i62caroi/SmartCloth/Docs/Diseno-SmartCloth/Database/Personal/servidor_(html-php)/index.html

Welcome to the home of smartcloth.site

Datos ESP32 NEW



Date Created: Fri Oct 13 14:15:12 2023
