i62caroi/SmartCloth/Docs/Diseno-SmartCloth/Database/Diseño database/SmartCloth-BD.pdf

## SmartCloth

- ALIMENTO es un par peso + TIPOALIMENTO
- PLATO es la agregación de 1 o varios ALIMENTO antes de pulsar Añadir Plato (desde Inicio o desde el anterior Añadir Plato).
- COMIDA es la agregación de 1 o varios PLATO antes de pulsar Grabar (desde Inicio o desde el anterior Grabar).
- Cada ALIMENTO pertenecerá a un TIPOALIMENTO
- Cada TIPOALIMENTO tendrá unos VALORESNUTRICIONALES
- Cada TIPOALIMENTO podrá ser: un GRUPOALIMENTO o BARCODE
- Cada USUARIO tiene un MANTEL durante un periodo de tiempo y un MANTEL solo es de un USUARIO durante un periodo de tiempo.
- Los USUARIO pueden tener MEDICION en fecha y hora que podrá ser INSULINA o INDICEGLUCÉMICO.
