i62caroi/SmartCloth/Docs/Diseno-SmartCloth/Diagramas software/Diagrama sincronizacion inicial de data/due-esp32-1_Upload_JSON_per_meal.jpg

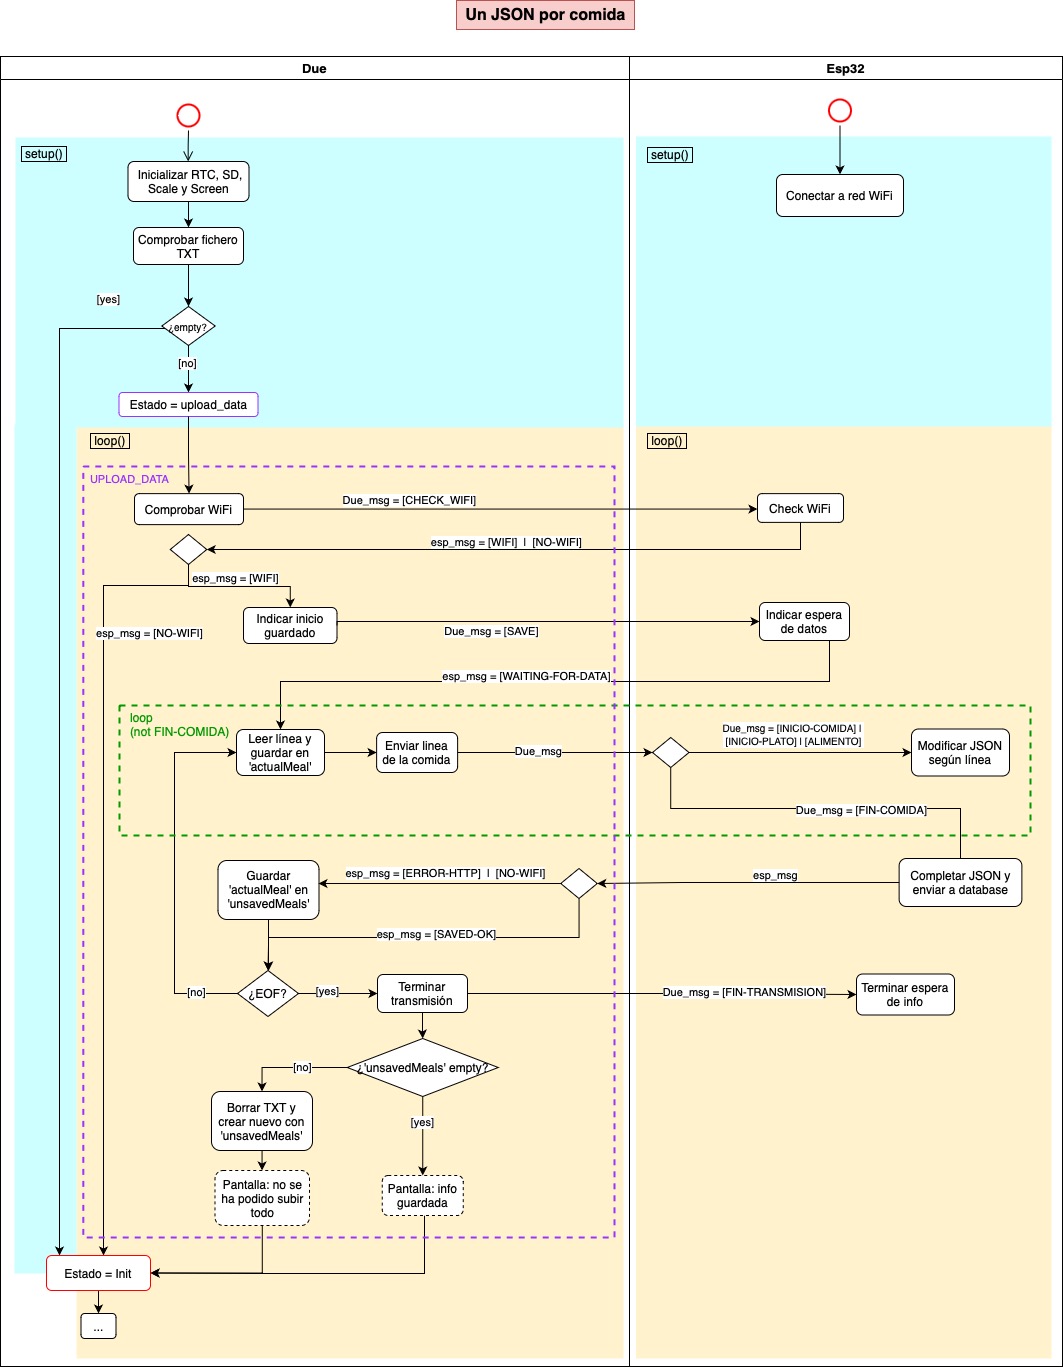
Docs/Diseno-SmartCloth/Diagramas software/Diagrama sincronizacion inicial de data/due-esp32-1_Upload_JSON_per_meal.jpg
