i62caroi/SmartCloth/Docs/Diseno-SmartCloth/Diagramas software/Diagrama sincronizacion inicial de data/due-esp32-Upload_All_in_one_JSON.jpg

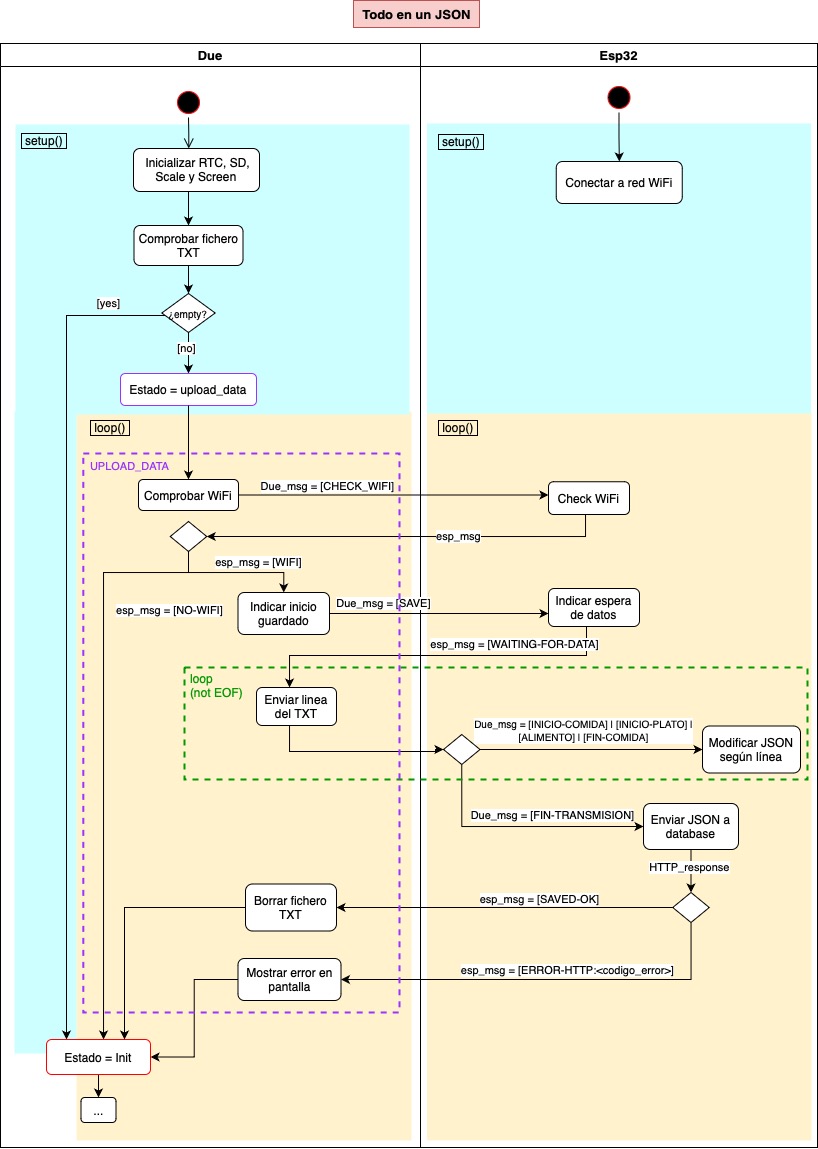
Docs/Diseno-SmartCloth/Diagramas software/Diagrama sincronizacion inicial de data/due-esp32-Upload_All_in_one_JSON.jpg
