i62caroi/SmartCloth/Docs/Diseno-SmartCloth/Diagramas software/UML/Casos-de-Uso.jpg

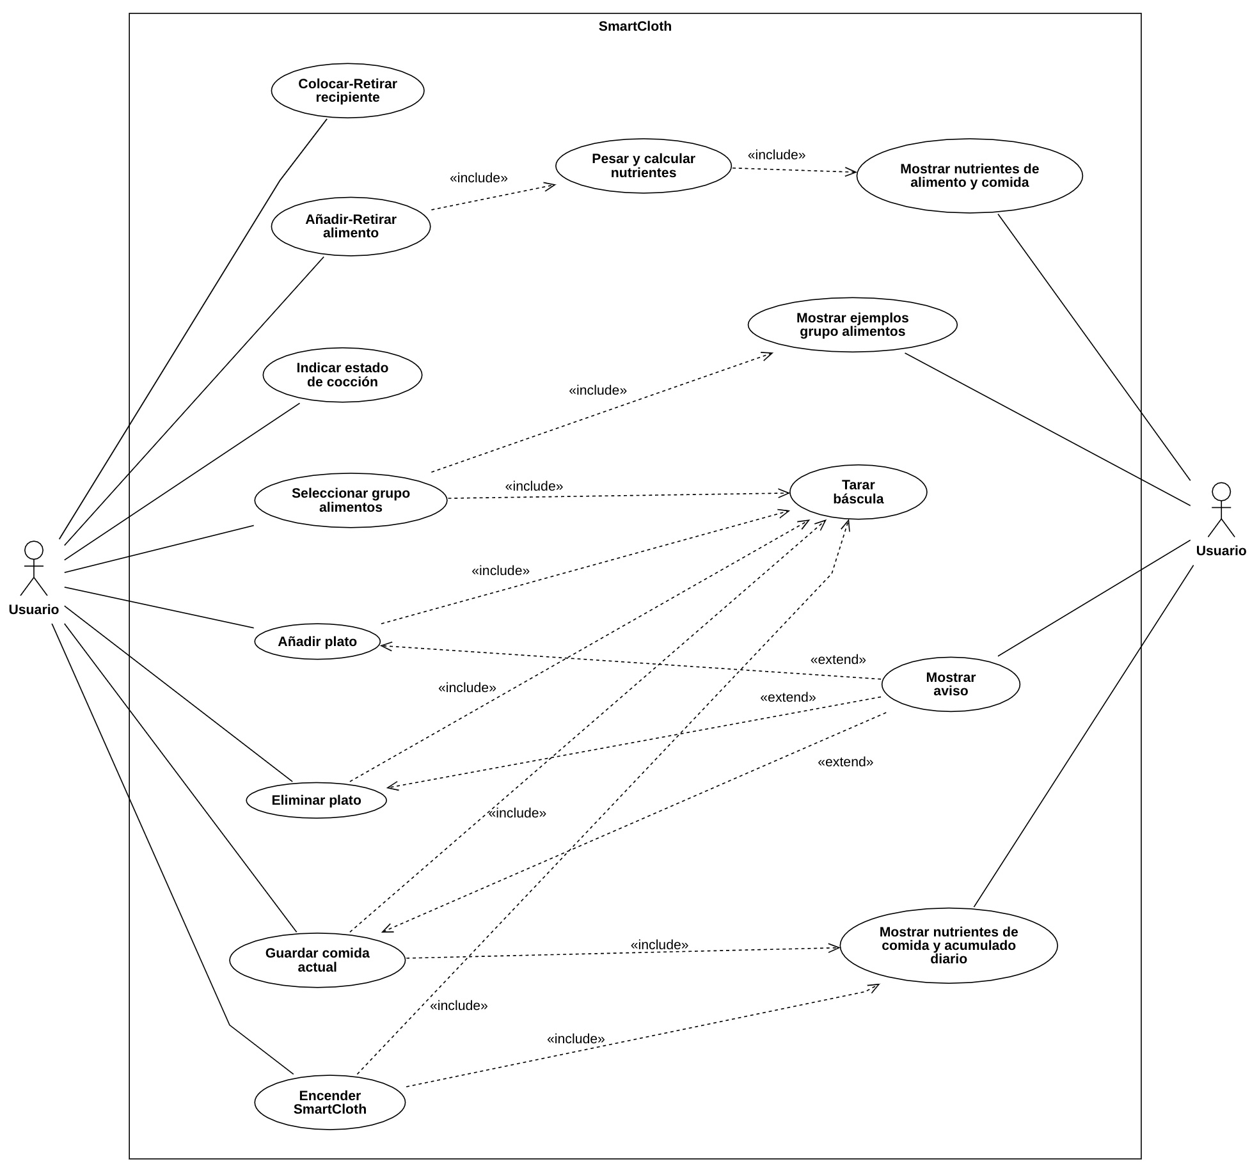
Docs/Diseno-SmartCloth/Diagramas software/UML/Casos-de-Uso.jpg
