i62caroi/SmartCloth/Docs/Diseno-SmartCloth/Diagramas software/UML/Diagrama-Actividades.jpg

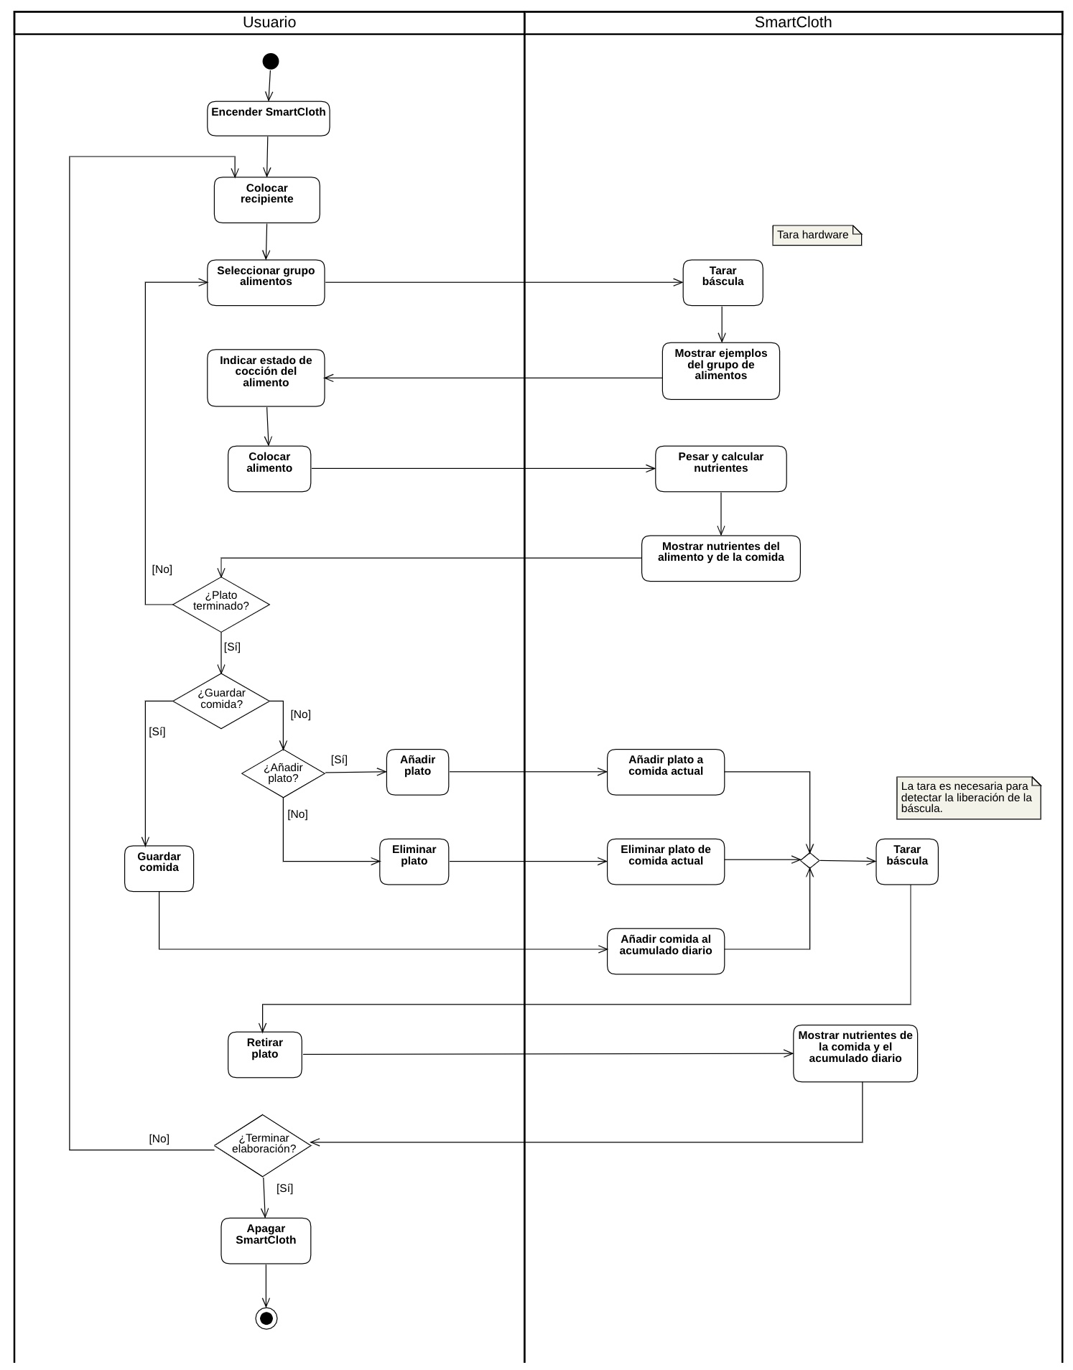
Docs/Diseno-SmartCloth/Diagramas software/UML/Diagrama-Actividades.jpg
