i62caroi/SmartCloth/Docs/Diseno-SmartCloth/Diagramas software/UML/Diagrama-Clases.jpg

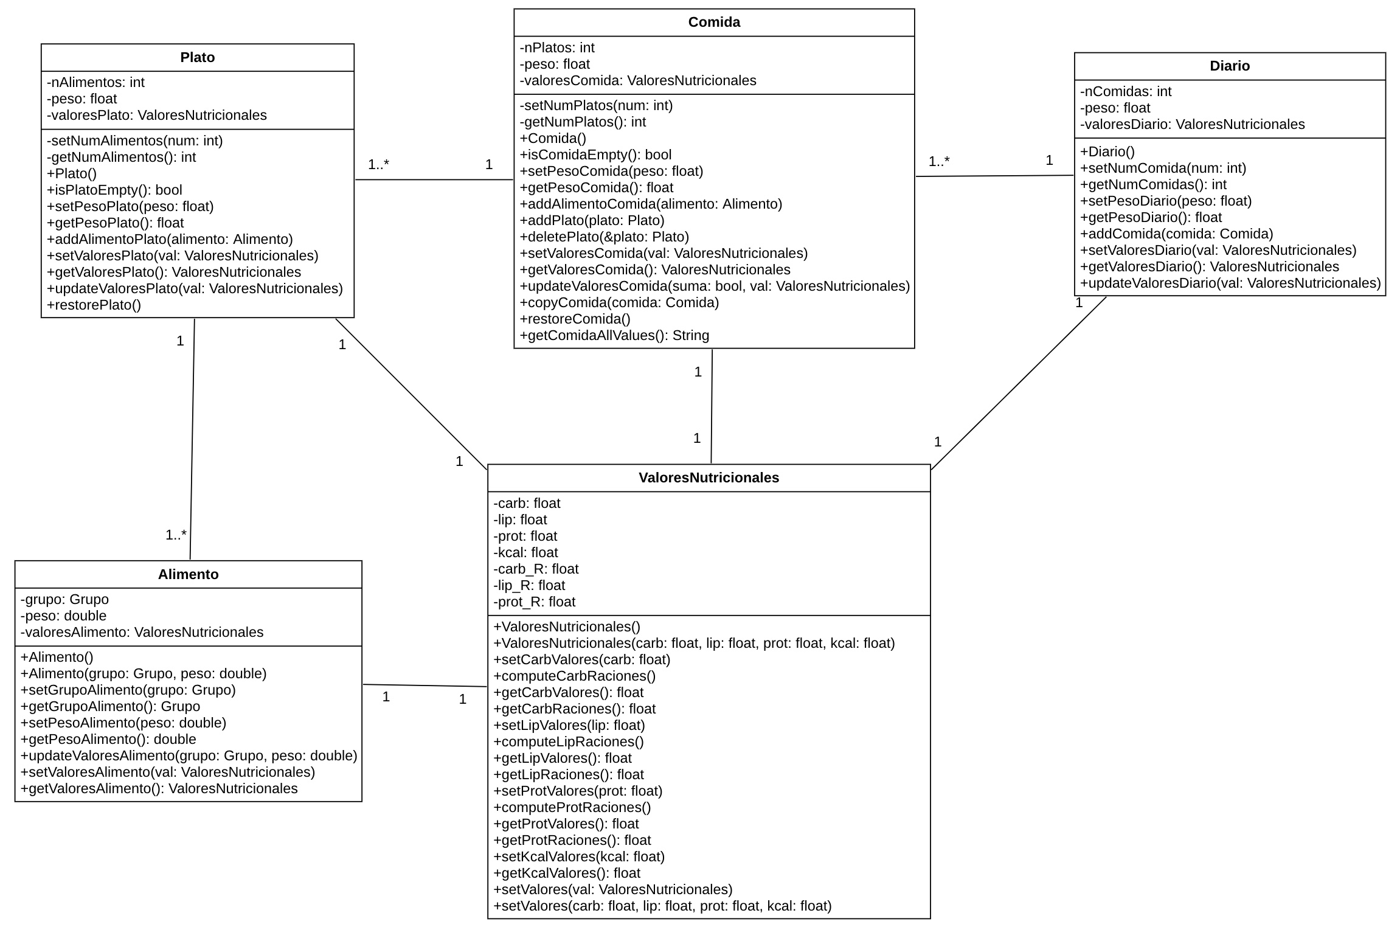
Docs/Diseno-SmartCloth/Diagramas software/UML/Diagrama-Clases.jpg
