i62caroi/SmartCloth/Docs/Diseno-SmartCloth/Diagramas software/UML/Diagrama-Flujo-SmartCloth.jpg

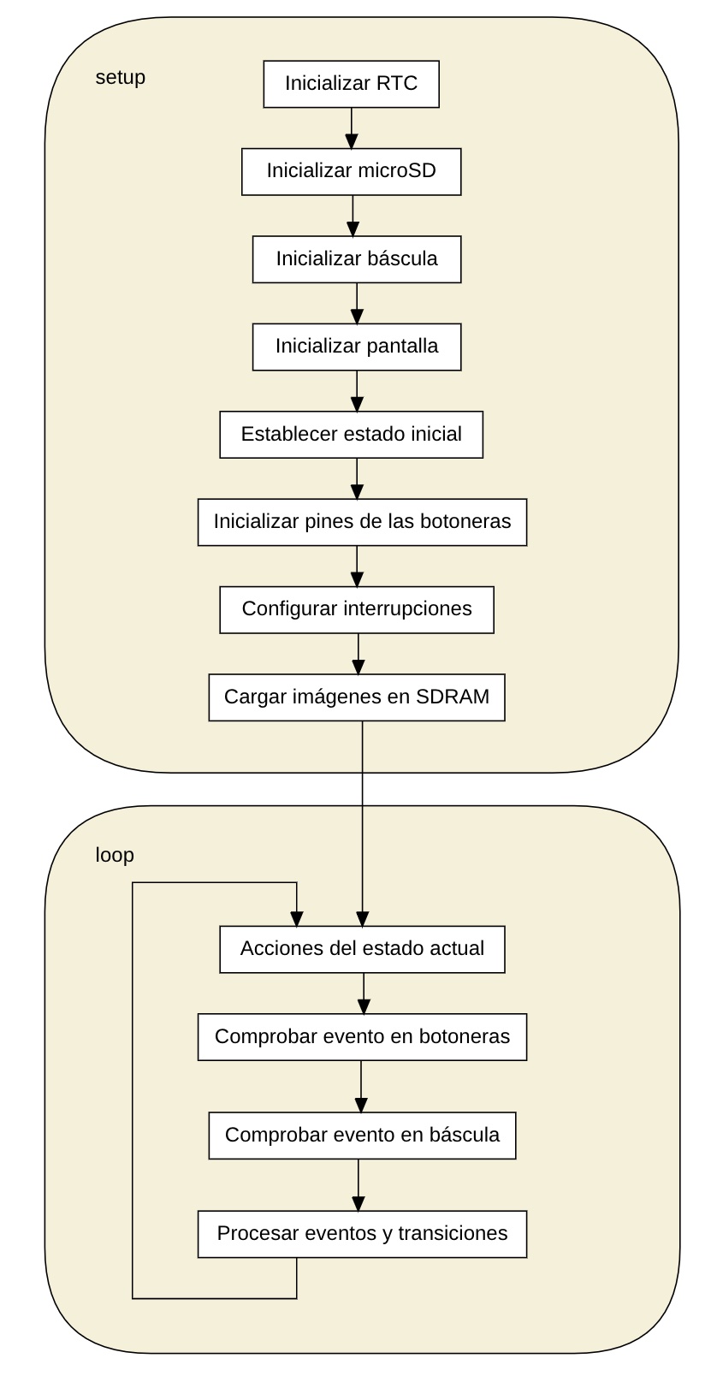
Docs/Diseno-SmartCloth/Diagramas software/UML/Diagrama-Flujo-SmartCloth.jpg
