i62caroi/SmartCloth/Docs/Diseno-SmartCloth/Diagramas software/UML/Máquina de Estados/Diagrama 1.jpg

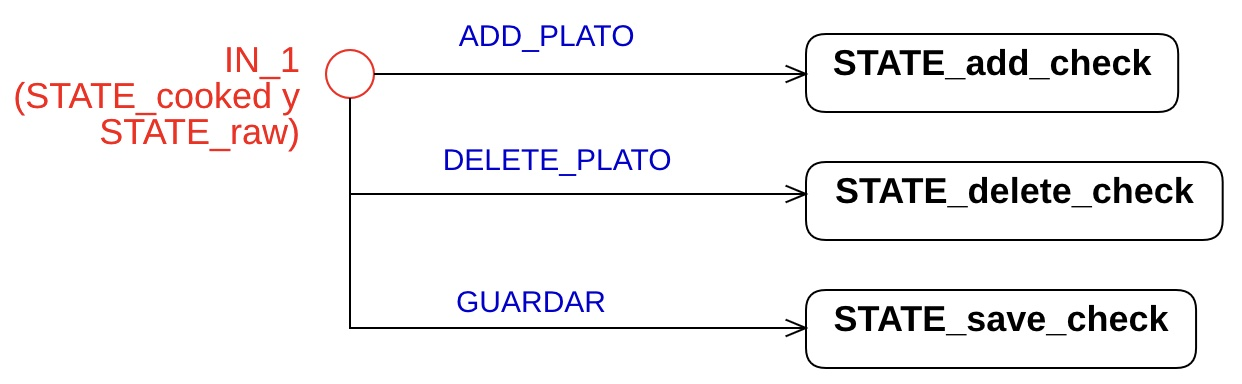
Docs/Diseno-SmartCloth/Diagramas software/UML/Máquina de Estados/Diagrama 1.jpg
