i62caroi/SmartCloth/Docs/Diseno-SmartCloth/Hardware/Diagrama_de_comunicaciones_v2.png

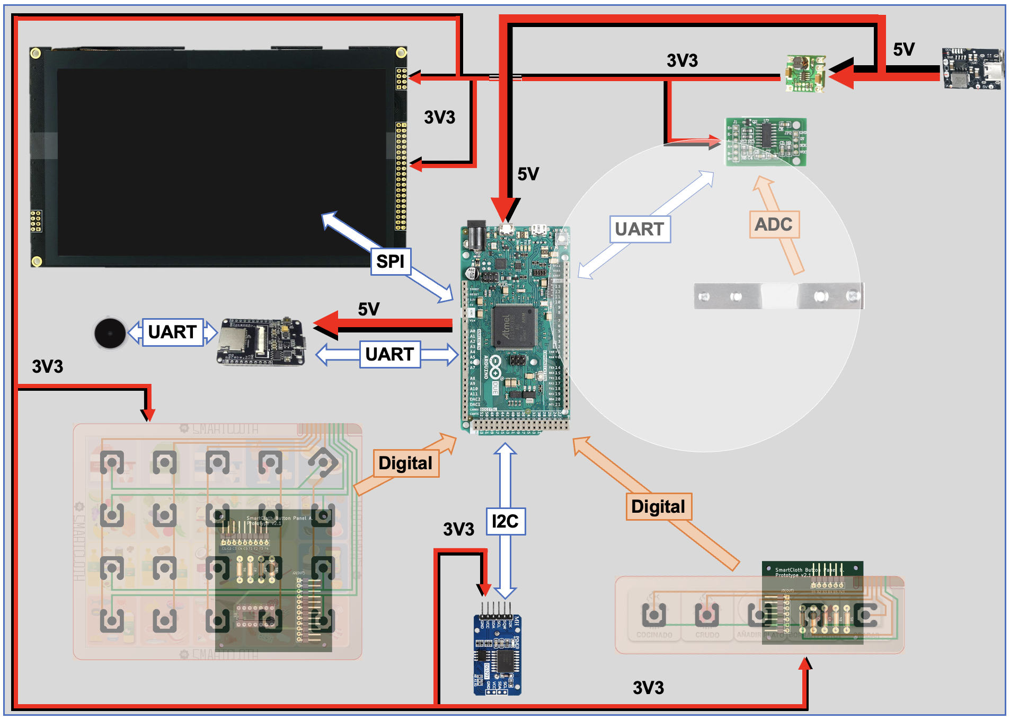
Docs/Diseno-SmartCloth/Hardware/Diagrama_de_comunicaciones_v2.png
