i62caroi/SmartCloth/Docs/Diseno-SmartCloth/Interfaz/Dashboards/Dashboard1.png

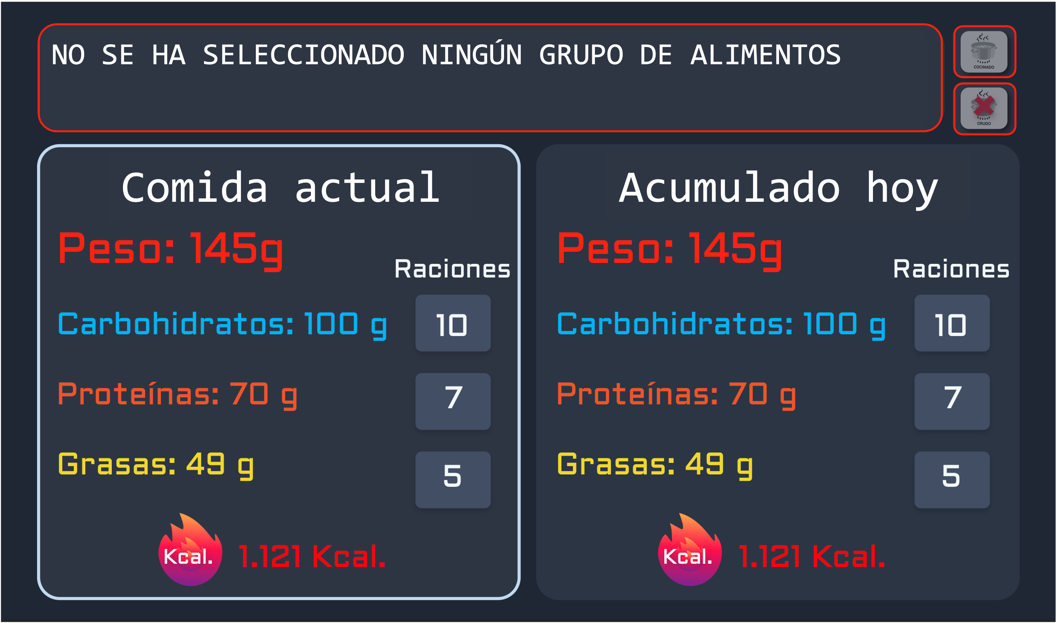
Docs/Diseno-SmartCloth/Interfaz/Dashboards/Dashboard1.png
