i62caroi/SmartCloth/Docs/Diseno-SmartCloth/Interfaz/Dashboards/Zonas(2).png

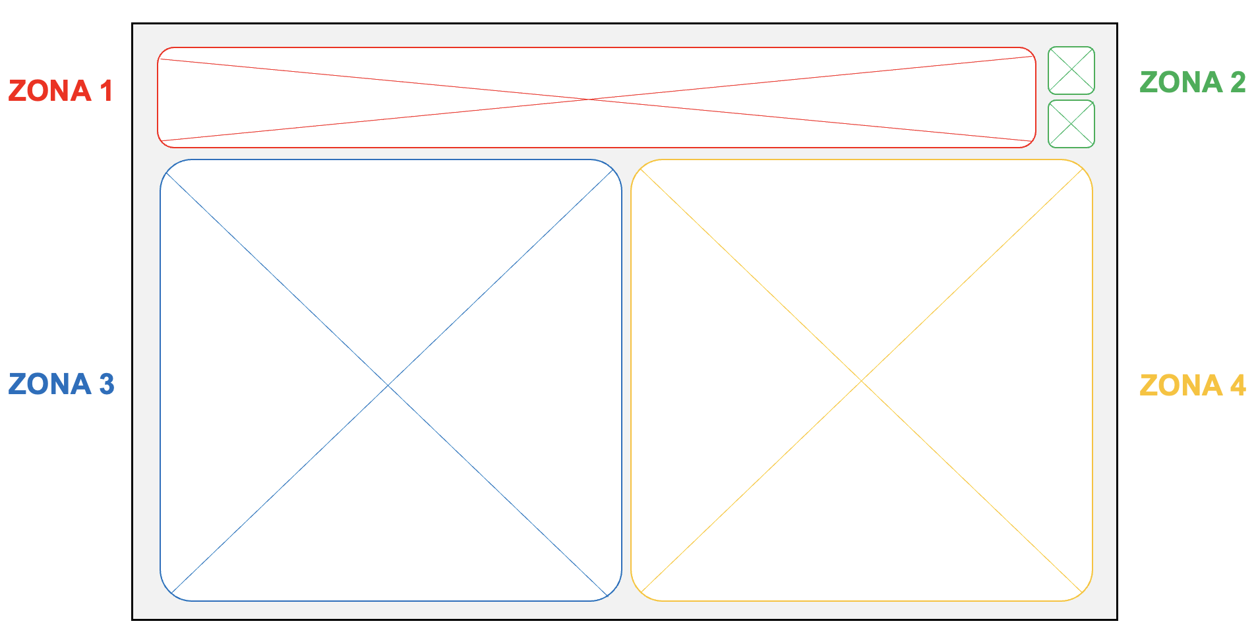
Docs/Diseno-SmartCloth/Interfaz/Dashboards/Zonas(2).png
