i62caroi/SmartCloth/Docs/Diseno-SmartCloth/Interfaz/Pantallas-auxiliares/accion-cancelada.jpg

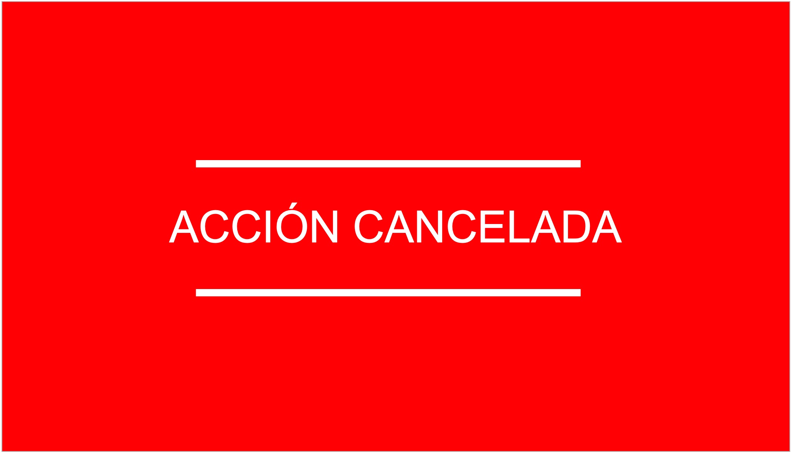
Docs/Diseno-SmartCloth/Interfaz/Pantallas-auxiliares/accion-cancelada.jpg
