i62caroi/SmartCloth/Docs/Diseno-SmartCloth/Interfaz/Pantallas-auxiliares/arranque.jpg

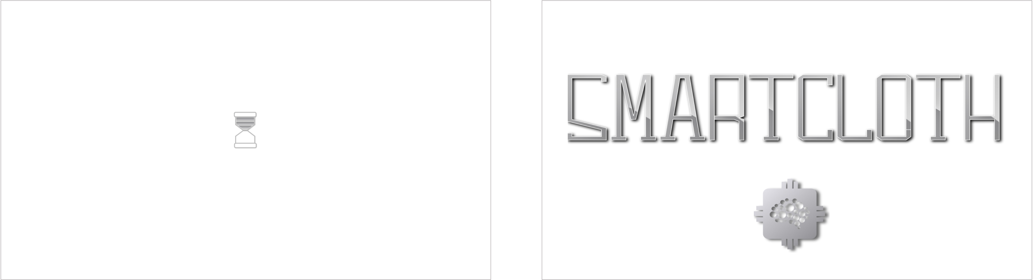
Docs/Diseno-SmartCloth/Interfaz/Pantallas-auxiliares/arranque.jpg
