i62caroi/SmartCloth/Docs/Diseno-SmartCloth/Interfaz/Pantallas-auxiliares/aviso-comida-vacia.jpg

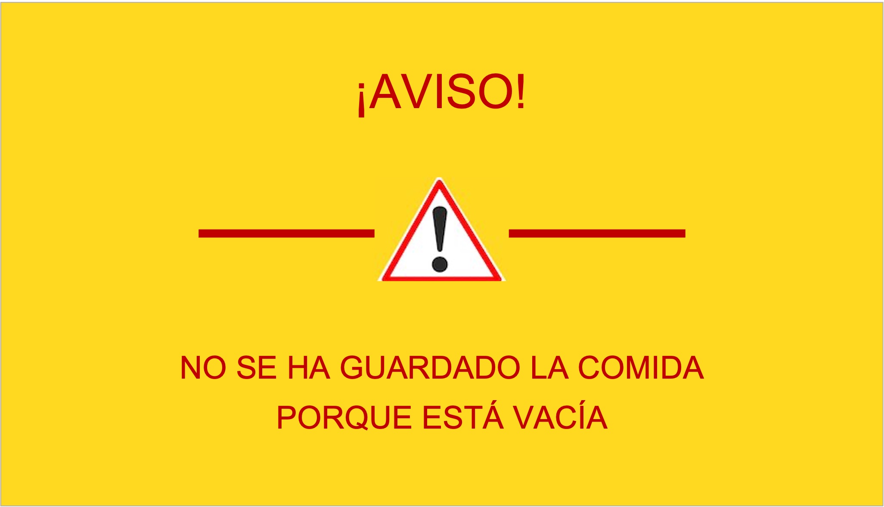
Docs/Diseno-SmartCloth/Interfaz/Pantallas-auxiliares/aviso-comida-vacia.jpg
