i62caroi/SmartCloth/Docs/Diseno-SmartCloth/Interfaz/Pantallas-auxiliares/comida-guardada-retire-plato.jpg

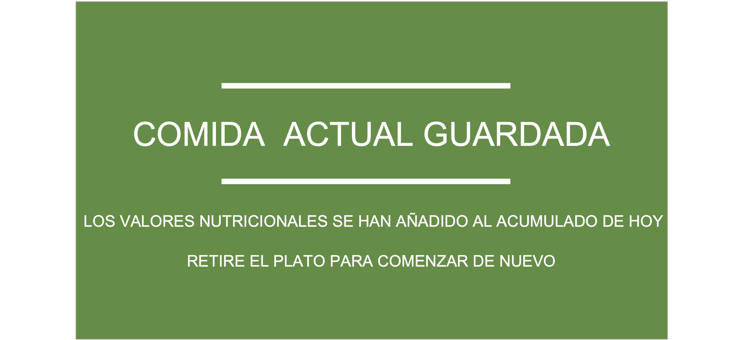
Docs/Diseno-SmartCloth/Interfaz/Pantallas-auxiliares/comida-guardada-retire-plato.jpg
