i62caroi/SmartCloth/Docs/Diseno-SmartCloth/Interfaz/Pantallas-auxiliares/comida-guardada.jpg

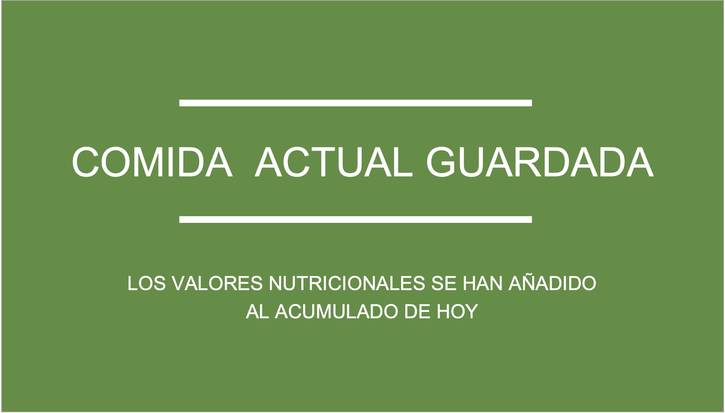
Docs/Diseno-SmartCloth/Interfaz/Pantallas-auxiliares/comida-guardada.jpg
