i62caroi/SmartCloth/Docs/Diseno-SmartCloth/Interfaz/Pantallas-auxiliares/confirmacion-anadir.jpg

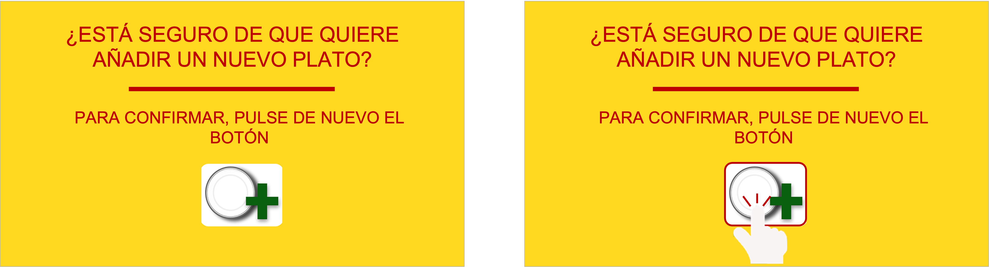
Docs/Diseno-SmartCloth/Interfaz/Pantallas-auxiliares/confirmacion-anadir.jpg
