i62caroi/SmartCloth/Docs/Diseno-SmartCloth/Interfaz/Pantallas-auxiliares/confirmacion-guardar.jpg

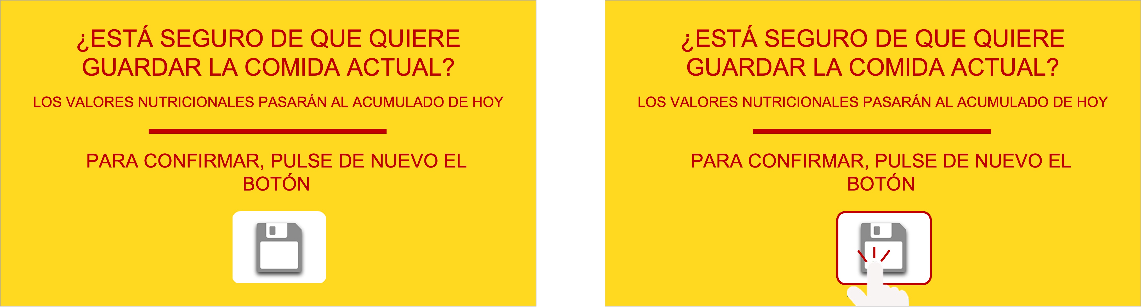
Docs/Diseno-SmartCloth/Interfaz/Pantallas-auxiliares/confirmacion-guardar.jpg
