i62caroi/SmartCloth/Docs/Diseno-SmartCloth/Interfaz/Pantallas-auxiliares/crudo-cocinado-sobre-dashboard.png

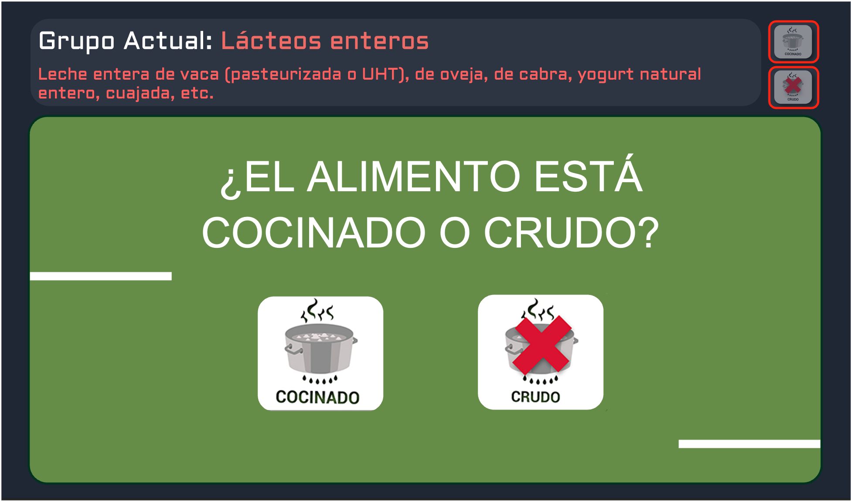
Docs/Diseno-SmartCloth/Interfaz/Pantallas-auxiliares/crudo-cocinado-sobre-dashboard.png
