i62caroi/SmartCloth/Docs/Diseno-SmartCloth/Interfaz/Pantallas-auxiliares/error-escoja-grupo.jpg

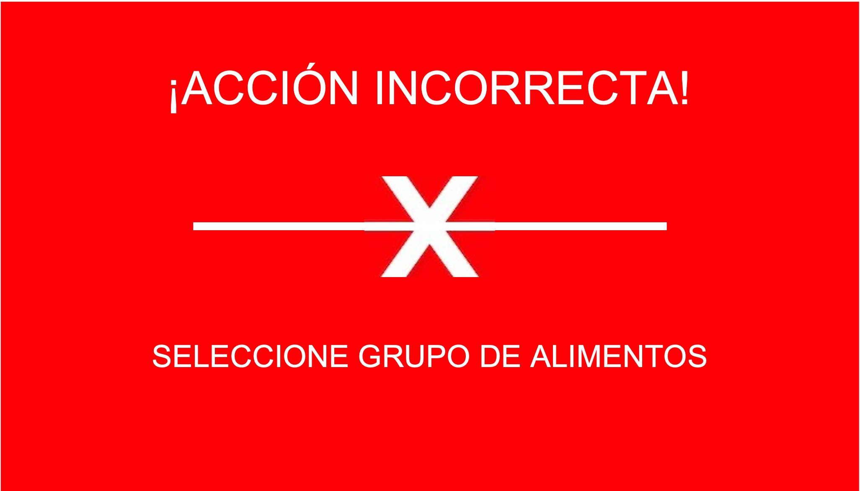
Docs/Diseno-SmartCloth/Interfaz/Pantallas-auxiliares/error-escoja-grupo.jpg
