i62caroi/SmartCloth/Docs/Diseno-SmartCloth/Interfaz/Pantallas-auxiliares/pedir-alimento.jpg

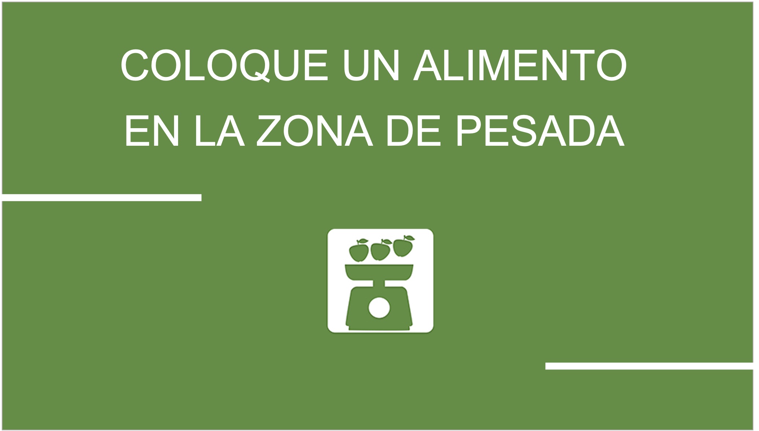
Docs/Diseno-SmartCloth/Interfaz/Pantallas-auxiliares/pedir-alimento.jpg
