i62caroi/SmartCloth/Docs/Diseno-SmartCloth/Interfaz/Pantallas-auxiliares/pedir-crudo-cocinado.jpg

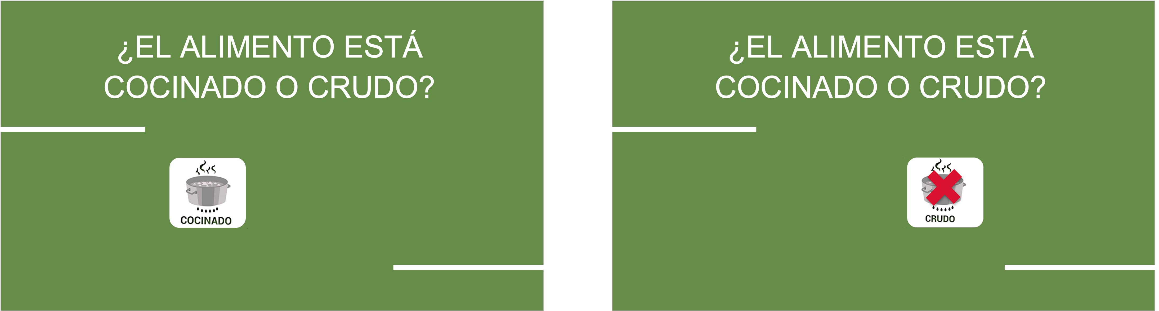
Docs/Diseno-SmartCloth/Interfaz/Pantallas-auxiliares/pedir-crudo-cocinado.jpg
