i62caroi/SmartCloth/Docs/Diseno-SmartCloth/Interfaz/Pantallas-auxiliares/pedir-grupo.jpg

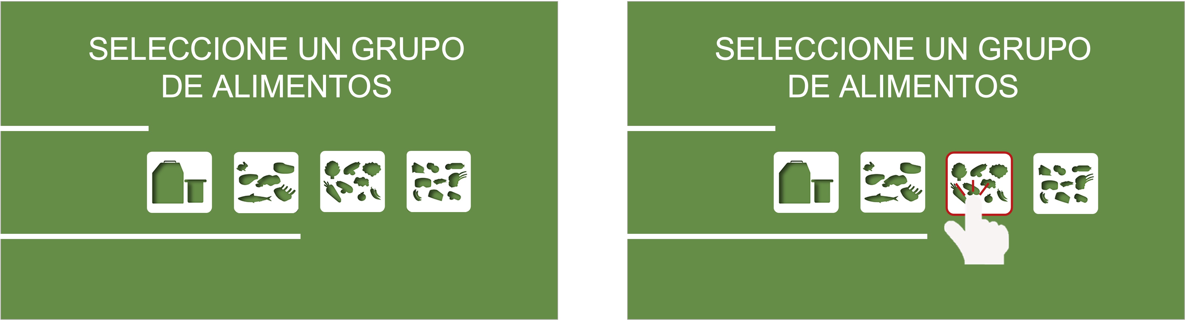
Docs/Diseno-SmartCloth/Interfaz/Pantallas-auxiliares/pedir-grupo.jpg
