i62caroi/SmartCloth/Docs/Diseno-SmartCloth/Interfaz/Pantallas-auxiliares/pedir-recipiente.jpg

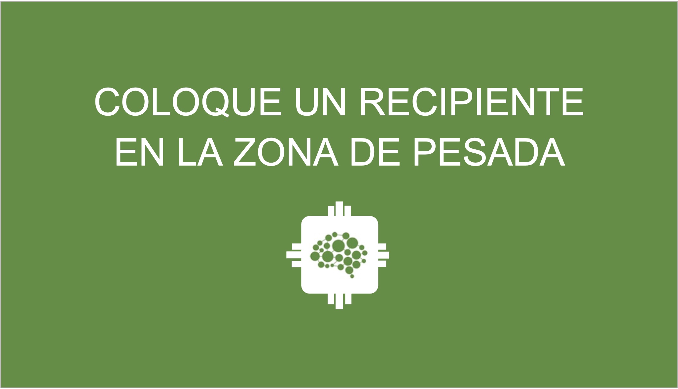
Docs/Diseno-SmartCloth/Interfaz/Pantallas-auxiliares/pedir-recipiente.jpg
