i62caroi/SmartCloth/Docs/Diseno-SmartCloth/Interfaz/Pantallas-auxiliares/plato-anadido.jpg

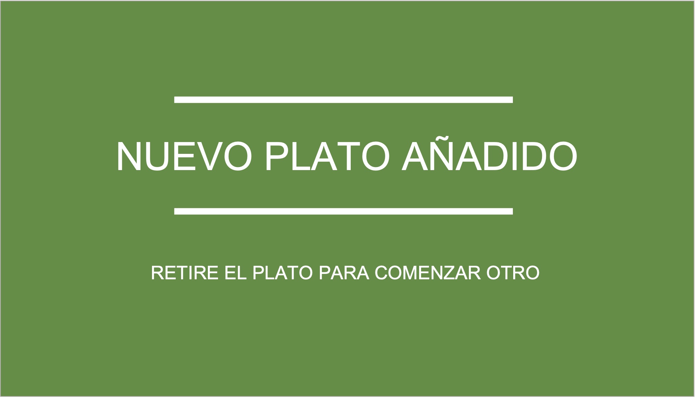
Docs/Diseno-SmartCloth/Interfaz/Pantallas-auxiliares/plato-anadido.jpg
