i62caroi/SmartCloth/Docs/Diseno-SmartCloth/Interfaz/Pantallas-auxiliares/plato-eliminado.jpg

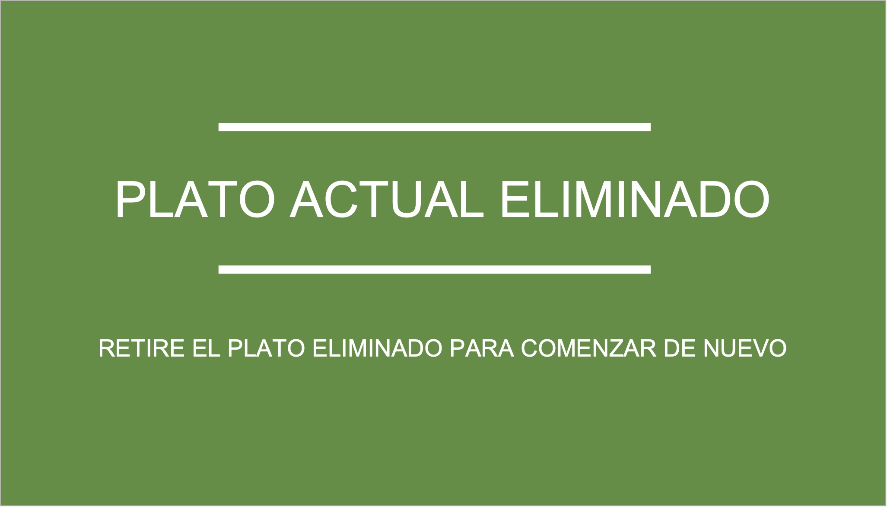
Docs/Diseno-SmartCloth/Interfaz/Pantallas-auxiliares/plato-eliminado.jpg
