i62caroi/SmartCloth/Docs/Diseno-SmartCloth/Interfaz/Pantallas-auxiliares/recipiente-colocado-retirado.jpg

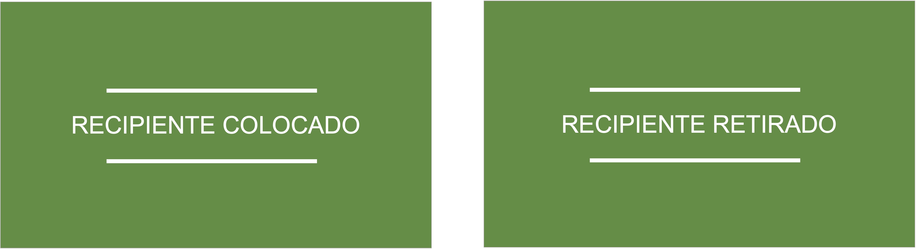
Docs/Diseno-SmartCloth/Interfaz/Pantallas-auxiliares/recipiente-colocado-retirado.jpg
