i62caroi/SmartCloth/Docs/Diseno-SmartCloth/Interfaz/Pantallas-auxiliares/sugerencias-accion.jpg

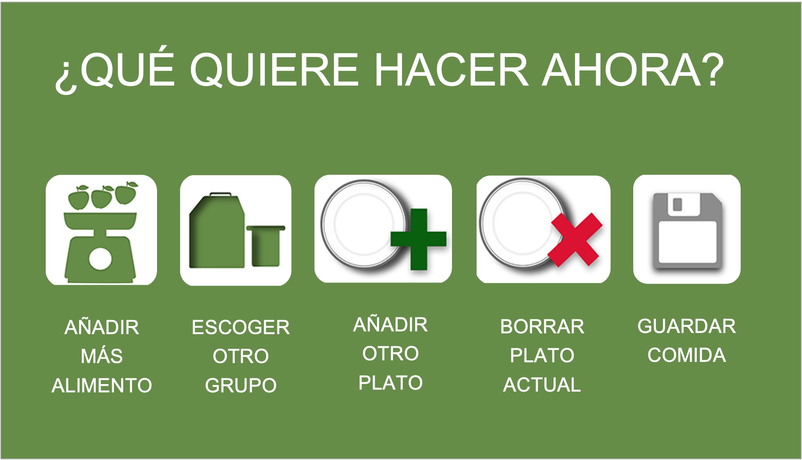
Docs/Diseno-SmartCloth/Interfaz/Pantallas-auxiliares/sugerencias-accion.jpg
