i62caroi/SmartCloth/Docs/Fallos/Comunicacion-Due-ESP32 (Resuelto)/mensaje-perdido.png

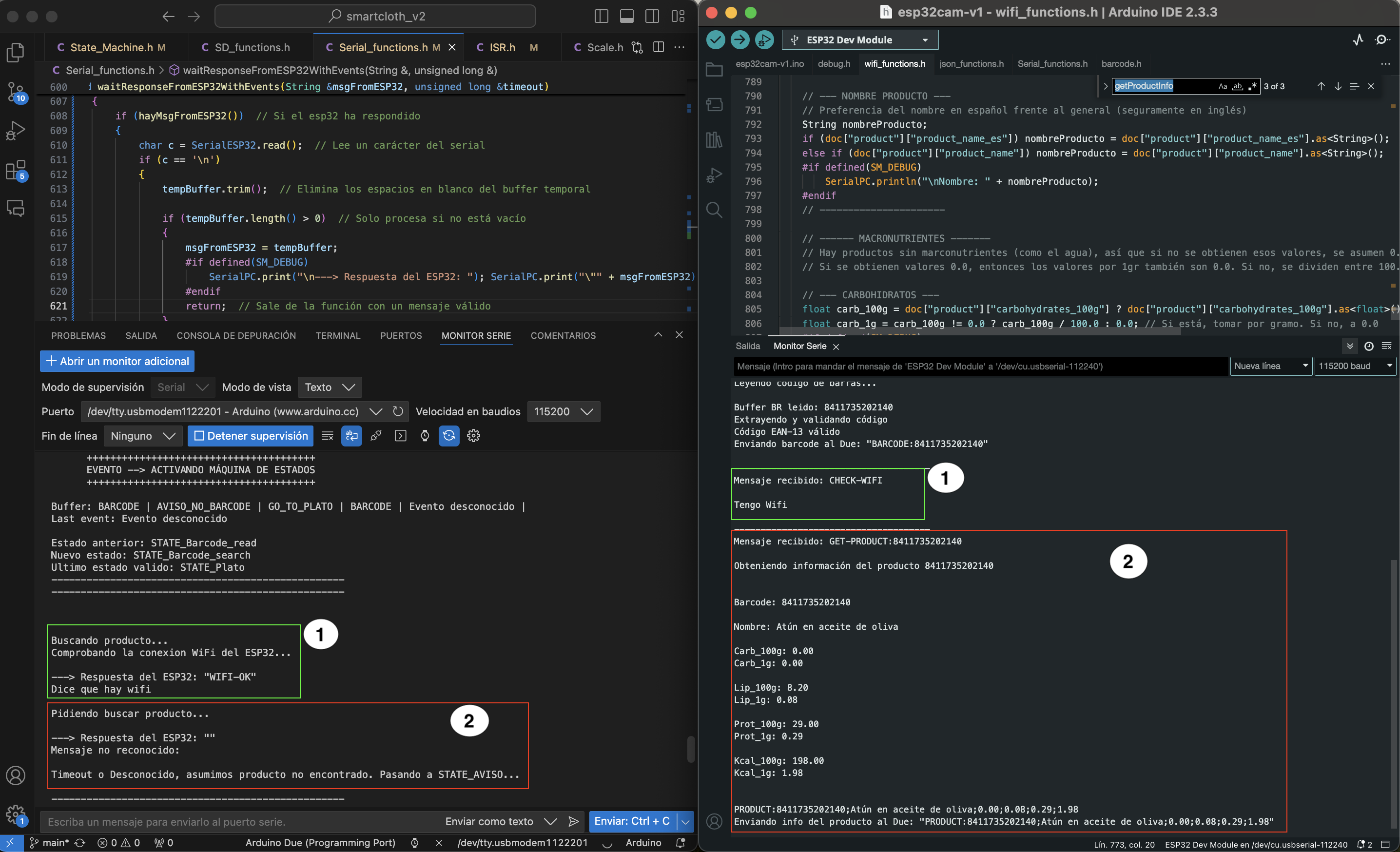
Docs/Fallos/Comunicacion-Due-ESP32 (Resuelto)/mensaje-perdido.png
