i62caroi/SmartCloth/Docs/Fallos/Comunicacion-Due-ESP32 (Resuelto)/mensaje-recibido.png

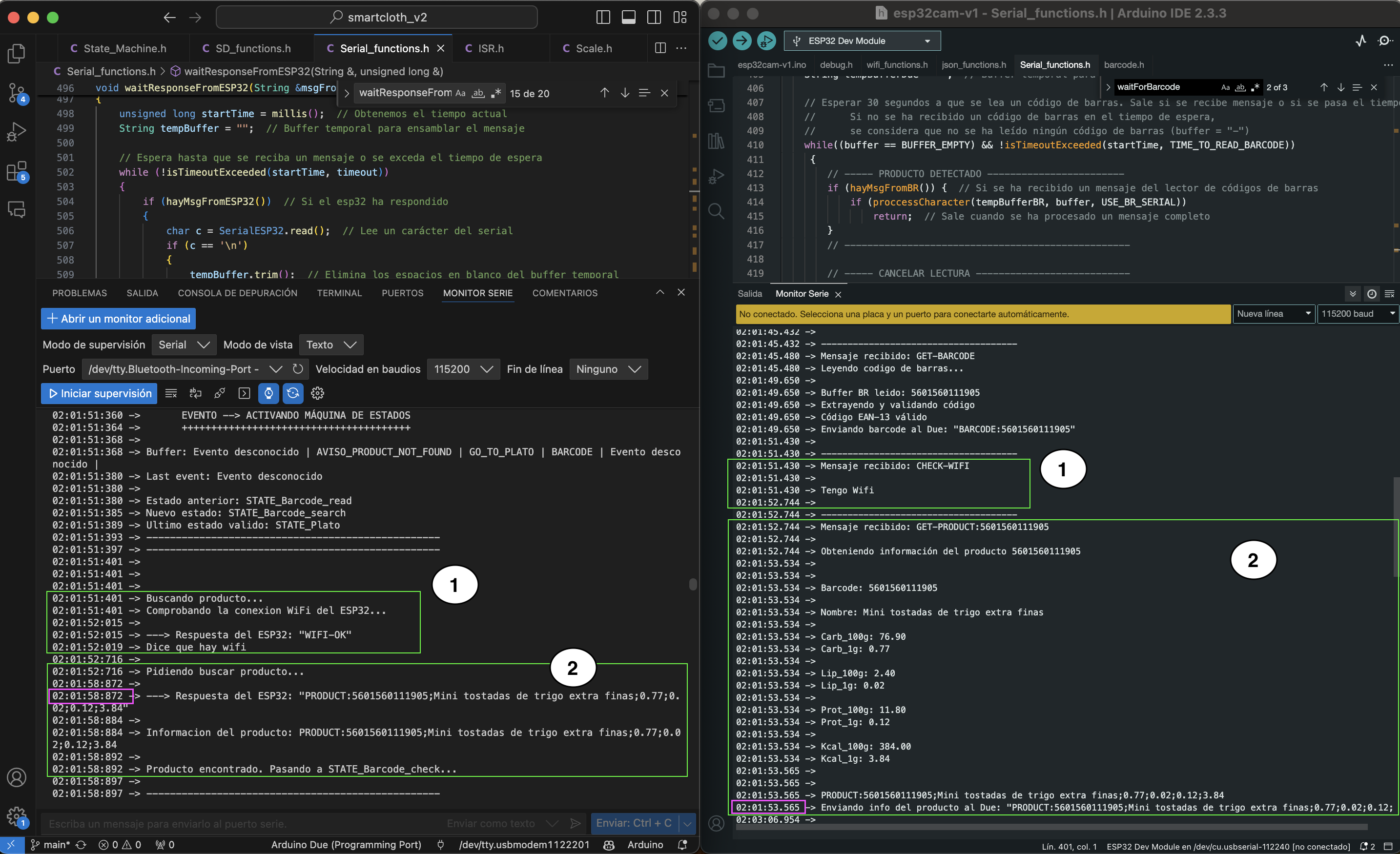
Docs/Fallos/Comunicacion-Due-ESP32 (Resuelto)/mensaje-recibido.png
