i62caroi/SmartCloth/examples/DATABASE/send_JSON_via_API (inicial)/campos-tablas-database.png

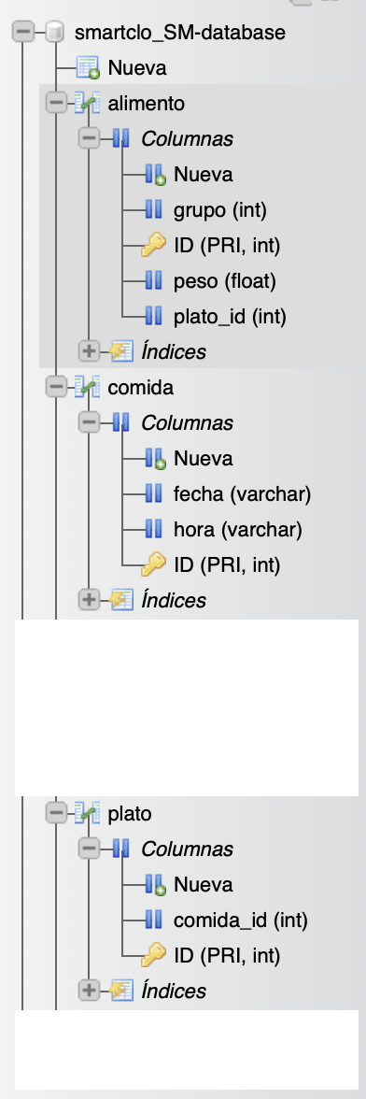
examples/DATABASE/send_JSON_via_API (inicial)/campos-tablas-database.png
