i62caroi/SmartCloth/examples/ESP32 CAM/STREAMING SERVER AND PYTHON ACCESS/frame-autofocus.jpg

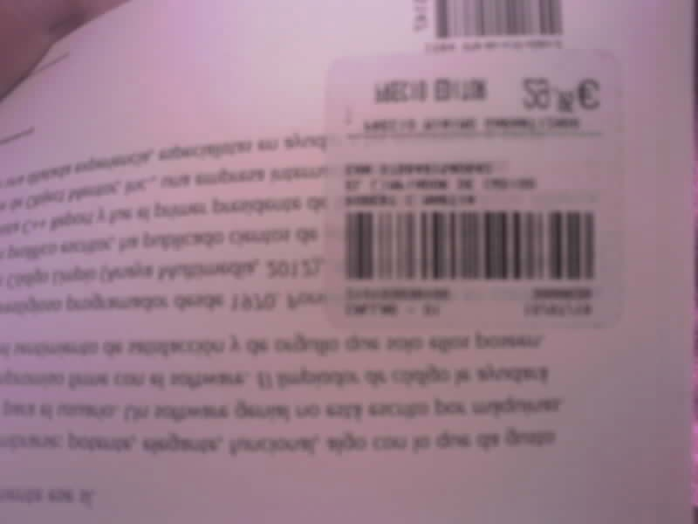
examples/ESP32 CAM/STREAMING SERVER AND PYTHON ACCESS/frame-autofocus.jpg
