i62caroi/SmartCloth/examples/ESP32 CAM/STREAMING SERVER AND PYTHON ACCESS/frame.jpg

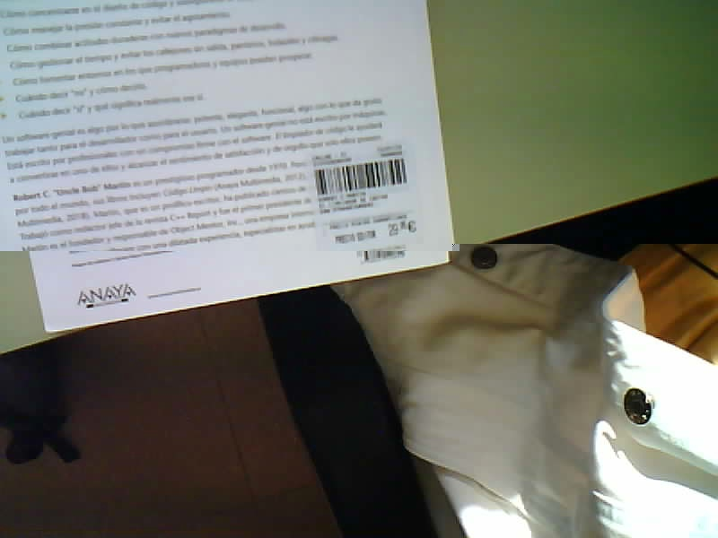
examples/ESP32 CAM/STREAMING SERVER AND PYTHON ACCESS/frame.jpg
