i62caroi/SmartCloth/examples/SCREEN/RA8876_v2_opacity/Captura de Pantalla 2023-06-09 a las 10.19.07.png

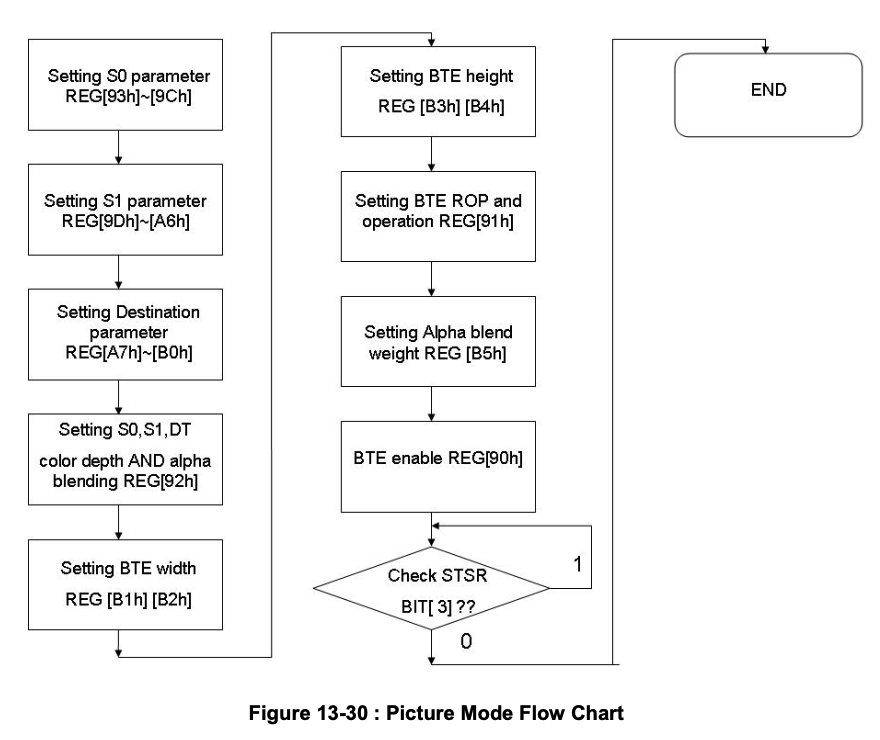
examples/SCREEN/RA8876_v2_opacity/Captura de Pantalla 2023-06-09 a las 10.19.07.png
