i62caroi/SmartCloth/images/jpg/alimento/scale.jpg

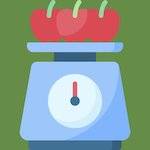
images/jpg/alimento/scale.jpg
