i62caroi/SmartCloth/images/jpg/alimento/scale_g.jpg

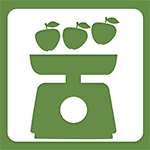
images/jpg/alimento/scale_g.jpg
