i62caroi/SmartCloth/images/jpg/arranque/Log.jpg

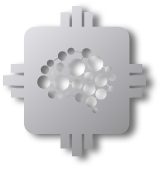
images/jpg/arranque/Log.jpg
