i62caroi/SmartCloth/images/jpg/aviso/aviso.jpg

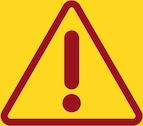
images/jpg/aviso/aviso.jpg
