i62caroi/SmartCloth/images/jpg/barcode/scan.jpg

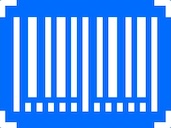
images/jpg/barcode/scan.jpg
