i62caroi/SmartCloth/images/jpg/botones/anadir.jpg

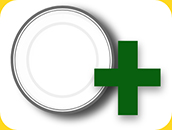
images/jpg/botones/anadir.jpg
