i62caroi/SmartCloth/images/jpg/botones/borrar.jpg

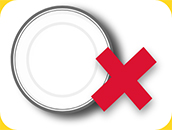
images/jpg/botones/borrar.jpg
