i62caroi/SmartCloth/images/jpg/botones/coci_gra.jpg

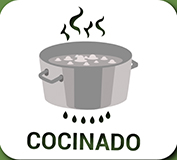
images/jpg/botones/coci_gra.jpg
