i62caroi/SmartCloth/images/jpg/botones/crudo_gra.jpg

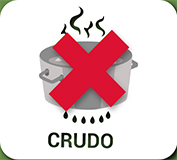
images/jpg/botones/crudo_gra.jpg
