i62caroi/SmartCloth/images/jpg/botones/guardar.jpg

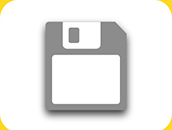
images/jpg/botones/guardar.jpg
