i62caroi/SmartCloth/images/jpg/grupo/grupo1.jpg

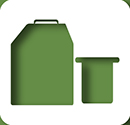
images/jpg/grupo/grupo1.jpg
