i62caroi/SmartCloth/images/jpg/grupo/grupo2.jpg

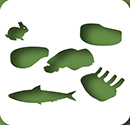
images/jpg/grupo/grupo2.jpg
