i62caroi/SmartCloth/images/jpg/grupo/grupo3.jpg

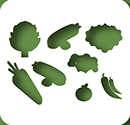
images/jpg/grupo/grupo3.jpg
