i62caroi/SmartCloth/images/jpg/grupo/grupo4.jpg

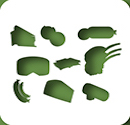
images/jpg/grupo/grupo4.jpg
