i62caroi/SmartCloth/images/jpg/manos/manoGppt.jpg

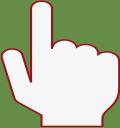
images/jpg/manos/manoGppt.jpg
