i62caroi/SmartCloth/images/jpg/manos/manoWppt.jpg

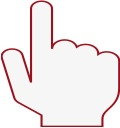
images/jpg/manos/manoWppt.jpg
