i62caroi/SmartCloth/images/jpg/sync/sync.jpg

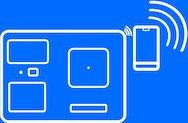
images/jpg/sync/sync.jpg
