i62caroi/SmartCloth/images/jpg/sync/sync_ok.jpg

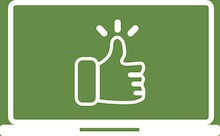
images/jpg/sync/sync_ok.jpg
