i62caroi/SmartCloth/Docs/Diseño-SmartCloth/SmartCloth assembly document V0.2.pdf

# DOCUMENTO DE MONTAJE

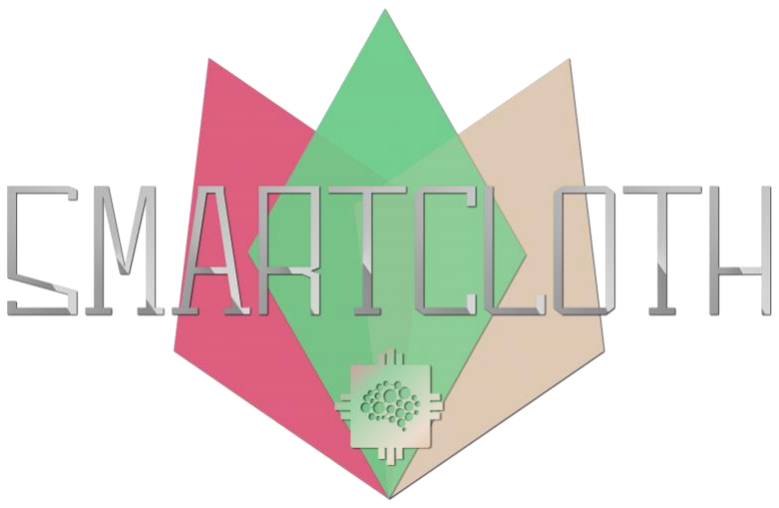
[picture p67: figure]

COMPONENTES PRINCIPALES

Pantalla ER-TFM070-6 | Batería
Tarjeta SD | Interruptor basculante
Arduino Due | Módulo Step-Down
Screw Shield | Botonera A (grupos de alimentos)
RTC | Botonera B (acciones)
Celda de carga | Placas de adaptación de botoneras
Conversor AC/DC HX711 | ESP32-CAM
Módulo USB cargador de batería | Botón código de barras

COMPONENTES AUXILIARES

Cable USB-microUSB | 4 fichas de 5 cables
4 pegatinas con bridas | 5 fichas de 3 cables

## 1. Alimentación:

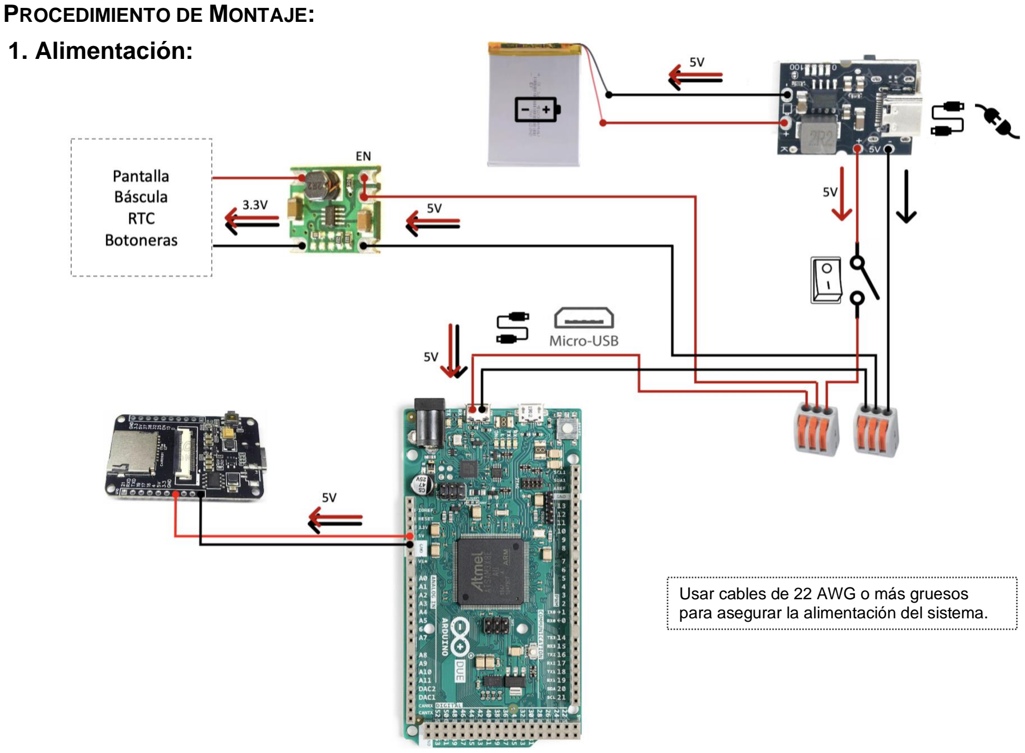
[picture p68: page 3]

PROCEDIMIENTO DE MONTAJE:

Usar cables de 22 AWG o más gruesos para asegurar la alimentación del sistema.

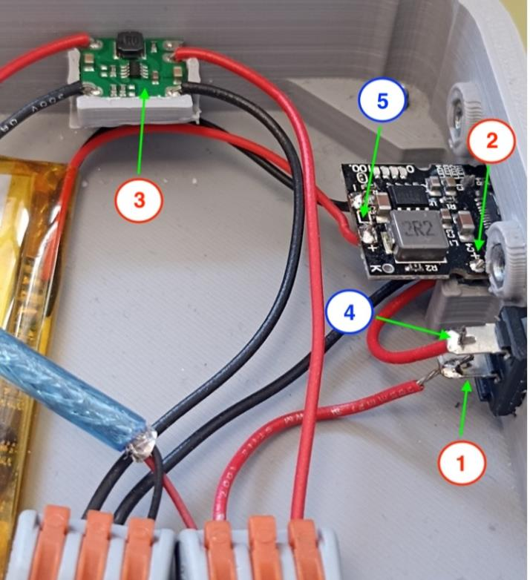
[picture p69: figure]
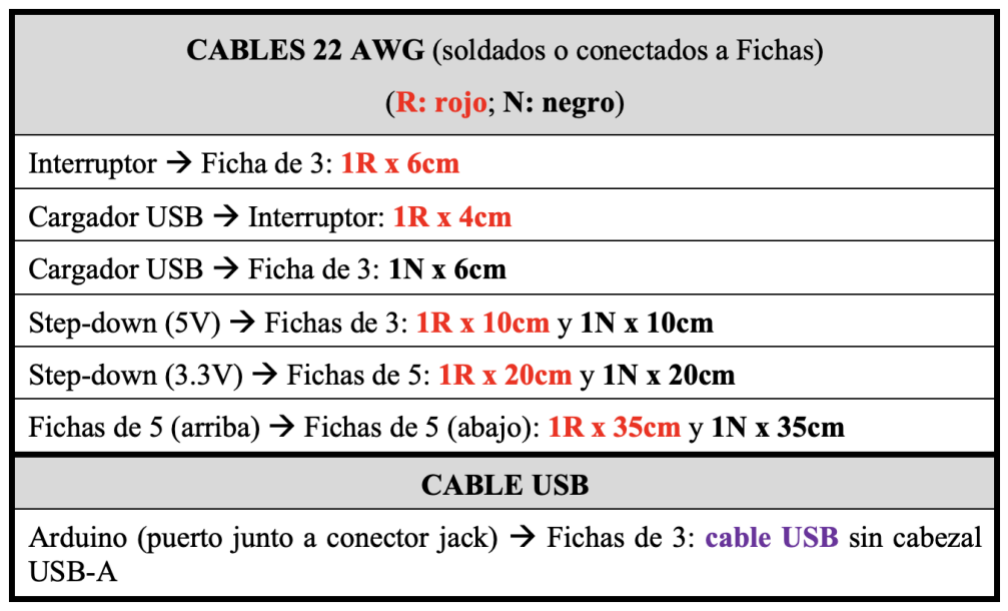
[picture p70: figure]

- Soldar antes de montar:
(1) Cable R del interruptor a la ficha de 3, en el borne del | para que
el O quede arriba y sea más fácil soldar después.
(2) Cables R y N del cargador USB (donde pone 5V) al interruptor
(R) y a la ficha de 3 (N), pero solo soldar el extremo del cargador USB para poderlo colocar desde fuera de la carcasa.
(3) Regulador step-down completo (R-N en entrada de 5V y en salida de 3.3V). Soldar EN con Vi+ en la entrada.
- Soldar después de montar:
(4) Cable R del cargador USB al interruptor, el extremo que va al borne con O del interruptor.
(5) Cables R y N de la batería en el cargador USB (donde el símbolo de batería).

## 2. Conexiones:

## 2.1 Shield de tornillos

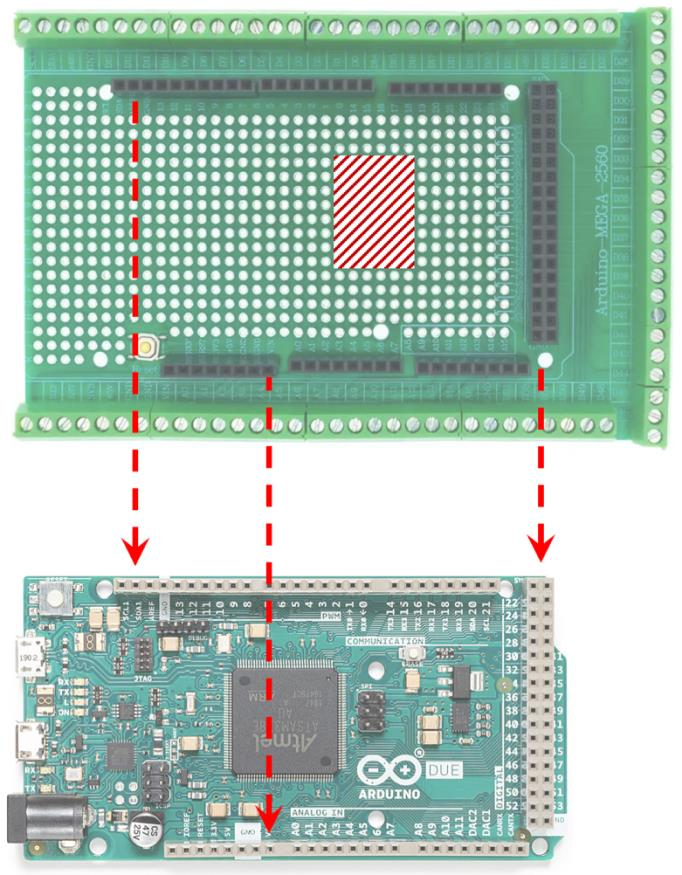
[picture p71: figure]
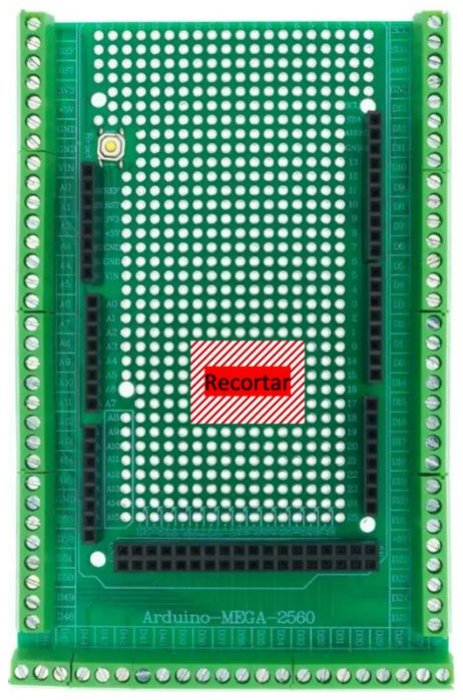
[picture p72: figure]

## 2.2 Pantalla:

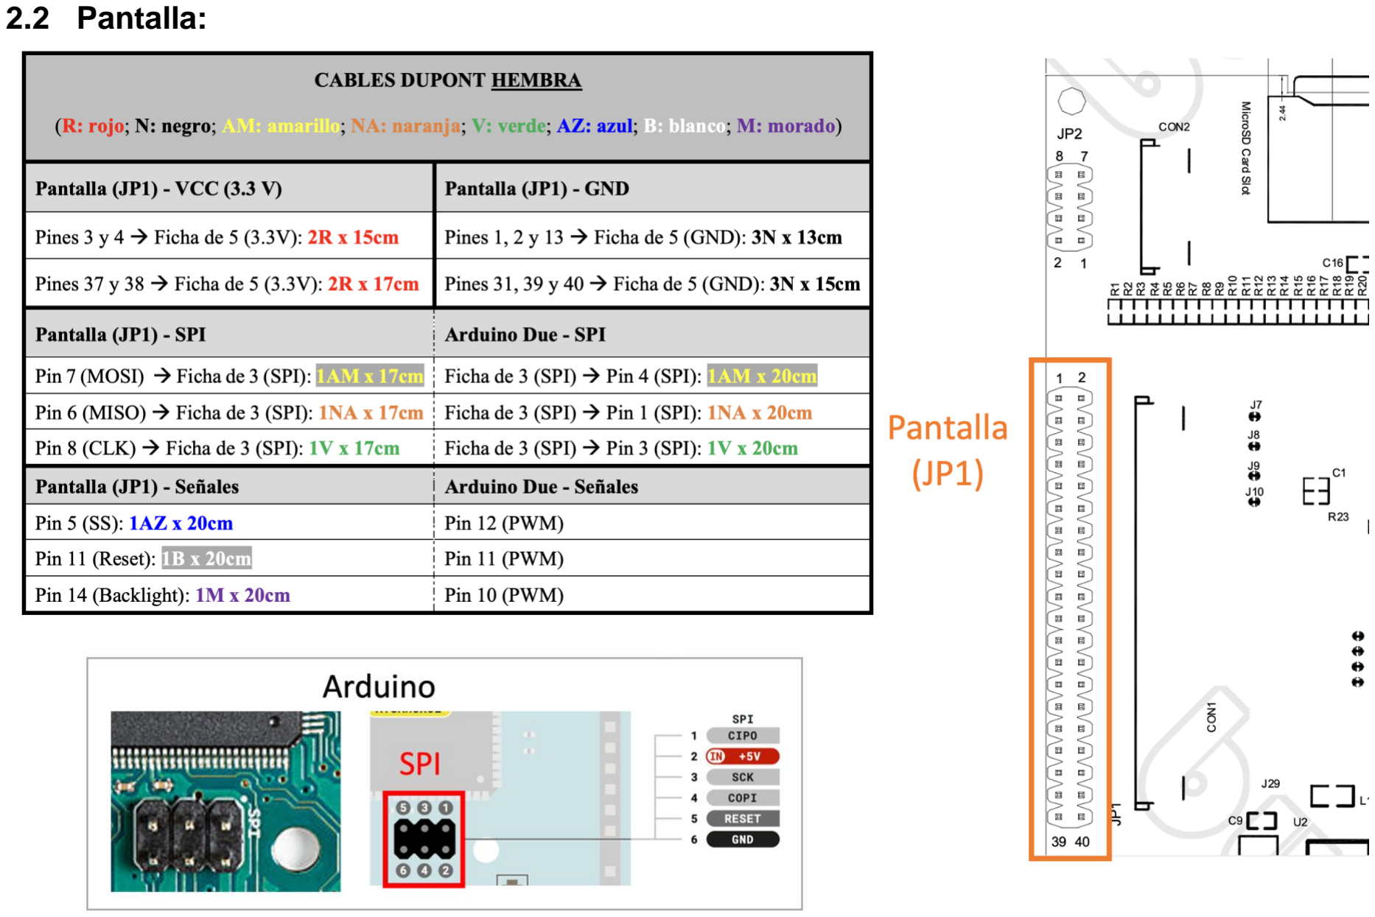
[picture p73: page 6]

## 2.3 Tarjeta microSD:

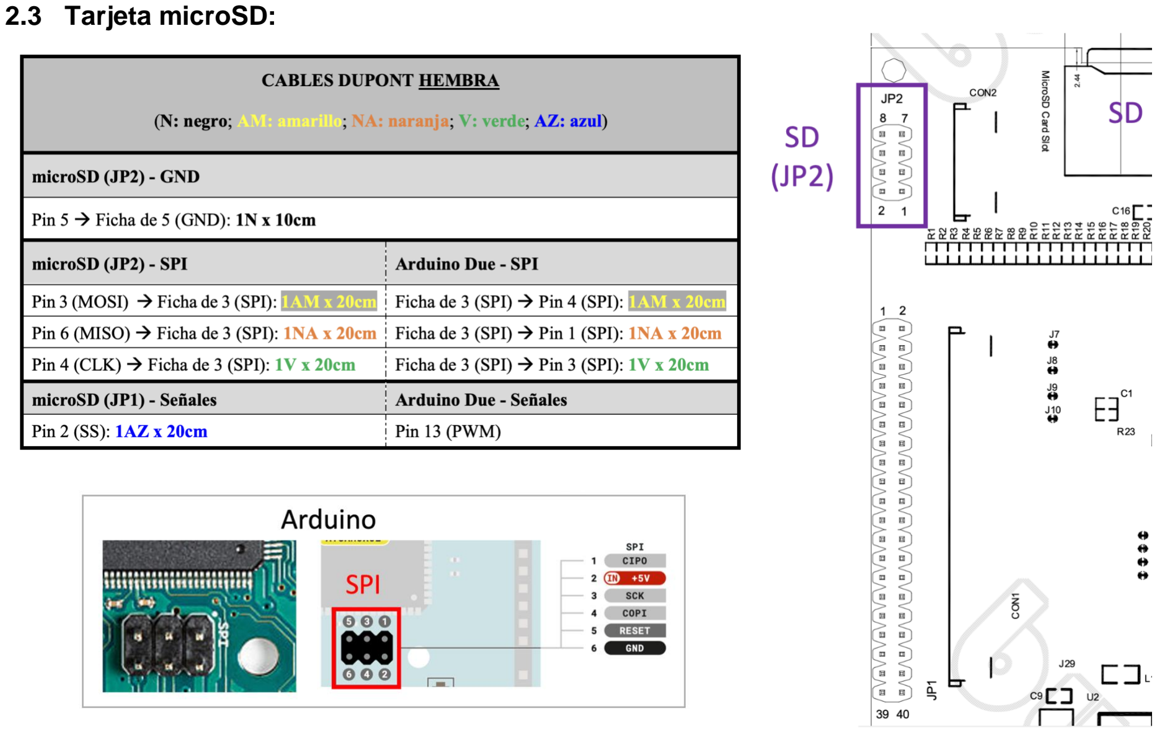
[picture p74: page 7]

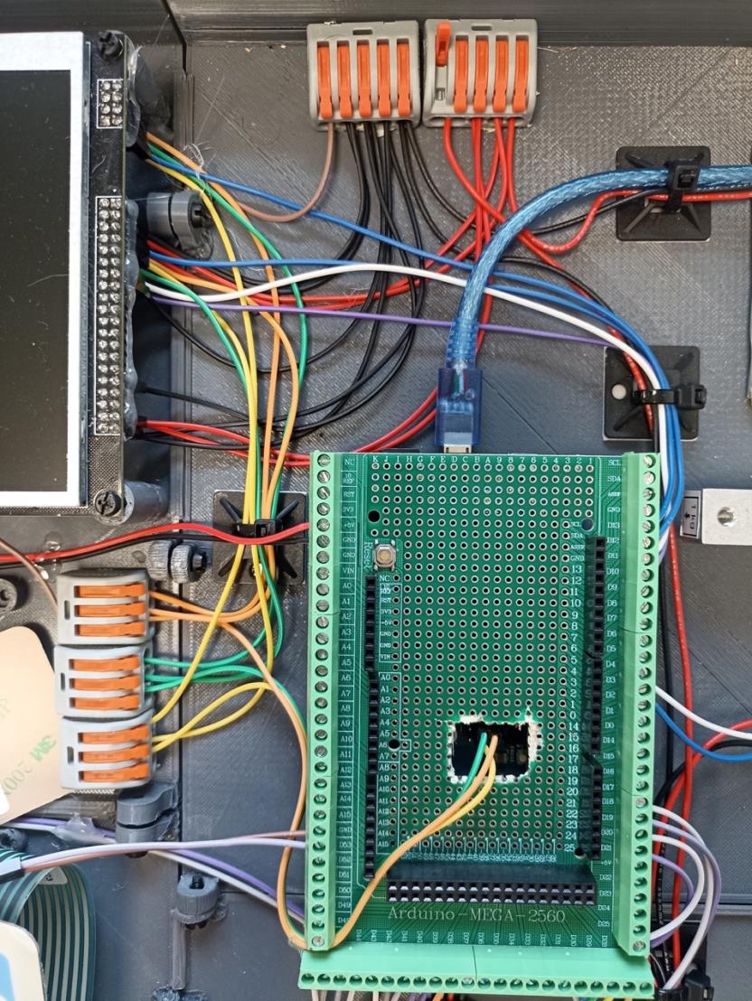
[picture p75: figure]

## 2.4 RTC:

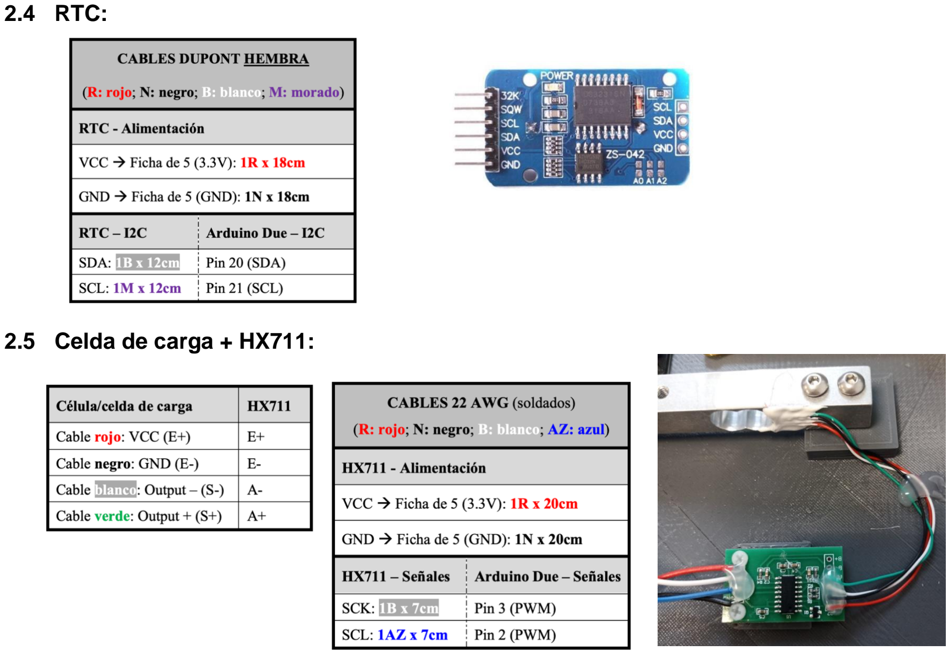
[picture p76: page 9]

## 2.5 Celda de carga + HX711:

## 2.6 Botonera A + placa adaptación:

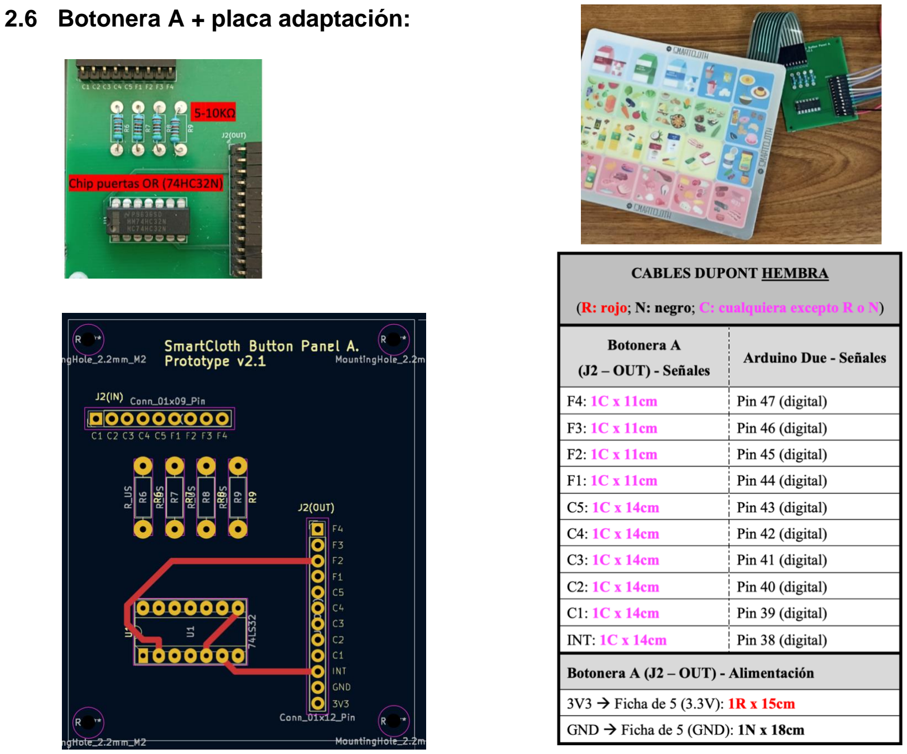
[picture p77: page 10]

## 2.7 Botonera B + placa adaptación:

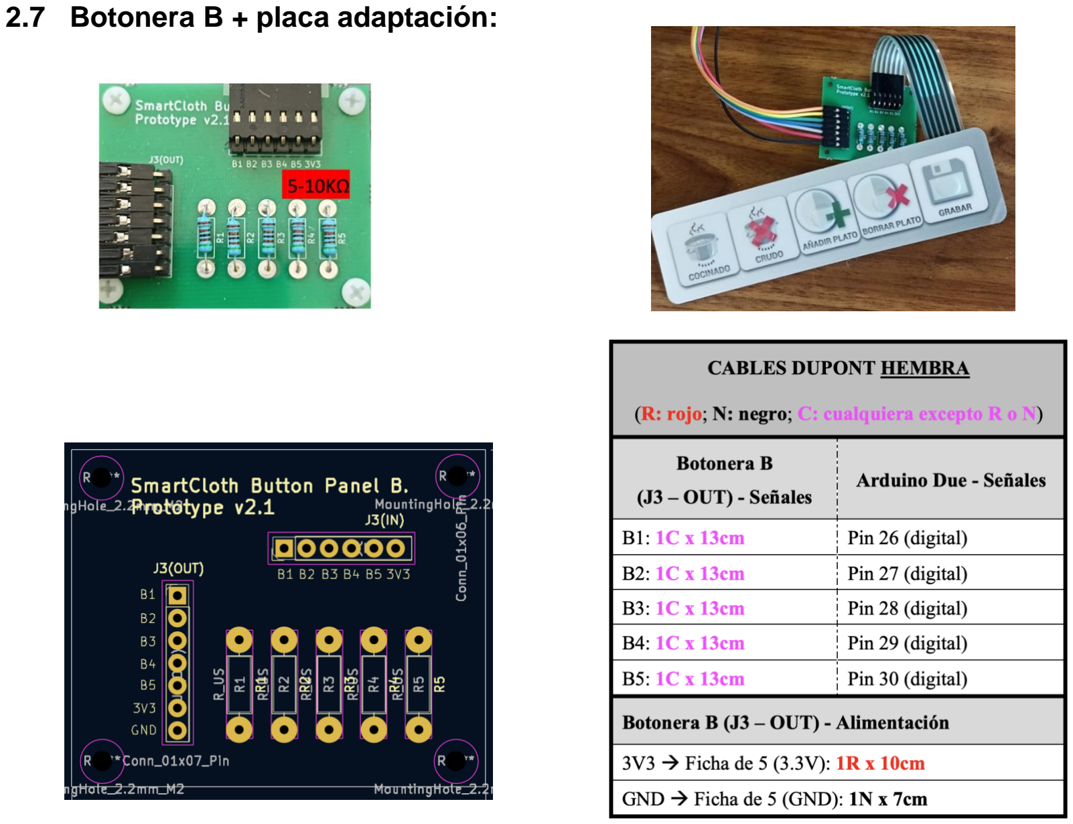
[picture p78: page 11]

## 2.8 ESP32-CAM:

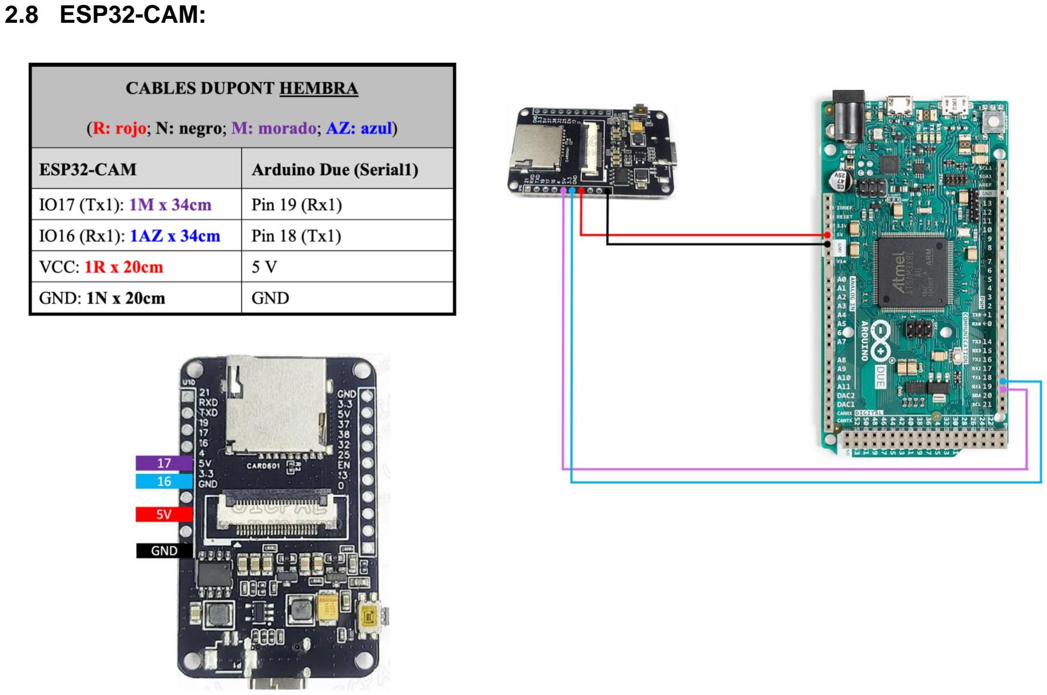
[picture p79: page 12]

## 2.9 Botón código de barras:

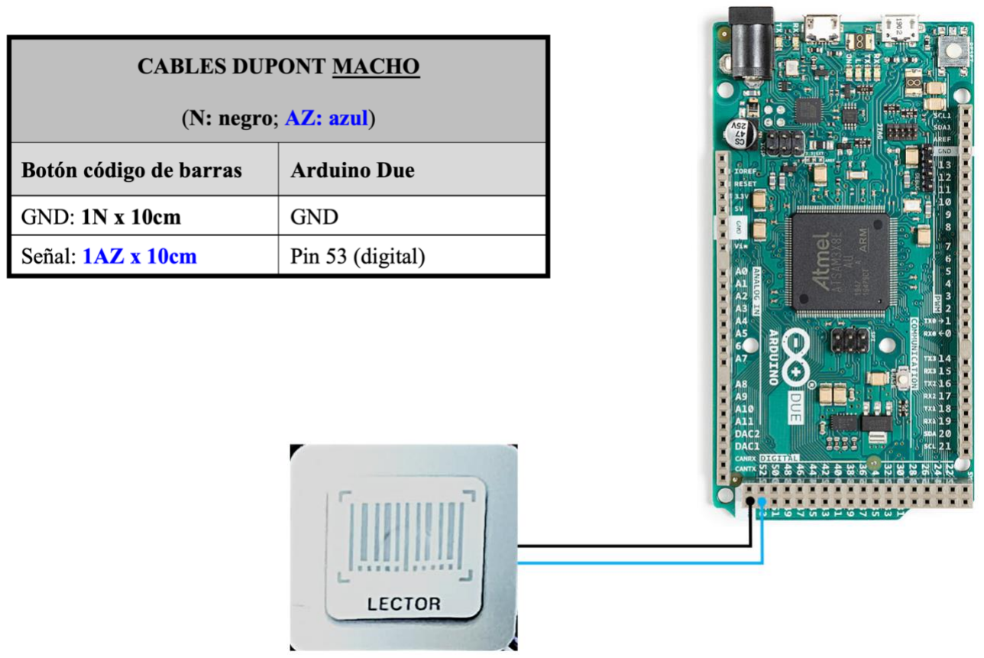
[picture p80: figure]
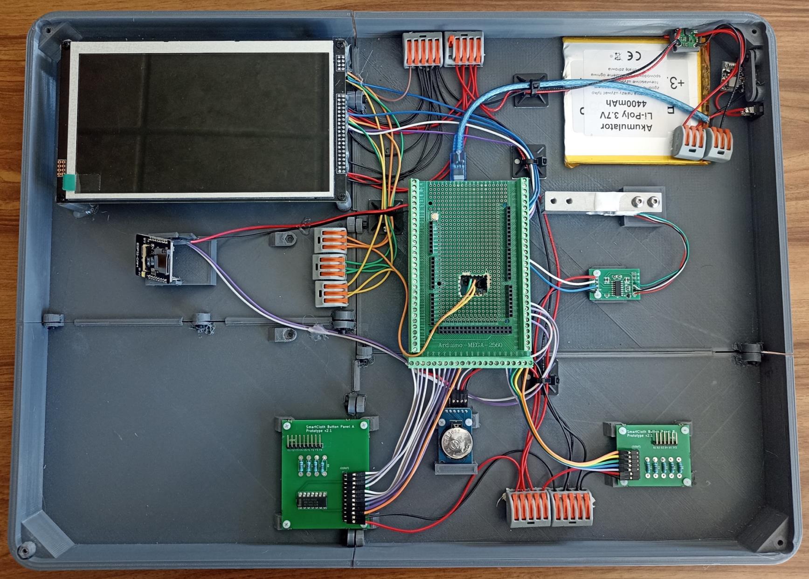
[picture p81: page 14]
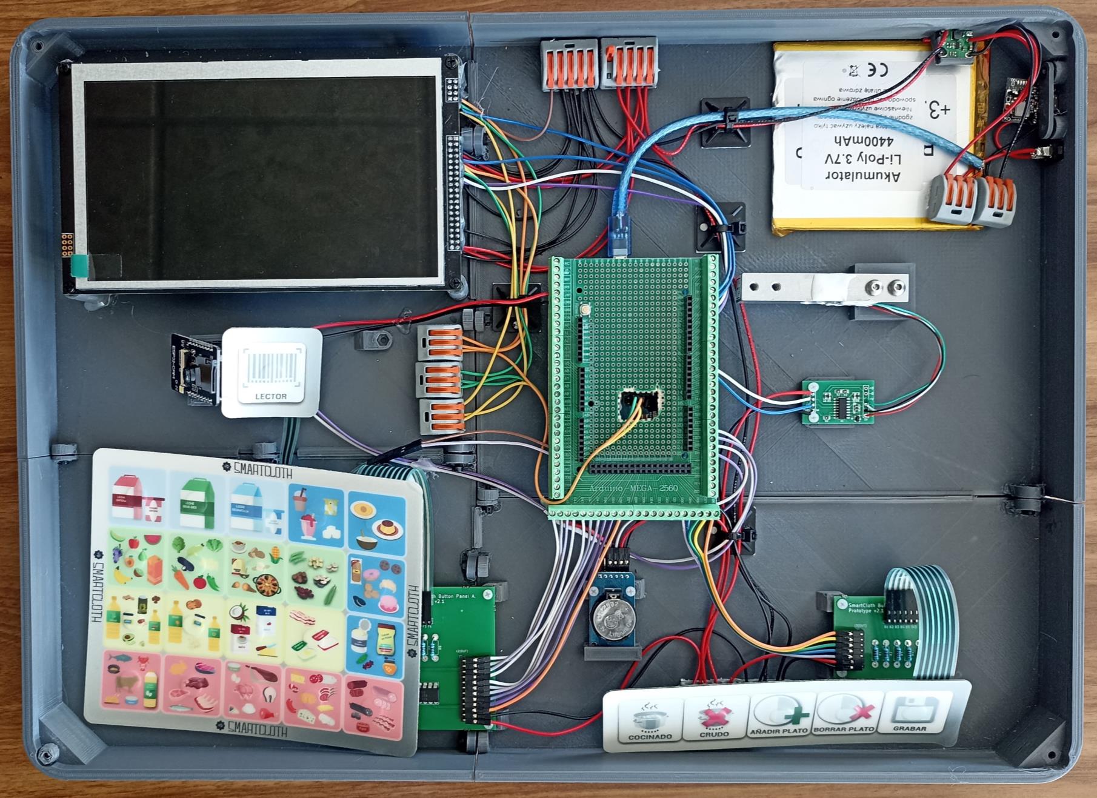
[picture p82: page 15]

SOFTWARE

### 1. Guardar imágenes en SD manteniendo la estructura de ficheros

### 2. Poner RTC en hora (v2.1 - src/RTC_set_time)

### 3. Calibrar báscula (v2.1 - src/scale)

a. Poner peso conocido (p.ej. celda de carga que pesa 30gr)
b. escala inicial ∗ gr obtenidos al pesar = X
c. X
30 gr ⁄ = nueva escala (bascula calibrada)
d. Modificar programa Arduino con nueva escala calculada (setupScale() → scale.set_scale(escala))

### 4. Comentar #define SM_DEBUG del debug.h en los programas de Arduino y ESP32

### 5. Programar Arduino (v2.1 - src/smartcloth_v2)

### 6. Cambiar credenciales WiFi (nombre y contraseña) en programa ESP32

### 7. Programar ESP32 (v2.1 - src/esp32cam-v1)

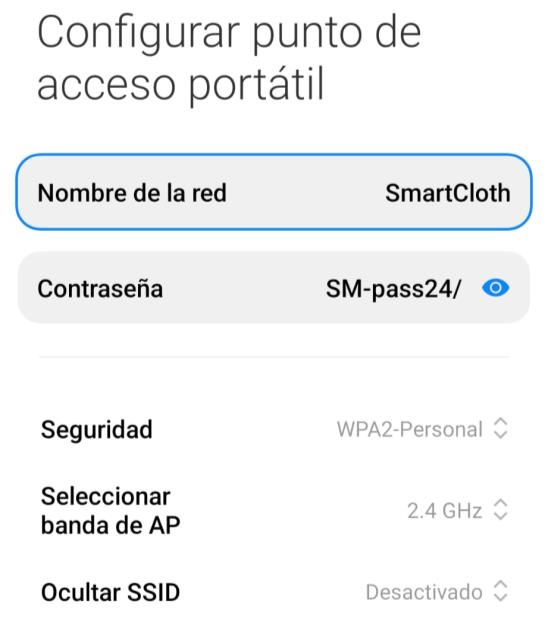
[picture p83: figure]
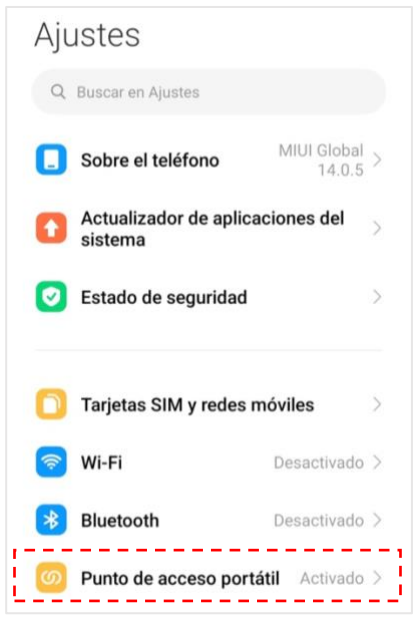
[picture p84: figure]
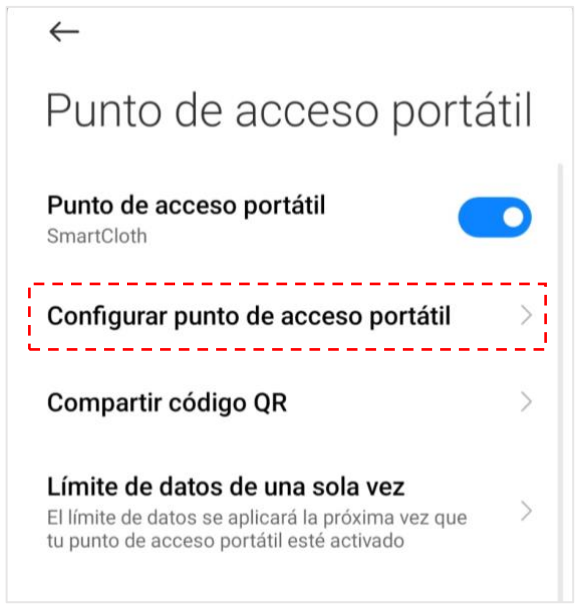
[picture p85: figure]

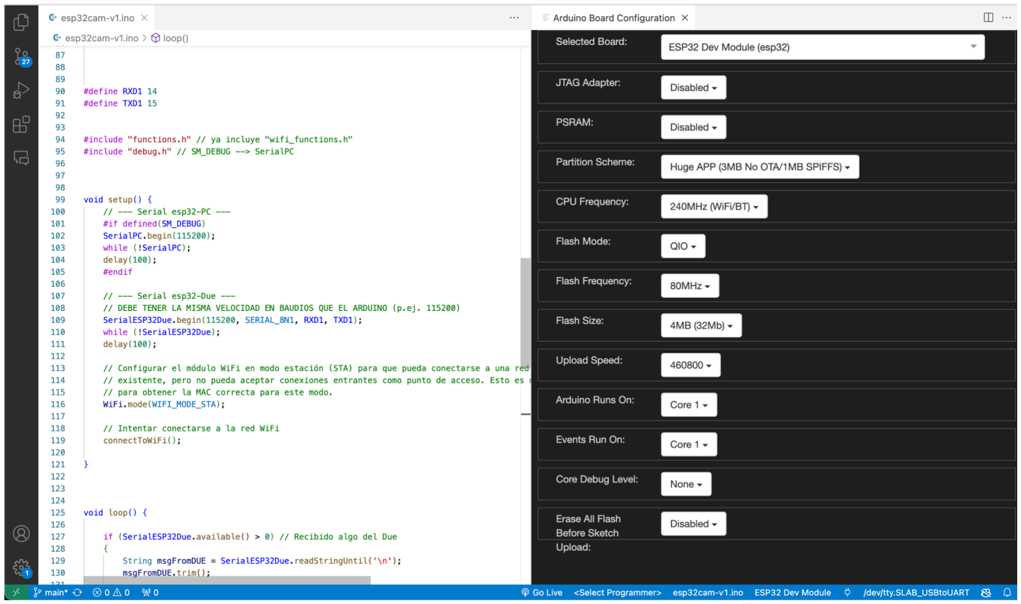
[picture p86: figure]
