i62caroi/SmartCloth/examples/SCREEN/RA8876_v2_BTE/results/BTE copy de page2 a page1 normal:ROP:Chroma.jpg

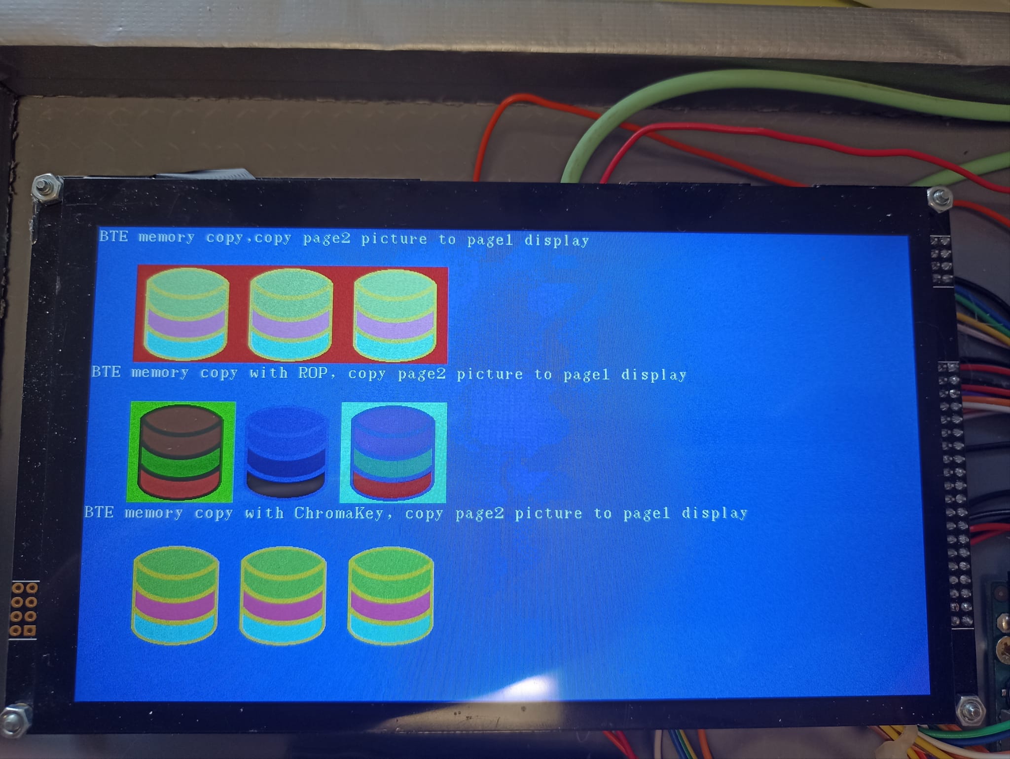
examples/SCREEN/RA8876_v2_BTE/results/BTE copy de page2 a page1 normal:ROP:Chroma.jpg
