i62caroi/SmartCloth/examples/SCREEN/RA8876_v2_BTE/results/BTE MPU write color expansion w: y w:o chroma.jpg

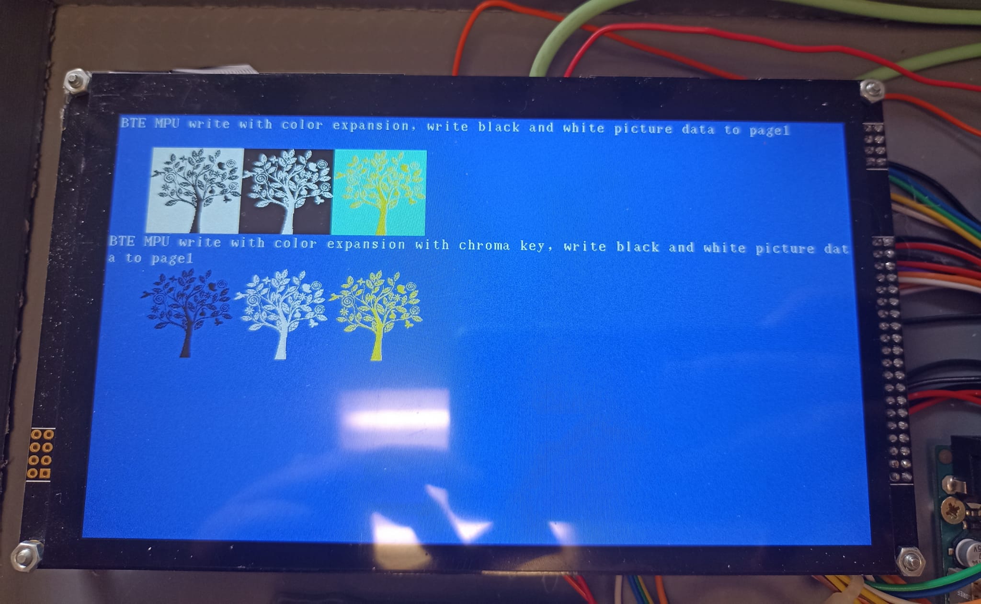
examples/SCREEN/RA8876_v2_BTE/results/BTE MPU write color expansion w: y w:o chroma.jpg
