i62caroi/SmartCloth/examples/SCREEN/RA8876_v2_BTE/results/BTE MPU write normal:ROP:Chroma formato word y byte.jpg

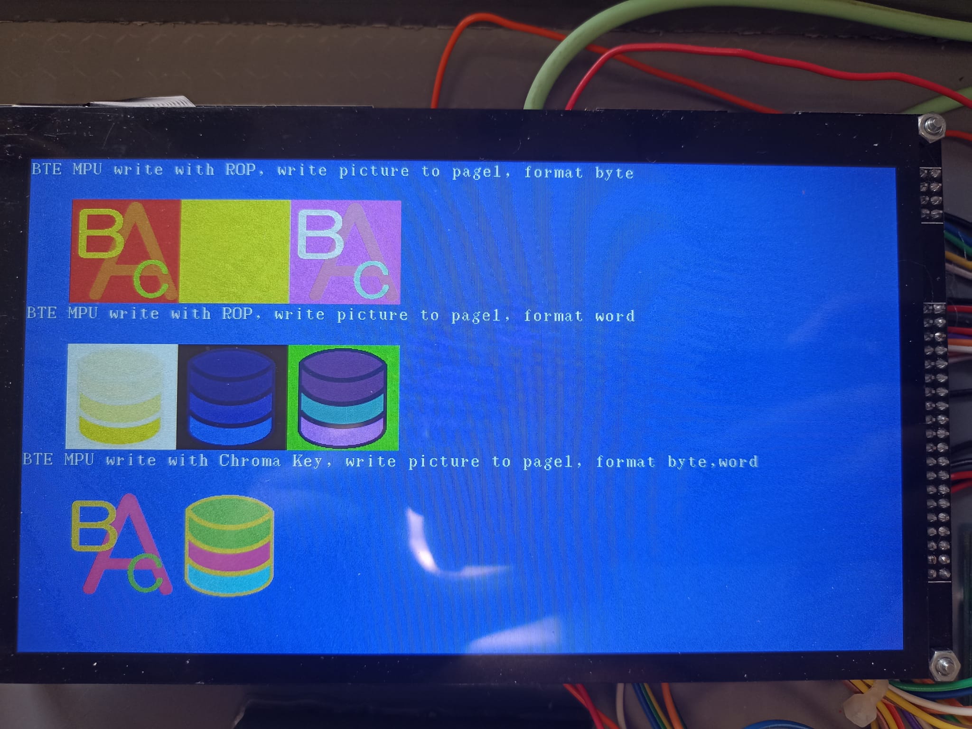
examples/SCREEN/RA8876_v2_BTE/results/BTE MPU write normal:ROP:Chroma formato word y byte.jpg
