i62caroi/SmartCloth/Docs/Diseno-SmartCloth/Database/Diseño database/Esquema E-R SmartCloth.pdf

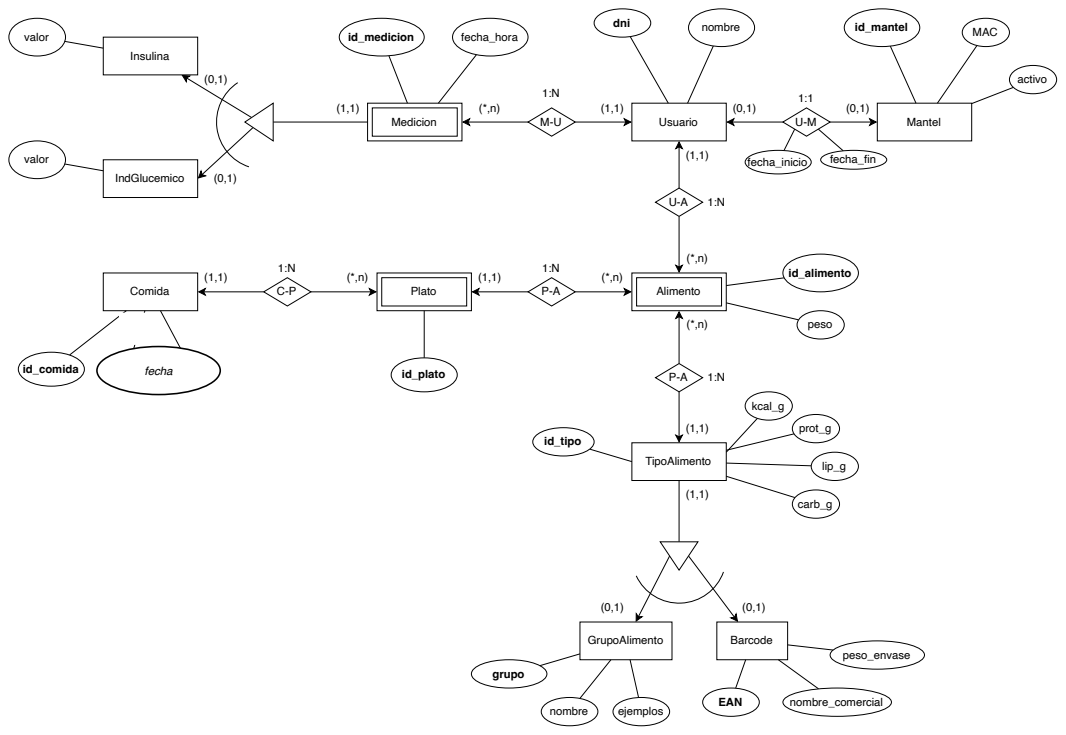
[picture p90: page 1]
Comida; Plato; Alimento; id_comida; fecha; hora; id_plato; id_alimento; peso; Usuario; Mantel; dni; nombre; id_mantel; MAC; activo; Medicion; Insulina; IndGlucemico; TipoAlimento; valor; id_medicion; fecha_hora; kcal_g; prot_g; lip_g; carb_g; id_tipo; GrupoAlimento; Barcode; grupo; ejemplos; EAN; fecha_inicio; fecha_fin; nombre_comercial; peso_envase
