i62caroi/SmartCloth/Docs/Diseno-SmartCloth/Diagramas software/Diagrama sincronizacion inicial de data/due-esp32.pdf

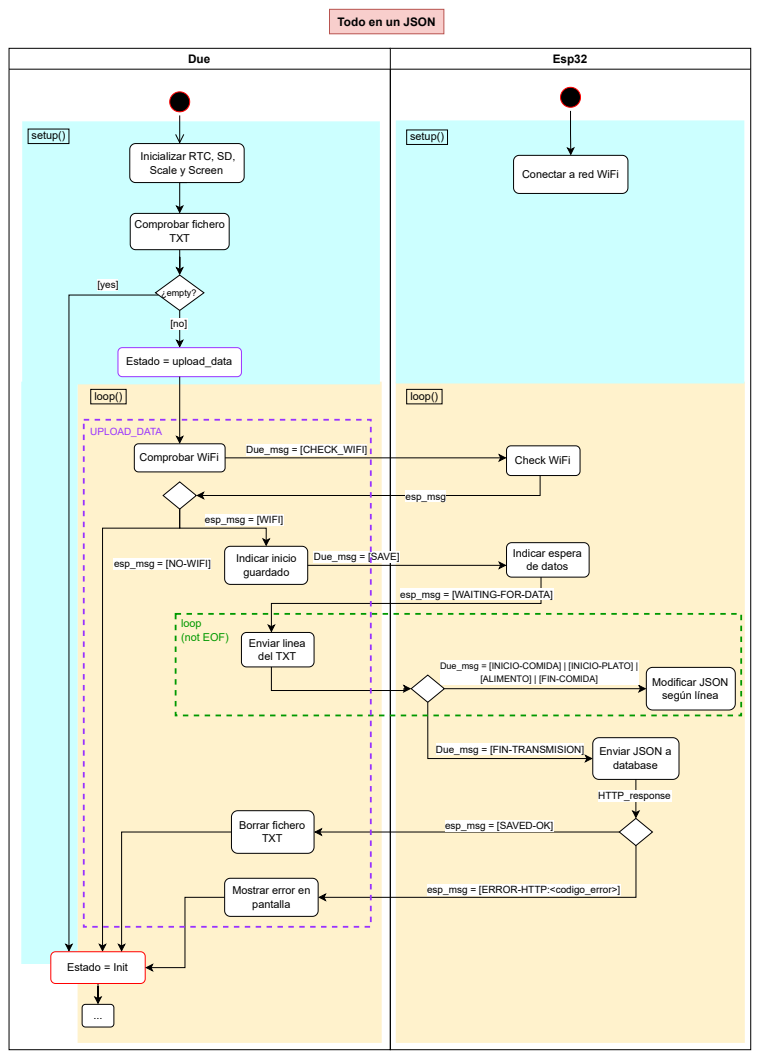
[picture p91: page 1]
Esp32; Check WiFi; Indicar espera de datos; Due_msg = [FIN-TRANSMISION]; Modificar JSON según línea; Enviar JSON a database; HTTP_response; setup(); loop(); Due; esp_msg = [WIFI]; esp_msg = [NO-WIFI]; Comprobar fichero TXT; [yes]; ¿empty?; Estado = upload_data; Comprobar WiFi; Estado = Init; Indicar inicio guardado; Enviar linea del TXT; Borrar fichero TXT; UPLOAD_DATA; loop (not EOF); Due_msg = [CHECK_WIFI]; esp_msg; Due_msg = [SAVE]; esp_msg = [SAVED-OK]; esp_msg = [ERROR-HTTP:<codigo_error>]

Todo en un JSON

Inicializar RTC, SD,
Scale y Screen

Conectar a red WiFi

esp_msg = [WAITING-FOR-DATA]

Due_msg = [INICIO-COMIDA] | [INICIO-PLATO]

[ALIMENTO] | [FIN-COMIDA]

Mostrar error en
pantalla

## Un JSON por comida

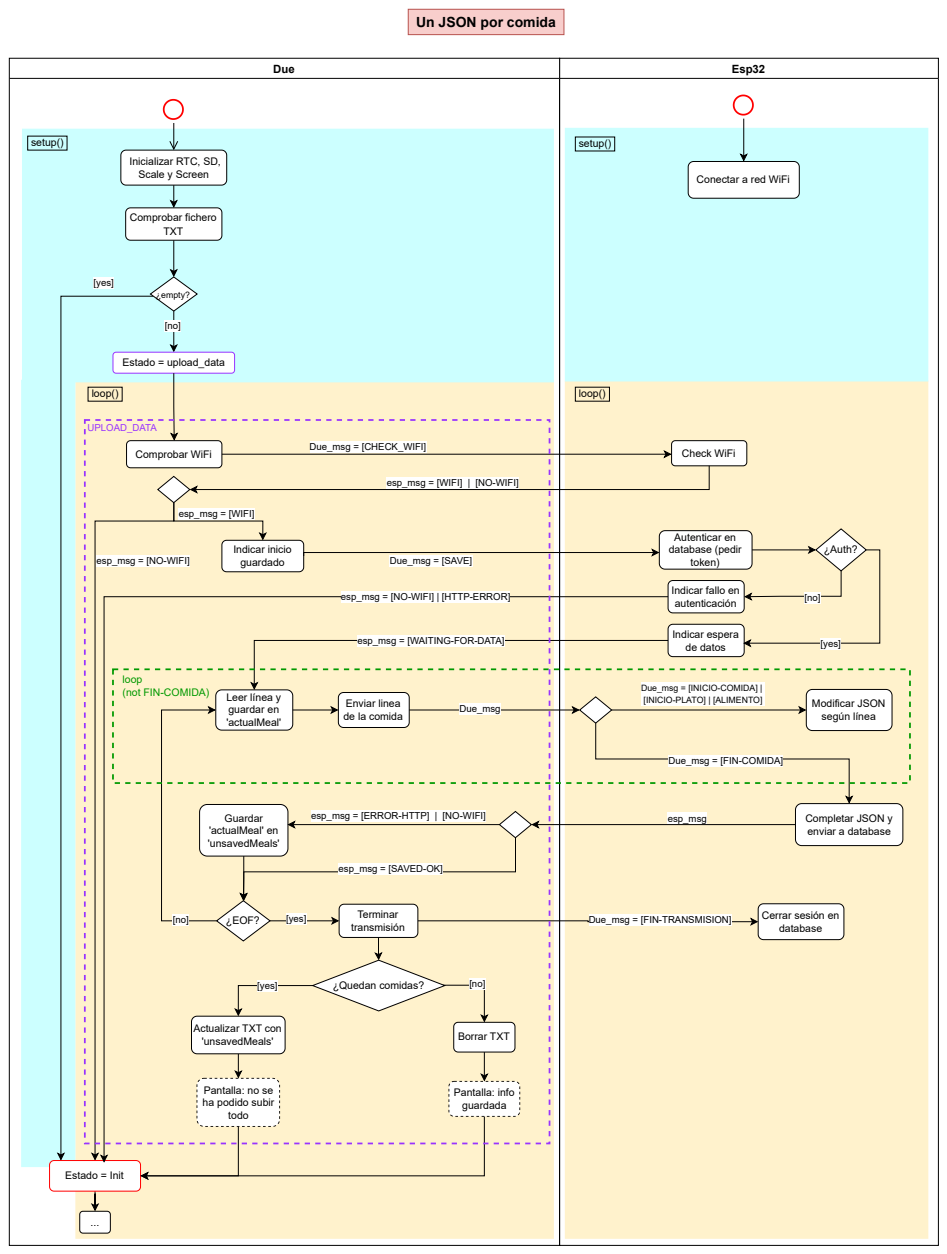
[picture p92: page 2]
Esp32; Check WiFi; Autenticar en database (pedir token); Due_msg = [FIN-COMIDA]; Modificar JSON según línea; setup(); loop(); Completar JSON y enviar a database; ¿Auth?; Indicar espera; de datos; [yes]; Due; esp_msg = [NO-WIFI]; esp_msg = [WIFI]; Comprobar fichero TXT; ¿empty?; Estado = upload_data; Comprobar WiFi; Estado = Init; Indicar inicio guardado; Guardar 'actualMeal' en 'unsavedMeals'; UPLOAD_DATA; Leer línea y guardar en 'actualMeal'; ¿Quedan comidas?; Pantalla: info guardada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

Inicializar RTC, SD,
Scale y Screen

Conectar a red WiFi

esp_msg = [WIFI] | [NO-WIFI]

esp_msg = [NO-WIFI] | [HTTP-ERROR]

Indicar fallo en
autenticación

esp_msg = [WAITING-FOR-DATA]

loop
(not FIN-COMIDA)

Due_msg = [INICIO-COMIDA]
[INICIO-PLATO] | [ALIMENTO]

Enviar linea
de la comida

esp_msg = [ERROR-HTTP] | [NO-WIFI]

Cerrar sesión en
database

Actualizar TXT con
'unsavedMeals'

Pantalla: no se
ha podido subir
todo
