i62caroi/SmartCloth/Docs/Diseno-SmartCloth/PCBs/Botoneras v2.1/PCBs.pdf

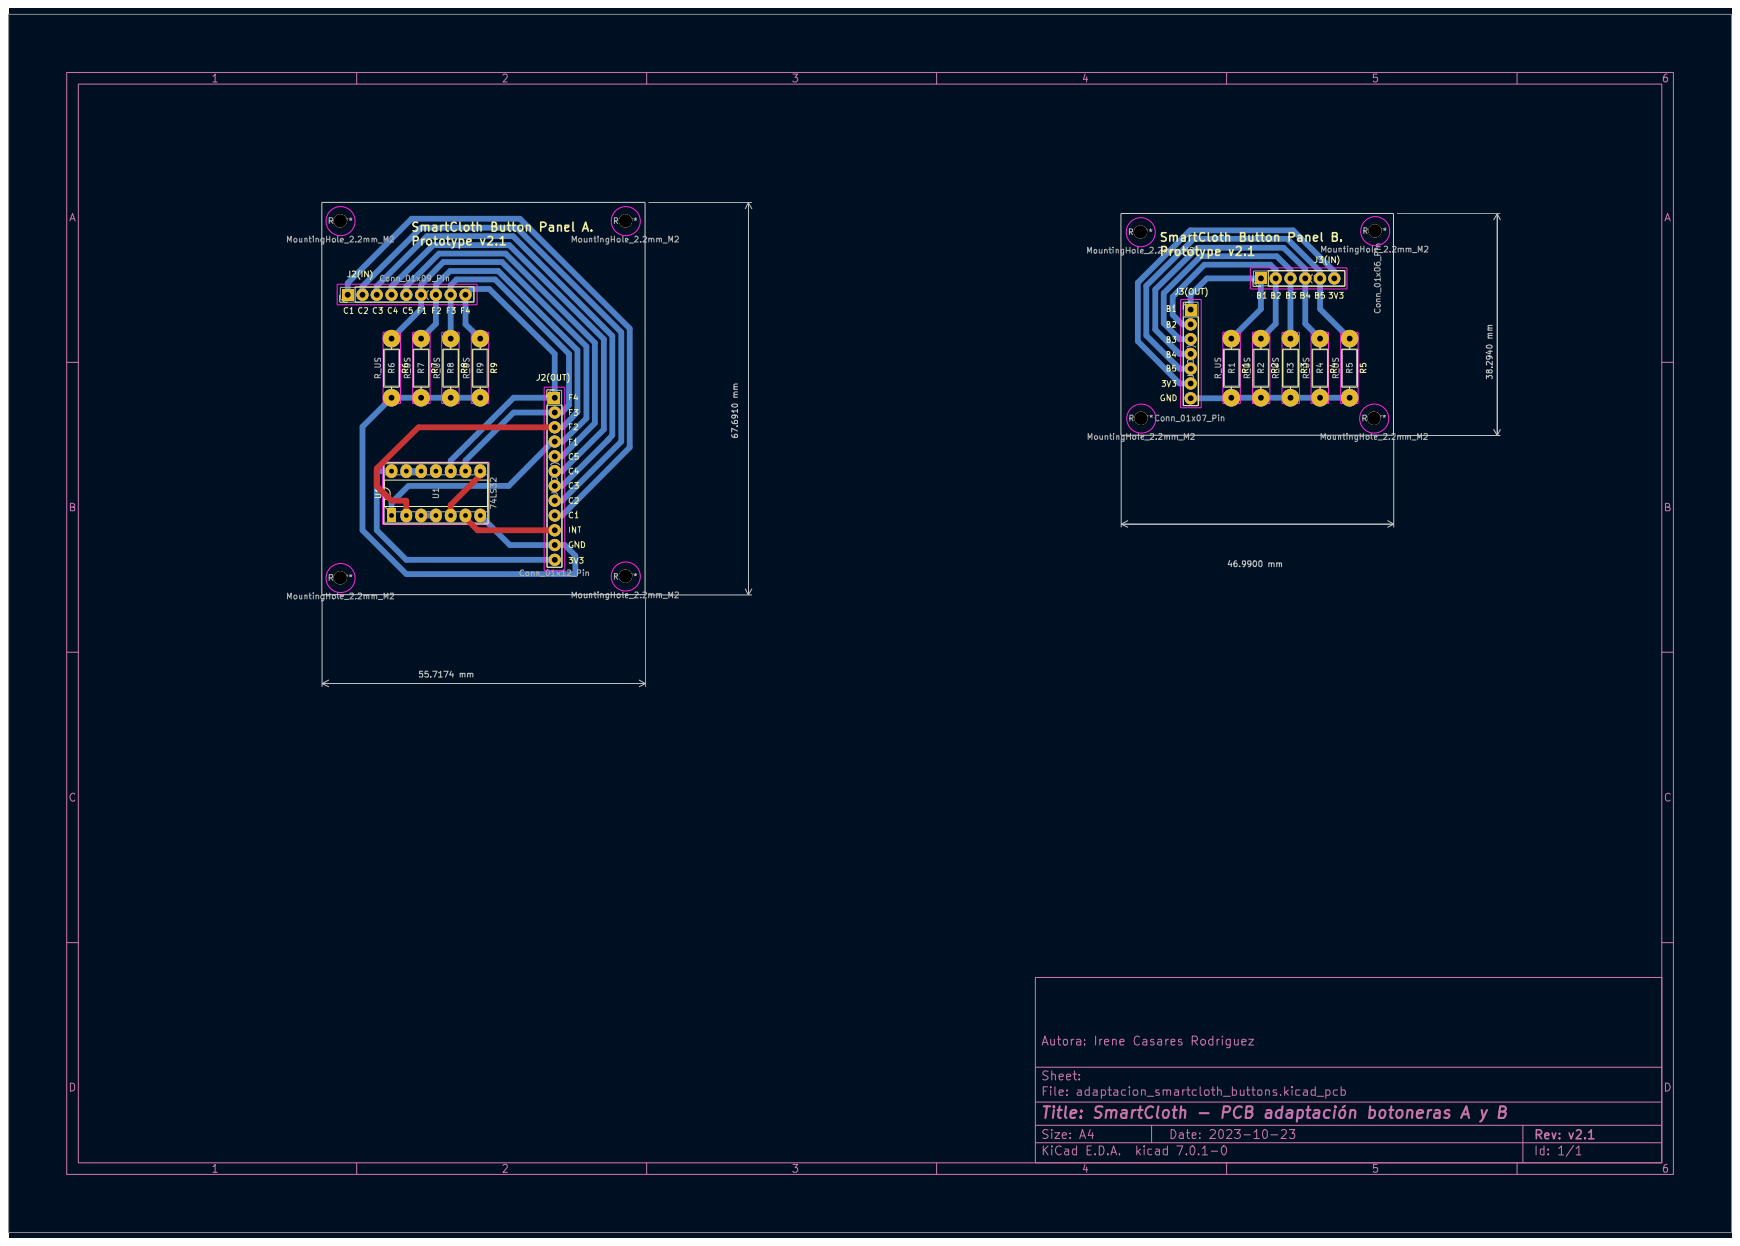
[picture p93: page 1]
