i62caroi/SmartCloth/Docs/Diseno-SmartCloth/Database/Diseño database/BD_SmartCloth.pdf

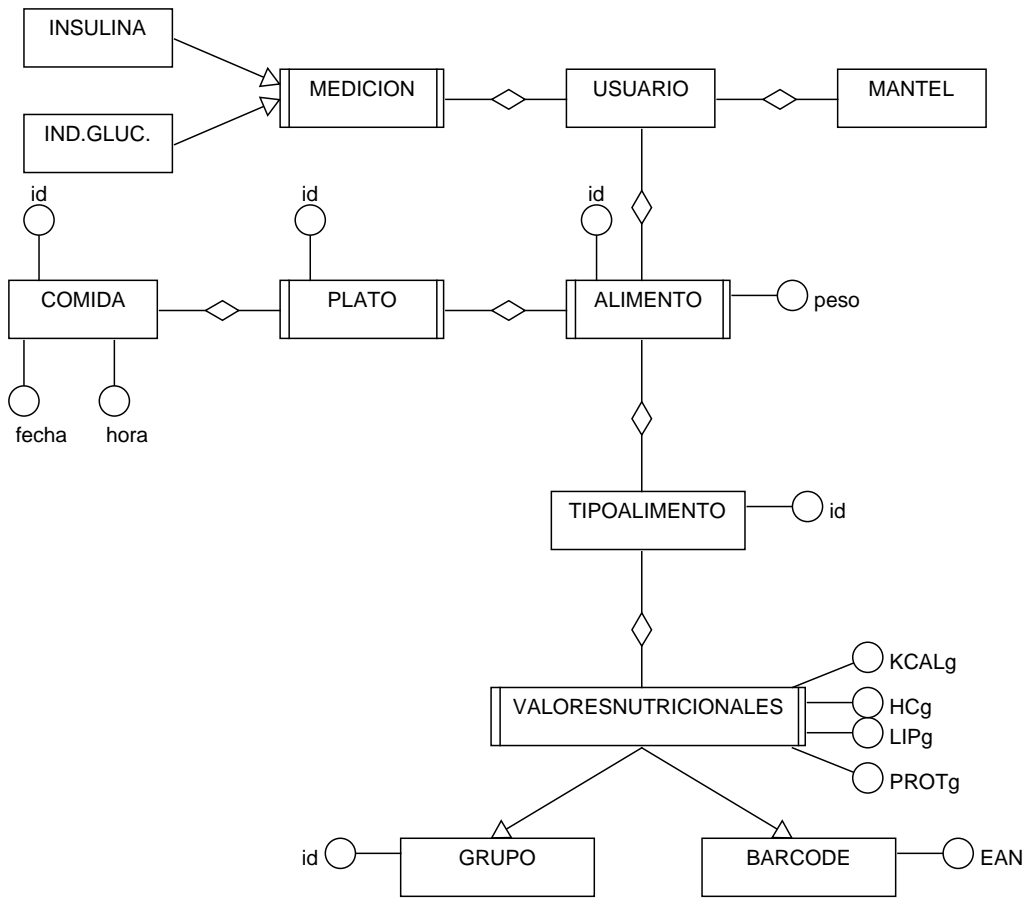
[picture p94: page 1]
fecha; hora; EAN; KCALg; PROTg; LIPg; HCg; peso; GRUPO; BARCODE; VALORESNUTRICIONALES; TIPOALIMENTO; COMIDA; PLATO; ALIMENTO; MEDICION; IND.GLUC.; INSULINA; USUARIO; MANTEL
