i62caroi/SmartCloth/Docs/Diseno-SmartCloth/Diagramas software/UML/Diagramas Smartcloth.pdf

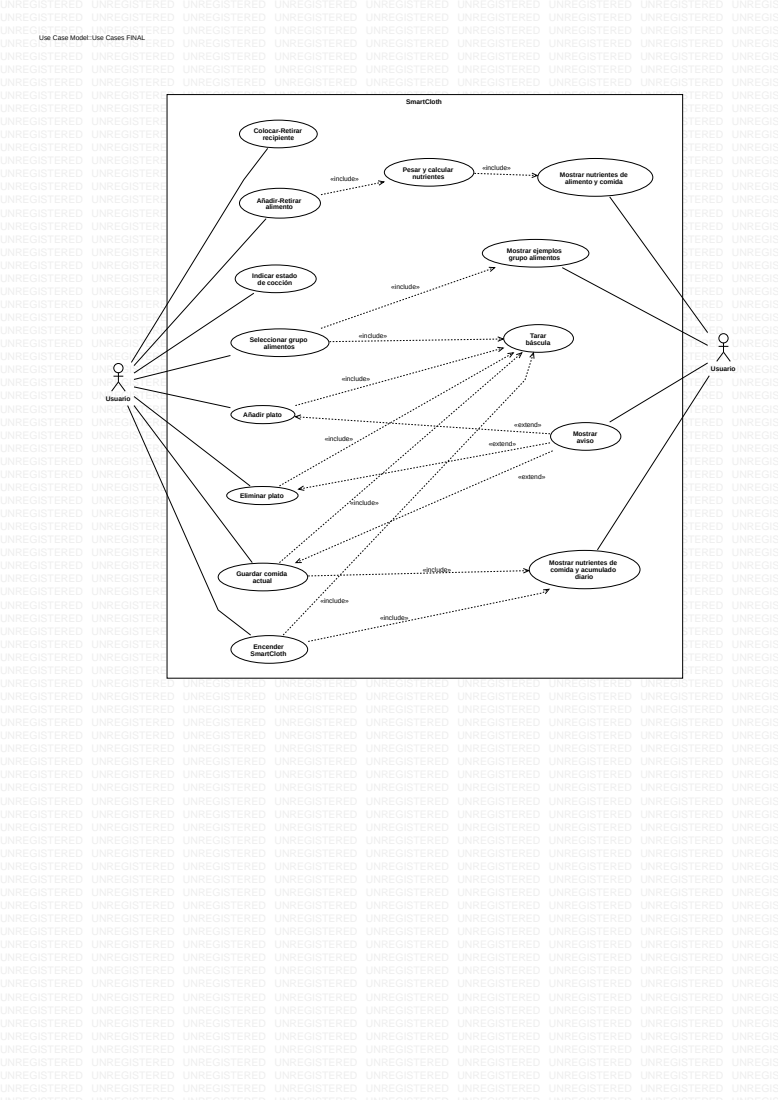
[picture p95: page 1]
UNREGISTERED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

Use Case Model::Use Cases FINAL

UNREGISTERED
UNREGISTERED
UNREGISTERED
UNREGISTERED
UNREGISTERED
UNREGISTERED
UNREGISTERED
UNREGISTERED
UNREGISTERED
UNREGISTERED
UNREGISTERED
UNREGISTERED
UNREGISTERED
UNREGISTERED
UNREGISTERED
UNREGISTERED
UNREGISTERED
UNREGISTERED
UNREGISTERED
UNREGISTERED
UNREGISTERED
UNREGISTERED
UNREGISTERED
UNREGISTERED
UNREGISTERED
UNREGISTERED
UNREGISTERED
UNREGISTERED
UNREGISTERED
UNREGISTERED
UNREGISTERED
UNREGISTERED
UNREGISTERED
UNREGISTERED
UNREGISTERED
UNREGISTERED
UNREGISTERED
UNREGISTERED
UNREGISTERED
UNREGISTERED
UNREGISTERED
UNREGISTERED
UNREGISTERED
UNREGISTERED
UNREGISTERED
UNREGISTERED
UNREGISTERED
UNREGISTERED
UNREGISTERED
UNREGISTERED
UNREGISTERED
UNREGISTERED
UNREGISTERED
UNREGISTERED
UNREGISTERED
UNREGISTERED
UNREGISTERED
UNREGISTERED
UNREGISTERED
UNREGISTERED
UNREGISTERED
UNREGISTERED
UNREGISTERED
UNREGISTERED
UNREGISTERED
UNREGISTERED
UNREGISTERED
UNREGISTERED
UNREGISTERED
UNREGISTERED

UNREGISTERED
UNREGISTERED
UNREGISTERED
UNREGISTERED
UNREGISTERED
UNREGISTERED
UNREGISTERED
UNREGISTERED
UNREGISTERED
UNREGISTERED
UNREGISTERED
UNREGISTERED
UNREGISTERED
UNREGISTERED
UNREGISTERED
UNREGISTERED
UNREGISTERED
UNREGISTERED
UNREGISTERED
UNREGISTERED
UNREGISTERED
UNREGISTERED
UNREGISTERED
UNREGISTERED
UNREGISTERED
UNREGISTERED
UNREGISTERED
UNREGISTERED
UNREGISTERED
UNREGISTERED
UNREGISTERED
UNREGISTERED
UNREGISTERED
UNREGISTERED
UNREGISTERED
UNREGISTERED
UNREGISTERED
UNREGISTERED
UNREGISTERED
UNREGISTERED
UNREGISTERED
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
UNREGISTERED
UNREGISTERED
UNREGISTERED
UNREGISTERED
UNREGISTERED
UNREGISTERED
UNREGISTERED
UNREGISTERED
UNREGISTERED
UNREGISTERED
UNREGISTERED
UNREGISTERED
UNREGISTERED
UNREGISTERED
UNREGISTERED
UNREGISTERED
UNREGISTERED
UNREGISTERED
UNREGISTERED
UNREGISTERED
UNREGISTERED
UNREGISTERED

Alimento
-grupo: Grupo
-peso: double
-valoresAlimento: ValoresNutricionales +Alimento()
+Alimento(grupo: Grupo, peso: double) +setGrupoAlimento(grupo: Grupo) +getGrupoAlimento(): Grupo +setPesoAlimento(peso: double) +getPesoAlimento(): double +updateValoresAlimento(grupo: Grupo, peso: double) +setValoresAlimento(val: ValoresNutricionales) +getValoresAlimento(): ValoresNutricionales

Plato
-nAlimentos: int
-peso: float
-valoresPlato: ValoresNutricionales -setNumAlimentos(num: int) -getNumAlimentos(): int
+Plato()
+isPlatoEmpty(): bool
+setPesoPlato(peso: float) +getPesoPlato(): float
+addAlimentoPlato(alimento: Alimento) +setValoresPlato(val: ValoresNutricionales) +getValoresPlato(): ValoresNutricionales +updateValoresPlato(val: ValoresNutricionales) +restorePlato()

Comida
-nPlatos: int
-peso: float
-valoresComida: ValoresNutricionales -setNumPlatos(num: int)
-getNumPlatos(): int
+Comida()
+isComidaEmpty(): bool
+setPesoComida(peso: float) +getPesoComida(): float
+addAlimentoComida(alimento: Alimento) +addPlato(plato: Plato)
+deletePlato(&plato: Plato)
+setValoresComida(val: ValoresNutricionales) +getValoresComida(): ValoresNutricionales +updateValoresComida(suma: bool, val: ValoresNutricionales) +copyComida(comida: Comida)
+restoreComida()
+getComidaAllValues(): String

Diario
-nComidas: int
-peso: float
-valoresDiario: ValoresNutricionales

+Diario()
+setNumComida(num: int)
+getNumComidas(): int
+setPesoDiario(peso: float) +getPesoDiario(): float
+addComida(comida: Comida) +setValoresDiario(val: ValoresNutricionales) +getValoresDiario(): ValoresNutricionales +updateValoresDiario(val: ValoresNutricionales)
1..* | 1 1..* | 1

1

1..*

ValoresNutricionales
-carb: float
-lip: float
-prot: float
-kcal: float
-carb_R: float
-lip_R: float
-prot_R: float
+ValoresNutricionales()
+ValoresNutricionales(carb: float, lip: float, prot: float, kcal: float) +setCarbValores(carb: float)
+computeCarbRaciones()
+getCarbValores(): float
+getCarbRaciones(): float
+setLipValores(lip: float) +computeLipRaciones()
+getLipValores(): float
+getLipRaciones(): float
+setProtValores(prot: float) +computeProtRaciones()
+getProtValores(): float
+getProtRaciones(): float
+setKcalValores(kcal: float)
+getKcalValores(): float
+setValores(val: ValoresNutricionales) +setValores(carb: float, lip: float, prot: float, kcal: float)
1 | 1

1

1

1

1

1

1

Model::ClassDiagram

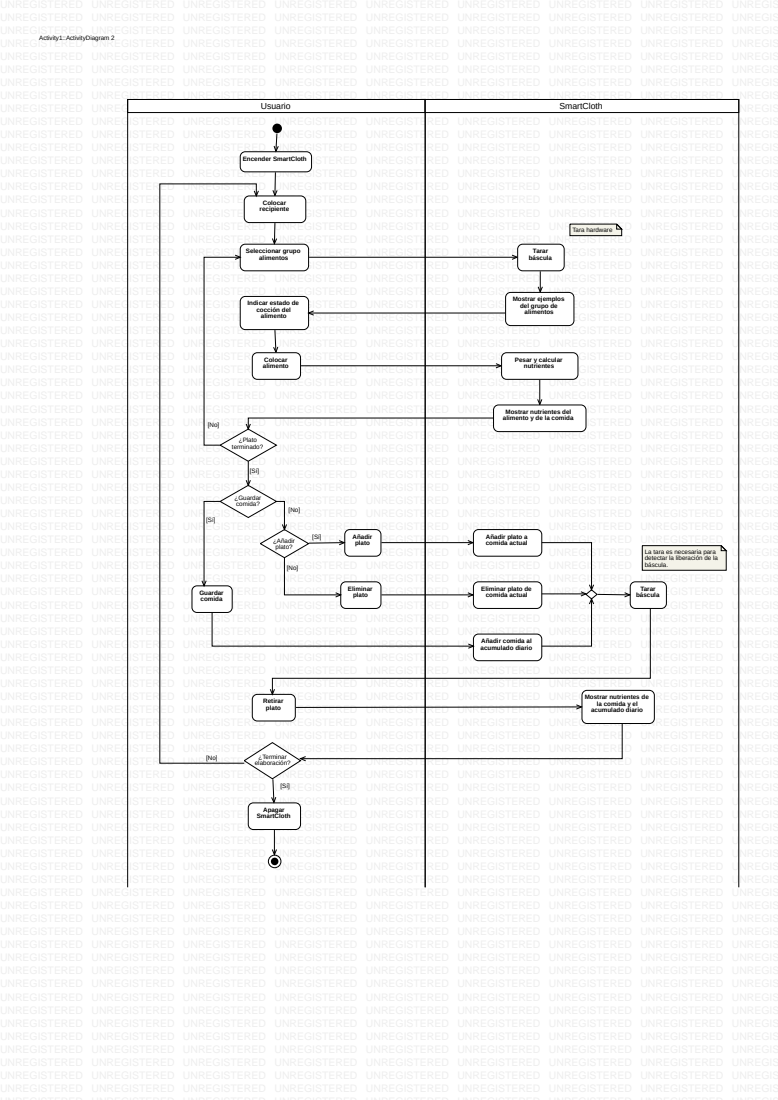
[picture p96: page 3]
UNREGISTERED UNREGISTERED UNREGISTERED UNREGISTERED UNREGISTERED UNREGISTERED UNREGISTERED UNREGISTERED UNREGISTERED UNREGISTERED UNREGISTERED UNREGISTERED UNREGISTERED UNREGISTERED UNREGISTERED UNREGISTERED UNREGISTERED UNREGISTERED UNREGISTERED UNREGISTERED UNREGISTERED UNREGISTERED UNREGISTERED UNREGISTERED UNREGISTERED UNREGISTERED UNREGISTERED UNREGISTERED UNREGISTERED UNREGISTERED UNREGISTERED UNREGISTERED UNREGISTERED UNREGISTERED UNREGISTERED UNREGISTERED UNREGISTERED UNREGISTERED UNRE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

UNREGISTERED Usuario UNREGISTERED UNREGISTERED | UNREGISTERED UNREGISTERED SmartCloth UNREGISTERED
UNREGISTERED UNREGISTERED UNREGISTERED UNREGISTERED UNREGISTERED UNREGISTERED UNREGISTERED UNREGISTERED UNREGISTERED UNREGISTERED UNREGISTERED UNREGISTERED Encender SmartCloth UNREGISTERED UNREGISTERED UNREGISTERED

Mostrar ejemplos
del grupo de
alimentos

Indicar estado de

Pesar y calcular nutrientes

Mostrar nutrientes del alimento y de la comida

Eliminar plato de
comida actual

Añadir comida al acumulado diario

Mostrar nutrientes de
la comida y el acumulado diario

### Flowchart1::Funcionamiento interno (setup y loop)

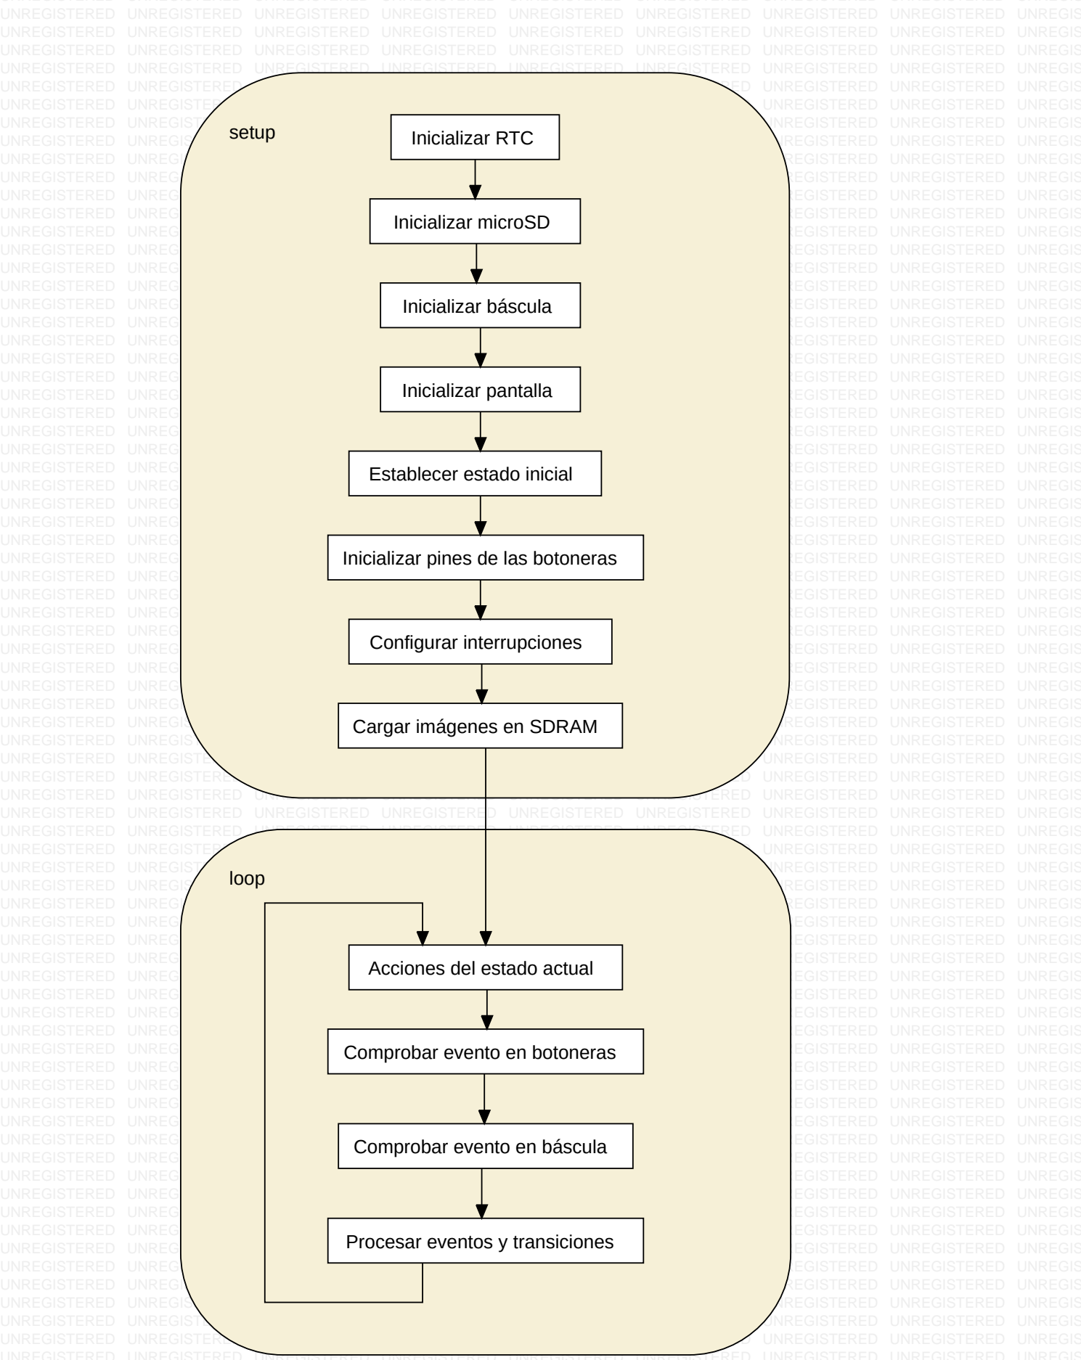
[picture p97: figure]
UNREGISTERED UNREGISTERED UNREGISTERED UNREGISTERED UNREGISTERED UNREGISTERED UNREGISTERED UNREGISTERED UNREGISTERED UNREGISTERED UNREGISTERED UNREGISTERED UNREGISTERED UNREGISTERED UNREGISTERED UNREGISTERED UNREGISTERED UNREGISTERED UNREGISTERED UNREGISTERED UNREGISTERED UNREGISTERED UNREGISTERED UNREGISTERED UNREGISTERED UNREGISTERED UNREGISTERED UNREGISTERED UNREGISTERED UNREGISTERED UNREGISTERED UNREGISTERED UNREGISTERED UNREGISTERED UNREGISTERED UNREGISTERED UNREGISTERED UNREGISTERED UNREGISTERED UNREGISTERED UNREGISTERED UNREGISTERED UNREGISTERED UNREGISTERED UNREGISTERED UNREGISTERED 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
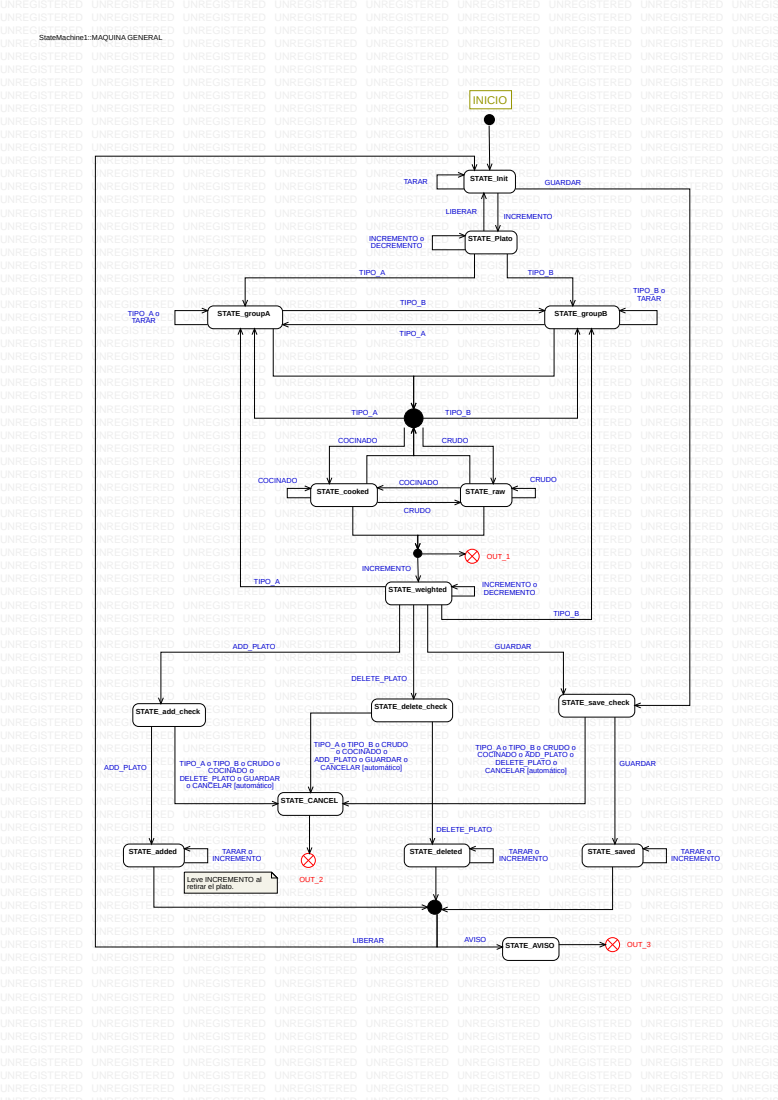
[picture p98: page 5]
UNREGISTERED UNREGISTERED UNREGISTERED UNREGISTERED UNREGISTERED UNREGISTERED UNREGISTERED UNREGISTERED UNREGISTERED UNREGISTERED UNREGISTERED UNREGISTERED UNREGISTERED UNREGISTERED UNREGISTERED UNREGISTERED UNREGISTERED UNREGISTERED UNREGISTERED UNREGISTERED UNREGISTERED UNREGISTERED UNREGISTERED UNREGISTERED UNREGISTERED UNREGISTERED UNREGISTERED UNREGISTERED UNREGISTERED UNREGISTERED UNREGISTERED UNREGISTERED UNREGISTERED UNREGISTERED UNREGISTERED UNREGISTERED UNREGISTERED UNREGISTERED UNRE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

UNREGISTERED
UNREGISTERED
UNREGISTERED
UNREGISTERED
UNREGISTERED
UNREGISTERED
UNREGISTERED
UNREGISTERED
UNREGISTERED
UNREGISTERED
UNREGISTERED
UNREGISTERED
UNREGISTERED
UNREGISTERED
UNREGISTERED
UNREGISTERED
UNREGISTERED
UNREGISTERED
UNREGISTERED
UNREGISTERED
UNREGISTERED

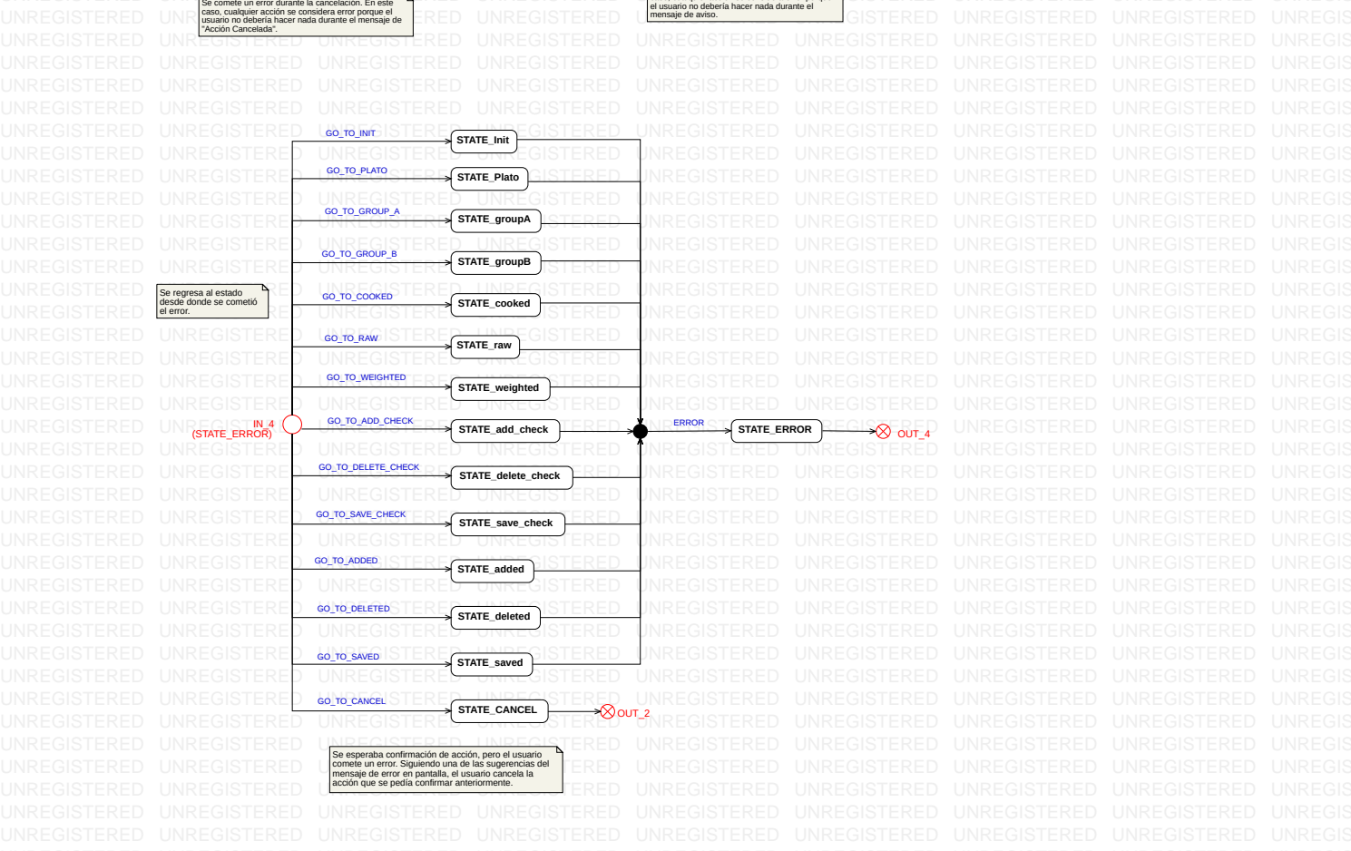
[picture p99: figure]
UNREGISTERED UNREGISTERED UNREGISTERED UNREGISTERED UNREGISTERED UNREGISTERED UNREGISTERED UNREGISTERED UNREGISTERED UNREGISTERED UNREGISTERED UNREGISTERED UNREGISTERED UNREGISTERED UNREGISTERED UNREGISTERED UNREGISTERED UNREGISTERED UNREGISTERED UNREGISTERED UNREGISTERED UNREGISTERED UNREGISTERED UNREGISTERED UNREGISTERED UNREGISTERED UNREGISTERED UNREGISTERED UNREGISTERED UNREGISTERED UNREGISTERED UNREGISTERED UNREGISTERED UNREGISTERED UNREGISTERED UNREGISTERED UNREGISTERED; STATE_Init; STATE_groupA; STATE_groupB; STATE_cooked; STATE_weighted; STATE_save_check; STATE_delete_check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

UNREGISTERED
UNREGISTERED
UNREGISTERED
UNREGISTERED
UNREGISTERED
UNREGISTERED
UNREGISTERED
UNREGISTERED
UNREGISTERED
UNREGISTERED
UNREGISTERED
UNREGISTERED

UNREGISTERED
UNREGISTERED
UNREGISTERED
UNREGISTERED
UNREGISTERED
UNREGISTERED
UNREGISTERED
UNREGISTERED
UNREGISTERED
UNREGISTERED
UNREGISTERED
UNREGISTERED
UNREGISTERED
UNREGISTERED
UNREGISTERED
UNREGISTERED
UNREGISTERED
UNREGISTERED
UNREGISTERED
UNREGISTERED
UNREGISTERED

UNREGISTERED
UNREGISTERED
UNREGISTERED
UNREGISTERED
UNREGISTERED
UNREGISTERED
UNREGISTERED
UNREGISTERED
UNREGISTERED
UNREGISTERED
UNREGISTERED
UNREGISTERED

UNREGISTERED
UNREGISTERED
UNREGISTERED
UNREGISTERED
UNREGISTERED
UNREGISTERED
UNREGISTERED
UNREGISTERED
UNREGISTERED
UNREGISTERED
UNREGISTERED
UNREGISTERED
UNREGISTERED
UNREGISTERED
UNREGISTERED
UNREGISTERED
UNREGISTERED
UNREGISTERED
UNREGISTERED
UNREGISTERED
UNREGISTERED

UNREGISTERED
UNREGISTERED
UNREGISTERED
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

Se pasa a estados de referencia tras saltar aviso de no haber añadido/eliminado plato o guardado la comida.

Se comete un error durante el aviso. En este caso, cualquier acción se considera error porque el usuario no debería hacer nada durante el mensaje de aviso.

Se esperaba confirmación de acción, pero el usuario comete un error. Siguiendo una de las sugerencias del mensaje de error en pantalla, el usuario cancela la

acción que se pedía confirmar anteriormente.

STATE_ERROR ERROR

StateMachine1::MAQUINAS EXTRAS
