i62caroi/SmartCloth/v2.1 - src/smartcloth_v2/State_Machine.h

/** 
 * @file State_Machine.h
 * @brief Máquina de Estados (State Machine) de SmartCloth
 *
 * @author Irene Casares Rodríguez
 * @date 31/01/24
 * @version 1.0
 *
 *  Este archivo contiene las definiciones de los estados y eventos, además de las funciones
 *  realizadas en cada estado y para el funcionamiento de la máquina de estados, incluyendo el
 *  manejo de errores y avisos.
 *  
 */

#ifndef STATE_MACHINE_H
#define STATE_MACHINE_H


#include "debug.h" // SM_DEBUG --> SerialPC

/**
 * @def MAX_EVENTS
 * @brief Máximo número de eventos que se puede guardar en el buffer de eventos. 
 */
#define MAX_EVENTS 5

/**
 * @def RULES
 * @brief Máximo número de reglas de transición.
 * 
 * @note Si este valor pasa de 255, hay que cambiar el tipo de dato de 'byte' a 'int' en la función checkStateConditions().
 */
#ifdef BORRADO_INFO_USUARIO
#define RULES 215
#else
#define RULES 201 
#endif


#include "SD_functions.h" // Incluye lista_Comida.h y Serial_functions.h
#include "Buttons.h"


// --- MENSAJE MOSTRADO CUANDO ZONA 1 VACÍA ---
#define  NO_MSG             0
#define  MSG_SIN_RECIPIENTE 1
#define  MSG_SIN_GRUPO      2

// --- PEDIR CONFIRMACIÓN ---
#define  ASK_CONFIRMATION_ADD                   1
#define  ASK_CONFIRMATION_DELETE                2
#define  ASK_CONFIRMATION_SAVE                  3
#define  ASK_CONFIRMATION_SAVE_CON_INTERNET     4  
#define  ASK_CONFIRMATION_SAVE_SIN_INTERNET     5  

// --- ACCIÓN CONFIRMADA ---
#define  ADD_EXECUTED                             1  // Se ha añadido un plato
#define  DELETE_EXECUTED                          2  // Se ha borrado el plato
// En SD_functions.h ya están los siguientes:
//      SAVE_EXECUTED_FULL
//      SAVE_EXECUTED_ONLY_LOCAL_ERROR_HTTP
//      SAVE_EXECUTED_ONLY_LOCAL_TIMEOUT 
//      SAVE_EXECUTED_ONLY_LOCAL_UNKNOWN_ERROR 
//      SAVE_EXECUTED_ONLY_DATABASE            
//      ERROR_SAVING_DATA                       


// --- MENSAJE DE AVISO ---
#define  WARNING_NOT_ADDED                  1   // Aviso: plato no añadido porque está vacío
#define  WARNING_NOT_DELETED                2   // Aviso: plato no borrado porque está vacío
#define  WARNING_NOT_SAVED                  3   // Aviso: comida no guardada porque está vacía
#define  WARNING_RAW_COOKED_NOT_NEEDED      4   // Aviso: no hace falta crudo/cocinado para producto con código de barras
#define  WARNING_BARCODE_NOT_READ           5   // Aviso: código de barras no leído
#define  WARNING_PRODUCT_NOT_FOUND          6   // Aviso: producto no encontrado
#define  WARNING_MEALS_LEFT                 7   // Aviso: algunas comidas no sincronizadas
#define  WARNING_NO_INTERNET_NO_BARCODE     8   // Aviso: no se puede leer barcode porque no hay conexión a internet


// --- MENSAJE DE CANCELACIÓN ---
#define  ACTION_CANCELLED       1   // Acción cancelada (add/delete/save o leer barcode)
#define  PRODUCT_CANCELLED      2   // Producto cancelado (no es el deseado)


// --- MENSAJE DE ERROR ----
#define  ERROR_GENERAL               0   // Mensaje general de error (barcode_read, barcode_search, barcode_check y barcode)
#define  ERROR_STATE_INIT            1
#define  ERROR_STATE_PLATO           2
#define  ERROR_STATE_GROUP           3  
#define  ERROR_STATE_BARCODE         4
#define  ERROR_STATE_PROCESAMIENTO   5  // raw o cooked
#define  ERROR_STATE_WEIGHTED        6
#define  ERROR_STATE_ADD_CHECK       7
#define  ERROR_STATE_ADDED           8
#define  ERROR_STATE_DELETE_CHECK    9
#define  ERROR_STATE_DELETED         10
#define  ERROR_STATE_SAVE_CHECK      11
#define  ERROR_STATE_SAVED           12
#define  ERROR_STATE_CANCEL          13
#define  ERROR_STATE_AVISO           14


// --- BORRADO DE FICHEROS ---
#define  FILES_NOT_DELETED  0
#define  FILES_DELETED      1





// Declaraciones adelantadas para evitar las inclusiones circulares.
void    tareScale();
void    reiniciarPesos();

void    checkMainButton();
void    checkGrandeButton();
void    checkBarcodeButton();
void    checkAllButtons(); 

bool    buttonInterruptOccurred();
bool    mainButtonInterruptOccurred();
bool    grandeButtonInterruptOccurred();
bool    barcodeButtonInterruptOccurred(); 

bool    hasScaleEventOccurred(); 



/**
 * @brief Flag para indicar si se han realizado las actividades del estado.
 */
bool doneState;       // Flag para que solo se realicen una vez las actividades del estado cada vez que se entre al estado, 
                      // pero no en cada iteración del loop de Arduino.


/*----------------------------------------------------------------------------------------------*/
/*-------------------------------------- ESTADOS -----------------------------------------------*/
/*----------------------------------------------------------------------------------------------*/
/**
 * @enum state_t
 * @brief Enumeración de los diferentes estados de la Máquina de Estados.
 */
typedef enum 
{
                STATE_Init              =   (1),    // Estado inicial para colocar plato                                        -->     Estado válido 
                STATE_Plato             =   (2),    // Estado para escoger grupo                                                -->     Estado válido 
                STATE_Grupo             =   (3),    // Grupo alimentos                                                          -->     Estado válido 
                STATE_Barcode_read      =   (4),    // Estado para leer barcode                                                 -->     Estado transitorio
                STATE_Barcode_search    =   (5),    // Estado para buscar información del producto                              -->     Estado transitorio
                STATE_Barcode_check     =   (6),    // Estado para confirmar el producto encontrado                             -->     Estado transitorio
                STATE_Barcode           =   (7),    // Estado para utilizar el producto encontrado como grupo de alimentos      -->     Estado válido 
                STATE_raw               =   (8),    // Estado que indica alimento crudo                                         -->     Estado válido 
                STATE_cooked            =   (9),    // Estado que indica alimento cocinado                                      -->     Estado válido 
                STATE_weighted          =   (10),   // Estado para pesar alimento                                               -->     Estado válido 
                STATE_add_check         =   (11),   // Estado para comprobar que se quiere añadir plato                         -->     Estado transitorio
                STATE_added             =   (12),   // Estado para añadir plato                                                 -->     Estado transitorio
                STATE_delete_check      =   (13),   // Estado para comprobar que se quiere eliminar plato                       -->     Estado transitorio
                STATE_deleted           =   (14),   // Estado para eliminar plato                                               -->     Estado transitorio
                STATE_save_check        =   (15),   // Estado para comprobar que se quiere guardar la comida                    -->     Estado transitorio
                STATE_saved             =   (16),   // Estado para guardar la comida                                            -->     Estado transitorio
                STATE_ERROR             =   (17),   // Estado ficticio de error (acción incorrecta)                             -->     Estado transitorio
                STATE_CANCEL            =   (18),   // Estado ficticio de Cancelación                                           -->     Estado transitorio
                STATE_AVISO             =   (19),   // Estado ficticio de Aviso                                                 -->     Estado transitorio

                #ifdef BORRADO_INFO_USUARIO
                STATE_DELETE_FILES_CHECK    =   (20),   // COMPROBAR QUE SE QUIERE BORRAR LOS FICHEROS. EL USUARIO NO DEBERÍA ACCEDER. SOLO PARA LAS PRUEBAS. -->     Estado transitorio
                STATE_DELETED_FILES         =   (21),   // FICHEROS BORRADOS. EL USUARIO NO DEBERÍA ACCEDER. SOLO PARA LAS PRUEBAS.                          -->     Estado transitorio
                                                      //  --> PARA LIMPIAR EL ACUMULADO DEL DÍA, DEJÁNDOLO LISTO PARA EL SIGUIENTE USUARIO
                #endif

                STATE_CRITIC_FAILURE_SD   =   (22),     // La SD ha fallado en el setup o no se encuentra --> no se permite usar SM                         -->     Estado transitorio
                                                        // Este estado no tiene transiciones de entrada ni de salida. Solo sirve para mostrar
                                                        // la pantalla de fallo crítico. Se entra manualmente por código, no por acciones del usuario.

                STATE_UPLOAD_DATA = (23),       // Hay datos en el fichero data-esp.txt y hay que subirlos a la base de datos.                              -->     Estado transitorio
                                                // Solo se pasaría a este estado al iniciar el dispositivo para guardar la info acumulada en el fichero.
                                                // Se entra manualmente por código, no por acciones del usuario, por eso no tiene transiciones de entrada.
                                                // Sí tiene una transición de salida a Init cuando se suben o no los datos.

                STATE_REMOVAL_CHECK = (24)      // Estado para preguntar qué hacer con el plato retirado sin avisar: guardarlo en la comida para añadir otro o eliminarlo
} state_t;



/*----------------------------------------------------------------------------------------------*/
/*-------------------------------------- EVENTOS -----------------------------------------------*/
/*----------------------------------------------------------------------------------------------*/
/**
 * @enum event_t
 * @brief Enumeración de los diferentes eventos que pueden ocurrir en la Máquina de Estados.
 */
typedef enum 
{
              NONE                              =   (0),    
              TIPO_A                            =   (1),    // Botonera Grande (7,8,9,16,17,18,19)
              TIPO_B                            =   (2),    // Botonera Grande (1,2,3,4,5,6,10,11,12,13,14,15,20)
              BARCODE                           =   (3),    // Botón Barcode
              BARCODE_R                         =   (4),    // Barcode leído
              BARCODE_F                         =   (5),    // Producto encontrado
              CRUDO                             =   (6),    // AMARILLO
              COCINADO                          =   (7),    // BLANCO
              ADD_PLATO                         =   (8),    // VERDE
              DELETE_PLATO                      =   (9),    // ROJO
              GUARDAR                           =   (10),   // NEGRO 
              INCREMENTO                        =   (11),   // Báscula
              DECREMENTO                        =   (12),   // Báscula
              TARAR                             =   (13),   // Báscula tarada
              LIBERAR                           =   (14),   // Báscula vacía real
              ERROR                             =   (15),   // Error (acción incorrecta)
              CANCELAR                          =   (16),   // Cancelar acción de añadir, eliminar o guardar
              AVISO_PLATO_EMPTY_NOT_ADDED       =   (17),   // Aviso de plato vacío, no añadido uno nuevo
              AVISO_PLATO_EMPTY_NOT_DELETED     =   (18),   // Aviso de plato vacío, no borrado
              AVISO_COMIDA_EMPTY_NOT_SAVED      =   (19),   // Aviso de comida vacía, no guardada
              AVISO_NO_WIFI_BARCODE             =   (20),   // Aviso de que no hay conexión a Internet, así que no se podrá buscar el producto
              AVISO_NO_BARCODE                  =   (21),   // Aviso de que no se ha detectado barcode
              AVISO_PRODUCT_NOT_FOUND           =   (22),   // Aviso de que no se ha encontrado el producto en OpenFoodFacts
              GO_TO_INIT                        =   (23),   // Evento ficticio para volver a STATE_Init porque saltó un error, aviso o se canceló una acción (añadir, eliminar o guardar)
              GO_TO_PLATO                       =   (24),   // Evento ficticio para volver a STATE_Plato porque saltó un error 
              GO_TO_GRUPO                       =   (25),   // Evento ficticio para volver a STATE_Grupo porque saltó un error o aviso
              GO_TO_BARCODE_READ                =   (26),   // Evento ficticio para volver a STATE_Barcode_read porque saltó un error o aviso
              GO_TO_BARCODE                     =   (27),   // Evento ficticio para volver a STATE_Barcode porque saltó un error o aviso
              GO_TO_RAW                         =   (28),   // Evento ficticio para volver a STATE_raw porque saltó un error o se canceló una acción (añadir, eliminar o guardar)
              GO_TO_COOKED                      =   (29),   // Evento ficticio para volver a STATE_cooked porque saltó un error o se canceló una acción (añadir, eliminar o guardar)
              GO_TO_WEIGHTED                    =   (30),   // Evento ficticio para volver a STATE_weighted porque saltó un error o se canceló una acción (añadir, eliminar o guardar)
              GO_TO_ADD_CHECK                   =   (31),   // Evento ficticio para volver a STATE_add_check porque saltó un error 
              GO_TO_ADDED                       =   (32),   // Evento ficticio para volver a STATE_added porque saltó un error 
              GO_TO_DELETE_CHECK                =   (33),   // Evento ficticio para volver a STATE_delete_check porque saltó un error 
              GO_TO_DELETED                     =   (34),   // Evento ficticio para volver a STATE_deleted porque saltó un error
              GO_TO_SAVE_CHECK                  =   (35),   // Evento ficticio para volver a STATE_save_check porque saltó un error 
              GO_TO_SAVED                       =   (36),   // Evento ficticio para volver a STATE_saved porque saltó un error 
              GO_TO_CANCEL                      =   (37),   // Evento ficticio para ir a STATE_CANCEL si se cancela una acción iniciada durante un error

              #ifdef BORRADO_INFO_USUARIO
              DELETE_FILES                        =   (38)   // EVENTO PARA BORRAR EL FICHERO CSV. EL USUARIO NO DEBERÍA LLEGAR A ACTIVARLO. SOLO PARA LAS PRUEBAS.
              #endif
} event_t;


/**
 * @brief Buffer para guardar los eventos que ocurren en la Máquina de Estados.
 */
static event_t event_buffer[MAX_EVENTS];       // Buffer de eventos al que se irán añadiendo conforme ocurran
/* Este buffer solo se utiliza para debuggear, para ver qué eventos han ido ocurriendo.
   Para comprobar si se cumple alguna regla de transición se utiliza 'lastEvent', que 
   sería el último evento añadido al buffer.
   
   Se podría eliminar el buffer para evitar ocupar memoria innecesariamente.
*/



/*----------------------------------------------------------------------------------------------*/
/*------------------------------ REGLAS TRANSICION ---------------------------------------------*/
/*----------------------------------------------------------------------------------------------*/
/**
 * @struct transition_rule
 * @brief Estructura que define una regla de transición en la Máquina de Estados.
 */
typedef struct
{
    state_t state_i;     /**< Estado actual */
    state_t state_j;     /**< Estado siguiente */
    event_t condition;    /**< Condición para transición de estado */
}transition_rule;


/**
 * @brief Array de reglas de transición para la Máquina de Estados.
 */
static transition_rule rules[RULES] =  
{                                       // --- Esperando Recipiente ---
                                        {STATE_Init,STATE_Init,TARAR},                  // Tara inicial
                                        {STATE_Init,STATE_Init,DECREMENTO},             // Por si se inicia SM con un recipiente ya puesto y luego se retira
                                        {STATE_Init,STATE_Init,LIBERAR},                // Por si se inicia SM con recipiente puesto, se retira y resulta que pesaba menos de 20 gramos (el umbral)
                                        {STATE_Init,STATE_Plato,INCREMENTO},            // Colocar recipiente
                                        {STATE_Init,STATE_save_check,GUARDAR},          // Guardar comida directamente (comidaActual no está vacía)
                                        {STATE_Init,STATE_ERROR,ERROR},                 // Acción incorrecta
                                        // ----------------------------

                                        // --- Recipiente colocado ---
                                        {STATE_Plato,STATE_Plato,INCREMENTO},           // Cambios por recolocar recipiente
                                        {STATE_Plato,STATE_Plato,DECREMENTO},           // Cambios por recolocar recipiente
                                        {STATE_Plato,STATE_Init,LIBERAR},               // Se ha retirado el recipiente
                                        {STATE_Plato,STATE_Grupo,TIPO_A},               // Escogido grupo de alimentos de tipo A
                                        {STATE_Plato,STATE_Grupo,TIPO_B},               // Escogido grupo de alimentos de tipo B
                                        {STATE_Plato,STATE_Barcode_read,BARCODE},       // Pulsado botón de barcode para iniciar lectura
                                        {STATE_Plato,STATE_Plato,TARAR},
                                        {STATE_Plato,STATE_ERROR,ERROR},                // Acción incorrecta             
                                        // ---------------------------
                                        
                                        // --- Grupo de alimentos ---
                                        //{STATE_Grupo,STATE_Init,LIBERAR},              // Se ha retirado el plato completo (+ recipiente) ==> Automáticamente se borra el plato, sin preguntar
                                        {STATE_Grupo,STATE_REMOVAL_CHECK,LIBERAR},     // Se ha retirado el plato completo (+ recipiente) ==> Preguntar qué hacer
                                        {STATE_Grupo,STATE_Grupo,DECREMENTO},          // Para evitar error de evento cuando pase por condiciones que habilitan DECREMENTO (previo a LIBERAR)
                                        {STATE_Grupo,STATE_Grupo,TARAR},               // Tarar tras colocar recipiente o alimento   
                                        {STATE_Grupo,STATE_Grupo,TIPO_A},              // Otro grupo de tipo A
                                        {STATE_Grupo,STATE_Grupo,TIPO_B},              // Otro grupo de tipo B
                                        {STATE_Grupo,STATE_Barcode_read,BARCODE},      // Pulsado botón de barcode para iniciar lectura
                                        {STATE_Grupo,STATE_raw,CRUDO},                         
                                        {STATE_Grupo,STATE_cooked,COCINADO},              
                                        {STATE_Grupo,STATE_add_check,ADD_PLATO},       // Nuevo plato, aunque no se haya colocado alimento
                                        {STATE_Grupo,STATE_delete_check,DELETE_PLATO}, // Borrar plato actual
                                        {STATE_Grupo,STATE_save_check,GUARDAR},        // Guardar comida, aunque no se haya colocado alimento
                                        {STATE_Grupo,STATE_ERROR,ERROR},               // Acción incorrecta
                                        // --------------------------

                                        // --- Leer Barcode ---------
                                        //{STATE_Barcode_read,STATE_Init,LIBERAR},                // Se ha retirado el plato completo (+ recipiente) ==> Automáticamente se borra el plato, sin preguntar
                                        {STATE_Barcode_read,STATE_REMOVAL_CHECK,LIBERAR},       // Se ha retirado el plato completo (+ recipiente) ==> Preguntar qué hacer
                                        {STATE_Barcode_read,STATE_Barcode_read,DECREMENTO},     // Para evitar error de evento cuando pase por condiciones que habilitan DECREMENTO (previo a LIBERAR)
                                        {STATE_Barcode_read,STATE_Barcode_read,TARAR},          // Tarar tras colocar recipiente o alimento   
                                        {STATE_Barcode_read,STATE_Barcode_search,BARCODE_R},    // Producto detectado y código leído
                                        //{STATE_Barcode_read,STATE_AVISO,AVISO_NO_WIFI_BARCODE}, // Aviso de "No se puede leer barcode porque no hay conexión a Internet"
                                        {STATE_Barcode_read,STATE_AVISO,AVISO_NO_BARCODE},      // Aviso de "Código no detectado" porque no se detecta o porque no responde el ESP32
                                        {STATE_Barcode_read,STATE_CANCEL,TIPO_A},               // Cancelar lectura de barcode pulsando botón de grupo tipoA.
                                        {STATE_Barcode_read,STATE_CANCEL,TIPO_B},               // Cancelar lectura de barcode pulsando botón de grupo tipoB.
                                        {STATE_Barcode_read,STATE_CANCEL,BARCODE},              // Cancelar lectura de barcode pulsando botón de BARCODE
                                        {STATE_Barcode_read,STATE_CANCEL,CRUDO},                // Cancelar lectura de barcode pulsando botón de CRUDO.
                                        {STATE_Barcode_read,STATE_CANCEL,COCINADO},             // Cancelar lectura de barcode pulsando botón de COCINADO.
                                        {STATE_Barcode_read,STATE_CANCEL,ADD_PLATO},            // Cancelar lectura de barcode pulsando botón de AÑADIR PLATO.
                                        {STATE_Barcode_read,STATE_CANCEL,DELETE_PLATO},         // Cancelar lectura de barcode pulsando botón de BORRAR PLATO.
                                        {STATE_Barcode_read,STATE_CANCEL,GUARDAR},              // Cancelar lectura de barcode pulsando botón de GUARDAR.
                                                                                                // No se hace cancelación automática tras 30 segundos porque se asume simplemente que no se ha leído el barcode
                                        {STATE_Barcode_read,STATE_Plato,GO_TO_PLATO},           // Regresar a STATE_Plato si fue lastValidState y no había conexión a Internet, por lo que no se pudo leer barcode.
                                        {STATE_Barcode_read,STATE_Grupo,GO_TO_GRUPO},           // Regresar a STATE_Grupo si fue lastValidState y no había conexión a Internet, por lo que no se pudo leer barcode.
                                        {STATE_Barcode_read,STATE_Barcode,GO_TO_BARCODE},       // Regresar a STATE_Barcode si fue lastValidState y no había conexión a Internet, por lo que no se pudo leer barcode.
                                        {STATE_Barcode_read,STATE_ERROR,ERROR},                 // Acción incorrecta ????? El único error sería poner peso en báscula (Incremento), pero el usuario no debería hacerlo
                                        // --------------------------

                                        // --- Buscar Barcode --------
                                        {STATE_Barcode_search,STATE_Barcode_check,BARCODE_F},       // Producto encontrado
                                        {STATE_Barcode_search,STATE_AVISO,AVISO_PRODUCT_NOT_FOUND}, // Aviso de "Producto no encontrado"
                                        {STATE_Barcode_search,STATE_AVISO,AVISO_NO_WIFI_BARCODE},   // Aviso de "No se puede buscar producto porque no hay conexión a Internet"
                                        //{STATE_Barcode_search,STATE_CANCEL,CANCELAR},             // Cancelar búsqueda de producto por timeout del ESP32
                                        {STATE_Barcode_search,STATE_Plato,GO_TO_PLATO},             // Regresar a STATE_Plato si fue lastValidState y no había conexión a Internet, por lo que no se pudo buscar el producto.
                                        {STATE_Barcode_search,STATE_Grupo,GO_TO_GRUPO},             // Regresar a STATE_Grupo si fue lastValidState y no había conexión a Internet, por lo que no se pudo buscar el producto.
                                        {STATE_Barcode_search,STATE_Barcode,GO_TO_BARCODE},         // Regresar a STATE_Barcode si fue lastValidState y no había conexión a Internet, por lo que no se pudo buscar el producto.
                                        {STATE_Barcode_search,STATE_ERROR,ERROR},                   // Acción incorrecta ????? EL USUARIO NO DEBERÍA HACER NADA MIENTRAS SE BUSCA EL PRODUCTO
                                        // --------------------------

                                        // --- Confirmar producto ---
                                        {STATE_Barcode_check,STATE_Barcode,BARCODE},            // Producto confirmado pulsado botón barcode
                                        {STATE_Barcode_check,STATE_CANCEL,TIPO_A},              // Cancelar producto (no es el desado) pulsando botón de grupo tipoA.
                                        {STATE_Barcode_check,STATE_CANCEL,TIPO_B},              // Cancelar producto (no es el desado) pulsando botón de grupo tipoB.
                                        {STATE_Barcode_check,STATE_CANCEL,CRUDO},               // Cancelar producto (no es el desado) pulsando botón de CRUDO.
                                        {STATE_Barcode_check,STATE_CANCEL,COCINADO},            // Cancelar producto (no es el desado) pulsando botón de COCINADO.
                                        {STATE_Barcode_check,STATE_CANCEL,ADD_PLATO},           // Cancelar producto (no es el desado) pulsando botón de COCINADO.
                                        {STATE_Barcode_check,STATE_CANCEL,DELETE_PLATO},        // Cancelar producto (no es el desado) pulsando botón de BORRAR PLATO.
                                        {STATE_Barcode_check,STATE_CANCEL,GUARDAR},             // Cancelar producto (no es el desado) pulsando botón de GUARDAR.
                                        {STATE_Barcode_check,STATE_CANCEL,CANCELAR},            // Cancelar producto tras 20 segundos de inactividad.
                                        {STATE_Barcode_check,STATE_ERROR,ERROR},                // Acción incorrecta ????? Tocar la báscula (incremento, decremento o liberar) sería error, pero no debería ocurrir
                                        // --------------------------

                                        // --- Grupo Barcode --------
                                        //{STATE_Barcode,STATE_Init,LIBERAR},                 // Se ha retirado el plato completo (+ recipiente) ==> Automáticamente se borra el plato, sin preguntar
                                        {STATE_Barcode,STATE_REMOVAL_CHECK,LIBERAR},        // Se ha retirado el plato completo (+ recipiente) ==> Preguntar qué hacer
                                        {STATE_Barcode,STATE_Barcode,DECREMENTO},           // Para evitar error de evento cuando pase por condiciones que habilitan DECREMENTO (previo a LIBERAR)
                                        {STATE_Barcode,STATE_Grupo,TIPO_A},                 // Cambiar grupo alimentos con TIPO_A
                                        {STATE_Barcode,STATE_Grupo,TIPO_B},                 // Cambiar grupo alimentos con TIPO_B
                                        {STATE_Barcode,STATE_Barcode_read,BARCODE},         // Leer otro barcode (vuelve a comenzar)
                                        {STATE_Barcode,STATE_AVISO,CRUDO},                  // Aviso de "No hace falta crudo" porque el producto no necesita crudo
                                        {STATE_Barcode,STATE_AVISO,COCINADO},               // Aviso de "No hace falta cocinado" porque el producto no necesita cocinado
                                        {STATE_Barcode,STATE_weighted,INCREMENTO},          // Se ha colocado alimento del producto leído
                                        {STATE_Barcode,STATE_add_check,ADD_PLATO},          // Nuevo plato, aunque no se haya colocado alimento
                                        {STATE_Barcode,STATE_delete_check,DELETE_PLATO},    // Borrar plato actual
                                        {STATE_Barcode,STATE_save_check,GUARDAR},           // Guardar comida, aunque no se haya colocado alimento
                                        {STATE_Barcode,STATE_ERROR,ERROR},                  // Acción incorrecta ????? Parece que todas las posibles acciones del usuario están contempladas en las reglas de transición
                                        // --------------------------

                                        // --- Alimento crudo ---
                                        //{STATE_raw,STATE_Init,LIBERAR},                 // Se ha retirado el plato completo (+ recipiente) ==> ¿Habría que borrar y empezar de nuevo?
                                        {STATE_raw,STATE_REMOVAL_CHECK,LIBERAR},        // Se ha retirado el plato completo (+ recipiente) ==> Preguntar qué hacer
                                        {STATE_raw,STATE_raw,DECREMENTO},               // Para evitar error de evento cuando pase por condiciones que habilitan DECREMENTO (previo a LIBERAR)
                                        {STATE_raw,STATE_raw,TARAR},                    // Tarar tras pesar alimento y querer cambiar procesamiento, por lo que se ha debido de guardar el alimento pesado antes de cambiar procesamiento
                                        {STATE_raw,STATE_Grupo,TIPO_A},                 // Cambiar grupo alimentos
                                        {STATE_raw,STATE_Grupo,TIPO_B},                 // Cambiar grupo alimentos
                                        {STATE_raw,STATE_Barcode_read,BARCODE},         // Pulsado botón de barcode para iniciar lectura
                                        {STATE_raw,STATE_raw,CRUDO},                    // Para que no dé error si se vuelve a pulsar 'crudo'.
                                        {STATE_raw,STATE_cooked,COCINADO},              // Cambiar procesamiento (crudo => cocinado).
                                        {STATE_raw,STATE_weighted,INCREMENTO},          // Se ha colocado alimento.
                                        {STATE_raw,STATE_add_check,ADD_PLATO},          // Nuevo plato, aunque no se haya colocado alimento.
                                        {STATE_raw,STATE_delete_check,DELETE_PLATO},    // Borrar plato actual. 
                                        {STATE_raw,STATE_save_check,GUARDAR},           // Guardar comida, aunque no se haya colocado alimento.  
                                        {STATE_raw,STATE_ERROR,ERROR},                  // Acción incorrecta
                                        // -----------------------

                                        // --- Alimento cocinado ---
                                        //{STATE_cooked,STATE_Init,LIBERAR},              // Se ha retirado el plato completo (+ recipiente) ==> ¿Habría que borrar y empezar de nuevo?
                                        {STATE_cooked,STATE_REMOVAL_CHECK,LIBERAR},     // Se ha retirado el plato completo (+ recipiente) ==> Preguntar qué hacer  
                                        {STATE_cooked,STATE_cooked,DECREMENTO},         // Para evitar error de evento cuando pase por condiciones que habilitan DECREMENTO (previo a LIBERAR)
                                        {STATE_cooked,STATE_cooked,TARAR},              // Tarar tras pesar alimento y querer cambiar procesamiento, por lo que se ha debido de guardar el alimento pesado antes de cambiar procesamiento
                                        {STATE_cooked,STATE_Grupo,TIPO_A},              // Cambiar grupo alimentos
                                        {STATE_cooked,STATE_Grupo,TIPO_B},              // Cambiar grupo alimentos
                                        {STATE_cooked,STATE_Barcode_read,BARCODE},      // Pulsado botón de barcode para iniciar lectura
                                        {STATE_cooked,STATE_cooked,COCINADO},           // Para que no dé error si se vuelve a pulsar 'cocinado'.
                                        {STATE_cooked,STATE_raw,CRUDO},                 // Cambiar procesamiento (cocinado => crudo).
                                        {STATE_cooked,STATE_weighted,INCREMENTO},       // Se ha colocado alimento.      
                                        {STATE_cooked,STATE_add_check,ADD_PLATO},       // Nuevo plato, aunque no se haya colocado alimento.
                                        {STATE_cooked,STATE_delete_check,DELETE_PLATO}, // Borrar plato actual. 
                                        {STATE_cooked,STATE_save_check,GUARDAR},        // Guardar comida, aunque no se haya colocado alimento.   
                                        {STATE_cooked,STATE_ERROR,ERROR},               // Acción incorrecta 
                                        // --------------------------

                                        // --- Alimento pesado ---
                                        //{STATE_weighted,STATE_Init,LIBERAR},                // Se ha retirado el plato completo (+ recipiente) ==> ¿Habría que borrar y empezar de nuevo?
                                        {STATE_weighted,STATE_REMOVAL_CHECK,LIBERAR},       // Se ha retirado el plato completo (+ recipiente) ==> Preguntar qué hacer
                                        {STATE_weighted,STATE_weighted,INCREMENTO},         // Se coloca más alimento.  
                                        {STATE_weighted,STATE_weighted,DECREMENTO},         // Se retira alimento.
                                        {STATE_weighted,STATE_Grupo,TIPO_A},                // Escoger nuevo grupo. Se guardará en STATE_Grupo el peso del alimento en báscula.
                                        {STATE_weighted,STATE_Grupo,TIPO_B},                // Escoger nuevo grupo. Se guardará en STATE_Grupo el peso del alimento en báscula.
                                        {STATE_weighted,STATE_raw,CRUDO},                   // Cambiar procesamiento (pesado => crudo).
                                        {STATE_weighted,STATE_cooked,COCINADO},             // Cambiar procesamiento (pesado => cocinado).
                                        {STATE_weighted,STATE_Barcode_read,BARCODE},        // Pulsado botón de barcode para iniciar lectura. Se guardará en STATE_Barcode el peso del alimento en báscula.
                                        {STATE_weighted,STATE_add_check,ADD_PLATO},         // Nuevo plato, aunque no se haya colocado alimento.
                                        {STATE_weighted,STATE_delete_check,DELETE_PLATO},   // Borrar plato actual. 
                                        {STATE_weighted,STATE_save_check,GUARDAR},          // Guardar comida, aunque no se haya colocado alimento. 
                                        {STATE_weighted,STATE_ERROR,ERROR},                 // Acción incorrecta ????? Parece que todas las posibles acciones del usuario están contempladas en las reglas de transición
                                        // -----------------------

                                        // --- Check añadir plato ---
                                        {STATE_add_check,STATE_added,ADD_PLATO},         // Confirmar añadir plato.
                                        {STATE_add_check,STATE_CANCEL,TIPO_A},           // Cancelar añadir plato pulsando botón de grupo tipoA.
                                        {STATE_add_check,STATE_CANCEL,TIPO_B},           // Cancelar añadir plato pulsando botón de grupo tipoB.
                                        {STATE_add_check,STATE_CANCEL,BARCODE},          // Cancelar añadir plato pulsando botón de BARCODE.
                                        {STATE_add_check,STATE_CANCEL,CRUDO},            // Cancelar añadir plato pulsando botón de CRUDO.
                                        {STATE_add_check,STATE_CANCEL,COCINADO},         // Cancelar añadir plato pulsando botón de COCINADO.
                                        {STATE_add_check,STATE_CANCEL,DELETE_PLATO},     // Cancelar añadir plato pulsando botón de BORRAR PLATO.
                                        {STATE_add_check,STATE_CANCEL,GUARDAR},          // Cancelar añadir plato pulsando botón de GUARDAR.
                                        {STATE_add_check,STATE_CANCEL,CANCELAR},         // Cancelar añadir plato tras 10 segundos de inactividad.
                                        {STATE_add_check,STATE_ERROR,ERROR},             // Acción incorrecta (solo salta si se manipula la báscula).
                                        // --------------------------

                                        // --- Plato añadido ---
                                        {STATE_added,STATE_added,TARAR},                        // Taramos para saber (en negativo) cuánto se va quitando al retirar el plato para LIBERAR.
                                        {STATE_added,STATE_added,DECREMENTO},                   // Para evitar error de evento cuando pase por condiciones que habilitan DECREMENTO (previo a LIBERAR).
                                        {STATE_added,STATE_added,INCREMENTO},                   // Para evitar error de evento cuando, al retirar el plato, pueda detectar un ligero incremento.
                                        {STATE_added,STATE_Init,LIBERAR},                       // Se ha retirado el plato completo (+ recipiente) tras añadir uno nuevo.
                                        {STATE_added,STATE_ERROR,ERROR},                        // Acción incorrecta
                                        {STATE_added,STATE_AVISO,AVISO_PLATO_EMPTY_NOT_ADDED},  // No se ha añadido un plato porque el actual está vacío
                                        {STATE_added,STATE_Init,GO_TO_INIT},                    // Se regresa automáticamente a STATE_Init tras añadir el plato post STATE_REMOVAL_CHECK
                                        // ---------------------

                                        // --- Check eliminar plato ---
                                        {STATE_delete_check,STATE_deleted,DELETE_PLATO},    // Confirmar eliminar plato.
                                        {STATE_delete_check,STATE_CANCEL,TIPO_A},           // Cancelar eliminar plato pulsando botón de grupo tipoA.
                                        {STATE_delete_check,STATE_CANCEL,TIPO_B},           // Cancelar eliminar plato pulsando botón de grupo tipoB.
                                        {STATE_delete_check,STATE_CANCEL,BARCODE},          // Cancelar eliminar plato pulsando botón de BARCODE.
                                        {STATE_delete_check,STATE_CANCEL,CRUDO},            // Cancelar eliminar plato pulsando botón de CRUDO.
                                        {STATE_delete_check,STATE_CANCEL,COCINADO},         // Cancelar eliminar plato pulsando botón de COCINADO.
                                        {STATE_delete_check,STATE_CANCEL,ADD_PLATO},        // Cancelar eliminar plato pulsando botón de AÑADIR PLATO.
                                        {STATE_delete_check,STATE_CANCEL,GUARDAR},          // Cancelar eliminar plato pulsando botón de GUARDAR.
                                        {STATE_delete_check,STATE_CANCEL,CANCELAR},         // Cancelar eliminar plato tras 10 segundos de inactividad.
                                        {STATE_delete_check,STATE_ERROR,ERROR},             // Acción incorrecta (solo salta si se manipula la báscula).
                                        // --------------------------

                                        // --- Plato eliminado ---
                                        {STATE_deleted,STATE_deleted,TARAR},                        // Taramos para saber (en negativo) cuánto se va quitando al retirar el plato para LIBERAR.
                                        {STATE_deleted,STATE_deleted,DECREMENTO},                   // Para evitar error de evento cuando pase por condiciones que habilitan DECREMENTO (previo a LIBERAR).
                                        {STATE_deleted,STATE_deleted,INCREMENTO},                   // Para evitar error de evento cuando, al retirar el plato, pueda detectar un ligero incremento.
                                        {STATE_deleted,STATE_Init,LIBERAR},                         // Se ha retirado el plato completo (+ recipiente) tras borrar. 
                                        {STATE_deleted,STATE_ERROR,ERROR},                          // Acción incorrecta
                                        {STATE_deleted,STATE_AVISO,AVISO_PLATO_EMPTY_NOT_DELETED},  // No se ha eliminado el plato porque está vacío
                                        {STATE_deleted,STATE_Init,GO_TO_INIT},                      // Se regresa automáticamente a STATE_Init tras borrar el plato post STATE_REMOVAL_CHECK
                                        // -----------------------

                                        // --- Check guardar comida ---
                                        {STATE_save_check,STATE_saved,GUARDAR},          // Confirmar guardar comida.
                                        {STATE_save_check,STATE_CANCEL,TIPO_A},          // Cancelar guardar comida pulsando botón de grupo tipoA.
                                        {STATE_save_check,STATE_CANCEL,TIPO_B},          // Cancelar guardar comida pulsando botón de grupo tipoB.
                                        {STATE_save_check,STATE_CANCEL,BARCODE},         // Cancelar guardar comida pulsando botón de BARCODE.
                                        {STATE_save_check,STATE_CANCEL,CRUDO},           // Cancelar guardar comida pulsando botón de CRUDO.
                                        {STATE_save_check,STATE_CANCEL,COCINADO},        // Cancelar guardar comida pulsando botón de COCINADO.
                                        {STATE_save_check,STATE_CANCEL,ADD_PLATO},       // Cancelar guardar comida pulsando botón de AÑADIR PLATO.
                                        {STATE_save_check,STATE_CANCEL,DELETE_PLATO},    // Cancelar guardar comida pulsando botón de BORRAR PLATO.
                                        {STATE_save_check,STATE_CANCEL,CANCELAR},        // Cancelar guardar comida tras 10 segundos de inactividad.
                                        {STATE_save_check,STATE_ERROR,ERROR},            // Acción incorrecta (solo salta si se manipula la báscula).
                                        // --------------------------

                                        // --- Comida guardada ---
                                        {STATE_saved,STATE_saved,TARAR},                        // Taramos para saber (en negativo) cuánto se va quitando al retirar el plato para LIBERAR.
                                        {STATE_saved,STATE_saved,DECREMENTO},                   // Para evitar error de evento cuando pase por condiciones que habilitan DECREMENTO (previo a LIBERAR).
                                        {STATE_saved,STATE_saved,INCREMENTO},                   // Para evitar error de evento cuando, al retirar el plato, pueda detectar un ligero incremento.
                                        {STATE_saved,STATE_Init,LIBERAR},                       // Se ha retirado el plato completo (+ recipiente) tras guardar correctamente.  
                                        {STATE_saved,STATE_Init,GO_TO_INIT},                    // Se regresa automáticamente a STATE_Init tras guardar la comida
                                        {STATE_saved,STATE_ERROR,ERROR},                        // Acción incorrecta
                                        {STATE_saved,STATE_AVISO,AVISO_COMIDA_EMPTY_NOT_SAVED}, // No se ha guardado la comida porque está vacía
                                        {STATE_saved, STATE_Init,GO_TO_INIT},                   // Se regresa automáticamente a STATE_Init tras guardar la comida post STATE_REMOVAL_CHECK
                                        // -----------------------


                                        // --- ERROR DE EVENTO ---
                                        {STATE_ERROR,STATE_Init,GO_TO_INIT},                    // Regresar a STATE_Init tras mostrar error cometido allí o tras cometer error una vez retirado el plato sin avisar
                                        {STATE_ERROR,STATE_Plato,GO_TO_PLATO},                  // Regresar a STATE_Plato tras mostrar error cometido allí
                                        {STATE_ERROR,STATE_Grupo,GO_TO_GRUPO},                  // Regresar a STATE_Grupo tras mostrar error cometido allí
                                        {STATE_ERROR,STATE_Barcode_read,GO_TO_BARCODE_READ},    // Regresar a STATE_Barcode_read tras mostrar error cometido allí o en STATE_Grupo pero se pulsa botón de barcode durante error
                                        {STATE_ERROR,STATE_Barcode,GO_TO_BARCODE},              // Regresar a STATE_Barcode tras mostrar error cometido allí
                                        {STATE_ERROR,STATE_raw,GO_TO_RAW},                      // Regresar a STATE_raw tras mostrar error cometido allí
                                        {STATE_ERROR,STATE_cooked,GO_TO_COOKED},                // Regresar a STATE_cooked tras mostrar error cometido allí
                                        {STATE_ERROR,STATE_weighted,GO_TO_WEIGHTED},            // Regresar a STATE_weighted tras mostrar error cometido allí
                                        {STATE_ERROR,STATE_add_check,GO_TO_ADD_CHECK},          // Regresar a STATE_add_check tras mostrar error cometido allí
                                        {STATE_ERROR,STATE_added,GO_TO_ADDED},                  // Regresar a STATE_added tras mostrar error cometido allí
                                        {STATE_ERROR,STATE_delete_check,GO_TO_DELETE_CHECK},    // Regresar a STATE_delete_check tras mostrar error cometido allí
                                        {STATE_ERROR,STATE_deleted,GO_TO_DELETED},              // Regresar a STATE_deleted tras mostrar error cometido allí
                                        {STATE_ERROR,STATE_save_check,GO_TO_SAVE_CHECK},        // Regresar a STATE_save_check tras mostrar error cometido allí
                                        {STATE_ERROR,STATE_saved,GO_TO_SAVED},                  // Regresar a STATE_saved tras mostrar error cometido allí
                                        {STATE_ERROR,STATE_CANCEL,GO_TO_CANCEL},                // Ir a STATE_CANCEL si se ha cancelado un acción iniciada durante error
                                        // -----------------------


                                        // --- CANCELAR ----------
                                        {STATE_CANCEL,STATE_Init,GO_TO_INIT},           // Regresar a STATE_Init tras cancelar acción de guardar iniciada desde STATE_Init
                                        {STATE_CANCEL,STATE_Plato,GO_TO_PLATO},         // Regresar a STATE_Plato tras cancelar acción de leer barcode iniciada desde STATE_Plato
                                        {STATE_CANCEL,STATE_Grupo,GO_TO_GRUPO},         // Regresar a STATE_Grupo tras cancelar add/delete/save o leer barcode iniciada desde STATE_Grupo
                                        {STATE_CANCEL,STATE_Barcode,GO_TO_BARCODE},     // Regresar a STATE_Barcode tras cancelar add/delete/save o leer otro barcode iniciada desde STATE_Barcode
                                        {STATE_CANCEL,STATE_raw,GO_TO_RAW},             // Regresar a STATE_raw tras cancelar add/delete/save o leer barcode iniciada desde STATE_raw   
                                        {STATE_CANCEL,STATE_cooked,GO_TO_COOKED},       // Regresar a STATE_cooked tras cancelar add/delete/save o leer barcode iniciada desde STATE_cooked
                                        {STATE_CANCEL,STATE_weighted,GO_TO_WEIGHTED},   // Regresar a STATE_weighted tras cancelar add/delete/save o leer barcode iniciada desde STATE_weighted
                                        {STATE_CANCEL,STATE_ERROR,ERROR},               // Acción incorrecta. No suele ocurrir, pero si ocurre y no se gestiona, se quedaría 
                                                                                        // en bucle marcando error.    
                                        #ifdef BORRADO_INFO_USUARIO
                                        {STATE_CANCEL,STATE_DELETE_FILES_CHECK,DELETE_FILES},  // INICIAR BORRADO DE FICHEROS USUARIO (se marca DELETE_FILES pulsando botón grupo 1 durante cancelación)
                                        #endif
                                        // -----------------------


                                        // --- AVISO -------------
                                        {STATE_AVISO,STATE_Init,GO_TO_INIT},            // Regresar a Init tras 3 segundos de warning
                                        {STATE_AVISO,STATE_Plato,GO_TO_PLATO},          // Regresar a STATE_Plato tras 3 segundos de warning
                                        {STATE_AVISO,STATE_Grupo,GO_TO_GRUPO},          // Regresar a STATE_Grupo tras 3 segundos de warning
                                        {STATE_AVISO,STATE_Barcode,GO_TO_BARCODE},      // Regresar a GO_TO_BARCODE tras 3 segundos de warning por intentar marcar crudo/cocinado
                                        {STATE_AVISO,STATE_ERROR,ERROR},                // Acción incorrecta durante aviso. Cualquier cosa es acción incorrecta. Igual que en Cancelar.
                                        // -----------------------


                                         // --- CHECK DELETE FILES ---
                                         #ifdef BORRADO_INFO_USUARIO
                                        {STATE_DELETE_FILES_CHECK,STATE_DELETED_FILES,DELETE_FILES},    // CONFIRMAR BORRAR FICHEROS DEL USUARIO (se marca DELETE_FILES pulsando botón grupo 20)
                                        {STATE_DELETE_FILES_CHECK,STATE_CANCEL,TIPO_A},               // Cancelar borrar ficheros del usuario pulsando botón de grupo tipoA.
                                        {STATE_DELETE_FILES_CHECK,STATE_CANCEL,TIPO_B},               // Cancelar borrar ficheros del usuario pulsando botón de grupo tipoB (excepto grupo 20).
                                        {STATE_DELETE_FILES_CHECK,STATE_CANCEL,BARCODE},              // Cancelar borrar ficheros del usuario pulsando botón de BARCODE.
                                        {STATE_DELETE_FILES_CHECK,STATE_CANCEL,CRUDO},                // Cancelar borrar ficheros del usuario pulsando botón de CRUDO.
                                        {STATE_DELETE_FILES_CHECK,STATE_CANCEL,COCINADO},             // Cancelar borrar ficheros del usuario pulsando botón de COCINADO.
                                        {STATE_DELETE_FILES_CHECK,STATE_CANCEL,ADD_PLATO},            // Cancelar borrar ficheros del usuario pulsando botón de AÑADIR PLATO.
                                        {STATE_DELETE_FILES_CHECK,STATE_CANCEL,DELETE_PLATO},         // Cancelar borrar ficheros del usuario pulsando botón de BORRAR PLATO.
                                        {STATE_DELETE_FILES_CHECK,STATE_CANCEL,GUARDAR},              // Cancelar borrar ficheros del usuario pulsando botón de GUARDAR.
                                        {STATE_DELETE_FILES_CHECK,STATE_CANCEL,CANCELAR},             // Cancelar automáticamente el borrar ficheros del usuario tras 5 segundos de inactividad.
                                        // --------------------------

                                        // --- FICHEROS BORRADOS ---
                                        {STATE_DELETED_FILES,STATE_Init,GO_TO_INIT},         // Regresar a STATE_Init tras BORRAR FICHEROS USUARIO (siempre iniciado desde STATE_Init)
                                        #endif // BORRADO_INFO_USUARIO
                                        // ---------------------

                                        // --- UPLOAD DATA TO DATABASE ---
                                        {STATE_UPLOAD_DATA,STATE_Init,GO_TO_INIT},         // Regresar a STATE_Init tras subir o no la info acumulada
                                        // ---------------------
                                      
                                      
                                        // --- RETIRADA DE PLATO IMPREVISTA ---
                                        // Indicar intención: En estos casos, nos saltamos el estado de confirmación (add_check, delete_check o save_check) porque se confirma al pulsar su botón
                                        {STATE_REMOVAL_CHECK,STATE_added,ADD_PLATO},       // Al retirar plato sin avisar se quería "guardar" y añadir otro plato
                                        {STATE_REMOVAL_CHECK,STATE_deleted,DELETE_PLATO},  // Al retirar plato sin avisar se quería borrar el plato retirado
                                        {STATE_REMOVAL_CHECK,STATE_saved,GUARDAR},          // Al retirar plato sin avisar se quería guardar la comida (no suelen hacer esto)
                                        // Borrado automático:
                                        {STATE_REMOVAL_CHECK,STATE_Init,GO_TO_INIT},       // Regresar directamente a STATE_Init tras comprobar no había nada en la comida para "guardar" o eliminar 
                                                                                           // Si pasan 30 segundos sin que indique nada, vamos a STATE_Init asumiendo que se quiere borrar, como antes
                                        // Evitar error de evento si se toca la báscula una vez ya retirado el plato:
                                        {STATE_REMOVAL_CHECK,STATE_REMOVAL_CHECK,DECREMENTO},  // Por si se toca la báscula (que se supone que está vacía) en lugar de indicar la intención al retirar el plato
                                        {STATE_REMOVAL_CHECK,STATE_REMOVAL_CHECK,INCREMENTO},   // Por si se toca la báscula (que se supone que está vacía) en lugar de indicar la intención al retirar el plato
                                        {STATE_REMOVAL_CHECK,STATE_REMOVAL_CHECK,LIBERAR},     // Por si se toca la báscula (que se supone que está vacía) en lugar de indicar la intención al retirar el plato
                                        // Evitar error de evento si algún iluminado pulsa otros botones en lugar de responder:
                                        {STATE_REMOVAL_CHECK,STATE_REMOVAL_CHECK,TIPO_A},      // Por si se pulsa un grupo de TIPO_A en lugar de indicar la intención al retirar el plato
                                        {STATE_REMOVAL_CHECK,STATE_REMOVAL_CHECK,TIPO_B},      // Por si se pulsa un grupo de TIPO_B en lugar de indicar la intención al retirar el plato
                                        {STATE_REMOVAL_CHECK,STATE_REMOVAL_CHECK,BARCODE},     // Por si se pulsa el botón de barcode en lugar de indicar la intención al retirar el plato
                                        {STATE_REMOVAL_CHECK,STATE_REMOVAL_CHECK,CRUDO},       // Por si se pulsa el botón de crudo en lugar de indicar la intención al retirar el plato
                                        {STATE_REMOVAL_CHECK,STATE_REMOVAL_CHECK,COCINADO}    // Por si se pulsa el botón de cocinado en lugar de indicar la intención al retirar el plato
                                        // ------------------------------------
                                      };





/*----------------------------------------------------------------------------------------------*/
/*------------------------------ VARIABLES ESTADOS/EVENTOS -------------------------------------*/
/*----------------------------------------------------------------------------------------------*/

// ---- VARIABLES DE ESTADOS ---------------------------------------------------------
state_t state_actual;          // Estado actual
state_t state_new;             // Nuevo estado al que se va a pasar
state_t state_prev;            // Estado anterior
state_t lastValidState;        // Último estado válido (Init, Plato, Grupo, Barcode, raw, cooked, weighted). Como puntos de retorno (checkpoint) tras error o aviso.
// ------ FIN VARIABLES DE ESTADOS ----------------------------------------------------



// ---- VARIABLES DE EVENTOS ----------------------------------------------------------
event_t lastEvent;          // Último evento ocurrido
event_t eventoMain;         // Evento ocurrido en botonera Main
event_t eventoGrande;       // Evento ocurrido en botonera grande
event_t eventoBascula;      // Evento ocurrido en báscula

bool    flagEvent               = false;    // Para evitar que marque evento para cada interrupción, ya que lo marcaría cada medio segundo
                                            // por la interrupción de la báscula.
                                            // Con esta flag solo se da aviso de un evento real (pulsación, incremento o decremento)

bool    flagError               = false;    // El error es una acción de diferente naturaleza. Es decir, no ocurre un error,
                                            // sino que si ha ocurrido algo que no es evento, se considera error. Por eso se utiliza
                                            // otra flag.

bool    keepErrorScreen         = false;    // Mantener pantalla de error cometido por colocar alimento cuando no toca (desde Grupos).
                                            // En este caso no se retira la pantalla tras 3 segundos, sino que se mantiene hasta que
                                            // se retire el plato para comenzar de nuevo.

bool    showingTemporalScreen   = false;    // Flag para saber que se está mostrando una pantalla temporal o auxiliar

bool    flagComidaSaved         = false;    // Flag para saber que se ha guardado la comida
#ifdef BORRADO_INFO_USUARIO
bool    flagFicherosBorrados   = false;    // Flag para saber que se hna borrado los ficheros del usuario (csv de histórico, txt de comidas pendientes y csv de barcodes)
#endif
bool    flagRecipienteRetirado  = false;    // Flag para saber que se ha retirado el plato completo

bool    plateWasRemovedBeforeAction = false; // Flag para saber que se ha retirado el plato antes de indicar una acción (añadir, borrar o guardar comida)
// ------ FIN VARIABLES DE EVENTOS ----------------------------------------------------


// ------ PROCESAMIENTO ---------------------------------------------------------------
/**
 * @enum procesamiento
 * @brief Enumeración de los diferentes valores del procesamiento del alimento.
 */
typedef enum 
{
              ALIMENTO_CRUDO      =   (1),   /**< Alimento crudo  */
              ALIMENTO_COCINADO   =   (2)    /**< Alimento cocinado  */
} procesado_t;

procesado_t procesamiento; // Solo se utiliza para saber qué icono (crudo o cocinado) mostrar en la zona 2 del dashboard 
// ------ FIN PROCESAMIENTO -----------------------------------------------------------

// ------ CODIGO DE BARRAS -------------------------------------------------------------
// Global para que puedan acceder STATE_Grupo, STATE_Barcode, STATE_added y STATE_saved
String barcode;      // Código de barras leído 
String productInfo;  // Información del producto obtenida de la base de datos
// ------ FIN CODIGO DE BARRAS ---------------------------------------------------------

#if defined(SM_DEBUG)
void printEventName(event_t event);
void printStateName(state_t state);
#endif

#include "Screen.h"   // Debajo de las variables para que estén disponibles en su ámbito




/*----------------------------------------------------------------------------------------------------------------------*/
/*----------------------------------------------------------------------------------------------------------------------*/

/*******************************************************************************
/*******************************************************************************
                          DECLARACIÓN FUNCIONES
/******************************************************************************/
/******************************************************************************/
// --- Reglas transición ---
bool    checkStateConditions();                         // Comprobar reglas de transición de estados

// --- Actividades por estado ---
void    actStateInit();                                 // Actividades STATE_Init
void    actStatePlato();                                // Actividades STATE_Plato
void    actGruposAlimentos();                           // Actividades STATE_Grupo
void    actStateBarcodeRead();                          // Actividades STATE_Barcode_read
void    actStateBarcodeSearch();                        // Actividades STATE_Barcode_search
void    actStateBarcodeCheck();                         // Actividades STATE_Barcode_check
void    actStateBarcode();                              // Actividades STATE_Barcode
void    actStateRaw();                                  // Actividades STATE_raw
void    actStateCooked();                               // Actividades STATE_cooked
void    actStateWeighted();                             // Actividades STATE_weighted
void    actStateAddCheck();                             // Actividades STATE_add_check
void    actStateAdded();                                // Actividades STATE_added
void    actStateDeleteCheck();                          // Actividades STATE_delete_check
void    actStateDeleted();                              // Actividades STATE_deleted
void    actStateSaveCheck();                            // Actividades STATE_save_check
void    actStateSaved();                                // Actividades STATE_saved
void    actStateERROR();                                // Actividades STATE_ERROR
void    actStateCANCEL();                               // Actividades STATE_CANCEL
void    actStateAVISO();                                // Actividades STATE_AVISO

#ifdef BORRADO_INFO_USUARIO
void    actState_DELETE_FILES_CHECK();                    // Actividades STATE_DELETE_FILES_CHECK
void    actState_DELETED_FILES();                         // Actividades STATE_DELETED_FILES
#endif

void    actState_CRITIC_FAILURE_SD();                   // Actividades STATE_CRITIC_FAILURE_SD
void    actState_UPLOAD_DATA();                         // Actividades STATE_UPLOAD_DATA

void    actState_REMOVAL_CHECK();                       // Actividades STATE_REMOVAL_CHECK

// --- Actividades estado actual ---
void    doStateActions();                               // Actividades según estado actual

// --- Error de evento ---
void    actEventError();                                // Mensaje de error de evento según el estado actual

// --- Buffer de eventos ---
bool    isBufferEmpty();                                 // Comprobar buffer de eventos vacío
bool    isBufferFull();                                 // Comprobar buffer de eventos lleno
byte    getFirstGapBuffer();                            // Obtener primer hueco en el buffer
void    shiftLeftEventBuffer();                         // Desplazar buffer a izquierda para incluir nuevo evento
void    addEventToBuffer(event_t evento);               // Añadir evento al buffer
/******************************************************************************/
/******************************************************************************/




/*******************************************************************************
/*******************************************************************************
                           DEFINICIÓN FUNCIONES
/******************************************************************************/
/******************************************************************************/



/*-------------------------------------------------------------------------------------------------------*/
/*---------------------------- NOMBRES DE EVENTOS/ESTADOS -----------------------------------------------*/
/*-------------------------------------------------------------------------------------------------------*/ 

/*---------------------------------------------------------------------------------------------------------
   printEventName(): Imprime el nombre del evento cuyo ID se pasa como argumento
          Parámetros: 
                  event - ID del evento 
----------------------------------------------------------------------------------------------------------*/
#if defined(SM_DEBUG)
void printEventName(event_t event) 
{
    switch (event) 
    {
        case NONE:                              SerialPC.print(F("NONE"));                              break;
        case TIPO_A:                            SerialPC.print(F("TIPO_A"));                            break;
        case TIPO_B:                            SerialPC.print(F("TIPO_B"));                            break;
        case BARCODE:                           SerialPC.print(F("BARCODE"));                           break;
        case BARCODE_R:                         SerialPC.print(F("BARCODE_R"));                         break;
        case BARCODE_F:                         SerialPC.print(F("BARCODE_F"));                         break;
        case CRUDO:                             SerialPC.print(F("CRUDO"));                             break;
        case COCINADO:                          SerialPC.print(F("COCINADO"));                          break;
        case ADD_PLATO:                         SerialPC.print(F("ADD_PLATO"));                         break;
        case DELETE_PLATO:                      SerialPC.print(F("DELETE_PLATO"));                      break;
        case GUARDAR:                           SerialPC.print(F("GUARDAR"));                           break;
        case INCREMENTO:                        SerialPC.print(F("INCREMENTO"));                        break;
        case DECREMENTO:                        SerialPC.print(F("DECREMENTO"));                        break;
        case TARAR:                             SerialPC.print(F("TARAR"));                             break;
        case LIBERAR:                           SerialPC.print(F("LIBERAR"));                           break;
        case ERROR:                             SerialPC.print(F("ERROR"));                             break;
        case CANCELAR:                          SerialPC.print(F("CANCELAR"));                          break;
        case AVISO_PLATO_EMPTY_NOT_ADDED:       SerialPC.print(F("AVISO_PLATO_EMPTY_NOT_ADDED"));       break;
        case AVISO_PLATO_EMPTY_NOT_DELETED:     SerialPC.print(F("AVISO_PLATO_EMPTY_NOT_DELETED"));     break;
        case AVISO_COMIDA_EMPTY_NOT_SAVED:      SerialPC.print(F("AVISO_COMIDA_EMPTY_NOT_SAVED"));      break;
        case AVISO_NO_BARCODE:                  SerialPC.print(F("AVISO_NO_BARCODE"));                  break;
        case AVISO_NO_WIFI_BARCODE:             SerialPC.print(F("AVISO_NO_WIFI_BARCODE"));             break;
        case AVISO_PRODUCT_NOT_FOUND:           SerialPC.print(F("AVISO_PRODUCT_NOT_FOUND"));           break;
        case GO_TO_INIT:                        SerialPC.print(F("GO_TO_INIT"));                        break;
        case GO_TO_PLATO:                       SerialPC.print(F("GO_TO_PLATO"));                       break;
        case GO_TO_GRUPO:                       SerialPC.print(F("GO_TO_GRUPO"));                       break;
        case GO_TO_BARCODE_READ:                SerialPC.print(F("GO_TO_BARCODE_READ"));                break;
        case GO_TO_BARCODE:                     SerialPC.print(F("GO_TO_BARCODE"));                     break;
        case GO_TO_RAW:                         SerialPC.print(F("GO_TO_RAW"));                         break;
        case GO_TO_COOKED:                      SerialPC.print(F("GO_TO_COOKED"));                      break;
        case GO_TO_WEIGHTED:                    SerialPC.print(F("GO_TO_WEIGHTED"));                    break;
        case GO_TO_ADD_CHECK:                   SerialPC.print(F("GO_TO_ADD_CHECK"));                   break;
        case GO_TO_ADDED:                       SerialPC.print(F("GO_TO_ADDED"));                       break;
        case GO_TO_DELETE_CHECK:                SerialPC.print(F("GO_TO_DELETE_CHECK"));                break;
        case GO_TO_DELETED:                     SerialPC.print(F("GO_TO_DELETED"));                     break;
        case GO_TO_SAVE_CHECK:                  SerialPC.print(F("GO_TO_SAVE_CHECK"));                  break;
        case GO_TO_SAVED:                       SerialPC.print(F("GO_TO_SAVED"));                       break;
        case GO_TO_CANCEL:                      SerialPC.print(F("GO_TO_CANCEL"));                      break;

        #ifdef BORRADO_INFO_USUARIO
        case DELETE_FILES:                        SerialPC.print(F("DELETE_FILES"));                        break;
        #endif
        
        default:                                SerialPC.print(F("Evento desconocido"));                break;
    }
}
#endif //SM_DEBUG

/*---------------------------------------------------------------------------------------------------------
   printStateName(): Imprime el nombre del estado cuyo ID se pasa como argumento
          Parámetros: 
                  state - ID del estado 
----------------------------------------------------------------------------------------------------------*/
#if defined(SM_DEBUG)
void printStateName(state_t state) 
{
    switch (state) 
    {
        case STATE_Init:                SerialPC.print(F("STATE_Init"));                 break;
        case STATE_Plato:               SerialPC.print(F("STATE_Plato"));                break;
        case STATE_Grupo:               SerialPC.print(F("STATE_Grupo"));                break;
        case STATE_Barcode_read:        SerialPC.print(F("STATE_Barcode_read"));         break;
        case STATE_Barcode_search:      SerialPC.print(F("STATE_Barcode_search"));       break;
        case STATE_Barcode_check:       SerialPC.print(F("STATE_Barcode_check"));        break;
        case STATE_Barcode:             SerialPC.print(F("STATE_Barcode"));              break;
        case STATE_raw:                 SerialPC.print(F("STATE_raw"));                  break;
        case STATE_cooked:              SerialPC.print(F("STATE_cooked"));               break;
        case STATE_weighted:            SerialPC.print(F("STATE_weighted"));             break;
        case STATE_add_check:           SerialPC.print(F("STATE_add_check"));            break;
        case STATE_added:               SerialPC.print(F("STATE_added"));                break;
        case STATE_delete_check:        SerialPC.print(F("STATE_delete_check"));         break;
        case STATE_deleted:             SerialPC.print(F("STATE_deleted"));              break;
        case STATE_save_check:          SerialPC.print(F("STATE_save_check"));           break;
        case STATE_saved:               SerialPC.print(F("STATE_saved"));                break;
        case STATE_ERROR:               SerialPC.print(F("STATE_ERROR"));                break;
        case STATE_CANCEL:              SerialPC.print(F("STATE_CANCEL"));               break;
        case STATE_AVISO:               SerialPC.print(F("STATE_AVISO"));                break;

        #ifdef BORRADO_INFO_USUARIO
        case STATE_DELETE_FILES_CHECK:    SerialPC.print(F("STATE_DELETE_FILES_CHECK"));     break;
        case STATE_DELETED_FILES:         SerialPC.print(F("STATE_DELETED_FILES"));          break;
        #endif

        case STATE_CRITIC_FAILURE_SD:   SerialPC.print(F("STATE_CRITIC_FAILURE_SD"));    break;
        case STATE_UPLOAD_DATA:         SerialPC.print(F("STATE_UPLOAD_DATA"));          break;

        case STATE_REMOVAL_CHECK:       SerialPC.print(F("STATE_REMOVAL_CHECK"));        break;
        
        default:                        SerialPC.print(state); SerialPC.print(F(" | Estado desconocido"));         break;
    }
}
#endif //SM_DEBUG





/*-------------------------------------------------------------------------------------------------------*/
/*-------------------------------------------------------------------------------------------------------*/
/*-------------------------------------- MOTOR INFERENCIA -----------------------------------------------*/
/*-------------------------------------------------------------------------------------------------------*/ 

/** ---------------------------------------------------------------------------------------------------------
 * @brief checkStateConditions(): Verifica las condiciones de transición de estado en la máquina de estados
 * 
 * Esta función recorre un conjunto de reglas de transición para determinar si 
 * se cumple alguna regla que permita cambiar del estado actual a un nuevo estado.
 * 
 * @return true Si se cumple alguna regla de transición y se actualiza el estado.
 * @return false Si no se cumple ninguna regla de transición, indicando un error de evento.
 * 
 * @note Si el número de reglas (RULES) supera 255, se debe cambiar el tipo de dato 
 *       de la variable de iteración 'i' de byte a int.
 *
---------------------------------------------------------------------------------------------------------*/
bool checkStateConditions()
{
    for (byte i = 0; i < RULES; i++) // Si hay más de 255 reglas, cambiar byte --> int        
    {
        if(rules[i].state_i == state_actual)
        {
            if(rules[i].condition == lastEvent)
            {    
                state_new = rules[i].state_j;     // Nuevo estado
                doneState = false;                // Desactivar flag de haber hecho las actividades del estado
                return true;                        
            }
        }
    }
    return false;   // Si no se ha cumplido ninguna regla de transición ==> ERROR DE EVENTO
}




/*-------------------------------------------------------------------------------------------------------*/
/*-------------------------------------------------------------------------------------------------------*/
/*-------------------------------------- ACCIONES ESTADOS -----------------------------------------------*/
/*-------------------------------------------------------------------------------------------------------*/




/*---------------------------------------------------------------------------------------------------------
   actStateInit(): Acciones del STATE_Init
----------------------------------------------------------------------------------------------------------*/
void actStateInit()
{ 
    // Tiempos utilizados para alternar entre dashboard y pantalla de pedir recipiente:

    const unsigned long recipienteRetiradoInterval  = 1000; // Intervalo de tiempo para mostrar "Recipiente retirado" (1 segundo)
    unsigned long dashboardInterval = 10000;                // Intervalo de tiempo para mostrar el dashboard (10 segundos) 
    const unsigned long recipienteInterval = 5000;          // Intervalo de tiempo para pedir colocar recipiente (5 segundos)
    

    static unsigned long previousTime;              // Variable estática para almacenar el tiempo anterior
    unsigned long currentTime;

    static bool showing_recipiente_retirado;  
    static bool showing_dash;       
    static bool showing_pedir_recipiente;

    
    if(!doneState)
    {
        // ---- TARAR Y REINICIAR PESOS ---------
        tareScale();        // Tarar báscula
        reiniciarPesos();   // Poner a 0 los valores de 'pesoRecipiente'. 'pesoPlato' y 'pesoLastAlimento'.
        // --------------------------------------

        // ---- OPCIÓN 1: SE RETIRÓ EL RECIPIENTE SIN AVISAR -----
        // Si se retiró el recipiente sin avisar y se acaba volviendo a Init, no queremos indicar "Recipiente retirado" 
        // porque ya se ha indicado antes. Solo volvemos a mostrar el dashboard.
        // Estas serían las rutas posibles para esto:
        // 1. Se retira el recipiente sin avisar y se pasan los 30 segundos sin indicar nada. Se elimina automáticamente el plato
        //      y se vuelve a Init.
        //          STATE_REMOVAL_CHECK --> STATE_Init
        // 2. Se retira el recipiente sin avisar y se indica que se quiere añadir otro plato, eliminar el actual o guardar la comida. Después
        //      de realizar la acción escogida, se vuelve a Init.
        //          STATE_REMOVAL_CHECK --> STATE_added/STATE_deleted/STATE_saved --> STATE_Init
        // 3. Se retira el recipiente sin avisar, se indica que se quiere añadir otro plato, eliminar el actual o guardar la comida, y durante
        //      la pantalla de información de acción realizada se comente error. Tras la pantalla de error se regresa a Init.
        //         STATE_REMOVAL_CHECK --> STATE_added/STATE_deleted/STATE_saved --> STATE_ERROR --> STATE_Init
        if(plateWasRemovedBeforeAction)
        {
            flagRecipienteRetirado = false;        // Reiniciar flag de recipiente retirado, marcada al detectar LIBERAR
            plateWasRemovedBeforeAction = false;   // Reiniciar flag de que se ha retirado el plato antes de indicar acción

            showDashboardStyle1(MSG_SIN_RECIPIENTE); // Mostrar dashboard al inicio con mensaje de que falta recipiente
            showing_dash = true;                     // Se está mostrando dashboard estilo 1 (Comida | Acumulado)
            showing_pedir_recipiente = false;   
            showing_recipiente_retirado = false;
        }
        // ------ FIN OPCIÓN 1: SE RETIRÓ EL RECIPIENTE SIN AVISAR --------

        // ---- OPCIÓN 2: SE RETIRÓ EL RECIPIENTE CUANDO CORRESPONDÍA -----
        // Si se retiró el recipiente cuando correspondía (es decir, tras añadir plato, eliminar o guardar comida),
        // entonces se quiere mostrar "Recipiente retirado" y después pasar a dashboard estilo 1.
        //
        // Además, y aunque pueda sonar raro, se comprueba que no se haya retirado el recipiente estado en STATE_Init porque
        // puede darse la siguiente situación:. 
        //      Es posible que se encienda SM con un recipiente ya puesto, por lo que el sistema establecería ese peso
        //      como peso 0 al tarar. Después, se pediría colocar el recipiente y la respuesta más común del usuario
        //      sería retirar el recipiente y volverlo a poner. Por tanto, se ha incluido una regla para volver a 
        //      STATE_Init si se decrementa el peso. También se ha añadido una regla para volver a STATE_Init si se
        //      libera la báscula, evento que se detectaría si el recipiente que se hubiera colocado al encender pesara
        //      menos de 20 gramos (UMBRAL_RECIPIENTE_RETIRADO).
        //
        //      Con esta condición, nos aseguramos que solo se ejecute esta parte (iniciar comida, resetar copia, mostrar dashboard, etc.)
        //      si NO estamos en el caso de haber retirado el recipiente que ya estaba colocado al encender SmartCloth. En ese caso,
        //      solo se haría la tara y se reiniciarían los pesos.
        //
        //      En resumen, si enciende SmartCloth sin recipiente, se harán todas las acciones y pantallas. Pero si resulta
        //      que ya había recipiente al encenderlo y el usuario lo quita para empezar de nuevo, no se volverán a hacer estas acciones. 
        //      Cuando lo coloque de nuevo, ya se pasará a STATE_Plato, que es el que corresponde con el recipiente puesto.
        else if (!((state_prev == STATE_Init) && ((lastEvent == DECREMENTO) || (lastEvent == LIBERAR))))
        { 
            #if defined(SM_DEBUG)
                SerialPC.println(F("\nSTATE_Init...")); 
            #endif

            // ----- INICIAR COMIDA --------------------------------------
            // Comprobar si la lista está vacía para iniciar la comida. 
            // Si no lo está, significa que la comida ya ha comenzado (p.ej. tras added o deleted), 
            // por lo que no hace falta escribirlo de nuevo.
            listaComidaESP32.iniciarComida(); // Tras added o deleted no se inicia comida
            #if defined(SM_DEBUG)
                listaComidaESP32.leerLista();
            #endif
            // -----------------------------------------------------------

            // ----- RESETEAR COPIA SI SE HAN BORRADO FICHEROS -----------
            #ifdef BORRADO_INFO_USUARIO
            if(flagFicherosBorrados)
            {
                comidaActualCopia.restoreComida();   
                flagFicherosBorrados = false;
                flagComidaSaved = false; // Por si he hecho el borrado justo tras guardar
            } 
            #endif
            // -----------------------------------------------------------

        
            keepErrorScreen = false;

            // ----- INFO INICIAL DE PANTALLA -------------------------
            if(flagRecipienteRetirado)
            {
                recipienteRetirado();                 // Mostrar "Recipiente retirado" tras LIBERAR báscula
                showing_recipiente_retirado = true;   // Se está mostrando "Recipiente retirado"
                showing_dash = false;      
                showing_pedir_recipiente = false;

                flagRecipienteRetirado = false;        // Reiniciar flag de recipiente retirado
            }
            else
            { 
                showDashboardStyle1(MSG_SIN_RECIPIENTE); // Mostrar dashboard al inicio con mensaje de que falta recipiente
                showing_dash = true;                     // Se está mostrando dashboard estilo 1 (Comida | Acumulado)
                showing_pedir_recipiente = false;   
                showing_recipiente_retirado = false;
            }
            // ----- FIN INFO INICIAL DE PANTALLA ---------------------
            
            
        }
        // --- FIN OPCIÓN 2: SE RETIRÓ EL RECIPIENTE CUANDO CORRESPONDÍA --


        previousTime = millis();            // Inicializar 'previousTime' para la alternancia de pantallas

        doneState = true;                   // Solo realizar una vez las actividades del estado por cada vez que se active y no
                                            // cada vez que se entre a esta función debido al loop de Arduino.
                                            // Así, debe ocurrir un nuevo evento que lleve a este estado para que se "repitan" las acciones.
    }



    // ----- ALTERNANCIA PANTALLAS -------------------------
    currentTime = millis();
    if(showing_recipiente_retirado) // Mostrando "Recipiente retirado". Solo aparece tras LIBERAR báscula.
    {
        if (currentTime - previousTime >= recipienteRetiradoInterval)  // Si el "Recipiente retirado" ha estado 1 segundo, se cambia a dashboard estilo 1
        {
            previousTime = currentTime;
            showDashboardStyle1(MSG_SIN_RECIPIENTE);
            showing_recipiente_retirado = false; // Dejar de mostrar "Recipiente retirado". Solo aparece tras LIBERAR báscula.
            showing_dash = true;                  // Mostrando dashboard estilo 1 (Comida | Acumulado)
            showing_pedir_recipiente = false;
        }
    }
    else // Ya no se muestra "Recipiente retirado"
    {
        if(showing_dash) // Se está mostrando dashboard estilo 1 (Comida | Acumulado)
        {
            blinkGrupoyProcesamiento(MSG_SIN_RECIPIENTE);
            if(!flagComidaSaved)  // Si no se acaba de guardar comida, se pide colocar recipiente.
            {                     //    Si se acabara de guarda la comida, se dejaría el dashboard estático para que puedan consultar la 
                                  //    información guardada en "Comida guardada".
                if (currentTime - previousTime >= dashboardInterval)  // Si el dashboard ha estado 10 segundos, se cambia a colocar recipiente
                {
                    previousTime = currentTime;
                    pedirRecipiente();
                    showing_dash = false;  
                    showing_pedir_recipiente = true; 
                }
            }
        }
        else if(showing_pedir_recipiente) // Se está mostrando colocar recipiente
        {
            if (currentTime - previousTime >= recipienteInterval)  // Si el colocar recipiente ha estado 5 segundos, se cambia a dashboard estilo 1
            {
                previousTime = currentTime;
                showDashboardStyle1(MSG_SIN_RECIPIENTE);
                showing_dash = true;  // Mostrando dashboard estilo 1 (Comida | Acumulado)
                showing_pedir_recipiente = false;
            }
        }
    }    
    // ----- FIN ALTERNANCIA PANTALLAS ---------------------

} 



/*---------------------------------------------------------------------------------------------------------
   actStatePlato(): Acciones del STATE_Plato
----------------------------------------------------------------------------------------------------------*/
void actStatePlato()
{ 
    // Tiempos utilizados para alternar entre recipiente colocado, dashboard y pantalla de escoger grupo:

    const unsigned long recipienteColocadoInterval  = 1000;   // Intervalo de tiempo para mostrar "Recipiente colocado" (1 segundo)
    const unsigned long dashboardInterval = 3000;             // Intervalo de tiempo para mostrar el dashboard (3 segundos)
    const unsigned long grupoInterval = 5000;                 // Intervalo de tiempo para pedir escoger grupo (5 segundos)
                                                              //      En realidad este grupoInterval no afecta mientras se mantenga por debajo de lo que 
                                                              //      tarda en completarse la pantalla de pedirGrupo. Esta pantalla tarda unos 12 seg,
                                                              //      pero al regresar a actStatePlato() ya habrán pasado los 5 seg de este intervalo.

    static unsigned long previousTime;                        // Variable estática para almacenar el tiempo anterior
    unsigned long currentTime;

    static bool showing_recipiente_colocado;  
    static bool showing_dash;      
    static bool showing_escoger_grupo;

    // El peso definitivo del recipiente no se guarda hasta que se escoja grupo de alimentos.
    // Por eso, 'pesoRecipiente' y 'pesoARetirar' son iguales a 0.0 en este estado. Esto no impide que se
    // realice LIBERAR, ya que ese evento ocurre cuando el peso de la báscula es igual a 'pesoARetirar'. 
    // Así, se puede detectar que se ha quitado el recipiente (bascula = 0.0) y se vuelve al estado STATE_Init.   

    if(!doneState)
    {
        if(state_prev != STATE_Plato)  // Solo hacer esta parte la primera vez que se detecta peso en báscula (plato).
        {                              // Si recoloca, provocando INCREMENTO o DECREMENTO, no hace falta repetir esta parte.
            if(lastValidState == STATE_Init) // Si se viene de Init o a través de un error (se colocó el plato durante el error), realmente se acaba de colocar plato. 
            {                               // Así no se inicia plato en la lista cuando se regrese a STATE_Plato tras error o cancelación
                #if defined(SM_DEBUG)
                    SerialPC.println(F("\nPlato colocado")); 
                #endif

                // ----- INICIAR PLATO --------------------------------------
                // Si lo último escrito no es INICIO-PLATO (la comida está vacía o se está empezando otro plato), 
                // se añade a la lista "INICIO-PLATO"
                listaComidaESP32.iniciarPlato();
                #if defined(SM_DEBUG)
                    listaComidaESP32.leerLista();
                #endif 
                // -----------------------------------------------------------

                // ----- REINICIAR COPIA DE COMIDA GUARDADA -------------------------
                // Si se acaba de guardar la comida, ya se ha mostrado la copia de su info en STATE_Init. Entonces, si la comida real
                // está vacía porque se ha reiniciado tras guardarla, al colocar recipiente se entiende que va a comenzar una nueva,
                // por lo que se debe reiniciar también la copia.
                // De esta forma, si se retira el plato y se regresa a Init, ya no vuelve a aparecer la info de la comida guardada antes, 
                // sino que ya se está haciendo la nueva comida, que aún está a 0.
                // 
                // Si se regresa a STATE_Plato tras aviso pero la comida no está vacía, entonces no hace falta restaurar la copia. En el
                // dashboard se mostrará la info de la comida actual, aún vigente. Por ejemplo, puede ser que se haya escogido y colocado
                // un alimento de grupo y luego se haya querido leer barcode pero finalmente no se ha podido. Entonces, tras saltar aviso
                // de barcode no detectado se regresa a STATE_Plato y se sigue con la comida actual indicando que se escoja grupo, pero aún 
                // se tiene "guardado" el alimento del grupo escogido antes.
                if((comidaActual.isComidaEmpty() == true) and (comidaActualCopia.isComidaEmpty() == false)) comidaActualCopia.restoreComida();   

                if(flagComidaSaved) flagComidaSaved = false;  // Si se había guardado comida, se muestra "Comida guardada" en lugar de "Comida actual" en printZona3()
                                                            // en STATE_Init, por eso ahora se resetea la flag.
                // ----- FIN REINICIAR COPIA DE COMIDA GUARDADA ----------------------

                // ----- INFO INICIAL DE PANTALLA -------------------------
                recipienteColocado();                 // Mostrar "Recipiente colocado" una vez al inicio. No volverlo a mostrar si se comete error en STATE_Plato.
                showing_recipiente_colocado = true;   // Se está mostrando "Recipiente colocado"
                showing_dash = false;      
                showing_escoger_grupo = false;
            }
            else // Una vez colocado el recipiente, mostrar dashboard completo
            {
                // En dahsboard estilo 1 se muestra la info de comida actual en zona 3, pero lo que realmente muestra es la copia de la comida para cuando
                // se guarde la comida y se limpie, que se pueda mostrar la info de la comida guardada (ahora vacía), por eso se hace una copia antes de borrarla.
                // En este STATE_Plato, si se acaba de colocar plato y la comidaActual está vacía porque se ha finalizado (guardado), se reinicia a 0 la copia de esa comida 
                // para comenzar otra comida, por lo que se va a mostrar a 0 la info de la comida en el dashboard.
                // El problema que tiene esto es que si se ha colocado ya un alimento y al colocar el siguiente salta aviso, como que no se haya podido
                // leer el barcode, al venir a STATE_Plato tras el aviso se va a mostrar la info de la comida actual a 0, pero en realidad se tiene "guardado"
                // el alimento puesto anteriormente. Por eso, si no se acaba de colocar el recipiente (ergo no se viene de STATE_Init), debemos trasladar la comida actual
                // a la copia para que se muestre la info correcta en el dashboard (el estilo 1 muestra la info de comidaActualCopia a posta).

                // Lo siguiente solo lo hacemos para que se muestre la info correcta en el dashboard. Internamente, la comida actual tiene toda la información,
                // pero con el dashboard estilo 1 no se muestra si no se copia a la comida copia, lo cual puede llevar a confusión pensando que está vacía
                //if(comidaActual.isComidaEmpty() == false) comidaActualCopia.copyComida(comidaActual); // Copiar comida actual en la copia
                
                showDashboardStyle1(MSG_SIN_GRUPO);   // Mostrar dashboard estilo 1 (Comida | Acumulado) con mensaje de sin grupo
                showing_recipiente_colocado = false;                
                showing_dash = true;                  // Mostrando dashboard estilo 1 (Comida | Acumulado)
                showing_escoger_grupo = false;
            }
            // ----- FIN INFO INICIAL DE PANTALLA ---------------------
        }
        

        previousTime = millis();                              // Inicializar 'previousTime' para la alternancia de pantallas


        doneState = true;                   // Solo realizar una vez las actividades del estado por cada vez que se active y no
                                            // cada vez que se entre a esta función debido al loop de Arduino.
                                            // Así, debe ocurrir un nuevo evento que lleve a este estado para que se "repitan" las acciones.
    }


    // ----- ALTERNANCIA PANTALLAS -------------------------
    currentTime = millis();
    if(showing_recipiente_colocado) // Mostrando "Recipiente colocado". Solo aparece una vez al inicio y si no se viene de error.
    {
        if (currentTime - previousTime >= recipienteColocadoInterval)  // Si el "Recipiente colocado" ha estado 1 segundo, se cambia a dashboard estilo 1
        {
            previousTime = currentTime;
            showDashboardStyle1(MSG_SIN_GRUPO);
            showing_recipiente_colocado = false; // Dejar de mostrar "Recipiente colocado". Solo aparece una vez al inicio.
            showing_dash = true;                  // Mostrando dashboard estilo 1 (Comida | Acumulado)
            showing_escoger_grupo = false;
        }
    }
    else // Ya no se muestra "Recipiente colocado"
    {
        if(showing_dash) // Se está mostrando dashboard estilo 1 (Comida | Acumulado)
        {
            blinkGrupoyProcesamiento(MSG_SIN_GRUPO);
            if (currentTime - previousTime >= dashboardInterval)  // Si el dashboard ha estado 10 segundos, se cambia a escoger grupo
            {
                previousTime = currentTime;
                pedirGrupoAlimentos();
                showing_dash = false;  
                showing_escoger_grupo = true; // Mostrando escoger grupo
            }
        }
        else if(showing_escoger_grupo) // Se está mostrando escoger grupo
        {
            if (currentTime - previousTime >= grupoInterval)  // Si el escoger grupo ha estado 5 segundos, se cambia a dashboard estilo 1
            {
                previousTime = currentTime;
                showDashboardStyle1(MSG_SIN_GRUPO); // Mostrar dashboard estilo 1 (Comida | Acumulado) con mensaje de sin grupo
                showing_dash = true;  // Mostrando dashboard estilo 1 (Comida | Acumulado)
                showing_escoger_grupo = false;
            }
        }
    }    
    // ----- FIN ALTERNANCIA PANTALLAS ---------------------

}


/*---------------------------------------------------------------------------------------------------------
   actGruposAlimentos(): Acciones del STATE_Grupo
----------------------------------------------------------------------------------------------------------*/
void actGruposAlimentos()
{ 

    if(!doneState)
    {      
        // Primera vez que se pulsa un grupo de alimentos
        if(state_prev != STATE_Grupo)   // ==> Si no se viene del propio STATE_Grupo, para evitar que se vuelva a guardar el alimento de la iteración anterior
                                        // en la comida y modificar todo el dashboard, sino solo la parte de ejemplos. 
        {                               // Se vendría de STATE_Grupo si al retirar el plato se detectara DECREMENTO antes de LIBERAR, que ya llevaría a STATE_Init.

            #if defined(SM_DEBUG)
                SerialPC.println(F("\nGrupo de alimentos..."));
            #endif
            
            // ----- ACCIONES PREVIAS ----------------------
            if((lastValidState == STATE_Plato) && (pesoBascula != 0.0)) // Si se acaba de colocar el recipiente. Comprobamos que no sea 0.0 el pesoBascula por si acaso (no debería)
            {
                #if defined(SM_DEBUG)
                    SerialPC.println(F("\nGuardando peso recipiente..."));
                #endif
                pesoRecipiente = pesoBascula;    // Se guarda 'pesoRecipiente' para sumarlo a 'pesoPlato' y saber el 'pesoARetirar'.
                tareScale();                     // Se tara la báscula, preparándola para el primer alimento
            }

            // Se comprueba no venir del propio STATE_Grupo por si se ha retirado el plato, se detecta DECREMENTO (previo a LIBERAR) y se entra 
            // de nuevo en STATE_Grupo, para que no se vuelva a guardar el alimento que ya se guardó en la iteración anterior. Al retirar el plato 
            // se pasa por STATE_Grupo si no se detecta LIBERAR directamente sino que antes se detecta DECREMENTO.
            // Creo que no basta con solo comprobar que pesoBascula != 0.0 porque al retirar el plato el 'pesoBascula' pasará a ser negativo
            // tras haber tarado en la iteración anterior al entrar en STATE_Grupo, por lo que se estaría guardando otra vez el alimento con peso negativo.
            // Lo raro es que hasta ahora (17/09/24) no tenía esta comprobación y parecía funcionar bien, pero por si acaso. 
            //else if ((state_prev != STATE_Grupo) && (pesoBascula != 0.0))
            else if (pesoBascula != 0.0)
            {
                    // ----- AÑADIR ALIMENTO A LISTA -----------------------------
                    if(grupoAnterior.ID_grupo != BARCODE_PRODUCT_INDEX)  // Si el grupo anterior del alimento pesado es de los nuestros, se escribe ALIMENTO,<grupo>,<peso> en la lista, 
                    {                                 // siendo <grupo> el ID de 'grupoAnterior' y <peso> el valor de 'pesoBascula'.
                        listaComidaESP32.addAlimento(grupoAnterior.ID_grupo, pesoBascula);
                    }
                    else  // Si el grupo anterior es un barcode (grupo 50), se escribe ALIMENTO,<grupo>,<peso>,<ean>
                    {
                        listaComidaESP32.addAlimentoBarcode(grupoAnterior.ID_grupo, pesoBascula, barcode);
                    }

                    #if defined(SM_DEBUG)
                        listaComidaESP32.leerLista();
                    #endif 
                    // -----------------------------------------------------------
                    
                    // ----- AÑADIR ALIMENTO A PLATO -----------------------------
                    #if defined(SM_DEBUG)
                        SerialPC.println(F("Añadiendo alimento al plato..."));
                    #endif

                    Alimento alimento(grupoAnterior, pesoBascula);              // Cálculo automático de valores nutricionales.
                                                                                // Al escoger un nuevo grupo se guarda el alimento del grupo anterior
                                                                                // colocado en la báscula en la iteración anterior. Por eso se utiliza 'grupoAnterior' para
                                                                                // crear el alimento, porque 'grupoActual' ya ha tomado el valor del nuevo grupo al pulsar el nuevo botón.
                                                                                // Si el 'grupoAnterior' hubiera sido un barcode, se habrían modificado los valores nutricionales 
                                                                                // del grupo en State_Barcode, por lo que se habrían guardado en 'grupoAnterior' y se usarían aquí.
                                                                
                    platoActual.addAlimentoPlato(alimento);                     // Alimento ==> Plato
                    comidaActual.addAlimentoComida(alimento);                   // Alimento ==> Comida

                    pesoPlato = platoActual.getPesoPlato();                     // Se actualiza el 'pesoPlato' para sumarlo a 'pesoRecipiente' y saber el 'pesoARetirar'.

                    tareScale();                                                // Tras guardar la información del último alimento colocado, se tara la báscula
                                                                                // para pesar el siguiente alimento
                    // -----------------------------------------------------------
            }
            // ----- FIN ACCIONES --------------------------


            // ----- INFO PANTALLA -------------------------
            // Si es la primera vez que se escoge grupo (no se viene de STATE_Grupo), se forma medio Dashboard (ejemplos, parpadeo zona 2 y pedir cr/co)  
            if(showSemiDashboard_PedirProcesamiento()) return;  // Mostrar semi dashboard completo al inicio
                                                                // Si ocurre alguna interrupción mientras se forma el semi dashboard, se sale de la función.
            // ----- FIN INFO DE PANTALLA ------------------


        }// FIN if(state_prev != STATE_Grupo)

        // Se están pulsando grupos para ver sus ejemplos (se viene del mismo STATE_Grupo)
        else 
        {
            // ----- INFO PANTALLA -------------------------
            printGrupoyEjemplos(); // Solo se modifica la zona 1 con los ejemplos del nuevo grupo escogido
            // ----- FIN INFO DE PANTALLA ------------------
        } 

        
        doneState = true;                                                   // Solo realizar una vez las actividades del estado por cada vez que se active y no
                                                                            // cada vez que se entre a esta función debido al loop de Arduino.
                                                                            // Así, debe ocurrir un nuevo evento que lleve a este estado para que se "repitan" las acciones.

    }


    //
    // 1 - La primera vez que se escoge un grupo de alimentos, se forma el semi dashboard completo --> showSemiDashboard_PedirProcesamiento()
    // 2 - Las siguientes veces que se escoge un grupo para ver sus ejemplos, sin pasar por un estado diferente a STATE_Grupo, no se vuelve
    //      a formar el semi dashboard al completo, sino que solo se modifica la zona 1 con el nuevo grupo seleccionado --> printGrupoyEjemplos()
    //
    // En ambos casos anteriores, las zonas 2 y 3-4 presentan movimiento constante. Es decir, la zona 2 parpadea para indicar que no se ha escogido
    // procesamiento (crudo o cocinado) y sobre las zonas 3-4 se muestra una pantalla que pide escoger el procesamiento alternando las imágenes
    // de los botones correspondientes.
    //
    // Por tanto, la creación del semi dashboard completo solo se hace al entrar a STATE_Grupo viniendo de algún estado diferente a ese y la 
    // modificación de la zona 1 con los ejemplos se hace si se viene de STATE_Grupo.
    //
    // Sin embargo, para que los movimientos en las zonas 2 y 3-4 sean fluidos y continuos, las funciones que los realizan se deben llamar en
    // cada ciclo del loop. Estas funciones no realizan esperas bloqueantes (delay) para los parpadeos y alternancias, sino que usan esperas 
    // no bloqueantes y variables 'static' para saber, al volver a entrar en la función, qué fue lo último que se hizo y continuar desde ahí.
    //
    // ----- PANTALLAS CON MOVIMIENTO -------------------------
    blinkGrupoyProcesamiento(NO_MSG);               // Zona 2 - Parpadea (procesamiento sin escoger)
    if(alternateButtonsProcesamiento()) return;     // Zonas 3 y 4 - Alternar botones de crudo y cocinado. Las formas, colores y texto ya están (formGraphicsPedirProcesamiento())
                                                    // Si hay interrupción mientras se alternan botones, se sale de la función --> en loop() se chequea la interrupción.
    // --------------------------------------------------------



}



/*---------------------------------------------------------------------------------------------------------
   actGruposAlimentos(): Acciones del STATE_Barcode_read
----------------------------------------------------------------------------------------------------------*/
void actStateBarcodeRead()
{
    if(!doneState)
    {
        //if(state_prev != STATE_Barcode_read)    // ==> Si no se viene del propio STATE_Barcode_read, para evitar que se vuelva a iniciar el proceso de lectura.
        //{                                       // Se vendría de STATE_Barcode_read si al retirar el plato se detectara DECREMENTO antes de LIBERAR,
                                                // que ya llevaría a STATE_Init

            #if defined(SM_DEBUG)
                SerialPC.println(F("\nPidiendo leer barcode...")); 
            #endif

            // ----- ACCIONES PREVIAS --------------------------------------
            if((lastValidState == STATE_Plato) && (pesoBascula != 0.0)) // Si se acaba de colocar el recipiente. Comprobamos que no sea 0.0 el pesoBascula por si acaso
            {
                #if defined(SM_DEBUG)
                    SerialPC.println(F("\nGuardando peso recipiente..."));
                #endif
                pesoRecipiente = pesoBascula;    // Se guarda 'pesoRecipiente' para sumarlo a 'pesoPlato' y saber el 'pesoARetirar'.
                tareScale();                     // Se tara la báscula, preparándola para el primer alimento
            }

            // Se comprueba no venir del propio STATE_Barcode_read por si se ha retirado el plato, se detecta DECREMENTO (previo a LIBERAR) y se entra de nuevo 
            // en STATE_Barcode_read, para que no se vuelva a guardar el alimento que ya se guardó en la iteración anterior. Al retirar el plato, es posible que
            // se detecte DECREMENTO antes que LIBERAR, por lo que se volvería a entrar a STATE_Barcode_read.
            // Creo que no basta con solo comprobar que pesoBascula != 0.0 porque al retirar el plato el 'pesoBascula' pasará a ser negativo,
            // tras haber tarado en la iteración anterior al entrar en STATE_Barcode_read, por lo que se estaría guardando otra vez el alimento con peso negativo.
            // Lo raro es que hasta ahora (17/09/24) no tenía esta comprobación y parecía funcionar bien, pero por si acaso. 
            //else if ((state_prev != STATE_Barcode_read) && (pesoBascula != 0.0))
            else if (pesoBascula != 0.0)
            {
                    // ----- AÑADIR ALIMENTO A LISTA -----------------------------
                    // En el caso de STATE_group, al escoger nuevo grupo se actualiza automáticamente 'grupoActual' con el nuevo grupo al pulsar el botón correspondiente, por eso 
                    // el alimento pesado antes de escoger grupo se guarda, en ese caso, con 'grupoAnterior'. Sin embargo, en el caso de STATE_Barcode, hasta que no se confirme 
                    // el producto no se actualiza el 'grupoActual', por lo que el alimento pesado antes se puede guardar con 'grupoActual', pues sigue siendo válido.
                    
                    // Usamos 'grupoActual' porque aún no se ha actualizado
                    if(grupoActual.ID_grupo != BARCODE_PRODUCT_INDEX) // Si el grupo anterior del alimento pesado es de los nuestros, se escribe ALIMENTO,<grupo>,<peso> en la lista, 
                    {                                                 // siendo <grupo> el ID de 'grupoActual' y <peso> el valor de 'pesoBascula'.
                        listaComidaESP32.addAlimento(grupoActual.ID_grupo, pesoBascula);
                    }
                    else  // Si el grupo anterior es un barcode (grupo 50), se escribe ALIMENTO,<grupo>,<peso>,<ean>
                    {
                        listaComidaESP32.addAlimentoBarcode(grupoActual.ID_grupo, pesoBascula, barcode);
                    }

                    #if defined(SM_DEBUG)
                        listaComidaESP32.leerLista();
                    #endif 
                    // -----------------------------------------------------------
                    
                    // ----- AÑADIR ALIMENTO A PLATO -----------------------------
                    #if defined(SM_DEBUG)
                        SerialPC.println(F("Añadiendo alimento al plato..."));
                    #endif

                    Alimento alimento(grupoActual, pesoBascula);              // Cálculo automático de valores nutricionales.
                                                                            // Usamos 'grupoActual' porque aún no se ha actualizado
                                                                
                    platoActual.addAlimentoPlato(alimento);                     // Alimento ==> Plato
                    comidaActual.addAlimentoComida(alimento);                   // Alimento ==> Comida

                    pesoPlato = platoActual.getPesoPlato();                     // Se actualiza el 'pesoPlato' para sumarlo a 'pesoRecipiente' y saber el 'pesoARetirar'.

                    tareScale();                                                // Tras guardar la información del último alimento colocado, se tara la báscula
                                                                                // para pesar el siguiente alimento
                    // -----------------------------------------------------------
            }
            // ----- FIN ACCIONES PREVIAS -----------------------------




            // ----- ACCIONES PRINCIPALES Y PANTALLAS -----------------
            // ----- INFO DE PANTALLA -------------------------
            showScanningBarcode();                                   // Mostrar "Escaneando código de barras..."
            // ----- FIN INFO DE PANTALLA ---------------------

            // ----- LEER BARCODE -----------------------------
            byte resultFromReadingBarcode = askForBarcode(barcode);  // Pedir código de barras. Se va a quedar aquí hasta 10.5 segundos esperando respuesta del ESP32.

            switch(resultFromReadingBarcode)
            {
                // --- BARCODE LEÍDO -----------
                case BARCODE_READ: // Si se ha leído el barcode, pasar a STATE_Barcode_search (evento BARCODE_R) para buscar su información
                                    #if defined(SM_DEBUG)
                                        SerialPC.println(F("\nBarcode leido. Pasando a STATE_Barcode_search..."));
                                    #endif
                                    addEventToBuffer(BARCODE_R);    break; 
                // -----------------------------

                // -- AVISO: BARCODE NO LEÍDO --
                case BARCODE_NOT_READ: // Si no se ha leído el barcode, STATE_AVISO para mostrar el mensaje "Código de barras no detectado"
                                    #if defined(SM_DEBUG)
                                        SerialPC.println(F("\nNo se ha detectado un barcode. Pasando a STATE_AVISO..."));
                                    #endif
                                    addEventToBuffer(AVISO_NO_BARCODE);        break;
                // -----------------------------

                // -- INTERRUPCIÓN (CANCELAR) --
                case INTERRUPTION: // Cancelación de la lectura del barcode por parte del usuario
                                    #if defined(SM_DEBUG)
                                        SerialPC.println(F("\nInterrupción. Cancelando lectura de barcode..."));
                                    #endif
                                    // En las reglas de transición ya se pasa a STATE_CANCEL al detectar algún evento de usuario (botoneras) en este estado
                                    // No hace falta marcar aquí el evento manualmente.
                                                                    break;
                // ----------------------------

                // -- TIMEOUT O DESCONOCIDO ---
                default: // TIMEOUT o UNKNOWN_ERROR
                                    #if defined(SM_DEBUG)
                                        SerialPC.println(F("\nTimeout o Desconocido, asumimos barcode no leido. Pasando a STATE_AVISO..."));
                                    #endif
                                    addEventToBuffer(AVISO_NO_BARCODE);        break;
                // ----------------------------
            }

            flagEvent = true; // Marcar flag de evento para que se compruebe en loop() y se realice la transición
            
            // ----- FIN LEER BARCODE -------------------------
            // --------------------------------------------------------


        //} // FIN if(state_prev != STATE_Barcode_read)

        
        doneState = true;                                                   // Solo realizar una vez las actividades del estado por cada vez que se active y no
                                                                            // cada vez que se entre a esta función debido al loop de Arduino.
                                                                            // Así, debe ocurrir un nuevo evento que lleve a este estado para que se "repitan" las acciones.
    }


}


/*---------------------------------------------------------------------------------------------------------
   actGruposAlimentos(): Acciones del STATE_Barcode_search
----------------------------------------------------------------------------------------------------------*/
void actStateBarcodeSearch()
{
    if(!doneState)
    {
        #if defined(SM_DEBUG)
            SerialPC.println(F("\nBarcode leido, buscando producto...")); 
        #endif


        // ----- ACCIONES PRINCIPALES Y PANTALLAS -----------------

        // ----- INFO DE PANTALLA -------------------------
        showSearchingProductInfo();                              // Mostrar "Buscando información del producto..."
        delay(500);                                             // Esperar 0.5 segundos para que se muestre el mensaje
        // ----- FIN INFO DE PANTALLA ---------------------
        
        // --- COMPROBAR SI ES UN PRODUCTO RECURRENTE -----
        // Primero miramos en el CSV (productos barcode) por si el producto leído es recurrente (si se ha leído antes).
        // Si no lo es, entonces se indicará al ESP32 que lo busque en OpenFoodFacts.

        // ----- PRODUCTO RECURRENTE --------
        if(searchBarcodeInProductsFile(barcode, productInfo)) // Buscar en CSV (producto barcode) si el barcode ya se ha leído antes
        {
            #if defined (SM_DEBUG)
                SerialPC.println(F("\nPRODUCTO RECURRENTE"));
                SerialPC.println("\nInformacion del producto: " + productInfo);
                SerialPC.print(F("\nProducto encontrado. Pasando a STATE_Barcode_check..."));
            #endif
            addEventToBuffer(BARCODE_F);
            flagEvent = true; // Marcar flag de evento para que se compruebe en loop() y se realice la transición

        }
        // ----- FIN PRODUCTO RECURRENTE ----

        // ----- PRODUCTO NUEVO -------------
        else // Si no se ha encontrado el producto en SD, buscarlo en OpenFoodFacts
        {
            #if defined (SM_DEBUG)
                SerialPC.println(F("\nPRODUCTO NUEVO"));
                SerialPC.println(F("\nBuscando info del producto en OpenFoodFacts...\n"));
            #endif

            // --- COMPROBAR SI HAY CONEXIÓN A INTERNET -----
            // --- HAY INTERNET ---
            if(checkWifiConnection()) // Hay WiFi
            {
                // ----- BUSCAR PRODUCTO -----------------------------
                byte resultFromGettingProductInfo = getProductInfo(barcode, productInfo); // Buscar info del producto en OpenFoodFacts en guardarla en 'productInfo'. 
                                                                                        // Se va a quedar aquí hasta 10.5 segundos esperando respuesta del ESP32.
                switch(resultFromGettingProductInfo)
                {
                    // --- PRODUCTO ENCONTRADO --------------
                    case PRODUCT_FOUND: // Si se ha encontrado el producto, pasar a STATE_Barcode_check (evento BARCODE_F) para confirmar el producto
                                        #if defined(SM_DEBUG)
                                            SerialPC.print(F("\nProducto encontrado. Pasando a STATE_Barcode_check..."));
                                        #endif
                                        addEventToBuffer(BARCODE_F);    break; 
                    // --------------------------------------

                    // --- AVISO: PRODUCTO NO ENCONTRADO ----
                    case PRODUCT_NOT_FOUND: // Si no se ha encontrado el producto, pasar a STATE_AVISO para mostrar el mensaje "Producto no encontrado"
                                        #if defined(SM_DEBUG)
                                            SerialPC.print(F("\nProducto no encontrado. Pasando a STATE_AVISO..."));
                                        #endif
                                        addEventToBuffer(AVISO_PRODUCT_NOT_FOUND);        break;
                    // --------------------------------------

                    // -- AVISO: TIMEOUT O DESCONOCIDO ------
                    default: // TIMEOUT, PRODUCT_TIMEOUT, HTTP_ERROR o UNKNOWN_ERROR
                                        #if defined(SM_DEBUG)
                                            SerialPC.print(F("\nTimeout o Desconocido, asumimos producto no encontrado. Pasando a STATE_AVISO..."));
                                        #endif
                                        addEventToBuffer(AVISO_PRODUCT_NOT_FOUND);        break;
                    // -------------------------------------
                }

                flagEvent = true; // Marcar flag de evento para que se compruebe en loop() y se realice la transición
                
                // ----- FIN LEER BARCODE -------------------------

            }
            // --- FIN HAY INTERNET --

            // --- NO HAY INTERNET ---
            else // Si el ESP32 está desconectado, no hay WiFi o TIMEOUT, se vuelve a STATE_Plato, STATE_Grupo o STATE_Barcode
            {

                #if defined(SM_DEBUG)
                    SerialPC.println(F("No se procede a buscar producto porque ESP32 esta desconectado o no tiene WiFi. Pasando a STATE_AVISO..."));
                #endif
                addEventToBuffer(AVISO_NO_WIFI_BARCODE);   
                flagEvent = true; // Marcar flag de evento para que se compruebe en loop() y se realice la transición    
            }
            // --- FIN NO HAY INTERNET ---
            // ---- FIN CHEQUEO INTERNET --------------------
        }
        // ----- FIN PRODUCTO NUEVO ---------
        // --- FIN CHEQUEO PRODUCTO RECURRENTE ------------

        // --------------------------------------------------------


        doneState = true;                                                   // Solo realizar una vez las actividades del estado por cada vez que se active y no
                                                                            // cada vez que se entre a esta función debido al loop de Arduino.
                                                                            // Así, debe ocurrir un nuevo evento que lleve a este estado para que se "repitan" las acciones.
    }

}
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
