i62caroi/SmartCloth/v2.1 - src/smartcloth_v2/Screen.h

/** 
 * @file Screen.h
 * @brief Módulo Tarjeta SD
 * 
 * @author Irene Casares Rodríguez
 * @date 05/02/24
 * @version 1.0
 *
 * Modelo pantalla: ER-TFTM070-6 de BuyDisplay [1] (SPI 7"TFT LCD Dislay 1024x600 OPTL Capacitive Touch Screen)
 * @see https://www.buydisplay.com/spi-7-inch-tft-lcd-dislay-module-1024x600-ra8876-optl-touch-screen-panel 
 */

/*
 
  ------ ESPECIFICACIONES BASE --------------
   * 1024x600 (7") TFT LCD
 	 * Pantalla táctil capacitiva
   * Comunicación SPI
  -------------------------------------------
 
  ------ FLASH ------------------------------
   * No tiene memoria Flash externa!!!
  -------------------------------------------
 
  ------ CHIP GRÁFICO ---------------------------------------------------------------------------
   * Chip gráfico RA8876L4N. Este es una verión más reciente y mejorada del controlador RA8876 [2].  
      Algunas de las mejoras incluyen:
 
   		1 - Mejor rendimiento: El RA8876L4N puede ofrecer una mayor velocidad de actualización de 
   			  la pantalla y un rendimiento mejorado en términos de respuesta y procesamiento de gráficos.
 
 		  2 - Mayor resolución: El RA8876L4N es compatible con una resolución de pantalla más alta, 
 			    lo que permite una mayor densidad de píxeles y una calidad de imagen mejorada.
 
 		  3 - Funcionalidad adicional: El RA8876L4N puede ofrecer nuevas características y funcionalidades, 
 			    como la capacidad de soportar más colores, una mayor cantidad de capas gráficas superpuestas y 
 			    mejoras en la administración de energía.
  -----------------------------------------------------------------------------------------------
 
  -------- MEMORIA SDRAM  -----------------------------------------------------------------------
   * Memoria SDRAM tipo W9812G6KH-6 [3]:
 	  		- 2 M words x 4 banks x 16 bits (128 Mbits)
 	  		- 166 MHz de frecuencia de reloj
 	  		- modo auto-refresh
 	  		- 64 ms de tiempo de refresh
 	  		- CAS Latency: 2 y 3
 	  		- Velocidad de acceso CL3 (3 ciclos de reloj)
         - Row address: A0-A11
 	  		- Column address: A0-A8
 
  	  Esto se corresponde con los siguientes valores de Datasheet 8.1.2 SDRAM Connection del RA8876:
         Density: 128 Mb (4 banks) 
         Addressing => row: [A0-A11]
                    => column: [A0-A8]  
        
     En la ra8876SdramInitial() de RA8876_Lite no aparece esta SDRAM como opción, pero sí la W9812G6JH. La principal 
     diferencia entre la W9812G6JH y la W9812G6KH-6 es la velocidad de acceso y el tiempo de ciclo de reloj, siendo 
     la W9812G6JH más rápida en esos términos.
  ------------------------------------------------------------------------------------------------
 
  -------------- FUENTES INTERNAS -----------------------------------------------------------------
   * El chip RA8876 tiene una fuente interna de ancho fijo disponible en tres tamaños:
      RA8876_FONT_SIZE_16    =>  8x16
      RA8876_FONT_SIZE_24    =>  12x24
      RA8876_FONT_SIZE_32    =>  16x32
    
    Estos tamaños se pueden variar escalando hasta 4 veces la anchura (W) y la altura (H),
    independientemente (p.ej. W x2 y H x3):
      Escala x1 (sin escala) =>  RA8876_TEXT_W_SCALE_X1 | RA8876_TEXT_H_SCALE_X1
      Escala x2              =>  RA8876_TEXT_W_SCALE_X2 | RA8876_TEXT_H_SCALE_X2
      Escala x3              =>  RA8876_TEXT_W_SCALE_X3 | RA8876_TEXT_H_SCALE_X3
      Escala x4              =>  RA8876_TEXT_W_SCALE_X4 | RA8876_TEXT_H_SCALE_X4
 
  ------------------------------------------------------------------------------------------------

  -------- MEMORIA ROM FUENTES EXTERNAS  ----------------------------------------------------------------
    * Memoria ROM de fuentes externas GT30L16U2W de Genitop. El número de modelo 
      sigue el siguiente formato: GT-pp-L-hh-c-b-a

        · pp => tipo de empaquetado (20 = SOT23-6, 21 = SOP-8, 30 = SOP-8-B)
        · L  => bajo voltaje (3.3V)
        · hh => altura de la fuente más alta incluida 
        · c  => set de caracteres más prominente (S = GB2312, M = GB18030, U = Unicode, 
            T = BIG5, F = Foreign Unicode and ISO-8859)
        · b  => número de bloques de librerías 
        · a  => character arrangement

	    Por tanto, la GT30L16U2W trabaja a 3.3V, permite una altura máxima de 16 pixeles y 
	    el set de caracteres más prominente es UNICODE, entre otras características.

      --- FUENTES QUE EL RA8876 PUEDE USAR DESDE ESTE CHIP [4] (Datasheet RA8876 14.2.2 GT30L16U2W) -----

      Nota: la columna "Range" solo proporciona el carácter mínimo y máximo admitido. 
      No todos los caracteres dentro del rango indicado estarán necesariamente disponibles.

        -----------------------------------------------------------------------
        |   Note    |  Family	|   Width  |  Height |	Encoding  | Range (hex) |
        -----------------------------------------------------------------------
        |	    -     |  FIXED	|    8	   |	  16	 |	 ASCII	  |  20-7F  	  |
        |	    -	    |  FIXED	|   15	   |    16	 |	UNICODE	  |     ?			  |
        |	Latin	    |  FIXED	|    8	   |    16	 |	UNICODE	  |  00A0-0217  |
        |	Greek	    |  FIXED	|    8	   |    16	 |	UNICODE	  |  0370-03CF	|
        |	Cyrillic  |  FIXED	|    8	   |    16	 |	UNICODE	  |  0400-04F9	|
        |	    -	    |  ARIAL	|  varies  |	  16	 |	ASCII	    |  20-7F	  	|
        |	Latin	    |  ARIAL	|  varies  |    16	 |	UNICODE	  |  00A0-0217	|
        |	Greek	    |  ARIAL	|  varies  |    16	 |	UNICODE	  |  0370-03CF	|
        |	Cyrillic  |  ARIAL	|  varies  |    16	 |	UNICODE	  |  0400-04F9	|
        |	Arabian	  |  ARIAL	|  varies  |    16	 |	UNICODE	  |  0600-06F9	|
        |	Arabian   |  ARIAL	|  varies  |    16	 |	  ?		    |  B000-B1F1	|
        |     -     |  TIMES	|  varies  |    16	 |	ASCII	    |  20-7F		  |
        |	Symbol    |    ?	  |    8	   |	  16	 |	GB2312	  |  ACA1-ACDF	|
        -----------------------------------------------------------------------

  ------------------------------------------------------------------------------------------------------

  ------------- CONCLUSIÓN USO DE FUENTES INTERNAS/EXTERNAS --------------------------------------
    	>> Interna -> Texto de 8x16/12x24/16x32, escalándolo hasta 4 veces. ==> MEJOR OPCIÓN
    	>> Externa -> Texto de 8x16/15x16, escalándolo hasta 4 veces. ==> SE PIXELA DEMASIADO
  ------------------------------------------------------------------------------------------------


  [1] Pantalla ER-TFTM070-6: https://www.buydisplay.com/spi-7-inch-tft-lcd-dislay-module-1024x600-ra8876-optl-touch-screen-panel

  [2] Chip RA8876: https://www.raio.com.tw/data_raio/Datasheet/RA887677/RA8876_Brief_DS_V11_Eng.pdf
  
  [3] SDRAM W9812G6KH-6: https://www.mouser.es/datasheet/2/949/w9812g6kh_a05_20170222-1489666.pdf

  [4] Fuentes ROM GT30L16U2W: https://github.com/xlatb/ra8876/wiki/Font-ROM-GT30L16U2W

  



  ------------------------------------------------------------------------------------------------------------
  --------- CONEXIÓN TFT/LCD CON ARDUINO DUE -----------------------------------------------------------------

  Alimentación y referencia a tierra de la TFT: 
    (pines de conexión en el JP1 de la TFT)
                      ---------------------------------
                      |           TFT (JP1)           |
      -------------------------------------------------
      |  VDD (3.3 V)  |  pines 3, 4, 37 y 38          |   (rojo)
      |  GND          |  pines 1, 2, 13, 31, 39 y 40  |   (negro)
      -------------------------------------------------
  

  TFT conectada al bus SPI del Arduino de la siguiente forma:
    (pines de conexión en el JP1 de la TFT)
      ---------------------------------------------------------
      |  SPI  |       TFT (JP1)     |       Arduino Due       |
      ---------------------------------------------------------
      |  MOSI |    pin 7 (marron)   |      pin 4 (SPI)        |    
      |  MISO |    pin 6 (naranja)  |      pin 1 (SPI)        |
      |  CLK  |    pin 8 (blanco)   |      pin 3 (SPI)        |
      |  CS   |    pin 5 (morado)   |   pin 12 (digital PWM)  | 
      ---------------------------------------------------------

  Otras conexiones de la TFT al Arduino:
    (pines de conexión en el JP1 de la TFT)
      ----------------------------------------------------------------------
      |              TFT (JP1)                    |      Arduino Due       |
      ----------------------------------------------------------------------
      |  pin 11 (Reset) (2º naranja)              |  pin 11 (digital PWM)  |
      |  pin 14 (Backlight) (2º blanco moraito)   |  pin 10 (digital PWM)  |
      ----------------------------------------------------------------------

----------------------------------------------------------------------------------------------------------------------
*/


#ifndef SCREEN_H
#define SCREEN_H

#include "debug.h" // SM_DEBUG --> SerialPC

bool    eventOccurred(); // Comprobar si ha habido interrupciones de botoneras o eventos de báscula

#include "ISR.h" 
#include "RA8876_v2.h" // COLORS.h
#include "State_Machine.h"  // Incluye SD_functions.h (Serial_functions.h)


/* Screen circuit wiring */
#define RA8876_CS        12 
#define RA8876_RESET     11
#define RA8876_BACKLIGHT 10 


#define   MARGEN_IZQ       25
#define   MARGEN_IZQ_ACC   550 //Margen izquierdo del bloque de valores del acumulado de hoy

// ZONA 3 --> copia de la comida o alimento actual
#define   SHOW_COMIDA_ACTUAL_ZONA3    0   // Mostrar la comida actual (copia) en la zona 3
#define   SHOW_ALIMENTO_ACTUAL_ZONA3  1   // Mostrar el alimento actual en la zona 3

// ZONA 4 --> comida actual o acumulado
#define   SHOW_COMIDA_ACTUAL_ZONA4    0   // Mostrar la comida actual (real) en la zona 4
#define   SHOW_ACUMULADO_HOY_ZONA4    1   // Mostrar el acumulado del día en la zona 4

// Ubicación valores según zona
#define   SHOW_VALORES_ZONA3         0   // Ubicacion en zona 3 de los valores en showValores()
#define   SHOW_VALORES_ZONA4         1   // Ubicacion en zona 4 de las valores en showValores()

// Ubicación raciones según zona
#define   SHOW_RACIONES_ZONA3         0   // Ubicacion en zona 3 de las raciones en showRaciones()
#define   SHOW_RACIONES_ZONA4         1   // Ubicacion en zona 4 de las raciones en showRaciones()

// Lenta aparición de imágenes: 
#define   SLOW_APPEAR_COCINADO                  1
#define   SLOW_APPEAR_SCALE                     2
#define   SLOW_APPEAR_GRUPO1                    3
#define   SLOW_APPEAR_GRUPO2                    4
#define   SLOW_APPEAR_GRUPO3                    5
#define   SLOW_APPEAR_GRUPO4                    6
#define   SLOW_APPEAR_SCALE_SUGERENCIA          7
#define   SLOW_APPEAR_GRUPO1_SUGERENCIA         8
#define   SLOW_APPEAR_ANADIR_SUGERENCIA         9
#define   SLOW_APPEAR_BORRAR_SUGERENCIA         10
#define   SLOW_APPEAR_GUARDAR_SUGERENCIA        11
#define   SLOW_APPEAR_ANADIR_SUDDEN_REMOVAL     12
#define   SLOW_APPEAR_BORRAR_SUDDEN_REMOVAL     13
#define   SLOW_APPEAR_GUARDAR_SUDDEN_REMOVAL    14

// Lenta aparición/desaparición de imágenes:
#define   SLOW_DISAPPEAR_CRUDO_APPEAR_COCINADO  1   // Desaparecer crudoGra y aparecer cociGra 
#define   SLOW_DISAPPEAR_COCINADO_APPEAR_CRUDO  2   // Desaparecer cociGra y aparecer crudoGra

// Movimiento de mano y pulsación botones:
#define   MANO_Y_PULSACION_ANADIR     1
#define   MANO_Y_PULSACION_ELIMINAR   2
#define   MANO_Y_PULSACION_GUARDAR    3
#define   MANO_Y_PULSACION_GRUPOS     4  


// --- MENSAJE DE GUARDADO ---
#define  SAVING_ONLY_LOCAL          1   // Solo se puede guardar localmente porque no hay conexión a internet
#define  SAVING_LOCAL_AND_DATABASE  2   // Guardado completo: local y en la database



// Screen object 
RA8876 tft = RA8876(RA8876_CS, RA8876_RESET);

//int SCREEN_WIDTH; // X (1024)
//int SCREEN_HEIGHT; // Y (600)

#define SCREEN_WIDTH 1024
#define SCREEN_HEIGHT 600




/*******************************************************************************
/*******************************************************************************
                          DECLARACIÓN FUNCIONES
/******************************************************************************/
/******************************************************************************/
// --- INICIALIZACIÓN ---
void    setupScreen();                    // Inicializar pantalla
void    welcome();                        // Cargar imágenes (loadPicturesShowHourglass()) y mostrar wireframe de Arranque (logo SmartCloth)

// --- DASHBOARD ---
void    blinkGrupoyProcesamiento(byte msg_option);              // Mostrar zonas 1 y 2 parpadeando (msg de sin grupo o recipiente) o solo zona 2 (sin msg)
void    printGrupoyEjemplos();                                  // Zona 1 => Mostrar nombre de grupo escogido y ejemplos
void    printProcesamiento();                                   // Zona 2 => Mostrar imagen de 'crudo' o 'cocinado' según el procesamiento activo => STATE_raw y STATE_cooked
void    printZona3(byte show_objeto);                           // Zona 3 => Mostrar comida actual copiada (SHOW_COMIDA_ACTUAL_ZONA3) o alimento actual (SHOW_ALIMENTO_ACTUAL_ZONA3)
void    printZona4(byte show_objeto);                           // Zona 4 => Mostrar comida actual real (SHOW_COMIDA_ACTUAL_ZONA4) o acumulado hoy (SHOW_ACUMULADO_HOY_ZONA4)
void    showValores(ValoresNutricionales &valores, byte zona);  // Mostrar valores en la 'zona' correspondiente (SHOW_VALORES_ZONA3 O SHOW_VALORES_ZONA4).
void    showRaciones(ValoresNutricionales &valores, byte zona); // Mostrar raciones con decimales mínimos y centradas según la 'zona' (SHOW_RACIONES_ZONA3 o SHOW_RACIONES_ZONA4).
void    showDashboardStyle1(byte msg_option);                   // Mostrar dashboard estilo 1 (zonas 1-2 vacías y con mensaje, Comida copiada en zona 3 y Acumulado en zona 4) => STATE_Init y STATE_Plato
void    showDashboardStyle2();                                  // Mostrar dashboard estilo 2 (zonas 1-2 rellenas, Alimento en zona 3 y Comida en zona 4) => STATE_groupA/B, STATE_raw/cooked y STATE_weighted
bool    showSemiDashboard_PedirProcesamiento();                 // Mostrar medio dashboard (zonas 1 y 2). Las zonas 3 y 4 se tapan con pantalla de pedir procesamiento => STATE_groupA/B
// -- Dahsboard barcode ------
void    printGrupo_Barcode();                                   // Mostrar grupo de alimentos (50, barcode) en zona 1 que cubre zona 2
void    showDashboardStyle2_Barcode();                          // Mostrar dashboard estilo 2 con el producto leído y el alimento en zona 3 y la comida en zona 4 => STATE_Barcode


// --- PANTALLAS TRANSITORIAS ---
// -- Guardando comida ---
void    showSavingMeal_baseScreen();           // Mostrar pantalla de guardando comida (base)
void    showSavingMeal_connectionState(bool hayConexionInternet); // Mostrar pantalla de guardando comida con mensaje de conexión a internet
// -- Info para sincronizar ---
void    showSyncState(byte option);   // Sincronizar memoria de SmartCloth con Web
// -- Recipiente ---------
void    pedirRecipiente();                  // Pedir colocar recipiente          =>  STATE_Init
void    recipienteColocado();               // Mostrar "Recipiente colocado"     =>  solo una vez en STATE_Plato
void    recipienteRetirado();               // Mostrar "Recipiente retirado"     =>  solo si se ha retirado (LIBERAR --> STATE_Init)
// -- Grupo --------------
void    pedirGrupoAlimentos();              // Pedir escoger grupo de alimentos  =>  STATE_Plato

// -- Barcode ------------
void    showScanningBarcode();                  // Mostrar "Escaneando código"        =>  STATE_Barcode
void    showSearchingProductInfo();             // Pantalla: Buscando información del producto
//void    showProductoCancelado();                // Pantalla: Producto cancelado
void    pedirConfirmacionProducto(String &productInfo);   // Mostrar información del producto


// -- Procesamiento ------
//void    pedirProcesamiento();             // Pedir escoger crudo o cocinado    =>  STATE_groupA y STATE_groupB
bool    formGraphicsPedirProcesamiento();   // Compone la pantalla (forma, colores, texto y 1º botón de cocinado) de pedir procesamiento sobre las zonas 3 y 4 del dashboard.
bool    alternateButtonsProcesamiento();    // Alterna imágenes de botones crudo y cocinado 
bool    pedirProcesamientoZonas3y4();       // Pedir procesamiento sobre zonas 3 y 4 del dashboard  =>  STATE_groupA y STATE_groupB
// -- Colocar alimento ---
void    pedirAlimento();                    // Pedir colocar alimento
// -- Sugerir acción ----
void    sugerirAccion();                    // Sugerir acción: añadir más alimento, escoger otro grupo, añadir otro plato, borrar plato actual o guardar comida.
// -- Confirmar acción ---
void    pedirConfirmacion(byte option);     // Pregunta de confirmación general  =>  STATE_add_check (option: 1), STATE_delete_check (option: 2) y STATE_save_check (option: 3)
// -- Acción realizada ---
void    showAccionRealizada(byte option);   // Mensaje general de confirmación   =>  STATE_added (option: 1), STATE_deleted (option: 2) y STATE_saved (option: 3)
// -- Acción cancelada ---
void    showCancel(byte option);            // Mensaje de "Acción cancelada" para add/delete/save o leer barcode, o "Producto cancelado" para el producto buscado
// --- Plato retirado sin avisar ---
void    checkIntencionRemoval();        // Pantalla para preguntar qué intención tenía al retirar el plato: "Guardar y crear otro" o "Eliminar"
void    showBorradoAutomatico();            // Pantalla de borrado automático del plato porque no se ha recibido respuesta de lo que se quería hacer con él
// -- Fallo crítico en SD ---
void    showCriticFailureSD();              // Pantalla de fallo crítico al inicializar la SD ("Fallo en la memoria interna de SM")
// --- Errores o avisos ---
void    showError(byte option);             // Pantalla de error con mensaje según estado 
void    showWarning(byte option);           // Warning de acción innecesaria => STATE_added (option: 1), STATE_deleted (option: 2) y STATE_saved (option: 3)
                                            // o de no haber leído el barcode => STATE_Barcode (option: 4) o de no haber encontrado el producto => STATE_Barcode (option: 5)
                                            // Si no se encuentra el producto, se indica con su código, que está como global en State_Machine.h y se tiene acceso desde Screen.h


// -- Aparición/Desaparición imágenes --
bool    slowAppearanceImage(byte option);                          // Mostrar imagen de cociGra (option = 1) o scale (option = 2)
bool    slowAppearanceAndDisappareanceProcesamiento(byte option);  // Mostrar crudoGra desapareciendo y cociGra apareciendo (option = 1) o viceversa (option = 2)

// --- CARGA DE IMÁGENES ---
void    loadPicturesShowHourglass();        // Cargar imágenes en la SDRAM de la pantalla mientras se muestra un reloj de arena (hourglass)
void    putReloj1();
void    putReloj2();
void    putReloj3();
void    putReloj4();
void    putRelojGirado1();
void    putRelojGirado2();
void    putRelojGirado3();
void    putRelojGirado4();
void    putRelojGirado5();
void    putRelojGirado6();

/*-----------------------------------------------------------------------------*/
// --- INTERRUPCIONES/EVENTOS ---
bool    eventOccurred();                    // Comprobar si ha habido interrupciones de botoneras o eventos de báscula

/*-----------------------------------------------------------------------------*/
// --- ESPERA E INTERRUPCION ---
bool    doubleDelayAndCheckInterrupt(unsigned long period);  // El tiempo especificado se divide a la mitad y se comprueba interrupción tras cada espera

/*-----------------------------------------------------------------------------*/
// --- MOVIMIENTO PANTALLAS GRUPOS Y CONFIRMACIÓN ---
bool    desplazar_mano(byte option);   // Desplazar imagen de "mano" por la pantalla hasta el botón correspondiente. Devuelve bool para poder salir de pedirConfirmacion() si hay interrupción.
void    sin_pulsacion(byte option);    // Mano sobre botón sin pulsación 
void    con_pulsacion(byte option);    // Pulsación de mano en botón

// --- PANTALLAS CHECK Y CONFIRMADO DEL BORRADO CSV ---
#ifdef BORRADO_INFO_USUARIO
void    pedirConfirmacion_DELETE_FILES();             // Pantalla de confirmación de borrado del csv
void    showAcumuladoBorrado(const bool &exito);    // Pantalla con mensaje de "Fichero borrado" (exito = true) o "Error en el borrado" (exito = false)
#endif
/******************************************************************************/
/******************************************************************************/





/*******************************************************************************
/*******************************************************************************
                           DEFINICIÓN FUNCIONES
/******************************************************************************/
/******************************************************************************/


/***************************************************************************************************/
/*---------------------------- INICIALIZACIÓN PANTALLA   ------------------------------------------*/
/***************************************************************************************************/

/*---------------------------------------------------------------------------------------------------------
   setupScreen(): Inicializar pantalla
----------------------------------------------------------------------------------------------------------*/
void setupScreen()
{
    #if defined(SM_DEBUG)
        SerialPC.println(F("\nInit Pantalla..."));
    #endif

    pinMode(RA8876_BACKLIGHT, OUTPUT);  // Set backlight pin to OUTPUT mode
    digitalWrite(RA8876_BACKLIGHT, HIGH);  // Turn on backlight

    if (!tft.init()){
        #if defined(SM_DEBUG)
            SerialPC.println(F("Could not initialize RA8876"));
            SerialPC.println("++++++++++++++++++++++++++++++++++++++++++++++++++\n");
        #endif
        while(1);
    }

    tft.canvasImageStartAddress(PAGE1_START_ADDR); 
    tft.clearScreen(BLACK); 

    //SCREEN_WIDTH = tft.getWidth(); // X
    //SCREEN_HEIGHT = tft.getHeight(); // Y
    #if defined(SM_DEBUG)
        SerialPC.println(F("Screen initialized"));
        SerialPC.println("++++++++++++++++++++++++++++++++++++++++++++++++++\n");
    #endif
    delay(200);
}




/***************************************************************************************************/
/*---------------------------- INTERRUPCIONES   ---------------------------------------------------*/
/***************************************************************************************************/

/*---------------------------------------------------------------------------------------------------------
   doubleDelayAndCheckInterrupt(): Divide a la mitad el tiempo especificado y hace dos (double) delays según
                                   esos valores. Tras cada espera, comprueba si ha habido interrupciones.
          Parámetros:
                - period --> período de tiempo que se quiere esperar pero "escuchando" a las interrupciones.
          Return:
                - true --> ha habido interrupcion durante algún delay
                - false --> no ha habido interrupción durante ningún delay
----------------------------------------------------------------------------------------------------------*/
bool doubleDelayAndCheckInterrupt(unsigned long period){
    unsigned long timeForDelay = period/2;

    // ----- INT -------------------
    if(eventOccurred()) return true; // Evento de interrupción (botonera o báscula)
    // ----- ESPERA ----
    delay(timeForDelay);
    // ----- INT -------------------
    if(eventOccurred()) return true; // Evento de interrupción (botonera o báscula) 
    // ----- ESPERA ----
    delay(timeForDelay);
    // -------- INT -------------------
    if(eventOccurred()) return true; // Evento de interrupción (botonera o báscula)

    return false;
}



/***************************************************************************************************/
/*---------------------------- BIENVENIDA A SMARTCLOTH   ------------------------------------------*/
/***************************************************************************************************/

/*---------------------------------------------------------------------------------------------------------
   Welcome(): Carga las imágenes que se van a usar (loadPicturesShowHourglass) mientras muestra un reloj
              de arena y después muestra el logo de SmartCloth (wireframe de arranque).
----------------------------------------------------------------------------------------------------------*/
void welcome()
{
    #if defined(SM_DEBUG)
        SerialPC.println("\n\n**************************************************");
        SerialPC.println(F("\n      WELCOME TO SMARTCLOTH\n"));
        SerialPC.println("**************************************************\n\n");
    #endif
    uint8_t i; // Variable i de los bucles for para ir modificando la opacidad de las imágenes y que aparezcan poco a poco

    showingTemporalScreen = false; // Desactivar flag de estar mostrando pantalla temporal/transitoria

    //tft.canvasImageStartAddress(PAGE1_START_ADDR); 
    //tft.clearScreen(BLACK); 

    // 1 -  Cargar imágenes mientras muestra reloj de arena
    loadPicturesShowHourglass();  


    // 2 - Mostrar Logo SmartCloth
    //tft.canvasImageStartAddress(PAGE1_START_ADDR);  // YA ESTÁ
    tft.clearScreen(WHITE); // Fondo blanco en PAGE1
    delay(200);

    // S M A R T C L O T H ==> S T O T M L R A C H (orden de aparición)

    // ----------- LETRA S ----------------------
    for(i = 32; i >= 1; i--){ // i = 16 --> RA8876_ALPHA_OPACITY_16
        // Mostrar S apareciendo con opacidad a nivel i/32. Utiliza el propio fondo verde de la page1 como S1.
        tft.bteMemoryCopyWithOpacity(PAGE2_START_ADDR,SCREEN_WIDTH,0,0,PAGE1_START_ADDR,SCREEN_WIDTH,0,400,PAGE1_START_ADDR,SCREEN_WIDTH,40,150,95,159,i);
        delay(10);
    }
    tft.bteMemoryCopy(PAGE2_START_ADDR,SCREEN_WIDTH,0,0,PAGE1_START_ADDR,SCREEN_WIDTH,40,150,95,159);       // S (95x159) 
    delay(80);

    // ----------- LETRA T1 ----------------------
    for(i = 32; i >= 1; i--){ // i = 16 --> RA8876_ALPHA_OPACITY_16
        // Mostrar T1 apareciendo con opacidad a nivel i/32. Utiliza el propio fondo verde de la page1 como S1.
        tft.bteMemoryCopyWithOpacity(PAGE2_START_ADDR,SCREEN_WIDTH,392,0,PAGE1_START_ADDR,SCREEN_WIDTH,0,400,PAGE1_START_ADDR,SCREEN_WIDTH,428,150,104,159,i);
        delay(10);
    }
    tft.bteMemoryCopy(PAGE2_START_ADDR,SCREEN_WIDTH,392,0,PAGE1_START_ADDR,SCREEN_WIDTH,428,150,104,159);   // T1 (104x159)
    delay(80);

    // ----------- LETRA O ----------------------
    for(i = 32; i >= 1; i--){ // i = 16 --> RA8876_ALPHA_OPACITY_16
        // Mostrar  apareciendo con opacidad a nivel i/32. Utiliza el propio fondo verde de la page1 como S1.
        tft.bteMemoryCopyWithOpacity(PAGE2_START_ADDR,SCREEN_WIDTH,669,0,PAGE1_START_ADDR,SCREEN_WIDTH,0,400,PAGE1_START_ADDR,SCREEN_WIDTH,702,150,85,159,i);
        delay(10);
    }
    tft.bteMemoryCopy(PAGE2_START_ADDR,SCREEN_WIDTH,669,0,PAGE1_START_ADDR,SCREEN_WIDTH,702,150,85,159);    // O (85x159)
    delay(80);
    
    // ----------- LETRA T2 ----------------------
    for(i = 32; i >= 1; i--){ // i = 16 --> RA8876_ALPHA_OPACITY_16
        // Mostrar T2 apareciendo con opacidad a nivel i/32. Utiliza el propio fondo verde de la page1 como S1.
        tft.bteMemoryCopyWithOpacity(PAGE2_START_ADDR,SCREEN_WIDTH,392,0,PAGE1_START_ADDR,SCREEN_WIDTH,0,400,PAGE1_START_ADDR,SCREEN_WIDTH,787,150,104,159,i);
        delay(10);
    }
    tft.bteMemoryCopy(PAGE2_START_ADDR,SCREEN_WIDTH,392,0,PAGE1_START_ADDR,SCREEN_WIDTH,787,150,104,159);   // T2 (104x159) 
    delay(80);

    // ----------- LETRA M ----------------------
    for(i = 32; i >= 1; i--){ // i = 16 --> RA8876_ALPHA_OPACITY_16
        // Mostrar M apareciendo con opacidad a nivel i/32. Utiliza el propio fondo verde de la page1 como S1.
        tft.bteMemoryCopyWithOpacity(PAGE2_START_ADDR,SCREEN_WIDTH,96,0,PAGE1_START_ADDR,SCREEN_WIDTH,0,400,PAGE1_START_ADDR,SCREEN_WIDTH,135,150,104,159,i);
        delay(10);
    }
    tft.bteMemoryCopy(PAGE2_START_ADDR,SCREEN_WIDTH,96,0,PAGE1_START_ADDR,SCREEN_WIDTH,135,150,104,159);    // M (104x154) 
    delay(80);
    
    // ----------- LETRA L ----------------------
    for(i = 32; i >= 1; i--){ // i = 16 --> RA8876_ALPHA_OPACITY_16
        // Mostrar L apareciendo con opacidad a nivel i/32. Utiliza el propio fondo verde de la page1 como S1.
        tft.bteMemoryCopyWithOpacity(PAGE2_START_ADDR,SCREEN_WIDTH,583,0,PAGE1_START_ADDR,SCREEN_WIDTH,0,400,PAGE1_START_ADDR,SCREEN_WIDTH,617,150,85,159,i);
        delay(10);
    }
    tft.bteMemoryCopy(PAGE2_START_ADDR,SCREEN_WIDTH,583,0,PAGE1_START_ADDR,SCREEN_WIDTH,617,150,85,159);    // L (85x159) 
    delay(80);

    // ----------- LETRA R ----------------------
    for(i = 32; i >= 1; i--){ // i = 16 --> RA8876_ALPHA_OPACITY_16
        // Mostrar R apareciendo con opacidad a nivel i/32. Utiliza el propio fondo verde de la page1 como S1.
        tft.bteMemoryCopyWithOpacity(PAGE2_START_ADDR,SCREEN_WIDTH,306,0,PAGE1_START_ADDR,SCREEN_WIDTH,0,400,PAGE1_START_ADDR,SCREEN_WIDTH,343,150,85,159,i);
        delay(10);
    }
    tft.bteMemoryCopy(PAGE2_START_ADDR,SCREEN_WIDTH,306,0,PAGE1_START_ADDR,SCREEN_WIDTH,343,150,85,159);    // R (85x159) 
    delay(80);

    // ----------- LETRA A ----------------------
    for(i = 32; i >= 1; i--){ // i = 16 --> RA8876_ALPHA_OPACITY_16
        // Mostrar A apareciendo con opacidad a nivel i/32. Utiliza el propio fondo verde de la page1 como S1.
        tft.bteMemoryCopyWithOpacity(PAGE2_START_ADDR,SCREEN_WIDTH,201,0,PAGE1_START_ADDR,SCREEN_WIDTH,0,400,PAGE1_START_ADDR,SCREEN_WIDTH,239,150,104,159,i);
        delay(10);
    }
    tft.bteMemoryCopy(PAGE2_START_ADDR,SCREEN_WIDTH,201,0,PAGE1_START_ADDR,SCREEN_WIDTH,239,150,104,159);   // A (104x159) 
    delay(80);

    // ----------- LETRA C ----------------------
    for(i = 32; i >= 1; i--){ // i = 16 --> RA8876_ALPHA_OPACITY_16
        // Mostrar C apareciendo con opacidad a nivel i/32. Utiliza el propio fondo verde de la page1 como S1.
        tft.bteMemoryCopyWithOpacity(PAGE2_START_ADDR,SCREEN_WIDTH,497,0,PAGE1_START_ADDR,SCREEN_WIDTH,0,400,PAGE1_START_ADDR,SCREEN_WIDTH,532,150,85,159,i);
        delay(10);
    }
    tft.bteMemoryCopy(PAGE2_START_ADDR,SCREEN_WIDTH,497,0,PAGE1_START_ADDR,SCREEN_WIDTH,532,150,85,159);    // C (85x159) 
    delay(80);

    // ----------- LETRA H ----------------------
    for(i = 32; i >= 1; i--){ // i = 16 --> RA8876_ALPHA_OPACITY_16
        // Mostrar H apareciendo con opacidad a nivel i/32. Utiliza el propio fondo verde de la page1 como S1.
        tft.bteMemoryCopyWithOpacity(PAGE2_START_ADDR,SCREEN_WIDTH,755,0,PAGE1_START_ADDR,SCREEN_WIDTH,0,400,PAGE1_START_ADDR,SCREEN_WIDTH,891,150,85,159,i);
        delay(10);
    }
    tft.bteMemoryCopy(PAGE2_START_ADDR,SCREEN_WIDTH,755,0,PAGE1_START_ADDR,SCREEN_WIDTH,891,150,85,159);    // H (85x159) 
    delay(80);   

    
    // ----------- LOGO ----------------------
    for(i = 32; i >= 1; i--){ // i = 16 --> RA8876_ALPHA_OPACITY_16
        // Mostrar LOGO apareciendo con opacidad a nivel i/32. Utiliza el propio fondo verde de la page1 como S1.
        tft.bteMemoryCopyWithOpacity(PAGE2_START_ADDR,SCREEN_WIDTH,841,0,PAGE1_START_ADDR,SCREEN_WIDTH,0,400,PAGE1_START_ADDR,SCREEN_WIDTH,417,350,162,169,i);
        delay(10);
    }
    tft.bteMemoryCopy(PAGE2_START_ADDR,SCREEN_WIDTH,841,0,PAGE1_START_ADDR,SCREEN_WIDTH,417,350,162,169);   // Logo (162x169) ==> debajo
    
    delay(500);
}



/*********************************************************************************************************/
/*-------------------------------------------------------------------------------------------------------*/
/*-------------------------------- ZONAS DEL DASHBOARD --------------------------------------------------*/
/*-------------------------------------------------------------------------------------------------------*/
/*********************************************************************************************************/



/*---------------------------------------------------------------------------------------------------------
   blinkGrupoyProcesamiento(): Muestra un mensaje en la zona 1 (recipiente no colocado o grupo no escogido)
                               y la zona 2 vacía. El borde de ambas zonas parpadea si hay mensaje, indicando 
                               que no se ha escogido aún grupo ni procesamiento.
                               Si no hay mensaje porque ya se ha colocado recipiente y escogido grupo, solo 
                               parpadea la zona 2 indicando que no se ha ecogido aún procesamiento.

                               Haya mensaje o no, la zona 2 siempre parpadea mientras no se escoja crudo o
                               cocinado.

            Parámetros:
                    msg_option - byte   -->   0: sin mensaje     1: mensaje "no hay recipiente"    2: mensaje "no hay grupo"
----------------------------------------------------------------------------------------------------------*/
void blinkGrupoyProcesamiento(byte msg_option){
    // Tiempos utilizados para alternar el resaltado de los recuadros:
    static unsigned long previousTime = 0;      // Variable estática para almacenar el tiempo anterior
    const unsigned long interval = 500;        // Intervalo de tiempo para alternar entre resaltar el recuadro o no (0.5 seg)

    unsigned long currentTime = millis();

    static bool resaltar_cuadros = true;


    // ----- ALTERNANCIA RESALTADO -------------------------
    // --- RESALTAR --------------------
    if(resaltar_cuadros){
        if (currentTime - previousTime >= interval) {
            previousTime = currentTime;

            // ----- ZONA 1 -----------------------------------------
            if(msg_option != NO_MSG){ // Hay mensaje porque no se ha colocado recipiente o escogido grupo
                // Recuadro grupo y ejemplos
                tft.fillRoundRect(30,20,932,135,20,GRIS_CUADROS); // 902 x 115
                // Resaltar zona de grupos para recordar que no se han escogido
                tft.drawRoundRect(30,20,932,135,20,RED); // Resaltado x1
                tft.drawRoundRect(31,21,931,134,20,RED); // Resaltado x2
                tft.drawRoundRect(32,22,930,133,20,RED); // Resaltado x3

                // Mensaje
                tft.selectInternalFont(RA8876_FONT_SIZE_32);
                tft.setTextScale(RA8876_TEXT_W_SCALE_X1, RA8876_TEXT_H_SCALE_X1); 
                tft.setCursor(50,50);
                tft.setTextForegroundColor(WHITE);

                if(msg_option == MSG_SIN_RECIPIENTE) tft.print(convertSpecialCharactersToHEX("NO SE HA COLOCADO NINGÚN RECIPIENTE"));  // 16x32 escale x1
                else if(msg_option == MSG_SIN_GRUPO) tft.print(convertSpecialCharactersToHEX("NO SE HA SELECCIONADO NINGÚN GRUPO DE ALIMENTOS"));  // 16x32 escale x1
            }
            // ----- FIN ZONA 1 -------------------------------------


            // ----- ZONA 2 -----------------------------------------
            // Haya mensaje o no, esta zona siempre parpadea
            // mientras no se escoja procesamiento

            // ----- COCINADO ---------
            // Dibujar cuadro cocinado
            tft.fillRoundRect(937,20,994,74,10,GRIS_CUADROS); 
            // Mostrar cociPeq con opacidad a nivel 24/32. Utiliza un recuadro de color GRIS_CUADROS escrito en page3 como S1.
            tft.bteMemoryCopyWithOpacity(PAGE3_START_ADDR,SCREEN_WIDTH,529,131,PAGE3_START_ADDR,SCREEN_WIDTH,610,174,PAGE1_START_ADDR,SCREEN_WIDTH,942,26,47,42,RA8876_ALPHA_OPACITY_24);
            // Resaltado en cuadro cocinado
            tft.drawRoundRect(937,20,994,74,10,RED); // Resaltado x1 en cuadro cocinado
            tft.drawRoundRect(938,21,993,73,10,RED); // Resaltado x2 en cuadro cocinado
            tft.drawRoundRect(939,22,992,72,10,RED); // Resaltado x3 en cuadro cocinado
            // ----- FIN COCINADO -----

            // ----- CRUDO ------------
            // Dibujar cuadro crudo
            tft.fillRoundRect(937,79,994,133,10,GRIS_CUADROS); 
            // Mostrar crudoPeq con opacidad a nivel 24/32. Utiliza un recuadro de color GRIS_CUADROS escrito en page3 como S1.
            tft.bteMemoryCopyWithOpacity(PAGE3_START_ADDR,SCREEN_WIDTH,577,131,PAGE3_START_ADDR,SCREEN_WIDTH,610,174,PAGE1_START_ADDR,SCREEN_WIDTH,942,85,47,42,RA8876_ALPHA_OPACITY_24);
            // Resaltado en cuadro crudo
            tft.drawRoundRect(937,79,994,133,10,RED); // Resaltado x1 en cuadro crudo
            tft.drawRoundRect(938,80,993,132,10,RED); // Resaltado x2 en cuadro crudo
            tft.drawRoundRect(939,81,992,131,10,RED); // Resaltado x3 en cuadro crudo
            // ----- FIN CRUDO --------
            // ----- FIN ZONA 2 -------------------------------------


            resaltar_cuadros = false;
        }
    }
    // --- FIN RESALTAR --------------------

    else{   // --- NO RESALTAR --------------------
        if (currentTime - previousTime >= interval) {
            previousTime = currentTime;

            // ----- ZONA 1 -----------------------------------------
            if(msg_option != NO_MSG){ // Hay mensaje porque no se ha colocado recipiente o escogido grupo
                // Recuadro grupo y ejemplos
                tft.fillRoundRect(30,20,932,135,20,GRIS_CUADROS); // 902 x 115

                // Mensaje
                tft.selectInternalFont(RA8876_FONT_SIZE_32);
                tft.setTextScale(RA8876_TEXT_W_SCALE_X1, RA8876_TEXT_H_SCALE_X1); 
                tft.setCursor(50,50);
                tft.setTextForegroundColor(WHITE);

                if(msg_option == MSG_SIN_RECIPIENTE) tft.print(convertSpecialCharactersToHEX("NO SE HA COLOCADO NINGÚN RECIPIENTE"));  // 16x32 escale x1
                else if(msg_option == MSG_SIN_GRUPO) tft.print(convertSpecialCharactersToHEX("NO SE HA SELECCIONADO NINGÚN GRUPO DE ALIMENTOS"));  // 16x32 escale x1
            
            }
            // ----- FIN ZONA 1 -------------------------------------


            // ----- ZONA 2 -----------------------------------------
            // Haya mensaje o no, esta zona siempre parpadea 
            // mientras no se escoja procesamiento

            // ----- COCINADO ---------
            // Dibujar cuadro cocinado
            tft.fillRoundRect(937,20,994,74,10,GRIS_CUADROS); 
            // Mostrar cociPeq con opacidad a nivel 24/32. Utiliza un recuadro de color GRIS_CUADROS escrito en page3 como S1.
            tft.bteMemoryCopyWithOpacity(PAGE3_START_ADDR,SCREEN_WIDTH,529,131,PAGE3_START_ADDR,SCREEN_WIDTH,610,174,PAGE1_START_ADDR,SCREEN_WIDTH,942,26,47,42,RA8876_ALPHA_OPACITY_24);
            // ----- FIN COCINADO -----

            // ----- CRUDO ------------
            // Dibujar cuadro crudo
            tft.fillRoundRect(937,79,994,133,10,GRIS_CUADROS); 
            // Mostrar crudoPeq con opacidad a nivel 24/32. Utiliza un recuadro de color GRIS_CUADROS escrito en page3 como S1.
            tft.bteMemoryCopyWithOpacity(PAGE3_START_ADDR,SCREEN_WIDTH,577,131,PAGE3_START_ADDR,SCREEN_WIDTH,610,174,PAGE1_START_ADDR,SCREEN_WIDTH,942,85,47,42,RA8876_ALPHA_OPACITY_24);
            // ----- FIN CRUDO --------
            // ----- FIN ZONA 2 -------------------------------------


            resaltar_cuadros = true;
        }
    }
    // --- FIN NO RESALTAR --------------------
    // ----- FIN ALTERNANCIA RESALTADO ---------------------

}


/*---------------------------------------------------------------------------------------------------------
   printGrupoyEjemplos(): Zona 1 => Muestra ejemplos del grupo de alimentos seleccionado.
----------------------------------------------------------------------------------------------------------*/
void printGrupoyEjemplos()
{    
    // -------- TEXTO ------------------------
    tft.selectInternalFont(RA8876_FONT_SIZE_32);
    tft.setTextScale(RA8876_TEXT_W_SCALE_X1, RA8876_TEXT_H_SCALE_X1); 

    // Recuadro grupo y ejemplos
    tft.fillRoundRect(30,20,932,135,20,GRIS_CUADROS); // 902 x 115

    // Título
    tft.setCursor(40,30);
    tft.setTextForegroundColor(WHITE); 
    tft.print("Grupo Actual: ");  // 16x32 escale x1

    // Color grupo
    tft.setTextForegroundColor(grupoActual.color_grupo); // 'color_grupo' como atributo de struct 'Grupo'
    
    // Nombre grupo
    tft.setCursor(tft.getCursorX(),tft.getCursorY());
    tft.print(grupoActual.Nombre_grupo); // Nombre grupo -> 16x32 escale x1
    //SerialPC.print("Grupo escogido (" + grupoActual.ID_grupo); SerialPC.println("): " + grupoActual.Nombre_grupo); 

    // Ejemplos grupo
    tft.selectInternalFont(RA8876_FONT_SIZE_24); 
    tft.setCursor(40,68);
    tft.print(grupoActual.Ejemplos_grupo); // Ejemplos grupo -> 12x24 escale x1
    // -------- FIN TEXTO --------------------
    
}


/*---------------------------------------------------------------------------------------------------------
   printGrupo_Barcode(): Zona 1 cubriendo Zona 2 => Muestra el nombre del producto escaneado.
----------------------------------------------------------------------------------------------------------*/
void printGrupo_Barcode()
{    
    // -------- TEXTO ------------------------
    tft.selectInternalFont(RA8876_FONT_SIZE_32);
    tft.setTextScale(RA8876_TEXT_W_SCALE_X1, RA8876_TEXT_H_SCALE_X1); 

    // Recuadro grupo 
    tft.fillRoundRect(30,20,994,135,20,GRIS_CUADROS); // 964 x 115

    // Título
    tft.setCursor(40,30);
    tft.setTextForegroundColor(WHITE); 
    tft.print("Grupo Actual: ");  // 16x32 escale x1

    // Color grupo
    tft.setTextForegroundColor(grupoActual.color_grupo); // 'color_grupo' como atributo de struct 'Grupo'
    
    // Nombre grupo
    tft.setCursor(tft.getCursorX(),tft.getCursorY());
    tft.print(grupoActual.Nombre_grupo); // Nombre grupo -> 16x32 escale x1
    //SerialPC.print("Grupo escogido (" + grupoActual.ID_grupo); SerialPC.println("): " + grupoActual.Nombre_grupo); 
    // -------- FIN TEXTO --------------------
    
}


/*---------------------------------------------------------------------------------------------------------
   printProcesamiento(): Zona 2 => Muestra el símbolo de 'crudo' o 'cocinado' según el procesamiento activo
----------------------------------------------------------------------------------------------------------*/
void printProcesamiento(){ 
    // Recuadro cocinado pequeño 
    tft.fillRoundRect(937,20,994,74,10,GRIS_CUADROS); // 57 x 52

    // Recuadro crudo pequeño
    tft.fillRoundRect(937,79,994,133,10,GRIS_CUADROS); // 57 x 52

    switch(procesamiento){
        case ALIMENTO_CRUDO:  // CRUDO activo
            // Mostrar crudoPeq normal
            tft.bteMemoryCopy(PAGE3_START_ADDR,SCREEN_WIDTH,577,131,PAGE1_START_ADDR,SCREEN_WIDTH,942,85,47,42);  // Mostrar crudoPeq (47x42) en PAGE1
            // Mostrar cociPeq con opacidad a nivel 24/32. Utiliza un recuadro de color GRIS_CUADROS escrito en page3 como S1.
            tft.bteMemoryCopyWithOpacity(PAGE3_START_ADDR,SCREEN_WIDTH,529,131,PAGE3_START_ADDR,SCREEN_WIDTH,610,174,PAGE1_START_ADDR,SCREEN_WIDTH,942,26,47,42,RA8876_ALPHA_OPACITY_24);
            break;

        case ALIMENTO_COCINADO: // COCINADO activo
            // Mostrar cociPeq normal
            tft.bteMemoryCopy(PAGE3_START_ADDR,SCREEN_WIDTH,529,131,PAGE1_START_ADDR,SCREEN_WIDTH,942,26,47,42);  // Mostrar cociPeq (47x42) en PAGE1
            // Mostrar crudoPeq con opacidad a nivel 24/32. Utiliza un recuadro de color GRIS_CUADROS escrito en page3 como S1.
            tft.bteMemoryCopyWithOpacity(PAGE3_START_ADDR,SCREEN_WIDTH,577,131,PAGE3_START_ADDR,SCREEN_WIDTH,610,174,PAGE1_START_ADDR,SCREEN_WIDTH,942,85,47,42,RA8876_ALPHA_OPACITY_24);
            break;

        default: break;
    }
}


/*---------------------------------------------------------------------------------------------------------
   printZona3(): Zona 3 => Muestra los valores nutricionales según el caso.
          Parámetros:
                        show_objeto - byte -> 0: Comida actual copiada tras guardar     1: alimento actual
----------------------------------------------------------------------------------------------------------*/
void printZona3(byte show_objeto)
{ 
    // ---------- GRÁFICOS ---------------------------------------------------------------------------------------- 
    // Recuadro "Comida actual" o "Alimento actual" 
    tft.fillRoundRect(30,145,504,580,20,GRIS_CUADROS); // 474 x 425
    tft.drawRoundRect(30,145,504,580,20,AZUL_BORDE_CUADRO); // Borde => 474 x 425
    tft.drawRoundRect(31,146,503,579,20,AZUL_BORDE_CUADRO); // Borde => 473 x 424

    // Recuadro Raciones Carbohidratos
    tft.fillRoundRect(401,288,479,345,10,GRIS_CUADROS_VALORES); // 78 x 57

    // Recuadro Raciones Proteinas
    tft.fillRoundRect(401,365,479,422,10,GRIS_CUADROS_VALORES); // 78 x 57

    // Recuadro Raciones Grasas
    tft.fillRoundRect(401,442,479,499,10,GRIS_CUADROS_VALORES); // 78 x 57

    // Dibujo kcal
    tft.bteMemoryCopy(PAGE3_START_ADDR,SCREEN_WIDTH,529,175,PAGE1_START_ADDR,SCREEN_WIDTH,127,507,60,64);  // Mostrar kcal_20 (60x65) en PAGE1
    // ---------- FIN GRÁFICOS ------------------------------------------------------------------------------------ 



    // ------ VALORES Y PESO A MOSTRAR ----------------------------------------------------------------------------
    ValoresNutricionales valores; // Valores a mostrar
    float pesoMostrado = 0.0;

    if(show_objeto == SHOW_COMIDA_ACTUAL_ZONA3) // Valores de la comida copiada tras guardar. Al inicio están a 0.
    {
        // Si se acaba de guardar la comida, el objeto 'comidaActual' se habrá restaurado, así que antes lo copiamos
        // en 'comidaActualCopia' para mostrar los valores guardados bajo "Comida Guardada".
        // Si no se acaba de guardar, sino que se ha vuelto a STATE_Init tras retirar plato, se mostrará "Comida Actual".
        if(flagComidaSaved)
        {
            valores.setValores(comidaActualCopia.getValoresComida());
            pesoMostrado = comidaActualCopia.getPesoComida();
        }
        else
        {
            valores.setValores(comidaActual.getValoresComida());
            pesoMostrado = comidaActual.getPesoComida();
        }
        
    }
    else if(show_objeto == SHOW_ALIMENTO_ACTUAL_ZONA3) // Valores temporales calculados a partir del peso del alimento, que puede variar
    {   
        if(pesoBascula == 0.0) // Es posible que se muestre este dashboard con el 'pesoBascula' a 0.0 (p.ej. en STATE_raw)
        {
            // Para evitar la creación innecesaria de un objeto Alimento cuando el peso es 0,
            // se asignan directamente los valores a 0.
            valores.setValores(0.0, 0.0, 0.0, 0.0); 
            pesoMostrado = 0.0;
        }
        else // Si se ha pesado un alimento, se muestran los valores temporales con los valores no definitivos del alimento pesado (STATE_weighted)
        {
            Alimento AlimentoAux(grupoActual, pesoBascula);         // Alimento auxiliar usado para mostrar información variable de lo pesado
            float carb = AlimentoAux.getValoresAlimento().getCarbValores();
            float lip = AlimentoAux.getValoresAlimento().getLipValores();
            float prot = AlimentoAux.getValoresAlimento().getProtValores();
            float kcal = AlimentoAux.getValoresAlimento().getKcalValores();
            valores.setValores(carb, lip, prot, kcal); // Calcula raciones automáticamente a partir de los valores
            pesoMostrado = AlimentoAux.getPesoAlimento();
        }
    }
    // ------- FIN VALORES Y PESO A MOSTRAR -----------------------------------------------------------------------



    // -------- TEXTO --------------------------------------------------------------------------------------------- 
    tft.selectInternalFont(RA8876_FONT_SIZE_24);
    tft.setTextScale(RA8876_TEXT_W_SCALE_X2, RA8876_TEXT_H_SCALE_X2);  // 12x24 escale x2
    tft.setTextForegroundColor(WHITE); 

    // Título
    tft.setCursor(120,155);
    if(show_objeto == SHOW_COMIDA_ACTUAL_ZONA3)
    {
        if(flagComidaSaved)
        { 
            tft.setTextForegroundColor(YELLOW); 
            tft.setCursor(90,155);
            tft.print("Comida guardada");  // 12x24 escale x2
        }
        else tft.print("Comida actual");  // 12x24 escale x2
    } 
    else if(show_objeto == SHOW_ALIMENTO_ACTUAL_ZONA3) tft.print("Alimento actual"); // 12x24 escale x2 

    // Peso
    tft.setCursor(50,220); 
    tft.setTextForegroundColor(ROJO_PESO); 
    tft.print("PESO: "); tft.print(pesoMostrado,1); tft.print("g"); // 12x24 escale x2 

    // --- VALORES EN ZONA 3 ---
    showValores(valores, SHOW_VALORES_ZONA3);

    // --- RACIONES EN ZONA 3 ---
    showRaciones(valores, SHOW_RACIONES_ZONA3);

    // -------- FIN TEXTO ------------------------------------------------------------------------

}


/*---------------------------------------------------------------------------------------------------------
   printZona4(): Zona 4 => Muestra los valores nutricionales según el caso.
          Parámetros:
                        show_objeto - byte -> 0: Comida actual real     1: acumulado hoy
----------------------------------------------------------------------------------------------------------*/
void printZona4(byte show_objeto)
{ 
    float pesoMostrado = 0.0;

    // ---------- GRÁFICOS --------------------------------------------------------------------------------------
    // Recuadro "Comida actual" o "Acumulado hoy"
    tft.fillRoundRect(520,145,994,580,20,GRIS_CUADROS); // 474 x 425

    // Recuadro Carbohidratos
    tft.fillRoundRect(891,288,969,345,10,GRIS_CUADROS_VALORES); // 78 x 57

    // Recuadro Proteinas
    tft.fillRoundRect(891,365,969,422,10,GRIS_CUADROS_VALORES); // 78 x 57

    // Recuadro Grasas
    tft.fillRoundRect(891,442,969,499,10,GRIS_CUADROS_VALORES); // 78 x 57

    // kcal
    tft.bteMemoryCopy(PAGE3_START_ADDR,SCREEN_WIDTH,529,175,PAGE1_START_ADDR,SCREEN_WIDTH,617,507,60,64);  // Mostrar kcal_20 (60x65) en PAGE1
    // ---------- FIN GRÁFICOS ----------------------------------------------------------------------------------



    // ------ VALORES A MOSTRAR -----------------------------------------------------------------
    ValoresNutricionales valores; // Valores a mostrar
                                  // En el caso de SHOW_COMIDA_ACTUAL_ZONA4, se mostrarán los valores temporales con los valores no definitivos del alimento pesado

    if(show_objeto == SHOW_COMIDA_ACTUAL_ZONA4) // Valores temporales de la comida actual
    {
        if(pesoBascula == 0.0) // Es posible que se muestre este dashboard con el 'pesoBascula' a 0.0 (p.ej. en STATE_raw)
        {
            // Para evitar la creación innecesaria de un objeto Alimento cuando el peso es 0,
            // se asignan directamente los valores a 0.
            valores.setValores(0.0, 0.0, 0.0, 0.0);
            pesoMostrado = 0.0;
        }
        else // El resto de estados, para que se muestren los valores del peso del alimento pesado
        {
            Alimento AlimentoAux(grupoActual, pesoBascula);         // Alimento auxiliar usado para mostrar información variable de lo pesado
            float carb = AlimentoAux.getValoresAlimento().getCarbValores() + comidaActual.getValoresComida().getCarbValores();
            float lip = AlimentoAux.getValoresAlimento().getLipValores() + comidaActual.getValoresComida().getLipValores();
            float prot = AlimentoAux.getValoresAlimento().getProtValores() + comidaActual.getValoresComida().getProtValores();
            float kcal = AlimentoAux.getValoresAlimento().getKcalValores() + comidaActual.getValoresComida().getKcalValores();
            valores.setValores(carb, lip, prot, kcal); // Calcula raciones automáticamente a partir de los valores

            pesoMostrado = AlimentoAux.getPesoAlimento() + comidaActual.getPesoComida();
        }
    }
    else if(show_objeto == SHOW_ACUMULADO_HOY_ZONA4) // Valores del acumulado hoy
    {
        valores.setValores(diaActual.getValoresDiario());
        pesoMostrado = diaActual.getPesoDiario();
    }
    // -------------------------------------------------------------------------------------------



    // -------- TEXTO --------------------------------------------------------------------------------------------- 
    tft.selectInternalFont(RA8876_FONT_SIZE_24);
    tft.setTextScale(RA8876_TEXT_W_SCALE_X2, RA8876_TEXT_H_SCALE_X2);  // 12x24 escale x2
    tft.setTextForegroundColor(WHITE); 

    // Título
    tft.setCursor(590, 155);
    if(show_objeto == SHOW_COMIDA_ACTUAL_ZONA4) tft.print("Comida actual");  // 12x24 escale x2
    else if(show_objeto == SHOW_ACUMULADO_HOY_ZONA4) tft.print("Acumulado hoy"); // 12x24 escale x2 

    // Peso
    tft.setCursor(540,220);
    tft.setTextForegroundColor(ROJO_PESO); 
    tft.print("PESO: "); tft.print(pesoMostrado,1); tft.print("g"); // 12x24 escale x2 

    // --- VALORES EN ZONA 4 ---
    showValores(valores, SHOW_VALORES_ZONA4);

    // --- RACIONES EN ZONA 4 ---
    showRaciones(valores, SHOW_RACIONES_ZONA4);

    // -------- FIN TEXTO ------------------------------------------------------------------------

}



/*---------------------------------------------------------------------------------------------------------
   showValores(): Mostrar los valores pasados en la ubicación correspondiente de la pantalla según la zona.
      Parámetros:
                  valores - ValoresNutricionales  --> objeto con los valores a mostrar
                  zona - byte    --> zona en la que se están mostrando, necesaria para saber la ubicación en pantalla.
----------------------------------------------------------------------------------------------------------*/
void showValores(ValoresNutricionales &valores, byte zona){

    tft.selectInternalFont(RA8876_FONT_SIZE_32); 
    tft.setTextScale(RA8876_TEXT_W_SCALE_X1, RA8876_TEXT_H_SCALE_X1); 

    // ------------ Carbohidratos ------------
    if(zona == SHOW_RACIONES_ZONA3) tft.setCursor(50,303);
    else if(zona == SHOW_RACIONES_ZONA4) tft.setCursor(540,303);
    tft.setTextForegroundColor(AZUL_CARB); 
    tft.print("CARBOHIDRATOS: "); tft.print(valores.getCarbValores(),1); tft.print("g");  // 16x32 escale x1
    
    // ------------ Proteinas ------------
    if(zona == SHOW_RACIONES_ZONA3) tft.setCursor(50,380);
    else if(zona == SHOW_RACIONES_ZONA4) tft.setCursor(540,380);
    tft.setTextForegroundColor(NARANJA_PROT); 
    tft.print(convertSpecialCharactersToHEX("PROTEÍNAS: ")); tft.print(valores.getProtValores(),1); tft.print("g"); // 16x32 escale x1

    // ------------ Grasas ------------
    if(zona == SHOW_RACIONES_ZONA3) tft.setCursor(50,457);
    else if(zona == SHOW_RACIONES_ZONA4) tft.setCursor(540,457);
    tft.setTextForegroundColor(AMARILLO_GRASAS); 
    tft.print("GRASAS: "); tft.print(valores.getLipValores(),1); tft.print("g"); // 16x32 escale x1
    
    // ------------ Kcal ------------
    if(zona == SHOW_RACIONES_ZONA3) tft.setCursor(197,516);
    else if(zona == SHOW_RACIONES_ZONA4) tft.setCursor(697,516);
    tft.setTextForegroundColor(ROJO_KCAL); 
    tft.selectInternalFont(RA8876_FONT_SIZE_24);
    tft.setTextScale(RA8876_TEXT_W_SCALE_X2, RA8876_TEXT_H_SCALE_X2); 
    tft.print(valores.getKcalValores(),0); tft.print(" Kcal"); // 12x24 escale X2

}


/*---------------------------------------------------------------------------------------------------------
   showRaciones(): Mostrar raciones de los valores pasados como atributo, mostrando los decimales solo en 
                   determinados casos y centrando el valor en el recuadro correspondiente.
      Parámetros:
                  valores - ValoresNutricionales  --> objeto con las raciones a mostrar
                  zona - byte    --> zona en la que se están mostrando, necesaria para saber la ubicación en pantalla.
----------------------------------------------------------------------------------------------------------*/
// Esta versión de la función mostraba los valores para la versión anterior de calcular las raciones, que
// redondeaba al entero más cercano y quedaba el valor como .0 o .5
/*void showRaciones(ValoresNutricionales &valores, byte zona){
    float raciones;

    // Texto "Raciones"
    tft.selectInternalFont(RA8876_FONT_SIZE_32); 
    tft.setTextScale(RA8876_TEXT_W_SCALE_X1, RA8876_TEXT_H_SCALE_X1); 
    tft.setTextForegroundColor(WHITE);
    if(zona == SHOW_RACIONES_ZONA3) tft.setCursor(370,243);
    else if(zona == SHOW_RACIONES_ZONA4) tft.setCursor(860,243);
    tft.print("Raciones"); // 16x32 escale x1

    // Cambiar tamaño para las raciones
    tft.selectInternalFont(RA8876_FONT_SIZE_24);


    // ------------ Raciones de Carbohidratos ------------
    tft.setTextScale(RA8876_TEXT_W_SCALE_X2, RA8876_TEXT_H_SCALE_X2); 
    raciones = valores.getCarbRaciones();
    if (fmod(raciones, 1.0) == 0){ // Termina en .0
        // Cursor según la cantidad de cifras enteras para centrar en el cuadro
        if((abs((int)raciones) == 0) or ((abs((int)raciones)/10) == 0)){  // 1 cifra entera
            if(zona == SHOW_RACIONES_ZONA3) tft.setCursor(426,293);
            else if(zona == SHOW_RACIONES_ZONA4) tft.setCursor(916,293); 
        } 
        else{ // 2 cifras enteras
            if(zona == SHOW_RACIONES_ZONA3) tft.setCursor(416,293);
            else if(zona == SHOW_RACIONES_ZONA4) tft.setCursor(906,293); 
        } 
        tft.print(raciones,0); // Si termina en .0 no lo mostramos. 12x24 escale x2
    }  
    else{ // Termina en .5
        // Cursor y tamaño según la cantidad de cifras enteras para centrar en el cuadro
        if((abs((int)raciones) == 0) or ((abs((int)raciones)/10) == 0)){   // 1 cifra entera
            if(zona == SHOW_RACIONES_ZONA3) tft.setCursor(406,293);
            else if(zona == SHOW_RACIONES_ZONA4) tft.setCursor(896,293);
        } 
        else{ // 2 cifras enteras
            tft.setTextScale(RA8876_TEXT_W_SCALE_X1, RA8876_TEXT_H_SCALE_X2); // Estrechar
            if(zona == SHOW_RACIONES_ZONA3) tft.setCursor(416,293); 
            else if(zona == SHOW_RACIONES_ZONA4) tft.setCursor(906,293); 
        }          
        tft.print(raciones,1); // Si no termina en .0 , termina en .5 , entonces sí lo mostramos. 12x24 escale x2 solo altura
    } 



    // ------------ Raciones de Proteinas ------------ 
    tft.setTextScale(RA8876_TEXT_W_SCALE_X2, RA8876_TEXT_H_SCALE_X2); 
    raciones = valores.getProtRaciones();
    if (fmod(raciones, 1.0) == 0){ // Termina en .0
        // Cursor según la cantidad de cifras enteras para centrar en el cuadro
        if((abs((int)raciones) == 0) or ((abs((int)raciones)/10) == 0)){  // 1 cifra entera
            if(zona == SHOW_RACIONES_ZONA3) tft.setCursor(426,370); 
            else if(zona == SHOW_RACIONES_ZONA4) tft.setCursor(916,370); 
        } 
        else{ // 2 cifras enteras
            if(zona == SHOW_RACIONES_ZONA3) tft.setCursor(416,370);
            else if(zona == SHOW_RACIONES_ZONA4) tft.setCursor(906,370); 
        } 
        tft.print(raciones,0); // Si termina en .0 no lo mostramos. 12x24 escale x2
    } 
    else{ // Termina en .5
        // Cursor y tamaño según la cantidad de cifras enteras para centrar en el cuadro
        if((abs((int)raciones) == 0) or ((abs((int)raciones)/10) == 0)){   // 1 cifra entera
            if(zona == SHOW_RACIONES_ZONA3) tft.setCursor(406,370);
            else if(zona == SHOW_RACIONES_ZONA4) tft.setCursor(896,370);
        } 
        else{ // 2 cifras enteras
            tft.setTextScale(RA8876_TEXT_W_SCALE_X1, RA8876_TEXT_H_SCALE_X2); // Estrechar
            if(zona == SHOW_RACIONES_ZONA3) tft.setCursor(416,370); 
            else if(zona == SHOW_RACIONES_ZONA4) tft.setCursor(906,370);
        } 
        tft.print(raciones,1); // Si no termina en .0 , termina en .5 , entonces sí lo mostramos. 12x24 escale x2 solo altura
    } 



    // ---------- Raciones de Grasas ------------
    tft.setTextScale(RA8876_TEXT_W_SCALE_X2, RA8876_TEXT_H_SCALE_X2); 
    raciones = valores.getLipRaciones();
    if (fmod(raciones, 1.0) == 0){ // Termina en .0
        // Cursor según la cantidad de cifras enteras para centrar en el cuadro
        if((abs((int)raciones) == 0) or ((abs((int)raciones)/10) == 0)){  // 1 cifra entera
            if(zona == SHOW_RACIONES_ZONA3) tft.setCursor(426,447); 
            else if(zona == SHOW_RACIONES_ZONA4) tft.setCursor(916,447);
        } 
        else{ // 2 cifras enteras
            if(zona == SHOW_RACIONES_ZONA3) tft.setCursor(416,447);
            else if(zona == SHOW_RACIONES_ZONA4) tft.setCursor(906,447); 
        } 
        tft.print(raciones,0); // Si termina en .0 no lo mostramos. 12x24 escale x2

    } 
    else{ // Termina en .5
        // Cursor y tamaño según la cantidad de cifras enteras para centrar en el cuadro
        if((abs((int)raciones) == 0) or ((abs((int)raciones)/10) == 0)){   // 1 cifra entera
            if(zona == SHOW_RACIONES_ZONA3) tft.setCursor(406,447);
            else if(zona == SHOW_RACIONES_ZONA4) tft.setCursor(896,447);
        } 
        else{ // 2 cifras enteras
            tft.setTextScale(RA8876_TEXT_W_SCALE_X1, RA8876_TEXT_H_SCALE_X2); // Estrechar
            if(zona == SHOW_RACIONES_ZONA3) tft.setCursor(416,447); 
            else if(zona == SHOW_RACIONES_ZONA4) tft.setCursor(906,447);
        }   
        tft.print(raciones,1); // Si no termina en .0 , termina en .5 , entonces sí lo mostramos. 12x24 escale x2 solo altura
    } 
}*/

// Esta versión de la función muestra los valores para la nueva forma de calcular las raciones, que
// redondeaba al decimal más cercano y siempre mantiene 1 decimal, aunque sea .0
void showRaciones(ValoresNutricionales &valores, byte zona)
{
    float raciones;

    // Texto "Raciones"
    tft.selectInternalFont(RA8876_FONT_SIZE_32); 
    tft.setTextScale(RA8876_TEXT_W_SCALE_X1, RA8876_TEXT_H_SCALE_X1); 
    tft.setTextForegroundColor(WHITE);
    if(zona == SHOW_RACIONES_ZONA3) tft.setCursor(370,243);
    else if(zona == SHOW_RACIONES_ZONA4) tft.setCursor(860,243);
    tft.print("Raciones"); // 16x32 escale x1


    // ------------ Raciones de Carbohidratos ------------
    raciones = valores.getCarbRaciones();
    // Cursor y tamaño según la cantidad de cifras enteras para centrar en el cuadro
    if(abs((int)raciones) < 10){   // 1 cifra entera
        tft.selectInternalFont(RA8876_FONT_SIZE_24);
        tft.setTextScale(RA8876_TEXT_W_SCALE_X2, RA8876_TEXT_H_SCALE_X2); 
        if(zona == SHOW_RACIONES_ZONA3) tft.setCursor(406,293);
        else if(zona == SHOW_RACIONES_ZONA4) tft.setCursor(896,293);
    } 
    else{ // 2 o más cifras enteras
        tft.selectInternalFont(RA8876_FONT_SIZE_16);
        tft.setTextScale(RA8876_TEXT_W_SCALE_X2, RA8876_TEXT_H_SCALE_X3); // Alargar
        if(zona == SHOW_RACIONES_ZONA3) tft.setCursor(408,291); 
        else if(zona == SHOW_RACIONES_ZONA4) tft.setCursor(898,291); 
    }          
    tft.print(raciones,1); // Si no termina en .0 , termina en .5 , entonces sí lo mostramos. 12x24 escale x2 solo altura
    // --------------------------------------------------- 



    // ------------ Raciones de Proteinas ---------------- 
    raciones = valores.getProtRaciones();
    // Cursor y tamaño según la cantidad de cifras enteras para centrar en el cuadro
    if(abs((int)raciones) < 10){   // 1 cifra entera
        tft.selectInternalFont(RA8876_FONT_SIZE_24);
        tft.setTextScale(RA8876_TEXT_W_SCALE_X2, RA8876_TEXT_H_SCALE_X2);
        if(zona == SHOW_RACIONES_ZONA3) tft.setCursor(406,370);
        else if(zona == SHOW_RACIONES_ZONA4) tft.setCursor(896,370);
    } 
    else{ // 2 o más cifras enteras
        tft.selectInternalFont(RA8876_FONT_SIZE_16);
        tft.setTextScale(RA8876_TEXT_W_SCALE_X2, RA8876_TEXT_H_SCALE_X3); // Alargar
        if(zona == SHOW_RACIONES_ZONA3) tft.setCursor(408,368);    
        else if(zona == SHOW_RACIONES_ZONA4) tft.setCursor(898,368);
    } 
    tft.print(raciones,1); // Si no termina en .0 , termina en .5 , entonces sí lo mostramos. 12x24 escale x2 solo altura
    // ---------------------------------------------------  



    // ---------- Raciones de Grasas ---------------------
    raciones = valores.getLipRaciones();
    // Cursor y tamaño según la cantidad de cifras enteras para centrar en el cuadro
    if(abs((int)raciones) < 10){   // 1 cifra entera
        tft.selectInternalFont(RA8876_FONT_SIZE_24);
        tft.setTextScale(RA8876_TEXT_W_SCALE_X2, RA8876_TEXT_H_SCALE_X2);
        if(zona == SHOW_RACIONES_ZONA3) tft.setCursor(406,447);
        else if(zona == SHOW_RACIONES_ZONA4) tft.setCursor(896,447);
    } 
    else{ // 2 o más cifras enteras
        tft.selectInternalFont(RA8876_FONT_SIZE_16);
        tft.setTextScale(RA8876_TEXT_W_SCALE_X2, RA8876_TEXT_H_SCALE_X3); // Alargar
        if(zona == SHOW_RACIONES_ZONA3) tft.setCursor(408,445); 
        else if(zona == SHOW_RACIONES_ZONA4) tft.setCursor(898,445);
    }   
    tft.print(raciones,1); // Si no termina en .0 , termina en .5 , entonces sí lo mostramos. 12x24 escale x2 solo altura
    // --------------------------------------------------- 

}



/***************************************************************************************************/
/*---------------------------- DASHBOARDS   -------------------------------------------------------*/
/***************************************************************************************************/

/*---------------------------------------------------------------------------------------------------------
   showDashboardStyle1(): Muestra el dashboard de estilo 1 con Zona 1 (grupo), Zona 2 (procesamiento), 
                          Zona 3 (Comida Actual copiada) y Zona 4 (Acumulado Hoy).

                          Este dashboard solo se muestra en STATE_Init y STATE_Plato (si se acaba de guardar la comida).
          Parámetros:
                    msg_option - byte   -->   0: sin mensaje   1: "no hay recipiente"    2: "no hay grupo"
----------------------------------------------------------------------------------------------------------*/
void showDashboardStyle1(byte msg_option){
    showingTemporalScreen = false; // Desactivar flag de estar mostrando pantalla temporal/transitoria

    tft.clearScreen(AZUL_FONDO); // Fondo azul oscuro en PAGE1

    blinkGrupoyProcesamiento(msg_option);     // Zonas 1 y 2 - Parpadeando y mensaje de falta recipiente o grupo
    printZona3(SHOW_COMIDA_ACTUAL_ZONA3);     // Zona 3 - Valores comida copiada tras guardar. Al inicio están a 0.
    printZona4(SHOW_ACUMULADO_HOY_ZONA4);     // Zona 4 - Valores Acumulado hoy
}


/*---------------------------------------------------------------------------------------------------------
   showDashboardStyle2(): Muestra el dashboard de estilo 2 con Zona 1 (grupo), Zona 2 (procesamiento), 
                          Zona 3 (Alimento Actual) y Zona 4 (Comida Actual).

                          Este dashboard se muestra en STATE_groupA, STATE_groupB, STATE_raw, STATE_cooked y STATE_weighted.
----------------------------------------------------------------------------------------------------------*/
void showDashboardStyle2()
{
    showingTemporalScreen = false; // Desactivar flag de estar mostrando pantalla temporal/transitoria

    tft.clearScreen(AZUL_FONDO); // Fondo azul oscuro en PAGE1

    printGrupoyEjemplos();                  // Zona 1 - Grupo y ejemplos 
    printProcesamiento();                   // Zona 2 - Procesamiento crudo o cocinado (según modo: ALIMENTO_CRUDO o ALIMENTO_COCINADO)
    printZona3(SHOW_ALIMENTO_ACTUAL_ZONA3); // Zona 3 - Valores alimento actual pesado
    printZona4(SHOW_COMIDA_ACTUAL_ZONA4);   // Zona 4 - Valores Comida actual actualizada en tiempo real según el peso del alimento
}




/*---------------------------------------------------------------------------------------------------------
   showDashboardStyle2_Barcode(): Muestra el dashboard de estilo 2 con Zona 1 (grupo, nombre producto) cubriendo 
                                  la Zona 2 (no se necesita procesamiento), Zona 3 (Alimento Actual) y Zona 4 (Comida Actual).

                          Este dashboard se muestra en STATE_Barcode y STATE_weighted, si el grupo es el 50 (Barcode).
----------------------------------------------------------------------------------------------------------*/
void showDashboardStyle2_Barcode()
{
    showingTemporalScreen = false; // Desactivar flag de estar mostrando pantalla temporal/transitoria

    tft.clearScreen(AZUL_FONDO); // Fondo azul oscuro en PAGE1

    printGrupo_Barcode();                   // Zona 1 y 2 - Grupo (nombre producto)
    printZona3(SHOW_ALIMENTO_ACTUAL_ZONA3); // Zona 3 - Valores alimento actual pesado
    printZona4(SHOW_COMIDA_ACTUAL_ZONA4);   // Zona 4 - Valores Comida actual actualizada en tiempo real según el peso del alimento
}



/*---------------------------------------------------------------------------------------------------------
   showSemiDashboard_PedirProcesamiento(): 
                        Muestra la Zona 1 (ejemplos) y la Zona 2 (sin escoger, parpadeando). Las zonas 3 y 4
                        se tapan con la pantalla de escoger procesamiento (crudo o cocinado)

                        Este dashboard se muestra en STATE_groupA y STATE_groupB, donde aún no se ha escogido
                        crudo o cocinado.
----------------------------------------------------------------------------------------------------------*/
bool showSemiDashboard_PedirProcesamiento(){
    showingTemporalScreen = true; // Activar flag de estar mostrando pantalla temporal/transitoria.
                                  // En STATE_raw y STATE_cooked se muestra todo el dashboard 2 si esta flag
                                  // está activa. Si no lo está, solo se modifica la zona 2.

    tft.clearScreen(AZUL_FONDO); // Fondo azul oscuro en PAGE1

    printGrupoyEjemplos();                          // Zona 1 - Grupo y ejemplos 
    blinkGrupoyProcesamiento(NO_MSG);               // Zona 2 - Procesamiento sin escoger (parpadeo)
    if(pedirProcesamientoZonas3y4()) return true;   // Zonas 3 y 4 - Pedir procesamiento
                                                        // Si ha ocurrido una interrupción mientras se formaba la pantalla de pedir recipiente, se sale de la función
    return false;
}




/***************************************************************************************************/
/*---------------------------- SINCRONIZACIÓN CON WEB   -------------------------------------------*/
/***************************************************************************************************/



/*-----------------------------------------------------------------------------*/
/**
 * @brief Dibuja los elementos base de la pantalla de guardado de comida (color, texto y líneas). Después, cuando se
 *          pregunte si hay conexión a Internet, se mostrará el icono y los mensajes correspondientes.
 */
/*-----------------------------------------------------------------------------*/
void showSavingMeal_baseScreen()
{
    // En la sincronización del inicio sí se indica "SINCRONIZANDO...", pero al subir la comida recién hecha no hace falta.
    // Ya se indicará que se ha subido si en la pantalla "COMIDA GUARDADA" aparece "Subido a web" en la esquina.

    // ---- COLOR FONDO -----------------------------------------------------------------------------------
    // Aplicar color al fondo
    tft.clearScreen(AZUL_PROCESO); // 0x037F en RGB565 (#006CFF en HEX) es el color que dio Guillermo, pero por el ángulo se ve celeste
    // ----------------------------------------------------------------------------------------------------

    // ----- TEXTO (INFORMACIÓN) --------------------------------------------------------------------------
    tft.selectInternalFont(RA8876_FONT_SIZE_24);
    tft.setTextScale(RA8876_TEXT_W_SCALE_X3, RA8876_TEXT_H_SCALE_X3);
    tft.setTextForegroundColor(WHITE);

    tft.setCursor(200, 30);    tft.println("GUARDANDO COMIDA...");
    // ----------------------------------------------------------------------------------------------------

    // ------ ICONO (GUARDANDO) ---------------------------------------------------------------------------
    tft.bteMemoryCopy(PAGE4_START_ADDR,SCREEN_WIDTH,554,0,PAGE1_START_ADDR,SCREEN_WIDTH,450,150,91,98); // Mostrar disquete (91x98) en PAGE1
    // ----------------------------------------------------------------------------------------------------

    // ------------ LINEA ---------------------------------------------------------------------------------
    tft.fillRoundRect(210,280,814,288,3,WHITE);
    // ----------------------------------------------------------------------------------------------------

    // ------ TEXTO (COMENTARIO) --------------------------------------------------------------------------
    tft.setTextScale(RA8876_TEXT_W_SCALE_X2, RA8876_TEXT_H_SCALE_X2);
    tft.setCursor(70, 338);    tft.println("ESPERE MIENTRAS SE GUARDA LA COMIDA");
    // ----------------------------------------------------------------------------------------------------
}


/*-----------------------------------------------------------------------------*/
/**
 * @brief Muestra el estado de la conexión a Internet al guardar la comida en SMARTCLOTH.
 * 
 * Muestra un mensaje en la pantalla indicando si hay conexión a internet o no.
 * 
 * @param hayConexionInternet Un valor booleano que indica si hay conexión a internet o no.
 */
/*-----------------------------------------------------------------------------*/
void showSavingMeal_connectionState(bool hayConexionInternet)
{
    // ------ TEXTO (COMENTARIO) --------------------------------------------------------------------------
    tft.selectInternalFont(RA8876_FONT_SIZE_24);
    tft.setTextScale(RA8876_TEXT_W_SCALE_X2, RA8876_TEXT_H_SCALE_X2);
     tft.setTextForegroundColor(WHITE);
    if(!hayConexionInternet)
    {
        tft.setCursor(220, tft.getCursorY() + tft.getTextSizeY()); tft.print(convertSpecialCharactersToHEX("Se guardará en SMARTCLOTH"));
        tft.setCursor(280, tft.getCursorY() + tft.getTextSizeY() + 10); tft.println("pero no en la web");
    }
    // ----------------------------------------------------------------------------------------------------

    // ----- ICONO CONEXION A INTERNET O NO ---------------------------------------------------------------
    tft.setTextScale(RA8876_TEXT_W_SCALE_X1, RA8876_TEXT_H_SCALE_X1); 
    if(hayConexionInternet) // Mostrar icono de conexión a internet y texto
    {
        // Toma desde y=1 para quitar linea de basura y, para evitar la linea de debajo, hacemos como que es de 66 píxeles de alto
        tft.bteMemoryCopy(PAGE4_START_ADDR, SCREEN_WIDTH, 646, 1, PAGE1_START_ADDR, SCREEN_WIDTH, 30, 500, 43, 66); // Mostrar conexión (43x67) en PAGE1. 
        tft.setCursor(85,520);    tft.println(convertSpecialCharactersToHEX("CON CONEXIÓN A INTERNET"));
    }
    else // Mostrar icono de sin conexión a internet y texto
    {   
        tft.bteMemoryCopy(PAGE4_START_ADDR, SCREEN_WIDTH, 689, 0, PAGE1_START_ADDR, SCREEN_WIDTH, 30, 480, 54, 85); // Mostrar no conexión (54x85) en PAGE1
        tft.setCursor(90,520);    tft.println(convertSpecialCharactersToHEX("SIN CONEXIÓN A INTERNET"));
    
    }
    // ----------------------------------------------------------------------------------------------------

}



/*-----------------------------------------------------------------------------*/
/**
 * @brief Muestra la información de sincronización en la pantalla.
 * 
 * @param option Opción que indica el estado de la sincronización.
 *               - UPLOADING_DATA: "Sincronizando..." con fondo azul indicando al usuario que espere a que termine de subirse toda la info
 * 
 *               - ALL_MEALS_UPLOADED: "¡SmartCloth sincronizado!" con fondo verde indicando al usuario que se ha subido toda la info
 * 
 *               - ERROR_READING_MEALS_FILE, NO_INTERNET_CONNECTION, HTTP_ERROR, TIMEOUT, UNKNOWN_ERROR: "¡Error del sistema!" con comentario
 */
/*-----------------------------------------------------------------------------*/
void showSyncState(byte option)
{ 
    // ---- COLOR FONDO Y TEXTO -----------------------------------------------------------------------
    uint16_t backgroundColor, lineColor, textColor;
    
    switch(option)
    {
        case UPLOADING_DATA:            backgroundColor = AZUL_PROCESO;                 lineColor = textColor = WHITE;                          break;
        case ALL_MEALS_UPLOADED:        backgroundColor = VERDE_PEDIR_Y_EXITO;          lineColor = textColor = WHITE;                          break;
        
        // Error: option en rango [5, 9]
        default:                        backgroundColor = RED_ERROR_Y_CANCEL;           lineColor = textColor = WHITE;                          break;

    }

    tft.clearScreen(backgroundColor);       // Aplicar color al fondo
    tft.setTextForegroundColor(textColor);  // Aplicar color al texto
    // -----------------------------------------------------------------------------------------------


    // ----- TEXTO (INFORMACIÓN) ---------------------------------------------------------------------
    tft.selectInternalFont(RA8876_FONT_SIZE_24);
    tft.setTextScale(RA8876_TEXT_W_SCALE_X3, RA8876_TEXT_H_SCALE_X3);

    switch (option)
    {
        case UPLOADING_DATA:            tft.setCursor(270, 30);        tft.println("SINCRONIZANDO...");                        break; 

        case ALL_MEALS_UPLOADED:        tft.setCursor(70, 30);         tft.println(convertSpecialCharactersToHEX("¡SMARTCLOTH SINCRONIZADO!"));     break;

        case ERROR_READING_MEALS_FILE:         
        case NO_INTERNET_CONNECTION:     
        case HTTP_ERROR:                
        case TIMEOUT:   
        case UNKNOWN_ERROR:             tft.setCursor(180,100);        tft.println(convertSpecialCharactersToHEX("¡ERROR DEL SISTEMA!"));            break;
        
        default:    break;
    }
    // ----------------------------------------------------------------------------------------------------


    // ----- DIBUJO O ICONO -------------------------------------------------------------------------------
    switch (option)
    {
        case UPLOADING_DATA: // Icono SM sincronizando
            // Toma desde y=1 para quitar linea de basura y, para evitar la linea de debajo, hacemos como que es de 122 píxeles de alto
            tft.bteMemoryCopy(PAGE4_START_ADDR,SCREEN_WIDTH,0,1,PAGE1_START_ADDR,SCREEN_WIDTH,420,130,188,122); // Mostrar sincronizando (188x123) en PAGE1
            tft.fillRoundRect(210,280,814,288,3,lineColor); // Línea bajo el icono
            break;

        case ALL_MEALS_UPLOADED: // Icono SM sincronizado
            tft.bteMemoryCopy(PAGE4_START_ADDR,SCREEN_WIDTH,189,0,PAGE1_START_ADDR,SCREEN_WIDTH,402,147,220,136); // Mostrar SM sincronizado (220x136) en PAGE1
            tft.fillRoundRect(210,300,814,308,3,lineColor); // Línea bajo el icono
            break;

        case ERROR_READING_MEALS_FILE:
        case NO_INTERNET_CONNECTION:
        case HTTP_ERROR:
        case TIMEOUT:
        case UNKNOWN_ERROR:
            tft.bteMemoryCopy(PAGE3_START_ADDR,SCREEN_WIDTH,0,292,PAGE1_START_ADDR,SCREEN_WIDTH,451,231,114,127); // Mostrar cruz (114x127) en PAGE1
            tft.fillRoundRect(252,290,764,298,3,lineColor); // Dibujar líea por encima de la imagen de cruz para no tener que cuadrarla
            break;

        default:
            break;
    }
    
    // Restablecer color de texto según el caso. Al dibujar (recuadro o líneas), el foregroundColor se cambia a lineColor
    tft.setTextForegroundColor(textColor);
    // ----------------------------------------------------------------------------------------------------



    // ------ TEXTO (COMENTARIO) --------------------------------------------------------------------------
    tft.setTextScale(RA8876_TEXT_W_SCALE_X2, RA8876_TEXT_H_SCALE_X2); 
// NO_INTERNET_CONNECTION, HTTP_ERROR (al autenticarse en web), TIMEOUT, UNKNOWN_ERROR
    switch (option)
    {
        case UPLOADING_DATA:            
            tft.setCursor(70, 338);                                             tft.println("ESPERE MIENTRAS SE FINALIZA LA SUBIDA");
            tft.setCursor(300,tft.getCursorY() + tft.getTextSizeY()-10);        tft.println(convertSpecialCharactersToHEX("DE INFORMACIÓN"));
            tft.setCursor(200, tft.getCursorY() + tft.getTextSizeY() + 20);     tft.println(convertSpecialCharactersToHEX("No retire el teléfono móvil"));                                      break; 

        case ALL_MEALS_UPLOADED:        tft.setCursor(215, 388);                                        tft.println("LA WEB SE HA ACTUALIZADO");                                                break;

        case ERROR_READING_MEALS_FILE:         tft.setCursor(40, 420);                                         tft.println(convertSpecialCharactersToHEX("FALLÓ LA LECTURA DEL FICHERO DE COMIDAS"));  break;

        case NO_INTERNET_CONNECTION:    tft.setCursor(125, 420);                                        tft.println(convertSpecialCharactersToHEX("SE PERDIÓ LA CONEXIÓN A INTERNET"));
                                        tft.setCursor(50, tft.getCursorY() + tft.getTextSizeY()+20);    tft.println(convertSpecialCharactersToHEX("NO SE PUEDE SINCRONIZAR LA INFORMACIÓN"));   break;
              
        case HTTP_ERROR:                tft.setCursor(100, 420);                                         tft.println(convertSpecialCharactersToHEX("FALLÓ LA SINCRONIZACIÓN CON LA WEB"));       break;

        case TIMEOUT:                   tft.setCursor(120, 420);                                        tft.println(convertSpecialCharactersToHEX("FALLÓ LA AUTENTICACIÓN EN LA WEB"));         break;

        case UNKNOWN_ERROR:             tft.setCursor(300, 420);                                        tft.println("ERROR DESCONOCIDO");                                                       break;

        default:    break;
    }
    // ----------------------------------------------------------------------------------------------------

}









/*********************************************************************************************************/
/*-------------------------------------------------------------------------------------------------------*/
/*-------------------------------- PANTALLAS DE AYUDA ---------------------------------------------------*/
/*-------------------------------------------------------------------------------------------------------*/
/*********************************************************************************************************/


/*-------------------------------------------------------------------------------------------------------*/
/*--------------------------------- PEDIR RECIPIENTE ----------------------------------------------------*/
/*-------------------------------------------------------------------------------------------------------*/

/*---------------------------------------------------------------------------------------------------------
   pedirRecipiente(): Pide colocar un recipiente (STATE_Init)
----------------------------------------------------------------------------------------------------------*/
void pedirRecipiente()
{
    showingTemporalScreen = true; // Activar flag de estar mostrando pantalla temporal/transitoria

    // ************ TEXTO ********************************************************************************
    // ----- FONDO VERDE -----------
    tft.clearScreen(VERDE_PEDIR_Y_EXITO); // Fondo verde en PAGE1

    // ----- INTERNAL FIXED 12x24 X3 --------------
    tft.selectInternalFont(RA8876_FONT_SIZE_24);
    tft.setTextScale(RA8876_TEXT_W_SCALE_X3, RA8876_TEXT_H_SCALE_X3); 
    tft.setTextForegroundColor(WHITE); 

    if(comidaActual.isComidaEmpty()){ // Si no hay nada que se pueda guardar (comida vacía), solo se pide recipiente
        tft.setCursor(130, 90);                                         tft.println("COLOQUE UN RECIPIENTE"); // 12x24 escalado x3
        tft.setCursor(150, tft.getCursorY() + tft.getTextSizeY()-10);   tft.print("EN LA ZONA DE PESADA"); // 12x24 escalado x3
    }
    else{ // Si se puede guardar comida, también se da esa opción
        tft.setCursor(130, 90);                                         tft.println("COLOQUE UN RECIPIENTE"); 
        tft.setCursor(190, tft.getCursorY() + tft.getTextSizeY()-10);   tft.print("O GUARDE LA COMIDA"); 
    }     
    // ****************************************************************************************************

    // ************ CÍRCULO *******************************************************************************
    tft.fillCircle(512,380,65,WHITE); // 65 pixeles de diametro
    // ****************************************************************************************************

    // -------- INT -------------------
    if(eventOccurred()) return; // Evento de interrupción (botonera o báscula)

    // ----- ESPERA E INTERRUPCION ----------------
    if(doubleDelayAndCheckInterrupt(600)) return;

    // ************ CUADRADO REDONDEADO *******************************************************************
    tft.fillRoundRect(447,315,577,445,10,WHITE); // x = 512 +/- 65 = 447   ->   y = 380 +/- 65 = 315
    // ****************************************************************************************************
    
    // ----- ESPERA E INTERRUPCION ----------------
    if(doubleDelayAndCheckInterrupt(600)) return;

    // ************ PALITOS *******************************************************************************
    //PAG 5 ==> palitos alrededor cuadrado. 4 pixeles entre barra y barra
    // Palitos izquierda 
    tft.fillRect(430, 366, 447, 374, WHITE); // Arriba (17x8)
    tft.fillRect(422, 378, 447, 386, WHITE); // Central (25x8)
    tft.fillRect(430, 390, 447, 398, WHITE); // Abajo (17x8)
    // Palitos derecha 
    tft.fillRect(577, 366, 594, 374, WHITE); // Arriba (17x8)
    tft.fillRect(577, 378, 602, 386, WHITE); // Central (25x8)
    tft.fillRect(577, 390, 594, 398, WHITE); // Abajo (17x8)
    // Palitos arriba 
    tft.fillRect(498, 298, 506, 315, WHITE); // Izquierda (8x17)
    tft.fillRect(510, 290, 518, 315, WHITE); // Central (8x25)
    tft.fillRect(522, 298, 530, 315, WHITE); // Derecha (8x17)
    // Palitos abajo 
    tft.fillRect(498, 445, 506, 462, WHITE); // Izquierda (8x17)
    tft.fillRect(510, 445, 518, 470, WHITE); // Central (8x25)
    tft.fillRect(522, 445, 530, 462, WHITE); // Derecha (8x17)
    // ****************************************************************************************************
    
    // ----- ESPERA E INTERRUPCION ----------------
    if(doubleDelayAndCheckInterrupt(400)) return;
    if(doubleDelayAndCheckInterrupt(400)) return;
    // ------------------------------------------------------------------------------------------------------

    // *********** BRAINS (120X108) *************************************************************************
    // **** BRAIN 1 ********************************************
    // BRAIN1 (120x108) --> centrar en el cuadrado blanco
    tft.bteMemoryCopy(PAGE2_START_ADDR,SCREEN_WIDTH,0,170,PAGE1_START_ADDR,SCREEN_WIDTH,450,325,120,108); // Mostrar brain1 en PAGE1
    // *********************************************************

    // ----- ESPERA E INTERRUPCION ----------------
    if(doubleDelayAndCheckInterrupt(400)) return;
    if(doubleDelayAndCheckInterrupt(400)) return;

    // **** BRAIN 2 ********************************************
    // BRAIN2G (99x83) (verde)
    tft.bteMemoryCopy(PAGE2_START_ADDR,SCREEN_WIDTH,121,170,PAGE1_START_ADDR,SCREEN_WIDTH,450,325,120,108); // Mostrar brain2G en PAGE1
    // *********************************************************

    // ----- ESPERA E INTERRUPCION ----------------
    if(doubleDelayAndCheckInterrupt(400)) return;
    if(doubleDelayAndCheckInterrupt(400)) return;
    // ****************************************************************************************************
    
}

/*---------------------------------------------------------------------------------------------------------
   recipienteColocado(): Muestra mensaje de recipiente colocado
----------------------------------------------------------------------------------------------------------*/
void recipienteColocado()
{
    showingTemporalScreen = true; // Activar flag de estar mostrando pantalla temporal/transitoria

    // ----- TEXTO (RECIPIENTE COLOCADO) -------------------------------------------------------------------
    tft.clearScreen(VERDE_PEDIR_Y_EXITO); // Fondo verde en PAGE1
    // ------ LINEA ---------
    tft.fillRoundRect(252,200,764,208,3,WHITE);
    // ------ TEXTO ---------
    tft.selectInternalFont(RA8876_FONT_SIZE_24);
    tft.setTextScale(RA8876_TEXT_W_SCALE_X3, RA8876_TEXT_H_SCALE_X3); 
    tft.setTextForegroundColor(WHITE); 
    tft.setCursor(170, 258);  tft.println("RECIPIENTE COLOCADO"); // 12x24 escalado x3. Color texto foreground a WHITE en STATE_Init
    // ------ LINEA ---------
    tft.fillRoundRect(252,380,764,388,3,WHITE);
    // ----------------------------------------------------------------------------------------------------
}

/*---------------------------------------------------------------------------------------------------------
   recipienteRetirado(): Muestra mensaje de recipiente retirado
----------------------------------------------------------------------------------------------------------*/
void recipienteRetirado()
{
    showingTemporalScreen = true; // Activar flag de estar mostrando pantalla temporal/transitoria

    // ----- TEXTO (PLATO RETIRADO) -----------------------------------------------------------------------
    tft.clearScreen(VERDE_PEDIR_Y_EXITO); // Fondo verde en PAGE1
    // ------ LINEA ---------
    tft.fillRoundRect(252,200,764,208,3,WHITE);
    // ------ TEXTO ---------
    tft.selectInternalFont(RA8876_FONT_SIZE_24);
    tft.setTextScale(RA8876_TEXT_W_SCALE_X3, RA8876_TEXT_H_SCALE_X3); 
    tft.setTextForegroundColor(WHITE); 
    tft.setCursor(170, 258);  tft.println("RECIPIENTE RETIRADO"); // 12x24 escalado x3. Color texto foreground a WHITE en STATE_Init
    // ------ LINEA ---------
    tft.fillRoundRect(252,380,764,388,3,WHITE);
    // ----------------------------------------------------------------------------------------------------
}
/*------------------------------ FIN PEDIR RECIPIENTE ---------------------------------------------------*/






/*-------------------------------------------------------------------------------------------------------*/
/*--------------------------------- ESCOGER GRUPO -------------------------------------------------------*/
/*-------------------------------------------------------------------------------------------------------*/

/*---------------------------------------------------------------------------------------------------------
   pedirGrupoAlimentos(): Pide escoger grupo de alimentos, tras haber colocado recipiente (STATE_Plato)

   TODO: DIBUJAR BORDE DE RECTANGULO REDONDEADO (VARIAS VECES POR GROSOR) DEL COLOR DEL FONDO Y PONERLO 
          ENCIMA DE LAS IMÁGENES DE GRUPOS PARA TAPAR LAS SOMBRAS EN LAS ESQUINAS.
----------------------------------------------------------------------------------------------------------*/
void pedirGrupoAlimentos()
{
    showingTemporalScreen = true; // Activar flag de estar mostrando pantalla temporal/transitoria
    bool pulsacion = true;

    // ***** FONDO VERDE ***********
    tft.clearScreen(VERDE_PEDIR_Y_EXITO); // Fondo verde en PAGE1


    // ******* TEXTO (INTERNAL FIXED 12x24 X3) ***********************************************************
    tft.selectInternalFont(RA8876_FONT_SIZE_24);
    tft.setTextScale(RA8876_TEXT_W_SCALE_X3, RA8876_TEXT_H_SCALE_X3); 
    tft.setTextForegroundColor(WHITE); 
    tft.setCursor(130, 50);                                           tft.println("SELECCIONE UN GRUPO"); // 12x24 escalado x3. Color texto foreground a WHITE en STATE_Init
    tft.setCursor(255, tft.getCursorY() + tft.getTextSizeY()-10);     tft.print("DE ALIMENTOS"); 

    // ----- ESPERA E INTERRUPCION ----------------
    if(doubleDelayAndCheckInterrupt(400)) return;
    if(doubleDelayAndCheckInterrupt(400)) return;
    if(doubleDelayAndCheckInterrupt(200)) return;
    // ****************************************************************************************************


    // ************ LINEAS ********************************************************************************
    tft.fillRoundRect(0,250,220,258,3,WHITE);
    tft.fillRoundRect(0,450,512,458,3,WHITE);

    // ----- ESPERA E INTERRUPCION ----------------
    if(doubleDelayAndCheckInterrupt(400)) return;
    if(doubleDelayAndCheckInterrupt(400)) return;
    if(doubleDelayAndCheckInterrupt(200)) return;
    // ****************************************************************************************************


    // ************ GRUPOS ********************************************************************************
    // 30 pixeles entre cuadro y cuadro
    // Mostrar en PAGE1 (copiar de PAGE3 a PAGE1)

    // ------ Grupo 1 (130x125) ---------
    //tft.bteMemoryCopy(PAGE3_START_ADDR,SCREEN_WIDTH,0,0,PAGE1_START_ADDR,SCREEN_WIDTH,236,288,130,125); // x = 236  ->  y = 288
    slowAppearanceImage(SLOW_APPEAR_GRUPO1);

    // DIBUJAR BORDE DE RECTANGULO REDONDEADO (VARIAS VECES POR GROSOR) DEL COLOR DEL FONDO Y PONERLO ENCIMA 
    // DE LAS IMÁGENES DE GRUPOS PARA TAPAR LAS SOMBRAS EN LAS ESQUINAS.

    // ----- ESPERA E INTERRUPCION ----------------
    if(doubleDelayAndCheckInterrupt(400)) return;
    if(doubleDelayAndCheckInterrupt(400)) return;

    // ------ Grupo 2 (130x125) ---------
    //tft.bteMemoryCopy(PAGE3_START_ADDR,SCREEN_WIDTH,131,0,PAGE1_START_ADDR,SCREEN_WIDTH,396,288,130,125); // x = <grupo1(236) + grupo1(130) + 30 = 396  ->  y = 288
    slowAppearanceImage(SLOW_APPEAR_GRUPO2);

    // ----- ESPERA E INTERRUPCION ----------------
    if(doubleDelayAndCheckInterrupt(400)) return;
    if(doubleDelayAndCheckInterrupt(400)) return;

    // ------ Grupo 3 (130x125) ---------
    //tft.bteMemoryCopy(PAGE3_START_ADDR,SCREEN_WIDTH,262,0,PAGE1_START_ADDR,SCREEN_WIDTH,556,288,130,125); // x = <grupo2(396) + grupo2(130) + 30 = 556  ->  y = 288
    slowAppearanceImage(SLOW_APPEAR_GRUPO3);

    // ----- ESPERA E INTERRUPCION ----------------
    if(doubleDelayAndCheckInterrupt(400)) return;
    if(doubleDelayAndCheckInterrupt(400)) return;

    // ------ Grupo 4 (130x125) ---------
    //tft.bteMemoryCopy(PAGE3_START_ADDR,SCREEN_WIDTH,393,0,PAGE1_START_ADDR,SCREEN_WIDTH,716,288,130,125); // x = <grupo3(556) + grupo3(130) + 30 = 716  ->  y = 288
    slowAppearanceImage(SLOW_APPEAR_GRUPO4);

    // ----- ESPERA E INTERRUPCION ----------------
    if(doubleDelayAndCheckInterrupt(400)) return;
    if(doubleDelayAndCheckInterrupt(400)) return;
    // ****************************************************************************************************


    // ************ DESPLAZAR MANO PARA SIMULAR MOVIMIENTO ************************************************
    // MANO por el camino
    if(desplazar_mano(MANO_Y_PULSACION_GRUPOS)) return; // Si ha ocurrido interrupción mientras se desplazaba la mano, se sale de la función.
    // ****************************************************************************************************


    // ******** ALTERNANCIA 2 PULSACIONES *****************************************************************
    // Tras trasladar la mano, no hay pulsación. Se van a hacer dos alternancias de pulsación,
    // es decir: pulsacion - no pulsacion - pulsacion - no pulsacion
    // ----- ESPERA E INTERRUPCION ----------------
    if(doubleDelayAndCheckInterrupt(400)) return;
    if(doubleDelayAndCheckInterrupt(400)) return;
    if(doubleDelayAndCheckInterrupt(200)) return;

    for(byte i = 0; i < 4; i++){
        if(pulsacion) con_pulsacion(MANO_Y_PULSACION_GRUPOS);
        else sin_pulsacion(MANO_Y_PULSACION_GRUPOS);
        if(doubleDelayAndCheckInterrupt(400)) return;
        if(doubleDelayAndCheckInterrupt(400)) return;
        if(doubleDelayAndCheckInterrupt(200)) return;
        pulsacion = !pulsacion;
    }
    // ****************************************************************************************************

}

/*---------------------------------------------------------------------------------------------------------
   desplazar_mano(): Desplazar imagen de "mano" por la pantalla simulando movimiento hasta botón correspondiente.
        Return:   true: ha habido interrupción    false: no ha habido interrupción
            Devuelve bool para salir de la función que llamó de desplazar_mano() si hubo interrupción.  
----------------------------------------------------------------------------------------------------------*/
bool desplazar_mano(byte option)
{
    int alto, posY;

    switch(option){
        case MANO_Y_PULSACION_ANADIR: // Añadir
        case MANO_Y_PULSACION_ELIMINAR: // Eliminar
              // 1 - MANO por el camino
              alto = 128; posY = 580;
              while(posY >= 510){
                  // manoWppt
                  tft.bteMemoryCopyWithChromaKey(PAGE3_START_ADDR,SCREEN_WIDTH,251,292,PAGE1_START_ADDR,SCREEN_WIDTH,430,posY,120,128,WHITE); // Mostrar manoWppt (120x128)
                  delay(50);
                  tft.clearArea(430,posY,567,posY + alto,AMARILLO_CONFIRM_Y_AVISO); // Desaparece de esa zona para aparecer en otra --> se mueve
                  posY -= 10; // Subimos verticalmente la imagen 10 píxeles
                  // -------- INT -------------------
                  if(eventOccurred()) return true; // Evento de interrupción (botonera o báscula) 
              }
              
              // 2 - Botón correspondiente --> para superponerse a la última mano y que desaparezca para simular el movimiento
              if(option == MANO_Y_PULSACION_ANADIR) tft.bteMemoryCopy(PAGE3_START_ADDR,SCREEN_WIDTH,645,0,PAGE1_START_ADDR,SCREEN_WIDTH,420,380,172,130); // Mostrar añadir (172x130) 
              else tft.bteMemoryCopy(PAGE3_START_ADDR,SCREEN_WIDTH,818,0,PAGE1_START_ADDR,SCREEN_WIDTH,420,380,172,130); // Mostrar borrar (172x130)
              
              // 3 - Movimiento final de la mano (manoWppt)
              tft.bteMemoryCopyWithChromaKey(PAGE3_START_ADDR,SCREEN_WIDTH,251,292,PAGE1_START_ADDR,SCREEN_WIDTH,430,472,120,128,WHITE); // Mostrar manoWppt (120x128)
              delay(50);

              // -------- INT -------------------
              if(eventOccurred()) return true; // Evento de interrupción (botonera o báscula) 
              
              break;


        case MANO_Y_PULSACION_GUARDAR: // Guardar
              // 1 - MANO por el camino
              alto = 128; posY = 590;
              while(posY >= 530){
                  // manoWppt
                  tft.bteMemoryCopyWithChromaKey(PAGE3_START_ADDR,SCREEN_WIDTH,251,292,PAGE1_START_ADDR,SCREEN_WIDTH,420,posY,120,128,WHITE); // Mostrar manoWppt (120x128)
                  delay(50);
                  tft.clearArea(420,posY,557,posY + alto,AMARILLO_CONFIRM_Y_AVISO); // Desaparece de esa zona para aparecer en otra --> se mueve
                  posY -= 10; // Subimos verticalmente la imagen 10 píxeles
                  // -------- INT -------------------
                  if(eventOccurred()) return true; // Evento de interrupción (botonera o báscula)
              }
              
              // 2 - Botón guardar --> para superponerse a la última mano y que desaparezca para simular el movimiento
              tft.bteMemoryCopy(PAGE3_START_ADDR,SCREEN_WIDTH,0,131,PAGE1_START_ADDR,SCREEN_WIDTH,420,400,172,130); // Mostrar guardar (172x130)
              
              // 3 - Movimiento final de la mano (manoWppt)
              tft.bteMemoryCopyWithChromaKey(PAGE3_START_ADDR,SCREEN_WIDTH,251,292,PAGE1_START_ADDR,SCREEN_WIDTH,420,492,120,128,WHITE); // Mostrar manoWppt (120x128)    
              delay(50);

              // -------- INT -------------------
              if(eventOccurred()) return true; // Evento de interrupción (botonera o báscula) 
              
              break;


        case MANO_Y_PULSACION_GRUPOS: // Grupos
              // 1 - MANO por el camino
              alto = 127; posY = 480;
              while(posY >= 410){
                  // manoGppt
                  tft.bteMemoryCopyWithChromaKey(PAGE3_START_ADDR,SCREEN_WIDTH,525,1,PAGE1_START_ADDR,SCREEN_WIDTH,566,posY,119,127,VERDE_PEDIR_Y_EXITO); // Transparencia manoGppt (120x128)
                  delay(50);
                  if(posY < 413) posY = 413; // Solo afecta al penúltimo movimiento de la mano, para evitar que se borre parte del grupo3 que está debajo
                  tft.clearArea(556,posY,690,posY + alto+5,VERDE_PEDIR_Y_EXITO); // Desaparece de esa zona para aparecer en otra --> se mueve
                  posY -= 10; // Subimos verticalmente la imagen 10 píxeles
                  // -------- INT -------------------
                  if(eventOccurred()) return true; // Evento de interrupción (botonera o báscula) 
              }
              posY = 400;
              while(posY >= 380){
                  // Mostrar grupo3 (130x125). Para superponerse a la mano, que aún se está "moviendo"
                  tft.bteMemoryCopy(PAGE3_START_ADDR,SCREEN_WIDTH,262,0,PAGE1_START_ADDR,SCREEN_WIDTH,556,288,130,125); 
                  
                  // Mostrar mano (manoGppt)
                  tft.bteMemoryCopyWithChromaKey(PAGE3_START_ADDR,SCREEN_WIDTH,525,1,PAGE1_START_ADDR,SCREEN_WIDTH,566,posY,119,127,VERDE_PEDIR_Y_EXITO); // Transparencia manoGppt (120x128)
                  
                  delay(50);
                  // -------- INT -------------------
                  if(eventOccurred()) return true; // Evento de interrupción (botonera o báscula) 

                  if(posY == 400) tft.clearArea(556,413,690,528,VERDE_PEDIR_Y_EXITO); // Se borra desde y = 413 para no borrar parte del botón. Solo se borra en la primera iteración del bucle
                  posY -= 20;
              }

              break;

        default: break;
    }

    return false; // Si no ha ocurrido ninguna interrupción mientras se desplazaba la mano,
                  // se continúa con la función que llamó a esta.
}

/*---------------------------------------------------------------------------------------------------------
   sin_pulsacion(): Mostrar la "mano" sobre el botón sin pulsación
----------------------------------------------------------------------------------------------------------*/
void sin_pulsacion(byte option)
{
    switch(option){
        case MANO_Y_PULSACION_ANADIR: // Añadir
        case MANO_Y_PULSACION_ELIMINAR: // Eliminar
              // 1 - Borrar todo (botón, mano y pulsación)
              tft.clearArea(400,370,612,620,AMARILLO_CONFIRM_Y_AVISO); // Empieza en la esquina superior izquierda de la pulsación y termina al final de la mano
              
              // 2 - Botón correspondiente --> para superponerse a la última mano y que desaparezca para simular el movimiento
              if(option == MANO_Y_PULSACION_ANADIR) tft.bteMemoryCopy(PAGE3_START_ADDR,SCREEN_WIDTH,645,0,PAGE1_START_ADDR,SCREEN_WIDTH,420,380,172,130); // Mostrar añadir (172x130) 
              else tft.bteMemoryCopy(PAGE3_START_ADDR,SCREEN_WIDTH,818,0,PAGE1_START_ADDR,SCREEN_WIDTH,420,380,172,130); // Mostrar borrar (172x130)
              
              // 3 - Movimiento final de la mano (manoWppt)
              // manoWppt
              tft.bteMemoryCopyWithChromaKey(PAGE3_START_ADDR,SCREEN_WIDTH,251,292,PAGE1_START_ADDR,SCREEN_WIDTH,430,472,120,128,WHITE); // Transparencia manoWppt (120x128)
              
              break;


        case MANO_Y_PULSACION_GUARDAR: // Guardar
              // 1 - Borrar todo (botón, mano y pulsación)
              tft.clearArea(400,390,612,660,AMARILLO_CONFIRM_Y_AVISO); // Empieza en la esquina superior izquierda de la pulsación y termina al final de la mano
              
              // 2 - Botón guardar --> para superponerse a la última mano y que desaparezca para simular el movimiento
              tft.bteMemoryCopy(PAGE3_START_ADDR,SCREEN_WIDTH,0,131,PAGE1_START_ADDR,SCREEN_WIDTH,420,400,172,130); // Mostrar guardar (172x130)

              // 3 - Movimiento final de la mano (manoWppt)
              tft.bteMemoryCopyWithChromaKey(PAGE3_START_ADDR,SCREEN_WIDTH,251,292,PAGE1_START_ADDR,SCREEN_WIDTH,420,492,120,128,WHITE); // Transparencia manoWppt (120x128)
              
              break;


        case MANO_Y_PULSACION_GRUPOS: // Grupos
              // 1 - Borrar todo (grupo, mano y pulsación)
              tft.clearArea(546,278,690,528,VERDE_PEDIR_Y_EXITO); // Empieza en la esquina superior izquierda de la pulsación y termina al final de la mano

              // 2 - Mostrar grupo3 (130x125)
              tft.bteMemoryCopy(PAGE3_START_ADDR,SCREEN_WIDTH,262,0,PAGE1_START_ADDR,SCREEN_WIDTH,556,288,130,125); 

              // 3 - Mostrar mano (manoGppt)
              tft.bteMemoryCopyWithChromaKey(PAGE3_START_ADDR,SCREEN_WIDTH,525,1,PAGE1_START_ADDR,SCREEN_WIDTH,566,380,119,127,VERDE_PEDIR_Y_EXITO); // Transparencia manoGppt (120x128)

              break;

        default: break;
    }

}

/*---------------------------------------------------------------------------------------------------------
   con_pulsacion(): Simular pulsación causada por la "mano" sobre botón.
----------------------------------------------------------------------------------------------------------*/
void con_pulsacion(byte option)
{
    int x1, y1, x2, y2;

    switch(option){
        case MANO_Y_PULSACION_ANADIR: // Añadir
        case MANO_Y_PULSACION_ELIMINAR: // Eliminar
              // 1 - Borrar todo (botón, mano y pulsación)
              tft.clearArea(400,370,612,620,AMARILLO_CONFIRM_Y_AVISO); // Empieza en la esquina superior izquierda de la pulsación y termina al final de la mano
              
              // 2 - Botón correspondiente --> para superponerse a la última mano y que desaparezca para simular el movimiento
              if(option == MANO_Y_PULSACION_ANADIR) tft.bteMemoryCopy(PAGE3_START_ADDR,SCREEN_WIDTH,645,0,PAGE1_START_ADDR,SCREEN_WIDTH,420,380,172,130); // Mostrar añadir (172x130) 
              else tft.bteMemoryCopy(PAGE3_START_ADDR,SCREEN_WIDTH,818,0,PAGE1_START_ADDR,SCREEN_WIDTH,420,380,172,130); // Mostrar borrar (172x130)
              
              // 3 - Pulsación
              // ------------ CUADRADO ESQUINADO (PULSACION) --------------------------------------------------------   
              // No se puede modificar el grosor de las líneas ni de los bordes de las figuras. Por eso se dibujan varios
              // cuadrados normales, separados por 1 píxel en cada dirección, para simular un grosor mayor.
              for (byte i = 0; i <= 10; i++) {
                  x1 = 425 - i;   y1 = 383 - i;   
                  x2 = 590 + i;   y2 = 505 + i;
                  tft.drawRect(x1,y1,x2,y2,RED_BUTTON); // Alrededor de añadir
              }
              // ----------------------------------------------------------------------------------------------------

              // 4 - Mano
              // ------------ MANO (120x129) ------------------------------------------------------------------------
              // Mano (manoWppt) final pulsando
              tft.bteMemoryCopyWithChromaKey(PAGE3_START_ADDR,SCREEN_WIDTH,251,292,PAGE1_START_ADDR,SCREEN_WIDTH,430,472,120,128,WHITE); // Transparencia manoWppt (120x128)
              // ----------------------------------------------------------------------------------------------------

              // 5 - Rayitas pulsación
              // ------------ RAYITAS (PULSACION) ------------------
              // Línea izquierda
              for (byte i = 0; i <= 4; i++) {
                  x1 = 448 + i;   y1 = 447;   
                  x2 = 458 + i;   y2 = 467;
                  tft.drawLine(x1, y1, x2, y2, RED_BUTTON);
              }

              // Línea central
              for (byte i = 0; i <= 4; i++) {
                  x1 = 468 + i;   y1 = 442;   
                  x2 = 468 + i;   y2 = 462;
                  tft.drawLine(x1, y1, x2, y2, RED_BUTTON);
              }

              // Línea derecha
              for (byte i = 0; i <= 4; i++) {
                  x1 = 478 + i;   y1 = 467;   
                  x2 = 488 + i;   y2 = 447;
                  tft.drawLine(x1, y1, x2, y2, RED_BUTTON);
              }
              // ---------------------------------------------------

              break;


        case MANO_Y_PULSACION_GUARDAR: // Guardar
              // 1 - Borrar todo (botón, mano y pulsación)
              tft.clearArea(400,410,612,660,AMARILLO_CONFIRM_Y_AVISO); // Empieza en la esquina superior izquierda de la pulsación y termina al final de la mano
              
              // 2 - Botón guardar --> para superponerse a la última mano y que desaparezca para simular el movimiento
              tft.bteMemoryCopy(PAGE3_START_ADDR,SCREEN_WIDTH,0,131,PAGE1_START_ADDR,SCREEN_WIDTH,420,400,172,130); // Mostrar guardar (172x130)

              // 3 - Pulsación
              // ------------ CUADRADO ESQUINADO (PULSACION) --------------------------------------------------------   
              // No se puede modificar el grosor de las líneas ni de los bordes de las figuras. Por eso se dibujan varios
              // cuadrados normales, separados por 1 píxel en cada dirección, para simular un grosor mayor.
              for (byte i = 0; i <= 10; i++) {
                  x1 = 425 - i;   y1 = 403 - i;   
                  x2 = 590 + i;   y2 = 525 + i;
                  tft.drawRect(x1,y1,x2,y2,RED_BUTTON); // Alrededor de añadir
              }
              // ----------------------------------------------------------------------------------------------------

              // 4 - Mano
              // ------------ MANO (120x129) ------------------------------------------------------------------------
              // Mano (manoWppt) final pulsando
              tft.bteMemoryCopyWithChromaKey(PAGE3_START_ADDR,SCREEN_WIDTH,251,292,PAGE1_START_ADDR,SCREEN_WIDTH,420,492,120,128,WHITE); // Transparencia manoWppt (120x128)
              // ----------------------------------------------------------------------------------------------------

              // 5 - Rayitas pulsación
              // ------------ RAYITAS (PULSACION) ------------------
              // Línea izquierda
              for (byte i = 0; i <= 4; i++) {
                  x1 = 438 + i;   y1 = 467;   
                  x2 = 448 + i;   y2 = 487;
                  tft.drawLine(x1, y1, x2, y2, RED_BUTTON);
              }

              // Línea central
              for (byte i = 0; i <= 4; i++) {
                  x1 = 458 + i;   y1 = 462;   
                  x2 = 458 + i;   y2 = 482;
                  tft.drawLine(x1, y1, x2, y2, RED_BUTTON);
              }

              // Línea derecha
              for (byte i = 0; i <= 4; i++) {
                  x1 = 468 + i;   y1 = 487;   
                  x2 = 478 + i;   y2 = 467;
                  tft.drawLine(x1, y1, x2, y2, RED_BUTTON);
              }
              // ---------------------------------------------------
              break;


        case MANO_Y_PULSACION_GRUPOS: // Grupos
              // 1 - Borrar todo (grupo, mano y pulsación)
              tft.clearArea(546,278,690,528,VERDE_PEDIR_Y_EXITO); // Empieza en la esquina superior izquierda de la pulsación y termina al final de la mano
              
              // 2 - Volver a mostrar grupo3 (130x125)
              tft.bteMemoryCopy(PAGE3_START_ADDR,SCREEN_WIDTH,262,0,PAGE1_START_ADDR,SCREEN_WIDTH,556,288,130,125); 
              
              // 3 - Pulsación
              // ------------ CUADRADO ESQUINADO (PULSACION) --------------------------------------------------------   
              // No se puede modificar el grosor de las líneas ni de los bordes de las figuras. Por eso se dibujan varios
              // cuadrados normales, separados por 1 píxel en cada dirección, para simular un grosor mayor.
              for (byte i = 0; i <= 10; i++) {
                  x1 = 556 - i;   y1 = 288 - i;   
                  x2 = 680 + i;   y2 = 413 + i;
                  tft.drawRect(x1,y1,x2,y2,RED_BUTTON); // Alrededor de grupo3
              }
              // ----------------------------------------------------------------------------------------------------

              // 4 - Mano
              // ------------ MANO (120x129) ------------------------------------------------------------------------
              // Mano final pulsando (manoGppt)
              tft.bteMemoryCopyWithChromaKey(PAGE3_START_ADDR,SCREEN_WIDTH,525,1,PAGE1_START_ADDR,SCREEN_WIDTH,566,380,119,127,VERDE_PEDIR_Y_EXITO); // Transparencia manoGppt (120x128)
              // ----------------------------------------------------------------------------------------------------

              // 5 - Rayitas pulsación
              // ------------ RAYITAS (PULSACION) ------------------
              // Línea izquierda
              for (byte i = 0; i <= 4; i++) {
                  x1 = 584 + i;   y1 = 355;   
                  x2 = 594 + i;   y2 = 375;
                  tft.drawLine(x1, y1, x2, y2, RED_BUTTON);
              }

              // Línea central
              for (byte i = 0; i <= 4; i++) {
                  x1 = 604 + i;   y1 = 350;   
                  x2 = 604 + i;   y2 = 370;
                  tft.drawLine(x1, y1, x2, y2, RED_BUTTON);
              }

              // Línea derecha
              for (byte i = 0; i <= 4; i++) {
                  x1 = 614 + i;   y1 = 375;   
                  x2 = 624 + i;   y2 = 355;
                  tft.drawLine(x1, y1, x2, y2, RED_BUTTON);
              }
              // ---------------------------------------------------

              break;

        default: break;
    }
    
}

/*-------------------------------- FIN ESCOGER GRUPO ----------------------------------------------------*/



/*-------------------------------------------------------------------------------------------------------*/
/*--------------------------------- ESCANEAR BARCODE ----------------------------------------------------*/
/*-------------------------------------------------------------------------------------------------------*/

/*---------------------------------------------------------------------------------------------------------
   showScanningBarcode(): Indicar que se acerque el producto al lector para escanearlo
----------------------------------------------------------------------------------------------------------*/
void showScanningBarcode()
{
    showingTemporalScreen = true; // Activar flag de estar mostrando pantalla temporal/transitoria
    // En este caso es temporal en el sentido de que si no se lee barcode en 30 segundos, se regresa a lastValidState

    // ---- COLOR FONDO ------------------------------------------------------------------------------
    // Aplicar color al fondo
    tft.clearScreen(AZUL_PROCESO); // 0x037F en RGB565 (#006CFF en HEX) es el color que dio Guillermo, pero por el ángulo se ve celeste
    // -----------------------------------------------------------------------------------------------

    // ------ ICONO (CODIGO DE BARRAS) --------------------------------------------------------------------
    tft.bteMemoryCopy(PAGE4_START_ADDR,SCREEN_WIDTH,0,137,PAGE1_START_ADDR,SCREEN_WIDTH,427,100,171,128); // Mostrar scan (171x128) en PAGE1
    // ----------------------------------------------------------------------------------------------------

    // ------------ LINEA ---------------------------------------------------------------------------------
    tft.fillRoundRect(210,280,814,288,3,WHITE);
    // ----------------------------------------------------------------------------------------------------

    // ------ TEXTO (COMENTARIO) --------------------------------------------------------------------------
    tft.selectInternalFont(RA8876_FONT_SIZE_24);
    tft.setTextScale(RA8876_TEXT_W_SCALE_X2, RA8876_TEXT_H_SCALE_X2);
    tft.setCursor(140, 338);                                            tft.println(convertSpecialCharactersToHEX("COLOQUE EL CÓDIGO DE BARRAS DEL"));
    tft.setCursor(130,tft.getCursorY() + tft.getTextSizeY() - 10);      tft.println("PRODUCTO A UNOS 10cms DEL LECTOR");
    tft.setCursor(180,tft.getCursorY() + tft.getTextSizeY() + 10);      tft.println(convertSpecialCharactersToHEX("El lector cambiará de color"));
    tft.setCursor(300,tft.getCursorY() + tft.getTextSizeY() - 20);      tft.println(convertSpecialCharactersToHEX("al leer el código"));
    // ----------------------------------------------------------------------------------------------------

}
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
