i62caroi/SmartCloth/v2.1 - src/smartcloth_v2/Grupos.h

/**
 * @file grupos.h
 * @brief Definiciones de grupos de alimentos
 *
 * @author Irene Casares Rodríguez
 * @date 31/05/25 (update valores nutricionales)
 * @version 1.0
 *
 * Este archivo contiene la definición de los grupos de alimentos y sus características.
 * 
 * @see https://cs.stanford.edu/people/miles/iso8859.html Colección de caracteres ASCII/ISO 8859-1 (Latin-1) en HEX
 * @see https://www.raio.com.tw/data_raio/Datasheet/RA887677/RA8876_Brief_DS_V11_Eng.pdf Table 14-1 (pag 99) del datasheet de RA8876 para caracteres Latin-1
 * 
 */


#ifndef GRUPOS_H
#define GRUPOS_H

#include "COLORS.h" // Colores del texto de nombre de grupo y ejemplos
#include "debug.h"  // SM_DEBUG --> SerialPC

 
#define NUM_GRUPOS 27 // 27 nuestros (crudos y cocinados), el de barcode se actualiza automáticamente con los valores buscado
#define BARCODE_PRODUCT_INDEX 50 // ID del grupo de alimentos para el barcode
#define ID_GRUPO_NOT_SELECTED 0 // ID de grupo no seleccionado



/*******************************************************************************
/*******************************************************************************
                          DECLARACIÓN FUNCIONES
/******************************************************************************/
/******************************************************************************/
void    setGrupoAlimentos(byte id);                             // Establece el grupo de alimentos seleccionado
void    updateGrupoActualFromBarcode(String &productInfo);    // Actualiza el grupo de alimentos seleccionado con la info del producto barcode leído

// --- CONVERSIÓN DE TEXTO ---
void    convertSpecialCharactersToHEX_ref(String &input);       // Convierte a HEX caracteres especiales en una cadena de texto pasada por referencia
String  convertSpecialCharactersToHEX(String input);            // Convierte a HEX caracteres especiales en una cadena de texto y devuelve la cadena modificada
/******************************************************************************/
/******************************************************************************/






/*******************************************************************************
/*******************************************************************************
                          GRUPOS DE ALIMENTOS
/******************************************************************************/
/******************************************************************************/

/*-----------------------------------------------------------------------------*/
/**
 * @struct Grupo
 * @brief Estructura que representa un grupo de alimentos.
 *
 * Esta estructura contiene información sobre un grupo de alimentos, como su ID, color, nombre,
 * ejemplos y contenido nutricional por gramo.
 */
/*-----------------------------------------------------------------------------*/
typedef struct {
    byte          ID_grupo;         /**< ID del grupo */
    uint16_t      color_grupo;      /**< Color del texto del grupo */
    String        Nombre_grupo;     /**< Nombre del grupo */
    String        Ejemplos_grupo;   /**< Ejemplos del grupo */
    float         Kcal_g;           /**< Calorías por gramo */
    float         Prot_g;           /**< Proteínas por gramo */
    float         Lip_g;            /**< Lípidos por gramo */
    float         Carb_g;           /**< Carbohidratos por gramo */

}Grupo;




//
// Si el grupo de alimentos seleccionado es de TIPO_A, necesita diferenciar entre crudo o cocinado porque sus valores
// nutricionales son diferentes según el caso. Para los de TIPO_B no importa si los cocinas o no. 
//
// Los IDs de los grupos van del 1 al 20 para los crudos y después van los de cocinado. Por ejemplo, el grupo 7 (Verduras y Hortalizas)
// es crudo, mientras que su correspondiente cocinado es el grupo 27. Por eso, si es un grupo de TIPO_A COCINADO se hace (buttonGrande+20)
// en checkAllButtons(), para acceder a los valores de ese grupo pero cocinado.
//
// Los grupos de TIPO_A son: 7 (27), 8 (28), 9 (29), 16 (36), 17 (37), 18 (38) y 19 (39)
// Los grupos de TIPO_B son: 1, 2, 3, 4, 5, 6, 10, 11, 12, 13, 14, 15 y 20
//
// El usuario puede escoger crudo o cocinado independientemente del grupo seleccionado y así se mostrará en pantalla, pero solo afectará
// a los valores si el grupo es de TIPO_A. Esto se hace porque el usuario no tiene por qué saber para qué grupos cambian los valores según
// si el alimento está crudo o cocinado.
//





                                    // ID | Color | Nombre | Ejemplos | Kcal | Proteinas | Lipidos | Carbohidratos
/*-----------------------------------------------------------------------------*/
/**
 * @var gruposAlimentos
 * @brief Arreglo de objetos Grupo que representa los grupos de alimentos.
 *
 * Este array almacena los distintos grupos de alimentos y sus características.
 */               
/*-----------------------------------------------------------------------------*/                    
Grupo gruposAlimentos[NUM_GRUPOS] = { 
                                        {1,COLOR_G1,"Lácteos enteros","Leche entera de vaca (pasteurizada o UHT), de oveja, de cabra, yogurt\n   natural entero, cuajada, etc.",0.69584,0.03576,0.04156,0.04831},
                                        {2,COLOR_G2,"Lácteos semidesnatados","Leche semidesnatada pasteurizada y UHT",0.4729,0.0332,0.0174,0.0495},
                                        {3,COLOR_G3,"Lácteos desnatados","Leche desnatada pasteurizada y UHT, natural, con frutas, yogurt desnatado,\n   yogurt desnatado de sabores, etc.",0.3393,0.0338,0.0028,0.0478},
                                        {4,COLOR_G4,"Lácteos azucarados","Batidos lácteos de cacao y otros sabores, leche entera fermentada con\n   frutas, yogures enteros de sabores y azucarados, yogures líquidos de\n   sabores y azucarados",0.8598,0.0301,0.0257,0.1316},
                                        {5,COLOR_G5,"Postres lácteos","Arroz con leche, flan de huevo, flan de vainilla y natillas...",1.8484,0.0356,0.0806,0.2478},
                                        {6,COLOR_G6,"Frutas frescas, desecadas y zumos","Albaricoque, arándanos, cerezas, ciruelas, dátil seco, fresa, granada,\n   higos, kiwi, mandarina,manzana, melocotón, melón, naranja, pera, piña,\n   plátano, sandía, uvas...",0.48055,0.00801,0.002497,0.11196},
                                        {7,COLOR_G7,"Verduras y hortalizas","Acelgas, apio, alcachofa, berenjena, brócoli, calabacín, calabaza,\n   champiñones, col, espárragos, espinacas, guisantes, lechuga, judías,\n   pimientos, tomate, zanahoria, etc.",0.2454,0.0148,0.0037,0.0412},
                                        {8,COLOR_G8,"Cereales y tubérculos","Arroz, avena, boniato, castaña, cereales de desayuno ricos en fibra,\n   copos de maíz, harina, maíz, pan, pasta, patata, sémola de trigo, etc.",2.1053,0.0622,0.0142,0.4452},
                                        {9,COLOR_G9,"Legumbres","Alubias, garbanzos, lentejas, etc.",3.2236,0.2148,0.0327,0.5523},
                                        {10,COLOR_G10,"Repostería, pastelería y otros","Bizcocho, bollo, croissant, ensaimada, galletas (de cualquier tipo),\n   magdalena, muesli, pan de pasas, tartas, pasteles, bollería industrial...",3.8946,0.0728,0.1420,0.5055},
                                        {11,COLOR_G11,"Alimentos ricos en grasas saludables","Aceites de cacahuete, de oliva y de hígado de bacalao, aceitunas,\n   aguacate, almendras, avellanas, cacahuetes, pistachos, mayonesa de aceite\n   de oliva, etc.",7.2833,0.0289,0.7881,0.0343},
                                        {12,COLOR_G12,"Alimentos ricos en grasas vegetales","Aceite de girasol, aceite de maíz, aceite de soja, mayonesa light, nueces,\n   piñones, etc.",8.4623,0.0249,0.9329,0.0249},
                                        {13,COLOR_G13,"Alimentos ricos en grasas saturadas","Coco fresco o seco, aceite de coco, mantequilla, nata líquida para cocinar\n   o montar, etc.",5.6178,0.0126,0.6115,0.0178},
                                        {14,COLOR_G14,"Alimentos muy grasos (mezclas)","Margarina light, margarina vegetal enriquecida, manteca y tocino de cerdo",8.2686,0.0107,0.9136,0.0007},
                                        {15,COLOR_G15,"Azúcares y dulces","Azúcar blanco y moreno, miel, leche condensada, cacao soluble azucarado,\n   confitura de fruta baja en calorías",3.5162,0.0262,0.0247,0.8446},
                                        {16,COLOR_G16,"Alimentos proteicos con muy poca grasa","Pavo, pollo, ternera (entrecot y solomillo), jamón cocido, atún natural,\n   pescado no graso, marisco, queso granulado, clara de huevo, etc.",0.9947,0.1930,0.0176,0.0101},
                                        {17,COLOR_G17,"Alimentos proteicos con poca grasa","Lomo de cerdo, pollo sin piel, bistec de vaca/buey, jamón curado (sin\n   grasa), pescados grasos (atún, sardina, trucha, boquerón...), vísceras, pato\n   sin piel, codorniz, etc.",1.3896,0.1848,0.0705,0.0044},
                                        {18,COLOR_G18,"Alimentos proteicos semigrasos","Chuletas de cerdo, cordero, anchoas, atún o sardinas en aceite, caballa,\n   salmón, jamón curado con grasa, huevo, queso fresco, requesón, queso en\n   porciones, etc.",1.4769,0.1298,0.1067,0.0064},
                                        {19,COLOR_G19,"Alimentos proteicos grasos","Chuletas/costillas de cordero, chorizo, salchichas, fuet, quesos (azul,\n   babybel, camembert, cheddar, de cabra, emmental, gouda, gruyer, manchego...)",2.7904,0.2061,0.2160,0.0},
                                        {20,COLOR_G20,"Alimentos proteicos muy grasos","Carne picada sazonada, panceta de cerdo, morcilla, mortadela, paté,\n   salami, salchichón, etc.",3.1911,0.1335,0.2848,0.0351},
                                        {27,COLOR_G7,"Verduras y hortalizas","Acelgas, apio, alcachofa, berenjena, brócoli, calabacín, calabaza,\n   champiñones, col, espárragos, espinacas, guisantes, lechuga, judías,\n   pimientos, tomate, zanahoria, etc.",0.2282,0.0158,0.0037,0.0235},
                                        {28,COLOR_G8,"Cereales y tubérculos","Arroz, avena, boniato, castaña, cereales de desayuno ricos en fibra,\n   copos de maíz, harina, maíz, pan, pasta, patata, sémola de trigo, etc.",0.9617,0.0195,0.0051,0.2375},
                                        {29,COLOR_G9,"Legumbres","Alubias, garbanzos, lentejas, etc.",1.1762,0.0858,0.0146,0.1868},
                                        {36,COLOR_G16,"Alimentos proteicos con muy poca grasa","Pavo, pollo, ternera (entrecot y solomillo), jamón cocido, atún natural,\n   pescado no graso, marisco, queso granulado, clara de huevo, etc.",0.9450,0.1978,0.0131,0.0013},
                                        {37,COLOR_G17,"Alimentos proteicos con poca grasa","Lomo de cerdo, pollo sin piel, bistec de vaca/buey, jamón curado (sin\n   grasa), pescados grasos (atún, sardina, trucha, boquerón...), vísceras, pato\n   sin piel, codorniz, etc.",1.7312,0.2288,0.0838,0.0074},
                                        {38,COLOR_G18,"Alimentos proteicos semigrasos","Chuletas de cerdo, cordero, anchoas, atún o sardinas en aceite, caballa,\n   salmón, jamón curado con grasa, huevo, queso fresco, requesón, queso en\n   porciones, etc.",1.5525,0.1347,0.1126,0.0064},
                                        {39,COLOR_G19,"Alimentos proteicos grasos","Chuletas/costillas de cordero, chorizo, salchichas, fuet, quesos (azul,\n   babybel, camembert, cheddar, de cabra, emmental, gouda, gruyer, manchego...)",2.8156,0.1869,0.2260,0.0}
                                    };


// Grupo de alimentos seleccionado
Grupo grupoActual {ID_GRUPO_NOT_SELECTED,WHITE,"","",0.0,0.0,0.0,0.0}; 

// Grupo de alimentos seleccionado anteriormente, necesario para saber qué valores guardar al
// poner peso y luego escoger otro grupo, lo que confirma el peso puesto.
Grupo grupoAnterior {ID_GRUPO_NOT_SELECTED,WHITE,"","",0.0,0.0,0.0,0.0};


/******************************************************************************/
/******************************************************************************/
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
