i62caroi/SmartCloth/(commit log)

2023-03-21 Refinando
    Se añaden reglas de transición para raw/cooked y weighted. Se añade evento para liberar la bascula. Se modifican los pines de botoneras e interrupciones. Se simplifican los print de cada estado.
2023-03-21 Habilitados todos los prints
2023-03-21 grupos alimentos
    [grupos_alimentos.csv]
2023-03-22 Valores nutricionales actuales
    Calcular macronutrientes según peso.
    Imprimir en pantalla lo más parecido posible al prototipo web (solo la parte de comida actual y sin realmente sumar valores).
2023-03-26 Add ingrediente a plato, check evento previo y cambiar config columnas
    Añadir ingrediente al plato si ha habido un INCREMENTO (pesar ese ingrediente) seguido de TIPO_A o TIPO_B, indicando que se va a pasar a un nuevo ingrediente.
    Respecto a las columnas, todas las que no se estén revisando deben estar como INPUT para proteger eléctricamente los botones. Al chequearlas una a una, se van poniendo como OUTPUT y HIGH para saber si alguna fila que se cruza está a HIGH. Después, la columna chequeada se vuelve a configurar como INPUT.
2023-03-27 Interrupciones Main y protección eléctrica de matriz
    Se han utilizado los pines de la botonera Main como interrupciones que marcan directamente qué botón se ha pulsado, eliminando la necesidad del chip OR.
    Para proteger eléctricamente los puertos de los botones de la matriz (botonera Grande), al sondear se ponen todas las columnas como INPUT y solo se pone OUTPUT/HIGH la que se va a consultar, que posteriormente vuelve a ponerse como INPUT. Al final, todas vuelven a OUTPUT/HIGH para la interrupción.
2023-03-27 Reordenacion ficheros
    [grupos_alimentos.csv]
2023-03-29 Clases ValoresNutricionales, Ingrediente y Plato
    Al seleccionar nuevo grupo de alimentos, si había algo pesado, se añade el ingrediente al plato.
    A la próxima "iteración", aparece tarado de primeras pero es ficticio, aún no está implementada la tara manual.
2023-03-29 Limitación adición ingredientes
    Comprobar si ha cambiado el peso de la báscula desde la última vez que se escogió grupo de alimentos. Solo si ha cambiado se añade el ingrediente (alimento) al plato. Así evitamos que posteriores pulsaciones de botones realicen adiciones sucesivas del mismo alimento.
2023-03-29 Intento de tara
    Uso de variable 'displayedWeight' para mostrar como peso del alimento en lugar del peso total tomado. Utilizar esta variable para hacer una tara manual.
    Esto no sirve porque al actualizar el peso se actualiza el peso mostrado y volvemos al problema anterior.
    Se podría probar con 'diffWeight', pero varía con sucesivas tomas. Es decir, puede ser que al colocar un alimento se detecten varios incrementos hasta alcanzar el peso correcto, por lo que 'diffWeight' solo tomaría el valor del último salto, el cual no corresponde al peso completo del alimento colocado.
    IDEA!! Tomar la diferencia de peso entre el alimento guardado previamente y el peso (tras posibles saltos) de la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
2023-03-30 Tara funcional
    Realizar la tara manual era complicado ya que el peso no es estable como para pasar de 0 a x directamente, sino que puede dar algunos saltos hasta estabilizarse. Por eso era complicado tomar la diferencia con el peso anterior al tarar, porque es difícil señalar el peso anterior real.
    Se ha optado por volver a usar la función de tara de la librería HX711.h. Ha habido que modificar la máquina de estados para que haya una transición por DECREMENTO entre los estados de los grupos de alimentos, ya que al tarar se detecta un decremento que no estaba contemplado. Ahora parece que al guardar el alimento y tarar se realiza correctamente el pesado del siguiente alimento.
    Aún as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
2023-03-30 Nueva regla en estados groupA y groupB
    Además de las reglas de DECREMENTO para contemplar la tara, se han incluido unas reglas para que al retirar algo tras tarar pase a negativo.
2023-04-10 Estructura print
2023-04-10 Condensar print y añadir plato a comida
    Se han condensado las funcionalidades print, además de mostrar continuamente el procesamiento del alimento (crudo/cocinado).
    Por otro lado, se muestran los valores nutricionales del plato actual, que posteriormente se añade a la comida al indicar que se quiere incluir uno nuevo. El problema es que al hacer esto, los valores que ahora se muestran están a 0 porque son los del nuevo plato aún vacío.
    Se podría hacer mostrando la información de la comida directamente en lugar del plato, pero entonces habría que añadir el plato a la comida desde el primer momento e ir actualizando la comida conforme se añaden ingredientes al plato, no solo al que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
    [Comida.h]
2023-04-11 Add ingrediente y plato a comida
    1. - Añadir el ingrediente definitivo al plato y también a la comida para visualizar en tiempo real los valores de la comida. Al añadir otro plato ya se guarda oficialmente el plato completo en la comida, pero sin modificar los valores nutricionales y el peso, pues ya lo estaban.
    2.- No es obligatorio escoger crudo/cocinado desde grupoA si se desea crudo, pues es predeterminado.
    3.- Permitir seleccionar crudo/cocinado desde grupoB aunque no afecte a los valores.
    POR HACER:
    4.- Al querer añadir otro plato se pide liberar la balanza, pero al quitar lo último, que no todo, ya detecta liberación. Al quitarlo todo se queda en negativo y no se corrige tar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
    [Comida.h, Diario.h, ISR.h]
2023-04-13 Jaleo de tara y retiro de peso arreglado
    Parece que la tara se hace perfecta, al retirar el plato tras add/delete/save espera perfecto a que se retire el peso del plato, no solo a que llegue a 0. Si solo esperara el 0, se iría a negativo porque la tara lo puso a 0.
    Hay 4 eventos de descenso:
    - DECREMENTO (en valores positivos)
    - QUITAR (se quitan elementos, posiblemente pasando a valores negativos)
    - TARAR (báscula a 0 por tarar)
    - LIBERAR (báscula libre)
    También añadida la parte del acumulado de hoy, que muestra los valores tras guardar la comida completa.
    TODO:
    - Calcular las raciones según los valores.
    - Estado intermedio inicial para colocar el plato
    - Mensajes de error
    [Comida.h, Diario.h, smartcloth.ino]
2023-04-14 Errores de eventos y estado de plato
    Información de error cuando ocurre un evento que no se esperaba.
    Estado intermedio para colocar el plato antes de escoger grupo de alimentos al inicio y posteriormente tararlo.
    [smartcloth.ino]
2023-04-14 Refinar decrementos de peso
    Perfilar el decremento de peso en cada estado para que, si se libera la balanza, vuelva al init indicando que se ponga el plato.
    El problema es que si se libera cuando no toca, habría que limpiar la comida para que no se repita al volver a colocar las cosas. Aun así, no es normal que se quite todo en mitad del proceso.
2023-04-17 Finiquitado el retirar plato
    En el caso del STATE_Plato, basta con QUITAR peso y se vuelve al INI. Si hay INCREMENTO/DECREMENTO se considera una recolocación del recipiente.
    En los casos de add/delete/save, se tara la báscula y al ir retirando peso (bajando a negativo) se va comparando si se ha retirado la misma cantidad que la suma del peso del recipiente y el plato (alimentos). Si esto se cumple, con un margen de 5 gr, se entiende como LIBERAR y se vuelve al INI.
    Antes de llegar a LIBERAR se pasa por QUITAR, por eso se ha añadido como regla de transición en estos casos, además del TARAR.
2023-04-17 Cambio tamaño mensajes de error
2023-04-19 Ampliando límites de usabilidad
    Ya se puede add/delete/save desde STATE_groupA, STATE_groupB, STATE_raw y STATE_cooked. Desde el STATE_weighted se podía desde el principio.
    Además, se permite guardar comida (save) desde STATE_INI, STATE_added y STATE_deleted.
    Si estando en cualquiera de esos estados se quiere hacer add/delete/save, según se permita, pero el plato o la comida están vacíos, se muestra un mensaje de aviso indicando que no se ha realizado la acción, pues es innecesaria.
    Por otro lado, se han añadido reglas de transición de INCREMENTO en STATE_added, STATE_deleted y STATE_saved para que no salte error de evento cuando, al retirar el plato, se detecte un breve increme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
    [smartcloth.ino]
2023-04-19 Raciones y tamaño mensajes de guía
    Mostrar raciones correspondientes a los gramos de carbohidratos, lípidos y proteínas. No se están guardando las raciones, simplemente se muestra por pantalla el equivalente.
    Para guardarlas se podría modificar solamente la clase Diario y para cada Comida mostrar las equivalencias.
    Por otro lado, todos los mensajes de guía se han puesto con el mismo tamaño.
    Para que no "parpadee" la pantalla se podría dibujar un rectángulo negro en la zona superior y luego volver a escribir encima, de forma que parezca que solo esa parte se ha modificado. Igual con los valores, pero eso parece más complicado al no tener un tamaño fijo.
2023-04-26 Tests de imágenes y SD obtenidos de RA8876_Lite
2023-04-28 Mostrar imagen BMP desde SD
    En el convertidor de BMP se debe escoger '24 (True color)' para que tenga 24 de 'bit depth' y funcione la impresión.
    TODO => solo imprime desde el (0,0), pero no desde otro sitio, aunque lo indiques.
2023-05-02 drawPixels() y modificar velocidad SPI
    Función drawPixels() de Adafruit_RA8875 para escribir 2 bytes de pixel en lugar de 1, supuestamente mejorando la velocidad.
    También se ha incluido RA8876_SPI_SPEED_IMG para modificar la velocidad del SPI a 30MHz cada vez que se vaya a escribir una imagen y luego devolverla a 5MHz con RA8876_SPI_SPEED.
    Se ha hecho una prueba con esto y la imagen se muestra bastante rápido, pero después el texto se mueve mínimamente.
2023-05-02 GraphicMode
    Siempre está en modo gráfico, excepto cuando va a escribir, que activa el modo texto y luego lo desactiva.
    PROBAR:
    1.- Modo gráfico manual en las funciones de imágenes
    2.- drawPixels() en sdCardDraw24bppBMP(). Mirar por qué salían cambiados algunos colores. ¿Podría ser por las líneas 1635-1636, que ponía 'lcdidx = 0' antes de sumarlo a 'xpos'?
    3.- Aumentar la velocidad de SPI para imágenes
    Otro: aunque tarde mucho más en cargar el programa en el Arduino y ocupe casi un 80% de su flash, escribir el logo desde un .H es mucho más rápido que cargar un BMP desde la SD.
2023-05-08 Resize de imágenes en .H y print de crudo/cocinado
    Se ha disminuido el tamaño de las imágenes de crudo/cocinado guardadas en .h porque añadiendo esas dos a la del logo, se llena la Flash.
    Ahora mismo, con imágenes de logo/crudo/cocinado, además del programa en sí, se ocupa el 84% de la memoria.
    Mostrar imagen guardada en SD es extremadamente lento. No sé si por estar en SD o por ser BMP.
    Sin embargo, mostrar un vector de píxeles ya guardado en el Arduino es mucho más rápido. El problema es que se llena la memoria del Arduino.
    La versión actual muestra el logo e imágenes de crudo/cocinado cuando se pulsan sus botones.
    Además, se ha incluido una función para "borrar" solo una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
    [RA8876_v2.cpp, RA8876_v2.h]
2023-05-10 Comentarios SPI, tests SD, images y saveDataSD (testing)
2023-05-11 Imagen BIN desde SD y delete NO funcional
    Opciones para mostrar imagen:
    1 - Directamente desde Arduino, guardada en su flash ==> lo más rápido, pero si la imagen es muy grande (logo), se come la memoria Flash.
    2 - Fichero BMP guardado en SD ==> super lento y además pesa mucho, aunque al estar en SD eso no afecta.
    3 - Fichero BIN guardado en SD ==> muchísimo más rápido que mostrar un BMP, aunque más lento que desde Flash.
    La mejor opción es BIN porque es lo mejor desde SD.
    Aun así, se ha conseguido acelerar mucho más el mostrar imagen BIN:
    En tests iniciales, la función original tardaba 15s en mostrar el logo de 500x350. Su funcionamiento era leer 8 bits del fichero y mandarlo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
2023-05-15 Ingrediente => Alimento
    Se ha cambiado 'Ingrediente' por 'Alimento' por ir en consonancia con 'grupo de alimentos'.
    Por otro lado, las comprobaciones para add/delete/save hacen primero el cierto y, si no se cumple, entonces se chequea el error/aviso.
    [Alimento.h, BUTTONS.h, Comida.h, RA8876_v2.cpp, RA8876_v2.h, prueba_text_fonts.ino, smartcloth.ino, wireframes.ino]
2023-05-15 Pruebas wireframes
    Funciones de wireframes de:
    - Arranque
    - Pantalla inicial (pedir recipiente)
    - Escoger grupo
    No se han probado. Están hechas a ojo.
2023-05-21 Fonts Test y wireframe de arranque
    Aun sabiendo la ROM de fuentes externas que incluye la pantalla (GT30L16U2W de Genitop), no he conseguido acceder a ella. Lo más sencillo es trabajar con las fuentes internas, a las cuales se les puede modificar el tamaño en anchura y altura, cambiar el color del texto (foreground) y de resaltado (background), pudiendo usar el color de background especificado o ignorarlo y usar el del canvas original (usar chroma).
    El wireframe de arranque está completo. Faltan todos los demás.
    En los ficheros cpp y h de la 'prueba_text_fonts' se han incluido todas las funciones de la librería RA8876_Lite. Hay que probar las funciones que aprovechan mejor los buffers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
2023-05-22 Integración librerías - external font ROM
    Se han integrado todas las funciones de la librería RA8876_Lite en la RA8876_v2. Hay que probarlas, especialmente las relacionadas con los buffers de imágenes.
    Las fuentes de la ROM externa solo admiten una altura de 16, por eso no aparecían correctamente al pedir 24 y 32. Comprobar que el uso del ejemplo 'prueba_text_fonts' es correcto y si, aun con la limitación de height max. 16, se puede escalar la fuente.
    Si no se pudiera, habría que conformarse con las fuentes internas.
    [RA8876_v2.cpp, RA8876_v2.h, prueba_text_fonts.ino]
2023-05-23 Imágenes wireframe arranque en JPG y BIN
2023-05-23 Pruebas con fuentes externas (fixed, arial, times) OK
    [BUTTONS.h, COLORS.h, ISR.h, RA8876_Lite.cpp, RA8876_Lite.h, RA8876_v2.cpp, RA8876_v2.h]
2023-05-29 Fuentes y wireframes
    Fuentes internas/externas: la ROM de fuentes externas tiene Arial y Times, pero solo con una altura máxima de 16. Se puede escalar, pero empieza a pixelarse.
    Conclusión: Mejor utilizar las fuentes internas.
    WIREFRAMES:
    - Arranque (OK)
    - Pantalla inicial (OK)
    - Seleccionar grupo (~OK => se ve el borde de las imágenes con un rojo que parece diferente al del fondo)
    - Añadir plato (~OK => se ve el borde de las imágenes con un rojo que parece diferente al del fondo)
    - Borrar plato (~OK => se ve el borde de las imágenes con un rojo que parece diferente al del fondo)
    - Guardar comida (~OK => se ve el borde de las imágenes con un rojo que parece diferente al del fondo)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
2023-05-29 Configuración RTC y suma Acumulado Hoy
    Configurado RTC con hora actual (desfase de 2 segundos sin importancia) ==> DS3231_RTC.ino
    Suma de los valores del día de hoy guardados en el .csv de la SD para obtener el 'Acumulado Hoy' ==> log_csv_SD.ino -> getAcumuladoHoy()
2023-05-30 Integración funciones BTE a la librería
2023-05-30 Incluir RTC -> getAcumuladohoy()
    Incluir uso del RTC, ya configurado, de forma que se pueda cambiar la hora cuando toque horario de verano o invierno.
    Gracias al RTC se puede incluir la fecha y hora en el fichero csv cada vez que se guarde una comida. Así, al iniciar SmartCloth se lee el fichero y se suman los valores de las comidas guardadas en el día de hoy.
    Esto solo está hecho en examples/log_csv_SD.ino
    Lo mejor sería guardar esta versión aparte antes de modificar toda la interfaz.
    TODO => incluir getAcumuladoHoy() en SmartCloth.
    => Comprobar antes de borrar, añadir o guardar
    => Terminar wireframes e incluirlos. Chequear "opacity" (imágenes medio transparentes)
    => Modificar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
2023-05-31 Versión 1.0 de SmartCloth con interfaz simple
    No incluye la comprobación antes de añadir, borrar y guardar.
    Los nuevos wireframes se van a incluir en la versión 2.0 de SmartCloth.
    [grupos_alimentos.csv]
2023-05-31 Acumulado Hoy de comidas desde SD
    ==> Al encender el dispositivo, se lee el fichero CSV de la SD y se suman los valores de las comidas guardadas en el día de hoy (RTC). Esta suma se muestra ya desde el inicio en "Acumulado Hoy", dejándolo listo para seguir añadiendo comidas.
    Podría haber un problema si se cambiara de día en mitad del cocinado. Es decir, si se comienza la cena a las 23:55 y se termina a las 00:20, la comida se guardará con fecha del nuevo día. Entonces, en la primera comida real del día (desayuno) ya se mostrará algo en el Acumulado, que realmente tendría que pertenecer al día anterior.
    ==> Por otro lado, ahora ValoresNutricionales también incluye las raciones y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
    [COLORS.h, Comida.h, Diario.h, SD_functions.h, Screen.h, State_Machine.h, Valores_Nutricionales.h, wireframes.ino]
2023-05-31 Carga imágenes al inicio
    Al iniciar el dispositivo cargar todas las imágenes en páginas de la memoria de pantalla para luego poder acceder de forma rápida.
    Las utilizadas en el wireframes.ino tardan 5 segundos en cargarse, en total. Se podría mostrar "simultáneamente" el wireframe de carga (pila), añadiendo una barrita de carga cada 3 o 4 imágenes, de forma que no parezca que no arranca por estar 5 segundos con pantalla negra.
2023-06-01 Wireframe de carga al inicio
    Cargar imágenes del wireframe de carga inicial (reloj de arena) al inicio e ir mostrándolo mientras se cargan todas las demás.
2023-06-02 Cargar reloj full/mitad/cuarto
    Carga del reloj a full tamaño, a 1/2 y a 1/4.
    La mejor opción ha sido reducirlo a 1/4 del tamaño para cargarlo rápido y que la transición de movimiento mostrada mientras se cargan las otras imágenes sea más fluida.
    Además, no se incluye el logFull (logo SmartCloth pequeño) en la esquina, ya que se muestra a continuación en el wireframe de arranque.
2023-06-05 Estructura del Dashboard
    Dashboard totalmente estructurado.
    El tamaño de letra se queda pequeño, pero si se aumenta, es demasiado grande ==> una pantalla más grande permitiría aumentar el tamaño de letra.
    Para facilitar la automatización del dashboard, especialmente los colores del texto de grupos y sus ejemplos, habría que incluir su color en la struct de 'Grupo', de forma que se pueda indicar en 'gruposAlimentos' el color de cada grupo.
    Queda integrar la interfaz con el programa y rezar que no casque.
2023-06-05 Comprobaciones add/delete/save y pantallas iniciales
    Se han creado estados transitorios que piden la comprobación para add/delete/save. Si la reciben, van al estado definitivo. Si reciben otro evento, van al nuevo estado indicado.
    Se han insertado las pantallas de arranque (logo), principal (pedir recipiente) y recipiente colocado.
    Se ha creado una pantalla sencilla que indica que se ha colocado el recipiente en el STATE_Plato. Tras un delay, habría que añadir la pantalla de escoger grupo.
    Se ha acelerado la pantalla inicial (pedir recipiente) para que el usuario no tenga que esperar a que termine para colocar el recipiente. Aun así, si lo colocara antes de terminar, la interrupción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
2023-06-06 Pantallas hasta crudo/cocinado
    Se han integrado las siguientes pantallas:
    * Carga (reloj)
    * Inicial (pedir recipiente)
    * Escoger grupo (recipiente colocado)
    * Dashboard => se ha dividido en cuatro zonas:
    - Zona superior de ejemplos (al seguir pulsando grupos solo se modifica esta zona)
    - Zona procesamiento crudo/cocinado (comienza 'crudo' predeterminado. Al escoger otra opción solo se modifica esta zona)
    - Zona "Plato actual"
    - Zona "Acumulado hoy"
    Al escoger grupo se muestra el dashboard completo, pero no sé cómo insertar la pantalla que pide escoger crudo/cocinado sin que aparezca cada vez que se pulse un grupo diferente.
    Se podría poner la primera vez que se escoja grupo, pero ma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
2023-06-06 Pantallas añadir, borrar y guardar
    Falta añadir un mensaje en la pantalla de comida guardada que pida que se retire el plato.
    IMPORTANTE: hacen falta pantallas de errores (acción incorrecta) y avisos (p.ej. no se ha guardado la comida porque estaba vacía).
    [Scale.h, Screen.h, State_Machine.h, Valores_Nutricionales.h, wireframes.ino]
2023-06-07 Agrupar confirmaciones
    Se han agrupados las preguntas de confirmación y las confirmaciones de acción en sendas funciones (pedirConfirmacion() showAccionConfirmada()) a las que se le indica como parámetro la acción según la cual se muestra un mensaje u otro:
    - Opción 1: añadir plato
    - Opción 2: eliminar plato
    - Opción 3: guardar comida
2023-06-09 Imágenes con transparencia
    La nueva función 'bteMemoryCopyWithOpacity()' permite hacer la suma ponderada de dos fuentes que estén en la SDRAM de visualización, aplicando un nivel de alpha que determine la opacidad/transparencia.
    El chip RA8876 permite dos modos para aplicar esta suma ponderada u opacidad:
    - Modo píxel: solo opera en 8bpp/16bpp y cada píxel tiene su propio valor de opacidad (nivel alpha).
    - Modo imagen: opera en 8bpp/16bpp/24bpp y tiene un solo valor de opacidad (nivel alpha) para toda la imagen.
    Para nuestro caso se ha implementado el modo imagen para aplicar el mismo nivel de transparencia a toda la imagen.
    En este modo, la suma ponderada se obtiene con la siguiente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
2023-06-12 Alimento sin recipiente
    Se han añadido dos reglas de transición que permiten escoger grupo de alimentos (tipoA o tipoB) sin colocar recipiente. De esta forma, se pueden colocar alimentos como frutas o verduras directamente sobre la báscula.
    Por otro lado, en los estados de grupos de alimentos (función actGruposAlimentos()) se ha añadido un temporizador de 5 segundos para que, pasado ese tiempo sin colocar alimento y habiendo escogido grupo sin recipiente, se regrese al inicio para volver a pedir recipiente.
    Este temporizador se reinicia cada vez que se escoge un grupo.
    Así, si se ha escogido grupo sin colocar recipiente pero luego se cambia de opinión, solo habría que esperar ese t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
2023-06-12 Warning de borrado
    Si se ha querido eliminar el plato pero estaba vacío, se muestra un mensaje de aviso indicando que no se ha borrado y, tras 3 segundos, se regresa al STATE_groupA o STATE_groupB, según el último grupo escogido.
    Una vez ya en los estados de grupos de alimentos podrá actuar de dos formas:
    - Si se había colocado recipiente, se mantendrá el valor de su peso y se podrá volver a STATE_Empty si se retira.
    - Si no se había colocado recipiente, se actuará como al escoger grupo sin colocar recipiente: se esperará un alimento durante 5 segundos y pasado ese tiempo se regresará a STATE_Empty para pedir recipiente.
2023-06-12 Regresos forzados añadir y guardar
    En el caso de añadir plato, tras 3 segundos de mensaje de aviso, se regresa a STATE_groupA o STATE_groupB, según el último grupo escogido, manteniendo el peso del recipiente. Si no había recipiente y, estando en esos estados, pasan 5 segundos sin colocar alimento, se regresa a STATE_Empty para pedir recipiente.
    Tanto en el caso de añadir como eliminar, si se confirma la acción, no se fuerza el regreso, sino que se debe liberar la báscula.
    En el caso de guardar comida, si no hay nada que retirar, tras 3 segundos de aviso se vuelve a STATE_groupA o STATE_groupB, según el último grupo escogido. Se regresa a esos estados aunque se hubiera querido gu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
2023-06-13 Decimales raciones y tamaño texto
    Como las raciones pueden ser x.0 y también x.5, si es x raciones y media sí se muestra la media (.5), pero si no, no se muestra el decimal (.0) porque es innecesario.
    Además para los caso de .5 se elimina la escala en anchura de la letra para que no salga del recuadro de raciones. En el caso de .0 se mantiene la escala x2 tanto en anchura como en altura, siendo un tamaño base de 12x24.
    En cuanto al texto de "Peso" an "Plato actual" y "Acumulado hoy" se ha eliminado la escala en anchura, siendo un tamaño base de 16x32. Ahora parece algo más estirado en altura, pero sigue siendo legible y, lo más importante, si aumenta mucho el peso, que ocurrirá es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
2023-06-13 SmartCloth complejo y reducido
    La v2 de SmartCloth que se tiene hasta ahora ha resultado ser más compleja de lo necesario, es decir, deja demasiada libertad de acciones al usuario.
    Se va a modificar (smartcloth_v2_reducida) para limitar las acciones posibles en cada caso y facilitar el mantenimiento de la dinámica Recipiente -> Grupo -> Procesamiento -> Alimento.
    A nivel de interfaz, se va a modificar el dashboard para mostrar "Alimento actual" en Zona 3 (izquierda) y "Comida actual" en Zona 4 (derecha). La "Comida actual" solo se mostrará mientras se esté elaborando algún plato (desde que se escoge grupo).
    Al encender o tras guardar y hasta colocar recipiente (inclusive), se mostrar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
    [grupos_alimentos.csv]
2023-06-13 Wireframes de error y aviso (not tested)
    La imagen de la cruz del wireframe de error se ha recortado: la línea horizontal se dibuja sobre la imagen, evitando tener que cargar en memoria una imagen tan grande como la original, que incluía la línea horizontal.
    Además, se le puesto un fondo del mismo rojo que el fondo de la pantalla.
    Para el wireframe de aviso se han preparado 3 posibles imágenes de triángulo de advertencia: dos con borde rojo y relleno blanco, y uno con relleno negro. Habrá que ver cuál queda mejor.
    Para ambos wireframes habría que hacer una función como las de pedirConfirmacion() y showAccionConfirmada(), que muestran la misma estructura pero con un texto diferent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
    [COLORS.h, Grupos.h, Screen.h, wireframes.ino]
2023-06-14 Wireframes de aviso
    He probado las tres imágenes preparadas para el wireframe de aviso y creo que la mejor opción es la aviso2, con interior y borde blancos.
    Además, se han hecho dos versiones del wireframe de aviso, que sigo pensando que debería tener un color distinto:
    - Versión 1: muestra primero texto de ¡AVISO! entre dos líneas, después la imagen y finalmente un comentario.
    - Versión 2: muestra primero el texto de ¡AVISO!, después la imagen, luego un sola línea y finalmente el comentario.
    No les he aplicado ningún delay, sino que aparece la pantalla completa directamente.
2023-06-14 Modificación wireframe aviso
    Partiendo de la verisón 2 del wireframe de aviso (véase commit anterior), se han hecho otras dos versiones según el tamaño aplicado al texto del comentario: 16x32 sin escala o 12x24 escalado x2.
    En el primer caso puede que el texto se quede demasiado pequeño como para considerarlo importante de leer.
    Por eso se ha hecho la otra versión con el tamaño un poco mayor.
    Comentar que cada modificación de tamaño de letra implica recalcular la posición desde donde empieza el texto y ver si hace falta separar la cadena en dos partes, teniendo que calcular también la posición de la segunda parte de la cadena.
2023-06-14 Integrar Aviso en v2_complex
    Se ha integrado la pantalla de aviso, con mensajes personalizados según el caso, en la versión 2 compleja de SmartCloth.
    Se ha integrado en esa en lugar de directamente en la reducida para tener completa la v2_complex por si en algún momento hace falta usarla.
    Cuando se integre el wireframe de error en v2_complex se incluirán ambas pantallas (aviso y error) en v2_reducida para tenerla actualizada.
    [Screen.h, State_Machine.h]
2023-06-14 Pantalla general de ERROR
    La nueva función showError(int option) muestra una pantalla de error con un comentario o sugerencia que indica, según el estado actual, algo que sí se puede hacer.
    Se ha hecho con dos versiones de tamaño de texto, igual que la pantalla de aviso:
    - Tamaño 16x32 sin escala: puede que se quede pequeño
    - Tamaño 12x24 escala x2: se ve más grande, pero puede que la pantalla parezca saturada de elementos. Yo prefiero esta opción.
    Comentar de nuevo que el cambio de tamaño no es tribial, sino que conlleva recalcular caso a caso dónde debería comenzar el texto y, si es necesario, separarlo en varias cadenas, para las cuales también habría que recalcular su pos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
    [wireframes.ino]
2023-06-14 Color pantalla de aviso
    Se ha cambiado el color del fondo de las pantallas de aviso a un naranja oscuro, para diferenciarlas de las pantallas normales y las de error.
    Este cambio ha provocado volver a procesar la imagen escogida (aviso2) para ponerle un fondo con el mismo color.
    También se ha modificado la estructura de la pantalla de forma que ahora la línea horizontal no está debajo de la imagen, sino que la cruza por detrás. Al ponerla por detrás de la imagen (antes en el código porque es secuencial), la línea se ve cortada por la imagen antes de llegar a la figura del triángulo porque la imagen es cuadrada, pero no queda mal.
    [COLORS.h, wireframes.ino]
2023-06-14 Integracion pantallas de error
    Se han integrado las pantallas de error en la versión compleja (v2_complex). Habría que añadirlas también a la reducida y continuar ahí.
    Las pantallas de error, al igual que las de aviso, tienen una estructura genérica y solo se diferencian en el mensaje mostrado, que depende del estado actual.
    Se ha optado por el tamaño mayor de las dos versiones desarrolladas en wireframe.ino: el correspondiente a 12x24 con escala x2. Igual para los avisos.
    [Screen.h, State_Machine.h, wireframes.ino]
2023-06-14 Estado de ERROR
    Se ha creado un estado nuevo de ERROR (STATE_ERROR) al que se pasa cuando ocurre una acción incorrecta, es decir, cuando no se encuentra ninguna regla de transición que parta desde el estado actual.
    En este estado de error se muestra la pantalla de error con un mensaje diferente según el estado previo desde donde se cometió el error.
    Tras 3 segundos, se marca un evento para regresar al estado donde se cometió el error.
    Para ello, se han creado 13 eventos nuevos simplemente para volver a los 13 estados reales (BACK_TO_<estado>).
    Estos eventos también serán útiles cuando se cree el estado de CANCELAR y haya que regresar al estado desde donde se quiso add/delete/save,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
    [COLORS.h, Screen.h, State_Machine.h]
2023-06-14 Resaltado wireframes botones
    Se ha cambiado el color del resaltado de YELLOW a RED_BUTTON.
    Además, el resaltado ya no es una consecución de rectángulos redondeados, sino que son "normales", sin esquinas redondeadas. No encaja tan bien con la imagen del botón, pero no se ve la separación entre las líneas en las esquinas redondeadas.
    Recordemos que no se puede modificar el grosor de las líneas, sino que se dibujan varias seguidas separadas por 1 píxel en cada dirección para la dar la sensación de recuadro.
2023-06-15 Cambio tamaño texto Dashboard
    Con los carbohidratos, proteínas y grasas en mayúsculas no hace falta aumentar su tamaño y no se montan en las raciones aunque tengan 4 cifras + 1 decimal.
    Se ha disminuido la imagen de las kcal de 80x87 a 60x65.
    Después de varias pruebas con tamaños, se quedan así:
    - PESO: 12x24 escala 2x2
    - CARBOHIDRATOS: 16x32 sin escala
    - PROTEÍNAS: 16x32 sin escala
    - GRASAS: 16x32 sin escala
    - Kcal.: 12x24 escala 2x2
    - Raciones: 16x32 sin escala
    - .0 : 12x24 escala 2x2
    - .5 : 12x24 escala 1x2
2023-06-15 Estado CANCEL
    Creado STATE_CANCEL y sus reglas de transición para cancelar add/delete/save y regresar al estado desde donde se iniciaron.
    TODO: no está bien hecha la cancelación por time-out.
2023-06-19 ERROR y CANCEL completo en v2_complex
    Completamente integradas las pantallas de errores y de acción cancelada, con los regresos automáticos necesarios.
    En los casos de add/delete/save, tras realizarse la acción y esperar que se retire el plato, si se hace cualquier cosa menos retirar el plato, saltará un error. Al regresar a los estados add/delete/save tras mostrar la pantalla de error, saltaba el aviso de objeto vacío porque ya se había limpiado.
    Por eso, si se llega a esos estados desde el estado de ERROR, se mostrará la pantalla de "Plato añadido", por ejemplo, para que se le vuelva a pedir retirar el plato.
    Se muestra esa pantalla, aunque no se haya vuelto a realizar la acció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
    [Screen.h, State_Machine.h]
2023-06-19 ERROR y CANCEL en v2_reducido
    Integrados estados y pantallas de error y de acción cancelada en la v2_reducida.
    Aún falta el control de errores para cuando se retire el plato durante la pantalla de error.
    [COLORS.h, Grupos.h, Screen.h, State_Machine.h]
2023-06-19 Límites y pantallas hasta pesar alimento
    Ya con la v2_reducida, se han establecido los siguientes límites:
    - Se debe colocar recipiente para escoger grupo. Todo lo demás está prohibido, excepto guardar (si hay qlgo que guardar).
    - Se debe escoger grupo para escoger procesamiento. Todo lo demás está prohibido, excepto retirar el recipiente y empezar de nuevo con uno diferente.
    - Se debe escoger procesamiento (crudo o cocinado) para colocar alimento. Todo lo demás está prohibido.
    Se han establecido los límites necesarios hasta el STATE_weighted.
    Por otro lado, se han incluido las alternancias de pantallas necesarias según el estado:
    - Empty: dashboard estilo 1 (Comida | Acumulado)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
2023-06-19 Resaltado cuadros grupo y procesamiento
    Mientras no se haya escogido grupo, su cuadro aparece con el borde "parpadeando" y con un mensaje que indica que no se ha escogido grupo.
    Para el procesamiento, mientras no esté elegido, aparecen los recuadros parpadeando. Hasta ahora se van alternando el de crudo y cocinado, pero mejor que los tres (grupo, crudo y cocinado) parpadeen a la vez.
    Para esta alternancia, se han separado de la función showDashboardStyle1() y se llaman sendas funciones por separado en las zonas de alternancia de pantalla en STATE_Empty, STATE_Plato y STATE_groupA/B (solo procesamiento), cuando esté en pantalla el dashboard.
2023-06-19 Parpadeo zonas 1 y 2
    Las zonas 1 (grupo) y 2 (procesamiento) parpadean a la vez indicando que no se han escogido sus valores.
    Al escoger grupo ya sí aparece su info, pero el procesamiento sigue parpadeando hasta que se escoja.
    Cada vez que se escoge grupo se resetea el procesamiento, iniciando de nuevo el parpadeo.
    PROBLEMA: tras varios poner y quitar de recipiente, las funciones de parpadeo se pueden desincronizar porque no utilizan las variables de tiempo, provocando que no parpadeen a la par las zonas 1 y 2, sino cada una por separado.
    [Screen.h, State_Machine.h]
2023-06-19 Funcionamiento normal completo
    CREO que se ha completado el funcionamiento normal.
    - Comprobar que comidaActualCopia guarda correctamente los valores de comidaActual para mostrarlos en STATE_Empty tras guardar la comida.
    - Cambiar delays por millis en pantallas transitorias para permitir su interrupcion.
    - Comprobar todos los regresos a estados correspondientes.
    - Gestionar la interacción con la báscula durante pantallas de error (al colocar recipiente y al retirar plato tras add/delete/save).
    - Si se libera sin haber guardado el plato o la comida, eliminar plato??
    - Incremento notado al retirar plato en STATE_groupA/B se detecta como error e impide detectar la liberación par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
    [Comida.h, Screen.h, State_Machine.h]
2023-06-20 Automatizar valores y raciones
    Se han creado dos funciones para mostrar los valores nutricionales y las raciones en una ubicación de la pantalla según la zona indicada (zona 3 o zona 4).
    La única diferencia era la ubicación del texto, por eso se utiliza una misma función.
    Se podría hacer lo mismo con todo el contenido de printZona3() y printZona4(), pero tenerlas separadas ayuda a la organización del código.
2023-06-21 Interrumpir pantalla temporales
    Inicialmente se pensaba que las pantallas temporales (pedir recipiente, pedir grupo, pedir procesamiento, etc.) no se interrumpían con eventos porque se estaba usando delay, que provoca una espera bloqueante.
    Entonces, se modificó el código para evitar el delay, pero manteniendo las pequeñas esperas entre la aparición de unos elementos gráficos y otros.
    De ahí las grandes zonas comentadas en las funciones pedirRecipiente, pedirGrupoAlimentos, pedirProcesamiento y pedirConfirmacion, donde se aplican comprobaciones de paso de tiempo con millis.
    El problema persistía porque si no se utilizaba un bucle (while) para mantenerse en esas funciones, no se lle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
    [Buttons.h, Comida.h, Diario.h, Files.h, ISR.h, Plato.h, RTC.h, SD_functions.h]
2023-06-21 Eliminar Variables.h de v2_complex
2023-06-22 Eventos durante error
    Se ha utilizado la misma estrategia usada para interrumpir la aparición de pantallas transitorias: se comprueba si hay algún evento activo durante la pantalla de error. Si lo hay, se actúa según el evento y el estado desde donde ocurrió el error.
    Por otro lado, antes se hacía el parpadeo de las zonas 1 y 2 del dashboard por separado, pero se desincronizaba. Por eso, se ha integrado en una misma función y se ha añadido la opción del mensaje "No se ha colocado ningún recipiente".
    [Files.h, ISR.h, Screen.h, State_Machine.h]
2023-07-03 Error de incremento y regreso tras CANCEL
    Cuando el error cometido es la pulsación de un botón, no hay mucho problema en su gestión: se muestra pantalla de error durante 3 segundos y se regresa.
    Sin embargo, si el error ha sido manipular la báscula, se mantiene la pantalla de error hasta que se rectifique la acción. Esto sería retirar el plato completo, que se borraría pues aún no se ha "guardado", y comenzar de nuevo.
    Esta gestión alternativa, manteniendo la pantalla de error, solo se realiza para el caso de colocar alimento desde STATE_GroupA/B.
    En los casos de colocar más peso estando en added/deleted/saved, se marca como un simple error, pues ahí ya se está pidiendo que se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
    [ISR.h, Scale.h, Screen.h, State_Machine.h]
2023-07-10 Check last valid state
    En lugar de chequear state_prev y state_prev_prev para los regresos a estados anteriores tras error o cancelación, se ha incluido 'lastValidState' para marcar el último estado válido: Empty, Plato, groupA, groupB, raw, cooked y weighted.
    Tras error o cancelación se vuelve a cualquiera de esos estados, según el caso.
    lastValidState solo toma el valor de state_prev si es alguno de esos estados. Nunca se regresará a estados como add/delete/save o sus estados de check.
    [Screen.h, State_Machine.h, Valores_Nutricionales.h]
2023-07-10 ERROR en CANCEL
    Si se comete un error durante la pantalla de cancelación, se muestra pantalla de error con mensaje "Espere a que termine la cancelación".
    Para el caso de error durante cancelación, solo se están gestionando los errores por pulsaciones de botón. Si el error fuera colocar o retirar peso de la báscula, no se gestiona porque se complica excesivamente y no compensa según la probabilidad de ocurrencia que tiene. Si ocurriera ese error, no sé cómo actuaría el dispositivo, pero seguramente afectaría a la veracidad de la información aportada.
    Manipular la báscula durante la pantalla de cancelación sería un mal uso del dispositivo. No es posible controlar todas las pos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
    [Screen.h, State_Machine.h]
2023-07-10 Estado y evento de aviso
    Se han separado los avisos como un nuevo evento AVISO provocado por SmartCloth, no por el usuario, y se ha creado un STATE_AVISO al que ir cuando sea necesario (no se ha guardado el plato o la comida) y mostrar el mensaje correspondiente.
2023-07-11 Simplificación parpadeo zonas 1 y 2
    Se ha simplificado la función de blinkGrupoyProcesamiento(msg_option) según el argumento pasado:
    - MSG_SIN_RECIPIENTE --> aún no se ha colocado recipiente -> parpadean ambas zonas.
    - MSG_SIN_GRUPO --> aún no se ha escogido grupo -> parpadean ambas zonas.
    - NO_MSG --> ya se ha colocado recipiente y escogido grupo -> solo parpadea la zona 2.
2023-07-14 Movimiento mano y 2º pulsación
    Se han modificado las pantallas de colocar recipiente y escoger grupo con el nuevo color verde de fondo (#658D47).
    En la pantalla de escoger grupo, se ha dado "movimiento" a la mano simulando un desplazamiento con el borrado de la imagen y la representación en una nueva posición.
    Además, se han añadido las rayas de pulsación, así como una segunda pulsación.
    La pulsación, que se alterna con no pulsación, se ha modularizado de forma que se pueden hacer tantas combinaciones 'pulsar/no pulsar' como se requiera, simplemente llamando a la función sin_pulsacion_Grupos() o pulsacion_Grupos() según corresponda.
2023-07-14 Modif pantalla escoger crudo/cocinado
    Se ha cambiado la pantalla de seleccionar crudo o cocinado con el nuevo color verde de fondo.
    Además, se ha modularizado el mostrar una imagen u otra, de forma que se puedan incluir tantas alternancias como se quieran reduciendo líneas de código.
    Solo se debe llamar a mostrarOpcionProcesamiento(option) con la opción de imagen que se quiera mostrar (1 = cocinado, 2 = crudo).
2023-07-14 Integradas new screen recipiente y grupos
    Se han integrado las pantallas modificadas de pedir recipiente y grupo que se probaron externamente en examples/wireframes.
    Además, se han modificado los períodos de espera para mostrar la ayuda en los siguientes estados:
    - Empty --> se dejan 5 segundos para ver el dashboard y luego se muestra la ayuda. Si se acaba de guardar la comida, se dejan 10 segundos para ver la info de la comida guardada.
    - Plato --> se muestra el dashboard durante 3 segundos, lo justo para leer "No se ha seleccionado ningún grupo de alimentos".
    - Grupos --> se muestra el dashboard durante 5 seg, lo justo para leer parte de los ejemplos del grupo.
    Por último, se han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
2023-07-15 Integrada new screen crudo/cocinado
    Se ha integrado la pantallas modificada (nuevo color de fondo) de seleccionar crudo o cocinado, probada externamente en examples/wireframes.
2023-07-15 Nueva screen "Coloque alimento"
    Nueva pantalla con mensaje de "Coloque un alimento en la zona de pesada" para mostrar como ayuda al usuario tras seleccionar crudo o cocinado.
2023-07-16 Colocar alimento y aparición/desaparición imágenes
    Se ha integrado una nueva pantalla temporal/transitoria que pide al usuario colocar un alimento sobre la báscula tras escoger crudo o cocinado.
    Esta pantalla salta a los 10 segundos, dejando tiempo para leer los ejemplos de los grupos, pero impidiendo que el usuario se quede atascado sin saber qué hacer.
    ¿Habría que incluir pantallas de ayuda para sugerir añadir otro alimento, añadir/borrar el plato o guardar la comida?
    Por otro lado, se ha incluido la aparición/desaparición paulatina de imágenes tanto para la pantalla de pedir procesamiento (alternando entre aparecer/desaparecer crudo o cocinado) como para la pantalla que pide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
2023-07-16 Optimización código repetitivo
    Se ha optimizado la función desplazar_mano_Grupos() de forma que las nuevas coordenadas de posición de la figura de la mano se obtienen a través de un bucle, reduciendo así el número de líneas de código.
    También se ha optimizado el código para el resaltado simulando una pulsación en pedirGrupoAlimentos().
2023-07-16 Movimiento mano en pedirGrupo
    1 - Se ha incluido el movimiento de la mano en la pantalla de pedir grupos.
    2 - Se ha creado una nueva pantalla de "Recipiente retirado" que aparece en STATE_Empty únicamente si ha ocurrido una liberación de la báscula (evento LIBERAR).
    Esto, además de dar información, evita los parpadeos en vacío que hacían las zonas 1 y 2 al volver a Empty justo antes de escribir el mensaje de "sin recipiente" y ponerse a parpadear en rojo.
    3 - Se ha eliminado la inclusión de los alimentos en los platos y de los platos en las comidas. Ya no hay un array de objetos Alimento o Plato, ya que no era necesario.
    Además, esto ha permitido eliminar la limitaciónd e 10 ali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
2023-07-16 Movimiento mano botones
    Desplazamiento de la mano en pantalla de check de añadir en examples/wireframes
2023-07-16 Mano y pulsación en check de eliminar
    En examples/wireframes se ha integrado el movimiento de la mano y la alternancia de pulsaciones en la pantalla de check de eliminar plato.
    Como es igual que en el caso del check de añadir plato, se están automatizando estas acciones.
2023-07-16 Movimiento mano y pulsación en guardar
    Se ha integrado en examples/wireframes el desplazamiento de la mano y las pulsaciones del botón en la pantalla de check de guardar comida.
2023-07-16 Automatizado movimiento manos y pulsaciones
    Se han automatizado y optimizado las funciones para el movimiento de la mano y la simulación de pulsación del botón en las pantallas de pedir grupo y check de add/delete/save.
    Para ello, se utilizan las funciones desplazar_mano(), sin_pulsacion() y con_pulsacion(), indicando como parámetro el caso en el que nos encontramos.
2023-07-16 Integrado en SC manos y pulsaciones
    Se ha integrado en SmartCloth el desplazamiento de mano y la simulación de pulsaciones de las pantallas de pedir grupo y los checks de add/delete/save.
2023-07-16 Nuevo fondo pantalla Avisos
    Siguiendo el modelo del semáforo (verde, amarillo, rojo), se ha cambiado el fondo de la pantalla de aviso al mismo color amarillo usado en los checks.
2023-07-17 Ejemplo borrar fichero y crear nuevo
    Como no es algo que se vaya a hacer muchas veces, solo en las pruebas con usuarios, el borrar el acumulado no se hace solo borrando el contenido del fichero.
    En lugar de eso, se borra el fichero entero y se crea uno nuevo con el mismo nombre.
    En el programa se SmartCloth se aprovecha writeHeader() para crearlo de nuevo e incluir el header y getAcumuladoHoyFromSD() para actualizar el acumulado, que ahora está a 0.
2023-07-17 ATAJO BORRAR ACUMULADO
    En primer lugar, se ha creado una copia del proyecto llamada 'smartcloth_v2_pruebas', ya que la funcionalidad añadida solo se va a utilizar en las pruebas, no debe mantenerse en el producto final.
    Se ha creado un atajo para que, con una combinación de botones, se borre el fichero csv que guarda la info para limpiar el "Acumulado hoy".
    SOLO SE VA A USAR DURANTE LAS PRUEBAS, ENTRE UN PACIENTE Y OTRO.
    SE DEBE BORRAR PARA EL PROGRAMA FINAL.
    La estrategia es la siguiente:
    1 - Iniciar acción "cancelable" (añadir, borrar o guardar)
    2 - Cancelar acción
    3 - Durante la pantalla de "Acción cancelada" (solo dura 1 seg), pulsar el botón de grupo1 (esquina superior izquie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
    [grupos_alimentos.csv]
2023-07-17 Cambio imagen scale
    Se ha cambiado la imagen de báscula (scale) que aparecía en la pantalla de pedirAlimento() por una diseñada con el mismo estilo que las demás: una báscula en blanco con fondo verde (scaleG).
    Por otro lado, se han modificado las funciones de mostrar imágenes lentamente para que, si hay interrupción devuelvan true, permitiendo salir de la función que las llamó. Así se pueden interrumpir pantallas como la de escoger crudo/cocinado o la de colocar alimento.
2023-07-18 Nueva pantalla sugerencias
    Nueva pantalla (examples/wireframes) que hace sugerencias de acciones: añadir más alimento, escoger otro grupo, añadir otro plato, borrar plato actual o guardar comida.
2023-07-18 Integrada en SC nueva pantalla sugerencias
    Se ha integrado en SmartCloth la nueva pantalla con sugerencia de acciones: añadir más alimento, escoger otro grupo, añadir otro plato, eliminar plato actual y guardar comida.
    Esta pantalla aparece si, tras pesar alimento, pasan 10 segundos sin actividad, por si el usuario no sabe qué hacer ahora. Se mantiene durante 15 segundos para que el usuario pueda leer las sugerencias, pero no tiene que esperar a que desaparezca, puede interrumpirla cuando quiera, como ocurre con todas las pantallas temporales/transitorias.
2023-07-18 Lenta aparición grupos y sugerencias
    Se ha aplicado la aparición paulatina de imágenes (diferentes valores de opacitiy) a las imágenes de grupos que aparecen en la pantalla de escoger grupo y a las imágenes de sugerencias de acción.
2023-07-18 Lenta aparición imágenes logo
    Se ha aplicado la aparición paulatina a las imágenes del logo de SmartCloth, mostradas al inicio, de forma que no sea tan repentina.
2023-07-24 debug nombre estado
    Se ha incluido función que imprime el nombre del estado en lugar del número para facilitar la depuración. Igual con eventos.
2023-09-14 Actualización de documentos e imágenes del repositorio
    [grupo_alimentos.xlsx, partitions.csv]
2023-09-19 Pedir crudo/cocinado sobre Dashboard
    En primer lugar, se ha hecho una copia del programa (smartcloth_v2_pruebas) para resolver los problemas detectados en las pruebas (smartcloth_v2_post_pruebas). Se mantiene la parte del código para borrar el csv.
    En segundo lugar, se ha creado un nuevo semi Dashboard (showSemiDashboard_PedirProcesamiento()) para mostrar las zonas de la siguiente forma en los estados STATE_groupA/B:
    - Zona 1: ejemplos del grupo escogido
    - Zona 2: sin procesamiento, parpadeando
    - Zonas 3 y 4: tapadas por una pantalla que pide escoger procesamiento
    Para la pantalla de pedir procesamiento, se han creado dos funciones para conformarla:
    - formGraphicsPedirProcesamiento(): cr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
    [grupos_alimentos.csv]
2023-09-20 Eliminar SIN_PROCESAMIENTO
    Se ha eliminado la opción SIN_PROCESAMIENTO en la función de printProcesamiento() y ya no se "resetea" el procesamiento poniéndolo a 0 con esa opción.
    Esto se ha hecho porque en los casos en que aún no se ha escogido procesamiento, ya se indica en pantalla con la zona 2 del dashboard parpadeando y, en los STATE_groupA/B, mostrando una pantalla que pide procesamiento sobre las zonas 3 y 4.
    Por tanto, en los casos en los que aún no se habría escogido procesamiento, es algo obvio y no es necesario remarcarlo con la opción SIN_PROCESAMIENTO. En los estados posteriores sí se establece el procesamiento según el STATE_raw/cooked último seleccionado.
    [Screen.h, State_Machine.h]
2023-09-20 Eliminar pantalla "Coloque recipiente" tras guardar
    Tras guardar la comida y retirar el plato, se mostraba la información que se había guardado, pero a los 10 segundos aparecía la pantalla pidiendo colocar recipiente.
    Se ha modificado para que no aparezca esa pantalla si se acaba de guardar, permitiendo así al usuario consultar la ingesta de comida sin prisas ni interrupciones.
2023-09-20 Excel original de grupos de alimentos (Docs)
    [grupo_alimentos_v3.xlsx]
2023-09-20 Descripciones de las funciones
    Se han completado los comentarios en las declaraciones de las funciones.
2023-09-21 Eliminar evento QUITAR
    Se ha eliminado el evento QUITAR y las reglas de transición que lo incluían porque ha resultado innecesario. Al utilizar una flag para saber que se ha tarado, ya se puede distinguir entre incremento/decremento real o debido a la tara hardware realizada en algunos estados. Por tanto, ya no es necesario discriminar el decremento en valores negativos con el evento QUITAR.
    Finalmente, se mantienen los siguientes eventos respecto a la báscula:
    - TARAR: tara hardware realizada en estados Init, groupA/B, added, deleted y saved.
    - INCREMENTO: incremento en la medida de peso (valores positivos o negativos) de más de 2 gramos.
    - DECREMENTO: decremento en la medida de pes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
2023-09-25 Versiones v2.1 y v2.2
    [grupos_alimentos.csv]
2023-10-03 Reset actual time on RTC manually
    [DS3231_set_time.ino]
2023-10-03 Usuario subsana error de poner peso antes de cocción
    Tras escoger un grupo de alimentos el usuario debe indicar si está cocinado o crudo antes de pesarlo. Sin embargo, si lo coloca en la báscula antes de seleccionar cocinado o crudo, el sistema marca error.
    Hasta ahora este error te obligaba a retirar el plato completo para comenzar de nuevo. Esto se hacía por si el alimento colocado era líquido, por lo que no se podría simplemente apartar.
    Tras las pruebas se vio patente la necesidad de incluir una forma de subsanar ese error sin tener que empezar de nuevo, especialmente si no se trataba del primer alimento del plato.
    Por tanto, se ha incluido una funcionalidad que permite seleccion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
    [RTC.h, Screen.h, State_Machine.h]
2023-10-17 Database integration
    He comprado un dominio (smartcloth.site) en Hostinger durante 1 año (hasta octubre 2024) y estoy utilizando FreeHosting.com como alojamiento gratuito de 1 base de datos y 1 web, aunque la "web" esté vacía.
    Este hosting me permite peticiones infinitas y 10GB de almacenamiento. Es solo temporal, para realizar pruebas internas.
    He hecho varias cosas:
    1 - Crear base de datos: una sola tabla 'comidas' con campos de ID; fechahora; carb; carb_R; lip; lip_R; prot; prot_R; kcal; peso. El ID es autoincremental y la fechaHora es la actual del servidor al incluir una nueva tupla.
    2 - Fichero main.ino en el esp32: cada 5 minutos genera valores aleatorios para los macronutrient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
2023-10-17 Inclusión botón en index.html
    Se ha incluido un botón en la página principal de smartcloth.site que lleva a esp-data.php para acceder rápidamente a la información guardada en la base de datos.
    Por otro lado, se ha descubierto que si los valores enviados terminan en .0 ó .00 ó .50, la parte del 0 se trunca. Por tanto, si el valores es 17.50, se guarda 17.5 en la base de datos, pero si el valor es 2.00, se guarda 2 en la base de datos.
    Lo he dejado así porque, por ahora, no molesta.
2023-10-27 Serial communication Arduino Mega - ESP32-CAM
    Ejemplo de comunicación entre Arduino Mega y ESP32-CAM usando Serial3 en Mega y Serial1 (serial hardware) en ESP32-CAM.
    En ambos casos se utiliza Serial para la comunicación con el PC para depurar.
    Programa:
    Desde teclado se manda un comando al Mega por Serial y este lo reenvía por Serial3 al ESP32-CAM. Si el comando recibido en ESP32-CAM es 'ON', se enciende el led. Si es 'OFF', se apaga el led. Con cualquier otro comando se indica 'commando not valid'.
2023-10-27 Comunicación Serial bidireccional
    Desde PC (Serial) se envía mensaje a Mega, que lo reenvía (Serial3) al ESP32.
    - Si el mensaje es 'ON', el esp32 enciende el led y envía 'Led ON' al PC (Serial) y 'led encendido' al Mega (Serial1).
    - Si el mensaje es 'OFF', se apaga el led y envía 'Led OFF' al PC (Serial) y 'led apagado' al Mega (Serial1).
    - Si el mensaje es cualquier otro, envía 'command not valid' al PC (Serial) y al Mega (Serial1).
    Por tanto, comunicación bidireccional conseguida!
2023-10-30 Comunicación Serial Arduino Due - ESP32CAM
    Se ha adaptado el ejemplo de comunicación serial entre un Arduino Mega y un ESP32CAM para, en lugar del Mega, utilizar un Arduino Due.
    El único cambio necesario ha sido eliminar la inclusión de la librería SoftwareSerial.h y utilizar directamente una de las comunicaciones Serial hardware que ofrece el Due.
2023-10-30 Comunicación Serial mediante botón Due-esp32
    Aprovechando el hardware del SmartCloth, con botones ya conectados, se ha realizado un programa para encender el led del esp32cam cuando se pulse el botón de "guardar":
    Al pulsar el botón, el Due envía por Serial al ESP32-CAM el mensaje "ON" para que encienda el led. Al recibir ese mensaje, el ESP32-CAM enciende el led y responde con "Led encendido".
    Al volver a pulsar el botón, el Due le manda el mensaje "OFF" para que apague el led. Al recibir ese mensaje, el ESP32-CAM apaga el led y responde con "Led apagado".
    Este programa servirá de base para que, cuando se quiera guardar la informacion de la comida (pulsando el botón de "guardar"),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
2023-10-31 Ejemplo LED Serial
    Se han comunicado por Serial el Arduino Due y el ESP32-CAM. En este caso, en lugar de dar la orden de encender el led desde el PC y reenviarla del Due al esp32, se manda el comando el pulsar el botón de guardar, como precedente de la funcionalidad de SmartCloth de guardar la comida en la base de datos al pulsar ese botón.
    Por tanto, al pulsar el botón (el de guardar), el Due envía por Serial al ESP32-CAM el mensaje "ON" para que encienda el led. Al recibir ese mensaje, el ESP32-CAM enciende el led y responde con "Led encendido".
    Al volver a pulsar el botón, el Due le manda el mensaje "OFF" para que apague el led. Al recibir ese mensaje, el ESP32-CAM apaga el led y re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
2023-10-31 Ejemplo DATABASE Serial
    Se ha modificado el ejemplo de "Serial button Due -esp32cam LED" para que, en lugar de encender el led, el esp32 genere unos valores aleatorios y los envíe por petición HTTP POST al servidor, encargado de guardarlos en la base de datos. Al igual que en el caso anterior, al pulsar el botón de 'guardar', el arduino le envía el comando "save" al esp32, que entonces realiza esas tareas.
2023-10-31 Inicio integración esp32 en código SM
    Se ha creado el fichero Serial_esp32cam.h donde se irán haciendo las funciones necesarias para la comunicación Serial entre el Arduino Due y el ESP32-CAM. Por ahora, solo se ha iniciado la función que envía los datos de la comida al esp32 para que los guarde, pero no se ha terminado. Queda hacer la espera de respuesta del esp32 según todo OK o error. Y, por supuesto, probarla.
    [Comida.h, SD_functions.h, Serial_esp32cam.h, State_Machine.h, esp32cam-button-send-data.ino]
2023-11-03 Guardar en database por botón (ejemplo)
    Nuevo ejemplo "Serial button Due-esp32 DATABASE FULL" donde el arduino, cuando se pulse el botón de guardar, genera valores para simularlos y envía la cadena
    "SAVE-&carb=X&carb_R=X&lip=X&lip_R=X&prot=X&prot_R=X&kcal=X&peso=X"
    al ESP32.
    El esp32 recibe y separa la cadena por el delimitador '-' para enviar la segunda parte de la cadena por la peticion HTTP POST. Dependiendo del resultado de esa petición, puede responder cualquiera de las siguientes opciones:
    - "SAVED-OK" --> la info se ha guardado correctamente
    - "NO-WIFI" --> no hay conexion wifi. No se puede guardar
    - "ERROR-HTTP:<codigo_error>" --> error al realizar la peticion
    Entonces, el A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
    [Comida.h, Serial_esp32cam.h, random_values.h]
2023-11-09 QR scanner en esp32cam
2023-11-09 Streaming server en esp32cam y acceso con Python
    Se levanta un server de stream con el esp32cam ("streamingServer") y el programa "access_url_stream_simple.py" accede a la url. Por ahora solo abre una ventana con la transmisión.
    El programa "descomprimir_gzip_to_html.py" descomprime estructuras de datos que contienen las páginas html comprimidas en gzip y las guarda en ficheros .html para poderlos modificar. Estas páginas html son las que utiliza el server de stream para responder a las peticiones HTTP.
    El programa "comprimir_html_to_gzip.py" comprime los ficheros .html en gzip. Si se creara una página html y se quisiera guardar en el esp32cam para que la use el servidor, lo mejor es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
2023-11-20 Add "SIN INTERNET" en pantalla ask_save y saved
    En la pantalla de confirmación de guardar y en la de guardado se han añadido unos mensajes según si hay conexión a Internet o no:
    - Si la info se ha guardado tanto local como en database, no se modifican las pantallas. Solo se dice que se ha guardado.
    - Si la info solo se ha guardado en local porque no hay wifi, se muestra una banda roja que pone "SIN INTERNET".
    - Si la info solo se ha guardado en local porque ha habido algún error al guardarla en la base de datos, aunque haya wifi, se muestra una banda roja que pone "ERROR EN LA CONEXIÓN A LA WEB".
    [wireframes.ino]
2023-11-20 Integrado "SIN INTERNET" en SM (sin probar)
    Se han integrado en SM las modificaciones a las pantallas de pedir confirmacion de guardar y de guardado para indicar "SIN INTERNET" o "ERROR EN LA CONEXION A LA WEB".
    NO SE HAN PROBADO ESTAS PANTALLAS EN SM.
    [Screen.h, State_Machine.h]
2023-11-20 No guardado en database por TIMEOUT
    Añadida la opción de considerar que no se ha guardado la info porque el esp32 ha tardado mucho en responder al comando de guardar.
2023-11-20 Lector QR-barcode en servidor (python)
    Programas auxiliares para el cliente que accede al servidor de stream de video para decodificar barcode/QR:
    - access_url_strea_simple.py --> accede al stream de video del servidor y lo muestra en pantalla
    - barcode-QR_scanner_from_file.py --> detecta y decodifica barcodes/QR de un fichero usando 'pyzbar'
    - barcode_scanner_from_server.py --> accede al stream de video y decodifica los barcode/QR que encuentre. Con la webcam funciona perfecto pero no con el stream porque la cámara (OV2640) está desenfocada. Estoy probando con la autofocus (OV5640).
    - scanner_saving_frames.py --> accede al stream de video y guarda la última imagen (antes de cerrarlo)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
2023-11-20 Servidor de stream de video (esp32)
    Programa para levantar un stream de video en el esp32 y que un cliente pueda acceder a la url y visualizar el stream para decodificar los barcode/QR.
2023-11-20 Procesamiento imagen borrosa
    Programa para procesar imagen borrosa con varias técnicas de OpenCV:
    - Máscara de desenfoque gaussiano
    - Aumentar contraste
    - Aplicar umbral para resaltar el barcode
2023-11-20 Servidor de stream con autofocus (esp32)
    Modificación del programa del stream de video para usar una cámara autofocus OV5640.
    Aún no funciona porque resulta que un pin de la cámara debe estar a 3.3V y estaba usando una placa que no lo tenía soldado.
    Debo probar con una que sí lo tenga para ver si puedo enfocarla y que el programa en el cliente decodifique el barcode.
2023-11-20 Reorganizar testeos ESP32
    Se han eliminado algunos testeos hechos para el ESP32CAM, tanto para guardar la comida como para el lector barcode/QR, y se han organizado los exitosos y los que aún se están probando.
    [partitions.csv]
2023-11-21 Mensaje TIMEOUT en respuesta del ESP32
    Se ha añadido un mensaje para cuando el esp32 no responda a tiempo (timeout). Si no responde, asumiremos que no ha guardado la información.
    Al final se tienen 4 posibles mensajes resaltados en la pantalla de guardado realizado:
    "ERROR EN LA CONEXIÓN A LA WEB"
    "SIN INTERNET"
    "ERROR EN ENVÍO (TIMEOUT)"
    "ERROR DESCONOCIDO"
    El mensaje de "SIN INTERNET" también se muestra en la pantalla de confirmar guardar para indicar que no se tiene conexión y que la información no se guardará en la web.
    [Screen.h, State_Machine.h, wireframes.ino]
2023-11-21 Fallo crítico en SD
    Si ocurre un error al inicializar la SD en el setup, ya sea porque falle o porque no se encuentre, se impide el uso de SM.
    Si ocurre este fallo, en lugar de comenzar en STATE_Init, se pasa directamente a STATE_CRITIC_FAILURE_SD, un estado sin transiciones de entrada ni salida.
    Además, en lugar de cargar las imágenes de bienvenida, que se encuentran en la SD, se muestra la pantalla de "¡FALLO EN MEMORIA!" y se ignora cualquier pulsación.
    En el loop(), si ha ocurrido un fallo en la SD, solo se hacen las actividades del estado STATE_CRITIC_FAILURE_SD (mostrar pantalla de error), pero no se comprueban las interrupciones ni las transiciones, pues no hay forma de salir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
    [SD_functions.h, Screen.h, State_Machine.h, wireframes.ino]
2023-11-29 Remapeo de pines para botoneras nuevas
2023-11-29 Cambio de nombre de las imágenes A veces no se consiguen leer las imágenes de la SD y aparecen recuadros negros en su lugar. Para intentar evitarlo, se ha modificado los nombres de los ficheros de la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
    [Files.h]
2023-11-29 Establecer fecha y hora actual en RTC
    Programa (DS3231_set_Actual_time.ino) que establece la fecha y hora de compilacion en el RTC. En pruebas se ha detectado un desfase de 26 segundos menos que la hora actual real, por lo que se aplica una corrección (adjustTime()) para añadirle los 26 segundos, actualizando los minutos y horas si es necesario.
2023-11-29 Adjust time correction for seconds
    [DS3231_set_actual_time.ino]
2023-11-29 Add arduino.json configuration files for DS3231_set_time and DS3231_set_actual_time examples
2023-11-29 Comprobado el Summer y Winter Time Se ha comprobado que las funciones para cambiar al horario de verano o de invierno funcionan correctamente.
    [DS3231_update_time_winter_summer.ino]
2023-11-29 Pines para botoneras antiguas Mientras se trabaja con las botoneras antiguas, se han modificado los pines a los que se conectan porque son diferentes a los pines de las nuevas (borrar y guardar están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
2023-11-29 Comentar inicializacion Serial con ESP32CAM Mientras no se use ni esté conectado el ESP32-CAM, mantener comentadas las líneas que inicializan el puerto de comunicación Serial, especialmente la que es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
2023-11-29 Nueva pantalla de "ERROR EN MEMORIA"
    [wireframes.ino]
2023-12-01 Generacion fichero para ESP32
    Conforme se elabora la comida, se van escribiendo líneas en un fichero auxiliar que guarda la info a enviar al esp32 cuando haya wifi.
    La información de cada comida se escribe de esta forma:
    INICIO-COMIDA
    INICIO-PLATO
    ALIMENTO,<grupo>,<peso>
    ALIMENTO,<grupo>,<peso>
    ALIMENTO,<grupo>,<peso>
    INICIO-PLATO
    ALIMENTO,<grupo>,<peso>
    FIN-COMIDA,<fecha>,<hora>
    Esta info se va escribiendo al navegar por la Máquina de Estados:
    - En STATE_Init se escribe INICIO-COMIDA
    - Antes de escribirlo, cuando se comprueba si el plato no está vacío porque se haya retirado de repente, se debe también borrar la info del plato
    escrita en el fichero hasta la última línea de IN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
2023-12-04 Save info en esp32 file acceso continuo
    La información para enviar al esp32 cuando haya wifi se guarda de esta forma:
    El programa de ejemplo "SD_esp32_file_acceso_continuo" va añadiendo esas cadenas conforme se avanza en la elaboración de la comida, pero lo hace directamente en el fichero txt en la SD. Es decir, cada adición y borrado se hace accediendo al fichero guardado en la SD.
    Para evitar tantos accesos innecesarios que podrían acabar corrompiendo la SD con tantas sobreescrituras, se está desarrollando otro ejemplo (S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
2023-12-04 Save info en esp32 file acceso único
    El programa de ejemplo "SD_esp32_file_acceso_unico" va añadiendo esas cadenas a una lista (vector de String) conforme se avanza en la elaboración de la comida.
    Cuando se pulse "GUARDAR", entonces se escribe FIN-COMIDA,<fecha>,<hora> en la lista y se guarda todas las cadenas de la lista en el fichero txt, siendo cada elemento de la lista una línea del fichero.
    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
2023-12-05 Modificacion save info en esp32 file acceso único
    Se ha modificado el programa de ejemplo "SD_esp32_file_acceso_unico.ino" creando una clase Lista con todas las funciones utilizadas, para mejorar el encapsulamiento, la reutilización del código y la extensibilidad.
2023-12-05 Integrado en SM save info en esp32 file
    Se ha integrado en el código de SM la clase Lista para ir guardando las cadenas de texto que, al guardar la comida, se escribirán en el fichero TXT cuyo contenido se pasará al ESP32 cuando haya WiFI para que genere el JSON y suba la información a la base de datos.
2023-12-11 Encender SM con recipiente en báscula
    Es posible que alguien encienda SM con un recipiente ya puesto sobre la báscula. Entonces, el sistema tara y, con el recipiente puesto, establece la referencia de peso 0 y pide colocar el recipiente. La respuesta más común del usuario en este caso es retirar el recipiente y volverlo a colocar.
    Por eso, se ha incluido una regla de transición STATE_Init --> DECREMENTO --> STATE_Init para cuando se retire peso estando en el inicio. Además, en las acciones del estado STATE_Init se vuelve a tarar la báscula y se reinician los pesos de recipiente, plato (recipiente + alimentos) y último alimento cuando se detecta ese DECREMENTO.
2023-12-12 Modificacion ejemplo "Database integration"
    Se han creado ficheros en el servidor para tratar el envío de JSON con comida->plato->alimento :
    pos-esp32-data-json.php --> inserción en base de datos al recibir el POST
    esp32-data-json.php --> consulta select a la base de datos
    En el ejemplo "send_JSON_via_API" se incluye un JSON de ejemplo (json-test,jsn) para enviar en postman a la url que aparece en el README.txt y guardar su info en la base de datos.
    Se han creado estas tablas:
    "comida":
    - ID (autoincremental)
    - fecha
    - hora
    "plato":
    - ID (autoincremental)
    - comida_id (ID de la comida en tabla "comida" a la que pertenece el plato)
    "alimento":
    - ID (autoincremental)
    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
2023-12-15 Reorganización ejemplos
    [grupos_alimentos.xlsx, partitions.csv]
2023-12-15 Convertir fichero de texto a JSON
    Ejemplo "text_file_to_JSON.ino" para convertir a JSON un fichero de texto con esta estructura:
    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
2023-12-15 Esquema relacional en SQL
    He transformado el esquema Entidad-Relación a un esquema Relacional.
    En el fichero 'crear_tablas.sql' (examples/DATABASE/PHP files (JSON) and SQL/crear_tablas.sql) están los comandos sql para crear las tablas con sus atributos, PK (Primary Key), FK (Foreign Key) y restricciones.
    En el fichero 'insercion-grupos.sql' están preparados para insertar los valores nutricionales de los 26 grupos de alimentos (1-20 crudos y 27-29,36-38 cocinados).
2023-12-18 Scripts sql para crear tablas e insertar grupos
    Se han creado los scripts SQL para crear las tabas en la base de datos (crear_tablas.sql) y para insertar los nombres, ejemplos y valores nutricionales de los grupos de alimentos.
2023-12-20 Limpieza ficheros
    Se han eliminado algunos ficheros superfluos y duplicados
    [grupo_alimentos.xlsx, grupo_alimentos_v3.xlsx, grupos_alimentos.csv, grupos_alimentos.xlsx]
2023-12-25 Ficheros PHP para nuevo relacional
    Ejemplo DATABASE--> PHP files (JSON): se han modificado los ficheros post-esp32-data-json.php y esp32-data-json.php para insertar y obtener los datos según el nuevo esquema relacional. En el fichero consultas.sql se muestran consultas realizadas según ese esquema y sus salidas.
2023-12-25 scripts sql fuera de ejemplos
2023-12-25 Ejemplo obtener MAC de dispositivo
2024-01-17 Conexiones y cableado
    Actualizado conexiones según si se usa botonera original o nueva, la cual tiene cruzados los botones de eliminar y guardar.
2024-01-17 Adaptacion PCBs
    Ficheros de adaptación de las PCBs a las nuevas botoneras.
2024-01-17 Rename JSON ejemplos de "text_file_to_JSON"
2024-01-17 Pines en Buttons.h para nuevas botoneras
2024-01-17 Rename de files en Files.h
2024-01-17 Conexiones esp32-Due y esp32-PC
    --------------------------------------------
    | ESP32-CAM | FTDI (Serial al PC) |
    --------------------------------------------
    | UOT (Tx) | RXD |
    | UOR (Rx) | TXD |
    --------------------------------------------
    --------------------------------------------
    | ESP32-CAM | Arduino Due (Serial1) |
    --------------------------------------------
    | IO15 (Tx1) | pin 19 (Rx1) |
    | IO14 (Rx1) | pin 18 (Tx1) |
    | 3V3 | 3V3 |
    | GND | GND |
    --------------------------------------------
    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
2024-01-17 Simular esp32File to JSON
    Se ha modificado el ejemplo "text_file_to_JSON" para simular con un String la lectura de un fichero cuando no haya SD.
2024-01-17 Serial --> SerialPC
    Utilizamos una macro para identificar la comunicación serial con el PC (SerialPC usando Serial0) y diferenciarla posteriormente con la comunicación con el esp32 (SerialDueESP32 usando Serial1).
2024-01-19 Ejemplo 'send_text_&_convert_TO_JSON'
    Se ha creado un ejemplo donde el Arduino Due envía el fichero esp32File.txt al ESP32 línea a línea para que lo convierta en JSON y lo suba a la base de datos. Como no tenía acceso a una SD, para simular la lectura del fichero he usado una String con un ejemplo de contenido.
    Este ejemplo introduce todas las líneas recibidas por Serial en un mismo JSON, hasta que se reciba "FIN-TRANSMISION" una vez se termine el fichero, cuando el ESP32 añade su MAC al JSON y lo envía al servidor.
    El problema es que si hace muchos días que no se ha subido la información, el fichero será muy grande y también el JSON generado, lo que podría saturar la memoria de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
    [SD_functions.h, arduino-due-send-textFile.ino, esp32cam-textFile-to-JSON-and-send.ino, esp32cam-textFile-to-JSON.ino, functions.h, functions_String.h, json_functions.h, wifi_functions.h]
2024-01-24 Update ejemplo 'send_text_&_convert_TO_JSON'
    Se ha modificado el ejemplo 'send_text_&_convert_TO_JSON' para que, en lugar de usar un String estático, lea realmente un fichero txt de la SD y lo envíe línea a línea por comunicación serial al ESP32, donde lo convierte a JSON y lo envía al servidor.
    Falta probar a crear un JSON por cada comida y subirlo, dando acuse de recibo por comida al Due por si se corta la comunicación a mitad.
2024-01-24 Update ejemplo 'send_text_&_convert_TO_JSON'
    Se ha añadido al ejemplo 'send_text_&_convert_TO_JSON' las funciones necesarias para enviar un JSON por comida en lugar de un solo JSON para todo el fichero. Si el fichero fuera muy grande (mucho tiempo sin subir la información), el JSON sería demasiado grande para poderlo procesar e el ESP32.
    IMPORTANTE: en las pruebas de este ejemplo, tras varias ejecuciones, el servidor comenzó a impedir el acceso y su respuesta era que se completara el CAPTCHA. Puede que ocurriera porque se realizaron varias subidas consecutivas desde el dispositivo y, al ser un servicio gratuito (FreeHosting) está algo capado. Después de eso, ya no pude volver a subir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
2024-01-26 Evitar overflow del JSON
    Si ArduinoJson ve que lo que va a meter en el JSON haría que superara su capacidad, no lo añade.
    Entonces, no podemos simplemente comprobar si el JSON se ha pasado de JSON_SIZE_LIMIT, porque nunca lo hará, sino que comprobamos si se va modificando la cantidad de memoria usada por el JSON, lo que significaría que se están añadiendo elementos. En cuanto deje de aumentar la memoria usada,significará que el JSON ya no admite más elementos.
    En ese caso, si se ha quedado una comida a medias (no se ha alcanzado FIN-COMIDA), deberemos ignorarla y solo dejar en el JSON comidas completas porque así será más fácil saber qué información se ha subido a la base de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
2024-01-31 Comprobar Wifi Due <--> esp32
    Nueva función para que el Due le pregunte al esp32 si tiene conexión a internet. Le pregunta con CHECK-WIFI y si el esp32 responde WIFI, entonces tiene conexión. Si responde NO-WIFI o no responde, se considera que no hay conexión a internet.
2024-01-31 Due side (not tested and no barcode)
    Programado (sin testear) la parte del Due para comprobar WiFi y enviar fichero TXT si lo hay:
    Se ha creado un nuevo estado al que se pasa directamente en el setup si hay algo en el TXT y hace estas cosas:
    Preguntar al esp32 si tiene conexión a internet con la función checkWifiConnection(). Si no tiene conexión, pasar al estado Init.Si tiene conexión a internet, indicar al esp32 que se le va a enviar información con el mensaje "SAVE". Espera a que el esp32 le responda "WAITING-FOR-DATA" y entonces manda el fichero TXT linea a linea con la función sendFileToESP32().
    Cuando la función termine, el Due debe esperar mensaje del esp32, que puede ser "S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
2024-02-01 Modif ejemplo send_text_&_convert_to_JSON
    Hasta ahora el ejemplo "Due_esp32cam - send_text_&_convert_to_JSON" enviaba directamente el fichero desde el Due y el esp32cam lo convertía a JSON y lo subía.
    Se ha modificado este ejemplo para que haga:
    - Primero el Due pregunta al esp32 si tiene WiFi con el comando "CHECK-WIFI" y el esp32 responde "WIFI" si hay conexión o "NO-WIFI" si no hay.
    - Si hay conexión, entonces el Due el avisa al esp32 de que va a enviarle data para el JSON con el comando "SAVE" y espera a que el esp32 responda "WAITING-FOR-DATA" indicando que está a la espera de la info.
    - Una vez el esp32 está a la espera, el Due empieza a enviar el fichero TXT línea a línea y c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
2024-02-01 Modif ejemplo send_text_&_convert_to_JSON
    Al recibir FIN-TRANSMISION, el esp32 no responde con JSON-OK, ya responderá cuando suba los datos (SAVED-OK), falle la subida (HTTP-ERROR:<cod_error>) o se corte la conexion (NO-WIFI).
    [esp32cam-textFile-to-JSON-and-send.ino, functions.h, json_functions.h]
2024-02-01 Reduce JSON size
    Se han modificado los ejemplos "textFile_to_JSON" y "Due_esp32cam - send_text_&_convert_to_JSON" para minimizar el tamaño del JSON generado evitando al máximo las cadenas de caracteres:
    - Grupo de alimentos se envía como int (toInt())
    - Peso de alimento se envía como float (toFloat())
    - Fecha y hora de la comida se convierte a Unix timestamp (función convertTimeToUnix()) y se envía en un solo campo "fecha" en el JSON.
2024-02-01 Modificacion ejemplo textFile_to_JSON
    Modificado el ejemplo para reducir el tamaño del JSON también para el caso de generarlo a partir del fichero TXT y no de una String estática.
2024-02-01 JSON en ámbito cerrado
    Se han modificado los ejemplos "textFiel_to_JSON" y "Due_esp32cam - send_text_&_convert_to_JSON" para que el documento JSON se declare dentro de una función en lugar de ser global, de forma que al salir de la función, se elimine el JSON y se libere la memoria reservada. Esto ha provocado que hubiera que modificar todas las funciones que trataban el JSON, pasándoles el documento y lo JsonArray/JsonObject por referencia.
    En el ejemplo "Due_esp32cam - send_text_&_convert_to_JSON", en el programa del ESP32, se declara el JSON y sus objetos en la función processJSON(). En esa función se lee continuamente el Serial con el Due añadiendo cada linea leída al JSON con l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
2024-02-01 Fix ejemplo "esp32cam-textFile-to-JSON-and-send"
    Se ha modificado el programa del ESP32 en el ejemplo "Due_esp32cam.- send_text_&_convert_to_JSON" porque la llamada a processJSON() no se hacía cuando debía. Estaba puesta una vez se recibiera la primera línea (que sería INICIO-COMIDA), pero esa ya no se procesaba, por lo que no se generaba correctamente el JSON porque no se inicializaba el JsonObject de 'comida' de la primera comida.
    Ahora se llama a la función processJSON() justo tras recibir "SAVE" y ya en la propia función se atienden a las líneas recibidas sin dejar ninguna atrás.
    [SD_functions.h, esp32cam-textFile-to-JSON-and-send.ino, json_functions.h]
2024-02-01 Updated servidor con cambios en JSON
    Se han modificado los ficheros del servidor (smartcloth.site) para recibir, insertar y mostrar los datos teniendo en cuenta los cambios hechos en la estructura del JSON, principalmente en cuestión de la fecha (antes de mandaban cadenas de 'fecha' y 'hora', pero ahora se manda 'fecha' como timestamp Unix).
    También se ha modificado la tabla 'Comida' de la base de datos según este cambio en el formato de datos: se ha eliminado el atributo 'hora' y el atributo 'fecha' se ha cambiado de VARCHAR12 a TIMESTAMP.
    Como no hay un tipo de dato directamente compatible con Unix, en el "post-esp32-data-json.php" se hace una conversión de Unix a TIMESTAMP. También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
2024-02-01 Programa principal ESP32 (not tested)
    Se ha modificado el programa principal del ESP32 para que haga lo siguiente:
    1. Recibe "CHECK-WIFI" del Due
    2. Comprueba la conexión WiFi:
    2.1. Hay conexión, responde "WIFI"
    2.2. No hay conexión, responde "NO-WIFI"
    3. Si hay conexión, recibirá "SAVE" del Due indicando a va a enviar data del TXT
    4. Responde al Due con "WAITING-FOR-DATA", quedando a la espera de ese data
    5. Cada línea recibida la procesa y modifica el JSON según su contenido
    6. Cuando reciba "FIN-TRANSMISION", cierra el JSON y lo envía al servidor (smartcloth.site, el de pruebas)
2024-02-05 Nueva pantalla (simple) de DATA TO UPLOAD
    En el ejemplo de "wireframes" se ha creado una nueva pantalla para indicar por pantalla que hay data en el TXT que se debe subir. La función permite varias opciones:
    - Sincronización necesaria (data por subir)
    - Sin conexión a internet
    - Sincronizando (subiendo data)
    - SmartCloth sincronizado (data subida)
    - Error al subir la data (error HTTP)
    [Files.h, RA8876_v2.cpp, RA8876_v2.h, functions.h, wireframes.ino]
2024-02-05 Terminado STATE_UPLOAD_DATA y updated STATE_saved (not tested)
    Terminadas las actividades del STATE_UPLOAD_DATA:
    1. Indica que se necesita sincronizar.
    2.a. Comprueba si hay WiFi (pregunta al ESP32).
    3. Si hay WiFi, envía el TXT al ESP32 y lo indica por pantalla.
    4. Espera la respuesta del ESP32 y muestra en pantalla el éxito o fallo en el envío. Pasa al STATE_Init.
    2.b. Si no hay WiFi, lo indica por pantalla y pasa al STATE_Init.
    Se ha modificado la función saveComida() llamada en STATE_saved para que, además de guardar la comida en el CSV, envíe la lista de la comida al ESP32 para que la suba (si hay WiFi) o la guarde en el TXT.
2024-02-06 Rearranged SM software versions
    [grupos_alimentos.csv]
2024-02-06 Reorganización esp32
2024-02-06 Esquema interacción Due - Esp32
2024-02-06 Update esp32cam-v1 (oficial server)
    Se ha modificado el programa del ejemplo "esp32cam-textFile-to-JSON-and-send" y del programa principal del ESP32 "esp32cam-v1" para que la información la envíe al servidor oficial de smartcloth-web en lugar del servidor de prueba. Para ello, se ha tenido que modificar el proceso de envío de la información, que ahora es:
    1. Pedir token de autenticación al servidor
    2. Enviar JSON de la comida junto con token
    3. Cerrar sesión en el servidor con el token
2024-02-06 Update STATE_saved
    Actualizadas las actividades del State_saved para que si hay internet, suba la lista de la comida a la database. Si no hay internet, escribe la lista en el fichero TXT que se le pasará al ESP32 cuando haya WiFi. Mientras sube la informacion se muestra pantalla de "SINCRONIZANDO...", aunque MUY RUDIMENTARIA.
2024-02-14 State_groupA y State_groupB --> State_Grupo
    Se tenían dos estados separados segun el tipo de alimento (A o B) pero en ambos estados se hacía exactamente lo mismo (actGruposAlimentos()). Se han sustituido esos dos estados por un solo estado State_Grupo, ya que solo es necesario distinguir el tipo de alimento para saber el grupo exacto, pero eso ya se hace con los dos eventos TIPO_A y TIPO_B, así que no es necesario tener dos estados individuales.
    Los cambios han afectado a las reglas de transición y las actividades de algunos estados, especialmente el STATE_ERROR.
2024-02-14 Estructura ButtonPosition
    En lugar de mantener dos variables globales iRow e iCol para saber la posición del botón que se está pulsando en el teclado matricial, se ha definido una estructura ButtonPosition con los atributos row y col.
    La función readButtonsGrande() ahora devuelve un objeto del tipo ButtonPosition, que lo recoge la función checkAllButtons() (y checkGrandeButtons() si se dividen las funcionalidades) para saber la ubicación del botón y marcar el evento correspondiente según el grupo al que represente.
    Se ha hecho este cambio para ahorrar memoria, evitando al máximo el uso de variables globales.
2024-02-14 Update cálculo de raciones
    Se ha modificado la forma de calcular las raciones en ejemplo "update_raciones" y ya integrado en "smartcloth_v2". También se ha actualizado la función showRaciones() que las muestra en pantalla ubicándo las cifras según la cantidad de cifras enteras.
    Antes se calculaban las raciones dividiendo entre 10 los valores en gramos y redondeando al entero más cercano o a .5 si se encontraba entre .3 y .7
    Se ha modificado para mantener la mayor precisión posible, es decir, mantenemos siempre 1 decimal, así que dividimos y luego multiplicamos entre 10 para redondear al decimal más cercano manteniendo siempre 1, aunque sea .0
2024-03-04 Eliminar reintento de conexion a WiFi en esp32
2024-03-04 Debug y pequeña modificacion de texto en pantallas
    Más simulaciones de pulsación sobre botones al confirmar acciones (add, delete y save)
2024-03-13 Datasheet esp32-cam
2024-03-13 Modificación ejemplo creación y subida JSON
    Se ha modificado la creación y subida del JSON con la información de comidas a la base de datos:
    - La fecha ya no se pasa como 'fecha' y 'hora', sino solamente como 'fecha' en formato UNIX.
    - Ya no se reintenta la conexión WiFi varias veces durante 2 minutos. Si en 10 segundos no se ha conectado a la red, seguimos sin WiFi. Debe darle tiempo al ESP32 a conectarse a la red al encender SmartCloth mientras el arduino carga las imágenes en la memoria de la pantalla e inicia el sistema.
    - Funciones para generar JSON y subirlo: todo en un JSON, dejando fuera lo que no entre, o un JSON por comida, arriesgando saturar el servidor.
2024-03-13 Contenido de la tarjeta SD
    Contenido exacto de la tarjeta SD, para copiar directamente.
    Incluye las imágenes en binario y dentro de los directorios correspondientes, y el directorio donde se guardarán los ficheros CSV y TXT.
    La estructura de ficheros no se debe modificar, pues las rutas en el código dejarían de funcionar.
2024-03-13 Modificado programa ESP32
    Si falla el pedir token, no subir información.
2024-03-13 Programa RTC
    Código RTC_set_time.ino para programar cada RTC con la hora actual de compilación.
2024-03-13 Borrar libreria de carpeta externa
    Borrar librería de la pantalla del directorio separado. Ya está en el "smartcloth_v2".
2024-04-17 Datasheets ESP32-CAM PLUS
2024-04-17 Modificación ejemplo CameraWebServer de ESP32-CAM
    Se han añadido los pines del nuevo ESP32-CAM PLUS para probarlo. Funciona perfectamente.
2024-04-17 Modificación ejemplo ESP32-CAM send-convert-JSON
    Se ha modificado el ejemplo que envía una serie de cadenas (líneas) del Due al ESP32 y éste forma el JSON según la cadena recibida. Se ha modificado para que, en lugar de meter todo en un mismo JSON, se mande un JSON por comida y así evitar sobrepasar el tamaño del JSON. Para eso, se ha probado a que el Due cuente las comidas completas que va a enviando y el ESP32 cuente las que sube correctamente a la base de datos. Las que no suba, guarde su número de orden y al final se lo pase al Due para que borre esas del TXT. Esto aún no se ha probado, pero no creo que sirva porque el Due no puede borrar determinadas líneas del TXT, sino que t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
    [arduino-due-send-textFile.ino, esp32cam-textFile-to-JSON-and-send.ino, functions.h, json_functions.h, wifi_functions.h]
2024-04-17 Programa Blink nuevo ESP32-CAM PLUS
    El ESP32-CAM PLUS tiene el led en el pin 25.
2024-04-17 CameraWebServer nuevo ESP32-CAM PLUS
    Ejemplo CameraWebServer con los pines del ESP32-CAM PLUS. Funciona perfectamente.
    [partitions.csv]
2024-04-17 Encender LED en ESP32-CAM PLUS según comando Due
    Ejemplo para comprobar la comunicación Serial entre el Due y el nuevo ESP32-CAM PLUS.
    ¡¡¡ IMPORTANTE !!!
    ESP32-CAM PLUS SE DEBE PROGRAMAR EN ARDUINO IDE. EN VSCODE NO FUNCIONA LA TERMINAL.
    ARDUINO BOARD CONFIGURATION:
    - Board: "ESP32 Dev Module"
    - Partition Scheme: "Huge APP (3MB No OTA/1MB SPIFFS)"
    - Flash Mode: "DIO"
    - Upload Speed: "460800"
    Con eso ya se puede subir el programa a la placa sin problemas y sin tener que presionar el botón de reset ni GIO0.
    [arduino-due-led-msg.ino, esp32camPlus-led-msg.ino]
2024-04-17 Ejemplo envío líneas Due -> CAM PLUS y creación JSON
    Funciona correctamente la comunicación Serial entre el Due y el nuevo ESP32-CAM PLUS.
    [SD_functions.h, arduino-due-send-textFile.ino, cadenas.h, esp32camPlus-textFile-to-JSON.ino, functions.h]
2024-04-17 Ejemplo envío líneas Due - CAM PLUS, creación JSON y subida a base de datos
    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
    [SD_functions.h, arduino-due-send-textFile-upload.ino, cadenas.h, esp32camPlus-textFile-to-JSON-and-send.ino, functions.h, json_functions.h, wifi_functions.h]
2024-04-17 Stream de vídeo ESP32-CAM PLUS
2024-04-17 Otro ejemplo stream de vídeo ESP32-CAM PLUS
2024-04-17 Streaming server y script python acceso ESP32-CAM PLUS
2024-04-17 Conexiones ESP32-CAM PLUS <--> Arduino Due
2024-04-17 Timeout espera respuesta Due
    Timeout de 3 segundos sin respuesta del Due mientras se esperan líneas para que el ESP32 no se quede atascado en bucle infinito.
2024-04-17 Notas ESP32-CAM vs ESP32-CAM PLUS
2024-04-17 Modificado pin botón barcode
2024-04-17 Modificado debounce time
    Se estaban perdiendo las pulsaciones en una de las columnas de la botonera de grupos, así que se ha vuelto a reducir el tiempo de rebote, que se había subido a 500 ms en esa botonera, se ha bajado a 200 ms, como todos los demás botones.
2024-04-17 Modif sendListToESP32
    Se ha modificado la función sendListToESP32() para que devuelva true si el ESP32 responde que se ha subido a database correctamente o false si no. Esta lista es la de la comida que se está cocinando ahora mismo.
    [lista_Comida.h]
2024-04-17 Modif pines báscula
    Se han cambiado los pines de la báscula por comodidad en el montaje.
2024-04-17 Guardado de comida en local y base de datos
    Se ha separado el guardado de la comida que se está haciendo ahora mismo en dos funciones, una para guardarla en el CSV del histórico (para obtener rápido el acumulado) y otra para guardarla en la base de datos, si hay WiFi, o en el TXT para subirla cuando sea posible.
2024-04-17 Espera de respuesta del ESP32
    Cuando el Due envía algo al ESP32, luego espera su respuesta, que debe ser una específica para cada caso. Para eliminar redundancia en el código, la parte de esperar una respuesta específica (hasta 3 segundos) se ha introducido en una función readFromESP32() y así en waitResponseFromESP32() se llama a readFromESP32() varias veces según la cadena que se espera que envíe el ESP32, en lugar de tener ese mismo código de espera repetido.
2024-04-17 Añadidas transiciones Grupo --> add/delete/save
    Ahora también se puede pulsar "Añadir plato", "Borrar plato" y "Guardar comida" justo tras escoger grupo. Antes se debía indicar si crudo o cocinado antes de hacerlo, lo cual es absurdo.
2024-04-25 Diagrama sincronización inicial de data
2024-04-25 Update diagrams Due-ESP32
2024-04-29 Documento de Montaje del SmartCloth
2024-04-29 Diagrama de conexiones 2.0
2024-05-09 CameraWebServer with new esp32
    Ejemplo de CameraWebServer con el nuevo esp32, modificando sus pines.
    [partitions.csv]
2024-05-09 Example "LED msg" for new esp32
    Ejemplo "Due_esp32camPlus - LED msg" donde el Due envía al ESP32 lo que reciba por el Serial del PC. Si el ESP32 recibe "ON", enciende su led. Si recibe "OFF", lo apaga.
    Es un ejemplo para comprobar la comunicación Serial entre el Arduino Due y el ESP32.
    Para la comunicación utilizamos los pines:
    | ESP32 | Due |
    | 17 (Tx) | 19 (Rx) |
    | 16 (Rx) | 18 (Tx) |
    Si utilizamos VSCode, la comunicación Serial entre PC y ESP32 parece que no funciona bien porque no aparece nada en el terminal. Pero si lo cerramos y abrimos un terminal Serial con otra plataforma (p. ej. Arduino IDE), sí se ven los mensajes. No sé qué lo puede estar causando porque con los es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
2024-05-09 Example "LED button" for new esp32
    Igual que el ejemplo "LED msg", pero en lugar de escribir en terminal del PC "ON/OFF", el Due tiene conectado un botón (p. ej. botón del lector barcode) y cuando se pulsa se envía al esp32 "ON" u "OFF", según el estado anterior.
    Es un ejemplo para probar toda la línea "botón --> Due --> esp32".
2024-05-09 Example "send_text_&_convert_to_JSON" for new esp32
    En este ejemplo el Arduino Due lee un fichero TXT de la SD (o utiliza una String de ejemplo para simularlo) y envía línea a línea al esp32, que va conformando un JSON con ellas. Envía líneas hasta enviar "FIN-COMIDA", entonces espera a que el esp32 cierre el JSON, lo envíe al servidor y responda con "SAVED-OK" o "ERROR-HTTP:<error>". Se envía un JSON nuevo con cada comida porque si se tuviera que subir muchas comidas, no cabrían todas en el mismo JSON.
    Si el Due recibe "ERROR-HTTP", esa comida que no se ha podido guardar en la base de datos la añade a una lista de 'unsavedMeals'. Al final de enviar todo el TXT al esp32, si 'unsave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
    [SD_functions.h, arduino-due-send-textFile-upload.ino, cadenas.h, esp32camPlus-textFile-to-JSON-and-send.ino, functions.h, json_functions.h, wifi_functions.h]
2024-05-10 Example "BARCODE button" for new ESP32
    Ejemplo "BARCODE button" para el nuevo ESP32.
    El Arduino Due tiene conectado el botón de barcode y cuando se pulsa le envía "GET-BARCODE" al ESP32, que entonces atiende al Serial del lector de códigos de barras durante 5 segundos esperando la lectura de algún producto.
    No es posible apagar/encender el lector, sino que siempre está encendido y si le pones un código de barras lo leerá, pero si no se ha pulsado antes del botón de Barcode, el ESP32 no hará caso a lo leído. Lo ideal sería que al pulsar el botón de Barcode, entonces se encendiera el lector y comenzara el escaneo, pero no ha sido posible implementar eso sin añadir más component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
2024-05-10 Change endpoint for logout from SmartCloth
    Para el logout con token desde el SmartCloth se utilizaba el endpoint "https://smartclothweb.org/api/logout", pero como "logout" suele usarse para cerrar sesión en las webs, para evitar confusiones se ha cambiado a "https://smartclothweb.org/api/logout_mac".
2024-05-10 Change WiFi credentials example "CameraWebServer"
2024-05-27 Ejemplo lectura barcode y petición OpenFoodFacts
    Ejemplo en el que cuando se pulsa el botón de barcode, el Due le envía GET-BARCODE al esp32. Si el esp32 tiene WiFi, lee el Serial del lector durante 5 segundos. Si se lee código, envía petición GET a OpenFoodFacts para obtener la información nutricional por 100g. Puede ocurrir:
    A) No se encuentre producto
    B) Se encuentre producto, pero no tenga macronutrientes (p. ej. agua). Se toman como 0.0
    C) Se encuentre producto y se obtengan sus marconutrientes (p. ej. batillo chocolate)
2024-05-28 Cambio pin SD en ejemplos
2024-05-28 Programa crea fichero TXT con comidas de ejemplo
    Programa que crea un fichero TXT en la SD con comidas de ejemplo.
    Cuando se hacen pruebas de subida de información, si todo va bien, se borra el TXT. Por eso he creado este programa, para facilitar y agilizar el volver a crear un fichero TXT en la SD con información de ejemplo.
2024-05-28 Try clearing Serial buffer ESP32-barcode reader
    A veces, al leer el Serial se lee el código de barras anterior. Probé a limpiar el buffer, pero podría acabar eliminando el código de barras que se está leyendo ahora. Por eso, se deja en manos del usuario que si se indica en pantalla un producto distinto al escaneado, se vuelva a escanear.
2024-05-28 Modif ejemplo enviar TXT y subirlo comida a comida
    El ejemplo "send_textFile_and_upload" ya subía las comidas con un JSON por comida en lugar de toda la información en el mismo JSON, pero estaba hecho con las cadenas de simulación en el Due.
    Se ha modificado para hacerlo realmente leyendo el TXT. Si se sube todo, se borra el TXT. Si falla la subida de alguna comida, se guarda esa comida para subirla más adelante.
2024-05-28 Problema unsavedMeals en vector y no TXT auxiliar
    El problema de guardar las líneas de comidas no subidas en un vector es que si falla la subida de muchas comidas, el vector 'unsavedMeals' puede llegar a ser muy grande y ocupar mucha memoria RAM del Due o incluso saturarla.
    Otra posible solución sería guardar en un fichero TXT auxiliar las comidas no subidas y, al final, borrar el TXT original y crear uno nuevo donde se copien todas las líneas del auxiliar.
    Con esa solución se elimina el problema de saturar la RAM, pero se añade latencia por la escritura en el auxiliar y, sobre todo, por la copia de todas las líneas al nuevo.
    [SD_functions.h]
2024-06-20 Update diagrama actividades sincronización Due-ESP32
2024-06-20 Modif ejemplo button+barcode
    Se han añadido nuevos mensajes ESP32--> Due para cuandi se utilice el lector de códigos de barras:
    Due indica al ESP32 que lea barcode con "GET-BARCODE" y el ESP32 puede responder con cualquiera de estos:
    A) Código leído --> "BARCODE:<barcode>"
    B) No se ha detectado código en la imagen o el lector no responde --> "NO-BARCODE"
    Si se ha conseguido leer el barcode (el Due lo sabe y queda a la espera de los valores nutricionales), el ESP32 hace una petición a OpenFoodFacts y responde con:
    A) Valores nutricionales del producto por cada 1 gramo --> "PRODUCT:<barcode>;<nombre_producto>;<carb_1g>;<lip_1g>;<prot_1g>;<kcal_1g>"
    B) No se ha encontrado el producto en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
2024-06-20 Funciones comunicación Serial ESP32-Due
2024-06-23 Reorganización wireframes
2024-06-23 Modif pantallas de sincronización
    Se han modificado las siguientes pantallas de sincronización (la hecha al inicio si el TXT tiene algo):
    - UPLOADING_DATA: pantalla "Sincronizando..." con fondo azul dentro de un recuadro azul oscuro indicando al usuario que espere a que termine de subirse toda la info
    - ALLS_MEALS_UPLOADED: pantalla "¡SmartCloth sincronizado!" con fondo verde entre dos líneas blancas indicando al usuario que se ha subido toda la info.
    - MEALS_LEFT: pantalla "Sincronización parcial" con fondo amarillo entre dos líneas rojas indicando al usuario que se han subido algunas comidas pero otras no se ha podido y se intentará más adelante
2024-06-23 Modif RTC_set_time para guardar flag en la flash
    Se ha añadido una flag 'SUMMER_TIME_FLAG_ADDRESS' que se guarda en la flag no volátil del Due para saber si ya se ha cambiado al horario de verano.
    Antes se comprobaba si estábamos en horario de verano (después del último domingo de marzo) y se cambiaba la hora, pero para no hacerlo todos los días, se ha establecido una flag no volátil que indique si ya se ha hecho el cambio. Igual para saber si se ha cambiado a invierno.
2024-06-23 Modif función que comprueba si es verano/invierno
    Antes se comprobaba si hoy era el último domingo de marzo/octubre para cambiar a horario de verano/invierno, pero obviamente si no se enciende el SmartCloth esos días específicos, no se cumplirán las condiciones y no se cambiará la hora. Así que se han modificado las funciones isSummerTime() e isWinterTime() para que comprueben si se está entre en el último domingo de marzo y el último de octubre (verano) o entre el último domingo de octubre y el último de marzo (invierno).
2024-06-23 Programa para obtener la MAC del ESP32
    Se ha creado un pequeño programa para obtener la MAC del ESP32, necesaria para identificar cada SmartCloth en la base de datos.
2024-06-23 Modif programa "BARCODE button and send"
    Se ha añadido una comprobación de "PING-PONG" entre el Due y el ESP32 para, antes de nada, comprobar que se ha establecido correctamente la comunicación entre el Due y el ESP32, es decir, que el ESP32 está bien conectado, encendido y listo para trabajar. El Due envía "PING" al ESP32 y éste le contesta con "PONG".
    Además, se ha modularizado la parte de pedir el barcode: el Due primero pide leer el barcode y si se consigue leer (el ESP32 lo envía al Due), entonces espera a que el ESP32 busque la información del producto y se la envíe. Si el ESP32 no estaba bien conectado (no respondió "PONG" al inicio), ni siquiera le pide leer el barcode al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
    [ISR.h, Serial_functions.h, arduino-due-barcode-button-send.ino, debug.h, esp32camPlus-barcode-button-send.ino, esp32camPlus-barcode-button.ino, wifi_functions.h]
2024-06-23 ACK del ESP32 y un JSON por comida
    ACTUALIZACIÓN IMPORTANTE:
    1) El sistema envías las comidas al servidor usando un JSON para cada comida. Si alguna no se puede subir, el Due la guarda en el TXT.
    Se ha seguido una estrategia que podría ser problemática: si una comida no se ha podido guardar (el Due no ha recibido SAVED-OK para esa comida), entonces se añade a un vector de string que contiene las cadenas de las comidas que no se han podido subir. Al final, si ese vector tiene algo, se añade al TXT. El problema es que si hay muchas que no se pueden subir, ese vector podría crecer demasiado y sobrepasar la memoria RAM. Una solución sería, en lugar de utilizar un vector, ir escribiend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
    [Buttons.h, COLORS.h, Files.h, Grupos.h, ISR.h, RTC.h, SD_functions.h, Scale.h]
2024-06-24 Inicio de integración de STATE_ Barcode
    Se ha integrado el botón de barcode y el lector:
    - Evento "BARCODE" al pulsar botón (interrupción)
    - Estado STATE_Barcode al que ir desde STATE_Plato, igual que STATE_Grupo
    - En el estado, si se viene de STATE_Plato se guarda el peso del plato y se tara. Si se viene de pesar algo, se guarda en la comida
    - Se pide barcode y si se obtiene, se busca su info.
    - Si se encuentra el producto, se actualiza 'grupoEscogido' (ID es 50, de barcode con campos vacíos) con la información del producto
    1) Comprobar STATE_Barcode. Parece que todo OK
    2) Añadir pantallas para "Escaneando...", "Barcode no detectado", "Info del producto" y "Producto no encontr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
2024-06-26 Pantallas de barcode
    Nuevas pantallas para el barcode:
    - "Escaneando... Coloque producto sobre lector"
    - Mostrar info del producto leído
    - "Producto no detectado" por el lector
    - "Producto no encontrado" en OpenFoodFacts
    - "No se va a leer barcode porque no hay conexión wifi"
    1. "Guardando/sincronizando comida". Podría usar la misma de "Sincronizando..."
    2. "Buscando producto con barcode X"
    3. "Info producto" con "Pon producto en báscula"
    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
2024-06-26 Modif tiempos conexion wifi y lectura barcode
    Se ha ampliado el tiempo de espera para conectarse a internet a los 15 segundos. También se ha ampliado el tiempo de espera para leer el barcode hasta los 30 segundos.
2024-06-28 Nuevo STATE_Barcode
    Se ha integrado un nuevo STATE_Barcode con sus transiciones. Se entra cuando se pulsa el botón de leer barcode y se hace lo siguiente:
    - Acciones previas iguales a STATE_Grupo: si se acaba de colocar recipiente, guardar peso recipiente. Si hay peso de alimento puesto anteriormente, se guarda.
    - Comprueba si hay conexión a internet (le pregunta al ESP32): si no hay, muestra pantalla de que no tiene conexión y no se puede leer código. Si hay internet, inicia el escaneo de barcode (envía GET-BARCODE al ESP32) y, si lo detecta, el ESP32 busca la info en OpenFoodFacts.
    - Se cancela lectura pulsando cualquier botón (grupos, cr/co, add/delete/save)
    TODO: si se pulsa cr/c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
2024-06-28 Modificación pantallas barcode en SM v2.1
    Modificación de las pantallas de barcode para tener el mismo estilo de aviso para "Producto no detectado", "Producto no encontrado" y "SIn internet. No se puede leer barcode"
2024-07-03 Subida de comidas incluyendo alimento barcode
    El Arduino debe enviar la cadena del alimento así: "ALIMENTO,50,<peso>,<ean>"
    Por ejemplo: ALIMENTO,50,120.5,8424621001093
    Luego el ESP32 conforma el JSON para el caso de alimento así:
    {
    "grupo": 7,
    "peso": 23.5
    },
    {
    "grupo": 50,
    "peso": 120.5,
    "ean": "8424621001093"
    }
    Y por último, cuando el servidor recibe el JSON mira el grupo y si es 50 (barcode), comprueba si ese EAN se ha leído antes. Si se ha leído antes, simplemente se añade un alimento de ese tipo. Si no se ha leído antes, hace una consulta a OpenFoodFacts para obtener los macronutrientes del producto y gu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
2024-07-12 Programa testeo screw shield
    Se ha hecho un programa para testear rápidamente las conexiones entre el Arduino Due y el screw shield, para saber si hace buen contacto antes de programar el dispositivo con el programa SmartCloth.
    Se tiene un programa para el Arduino que en el setup inicializa todos los componentes (RTC, SD, pantalla, pines e interrupción de báscula, pines e interrupciones de botoneras y comunicación con ESP32) y comprueba los componentes que se pueden revisar automáticamente: comunicación con ESP32, lectura de fecha del RTC, escritura y lectura en SD, lectura de imagen de SD y mostrarla en la pantalla.
    Después, en el loop se comprueban los componentes que necesitan inte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
2024-08-21 Reorganización documentos, ejemplos e imágenes binarias
    [grupos_alimentos.csv, grupos_alimentos.xlsx, partitions.csv]
2024-08-21 Test para comprobar shield
    Programas de ejemplo para el Arduino y el ESP32 para comprobar que el screw shield hace buen contacto con el arduino y las comunicaciones se establecen correctamente con la pantalla, las botoneras, la báscula, el RTC y el ESP32.
    [Buttons.h, COLORS.h, ISR.h, RTC.h, SD_functions.h, Scale.h, Screen.h, Serial_functions.h]
2024-08-21 Comentarios en esp32cam-v1
2024-08-26 Automatizada conversion caracteres especiales
    Los caracteres especiales (á, Á, ñ, Ñ, !, ?, /, ... y demás) se deben convertir a HEX según ISO 8859-1 (Latin-1) para que se vean correctamente en la pantalla. Se ha automatizado la conversión con un par de funciones para poder escribir el texto normal en el código y que la función lo convierta. Así también se convierte el texto del nombre del producto cuyo barcode se ha buscado en OpenFoodFacts.
    [Buttons.h, Files.h, Grupos.h, ISR.h, RA8876_v2.cpp, RA8876_v2.h, RTC.h, SD_functions.h]
2024-08-26 Escritura en carpetas en SD
    Para crear o escribir en un fichero dentro de una carpeta de la SD, la carpeta debe existir previamente. Aunque esté vacía y se cree nuevo el fichero, pero debe existir o fallará, lo que provocará un supuesto "Fallo en memoria" que bloqueará SmartCloth.
2024-08-29 Extraer y validar código de barras
    PROBLEMA:
    A veces, al leer el Serial se lee el código de barras anterior, si se ha quedado en el buffer, o varios códigos concatenados, si el usuario ha pasado varias veces el producto por el lector. Limpiar el buffer podría acabar eliminando el código de barras que se está leyendo ahora, aunque eso sería mejor que enviar datos extraños en la petición a OpenFoodFacts. Aun así, para evitar borrar valores válidos y puesto que suele ocurrir que se lea el mismo producto varias veces seguidas antes de procesarlo porque el usuario lo acerque mucho rato, entonces lo mejor es seguir otra estrategia que no incluya borrar.
    SOLUCION:
    OpenFoodFacts admite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
    [Serial_functions.h, camera-barcode.ino, wifi_functions.h]
2024-08-31 Añadir barcode a JSON
    Se ha integrado el alimento tipo barcode en la lista de alimentos de la comida que se va a enviar. Se ha tenido que modificar en STATE_added y STATE_saved que el alimento añadido a la lista sea de grupoActual en lugar de grupoAnterior, ya que no se ha actualizado grupoActual como sí ocurre en STATE_group, donde se debe guardar con grupoAnterior el alimento pesado antes de escoger otro grupo, ya que al escogerlo se habrá actualizado grupoActual.
    Además, en STATE_group y STATE_Barcode se actualiza pesoRecipiente si pesoBascula no está a 0. En STATE_group no haría falta hacer esa comprobación, pero en STATE_Barcode a veces no se lee bien el buffer y si luego volve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
2024-09-10 Nuevas pantallas con nuevos iconos
    Se han actualizado las pantallas de guardar comida, sincronizar SM y barcode con los nuevos iconos.
    1) Guardar comida: "Guardando comida..."
    - Con WiFi
    - Sin Wifi --> "Se guardará en SMARTCLOTH peo no en la web"
    2) Sincronizar SM:
    - "Sincronizando..."
    - "¡SmartCloth sincronizado!"
    - "¡Sincronización parcial!"
    3) Barcode:
    - "Coloque el código de barras cerca del lector"
    - "Buscando..."
    - "¡Producto encontrado!"
    - "¡No se ha detectado producto!" (aviso)
    - "¡Sin conexión a Internet!" (aviso)
    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
2024-09-15 Pantalla info producto
    Mostrar información del producto (código y nombre) obteniendolo de la cadena de 'productInfo' para que el usuario confirme que es el producto deseado.
2024-09-22 División del STATE_Barcode en estados menores
    Se ha dividido la funcionalidad del STATE_Barcode en otros estados más pequeños:
    - STATE_Barcode_read: indicar al ESP32 que se va a leer código de barras ("GET-BARCODE") y esperar respuesta. Si se leercódigo, pasar a STATE_Barcode_search. Si no, al STATE_AVISO indicando "Código no detectado" y luego al estado desde donde se inició la lectura de barcode.
    - STATE_Barcode_search: indicar al ESP32 que busque el producto ("GET-PRODUCT:<barcode>") y esperar su información. Si encuentra el producto, pasar a STATE_Barcode_check. Si no, al STATE_AVISO indicando "Producto no encontrado" y luego al estado desde donde se inició la lectura de barco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
2024-09-22 Cambio mensajes Due <--> ESP32
    Se han modificado los mensajes enviados entre el Arduino Due y el ESP32:
    Hasta ahora el Due pedía leer barcode con "GET-BARCODE" y luego tenía que recibir "BARCOD:<barcode>" y la info del producto con "PRODUCT:<barcode>;<nombre_producto>;<carb_1g>;<lip_1g>;<prot_1g>;<kcal_1g>", ambos mensajes seguidos.
    Esto provocaba que a veces no los recibiera en el orden adecuado, haciendo que se comportara de forma extraña pensando que no había recibido la información.
    Para resolverlo, el Due ya no espera dos mensajes seguidos, sino que pide leer barcode con "GET-BARCODE" y espera "BARCODE:<barcode>". Después, indica al ESP32 que busque la información del producto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
    [Serial_functions.h, barcode.h, esp32cam-v1.ino, wifi_functions.h]
2024-09-22 Cambiar procesamiento sin cambiar grupo
    Se ha incluido la opción de cambiar el procesamiento sin cambiar el grupo tras pesar un alimento. Por ejemplo, si se ha pesado (STATE_weighted) un alimento del grupo de verduras y siendo crudo, y ahora se quiere colocar una alimento del mismo grupo pero cocinado, se puede directamente escoger cocinado sin volver a seleccionar el mismo grupo.
    Como al escoger crudo/cocinado se actualiza 'grupoActual' y 'grupoAnterior' al entrar a STATE_raw/STATE_cooked desde STATE_Weighted, si había algo pesándose en la báscula, se debe guardar en la lista en el plato con el grupo que se escogió antes de pesarlo, osea 'grupoAnterior', ya que 'grupoActual' se ha actu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
2024-09-30 Timeout del servidor SmartCloth
    Se ha añadido un timeout de 10 segundos como tiempo máximo de espera del servidor SmartCloth al subir la información de la comida.
2024-09-30 Pantalla confirmar producto
    Insertada la pantalla de confirmar producto en el programa principal
2024-09-30 Cancelar lectura barcode
    Enviar "CANCEL-BARCODE" del Due al ESP32 al detectar interrupción para que deje de esperar mensaje del lector.
    NO TESTEADO.
2024-09-30 Actualización máquina de estados
    1. Se han creado estados diferenciados para avisos según el caso: plato no añadido porque está vacío, plato no eliminado porque está vacío, comida no guardada porque está vacía, no hay wifi para buscar barcode, barcode no detectado y producto no encontrado.
    2. Se ha añadido la opción de cambiar el procesamiento (crudo o cocinado) de un grupo tras pesar alimento (desde STATE_weighted) y sin tener que volver a seleccionar el grupo si el siguiente alimento es del mismo grupo pero con diferente procesamiento.
    3. En lugar de comprobar si hay WiFi en STATE_save_check (podía provocar bloqueo si el ESP32 no respondía), en ese estado solo se pide confi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
2024-09-30 Modificar STATE_saved
    Se ha modificado STATE_saved para que primero actualice el plato y la comida, que es muy rápido, y luego muestre las pantallas correspondientes. Se ha hecho así para que no se muestre la pantalla de "Guardando..." si resulta no se va a poder guardar porque está vacía.
2024-10-03 Eliminada la limpieza del buffer del Serial
    Estaba teniendo muchos problemas con mensajes que se perdían (por ejemplo que el ESP32 enviara "SAVED-OK" pero el Due recibiera ""), así que probé varias cosas:
    1. Modifiqué la forma de hacer la espera activa de mensaje (waitMsgFromESP32()) para hacerlo igual en ambos dispositivos, ya que parecía que solo se perdían los mensajes del ESP32 al Due, pero no al revés. No lo resolvió.
    2. Modifiqué la forma de enviar mensajes del ESP32 al Due para no usar la flash (sendMsgToDue("SAVED-OK") en lugar de sendMsgToDue(F("SAVED-OK"))), igual que se hacía en sendMsgToESP32() en el Due, ya que esos mensajes del Due al ESP32 no se perdían. No lo res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
    [ISR.h, RTC.h, SD_functions.h, Scale.h, Screen.h, Serial_functions.h, State_Machine.h, barcode.h]
2024-10-03 Estrategias tolerancia a fallos en envío de mensajes
    ChatGPT me ha dado algunas estrategias para aumentar la tolerancia a fallos en el envío y recepción de mensajes entre el Due y el ESP32:
    1. Protocolo de comunicación con encabezado y longitud:
    Una técnica común es enviar un encabezado o marca de inicio junto con la longitud del mensaje. Esto te permite saber cuántos bytes debes esperar antes de leer el mensaje completo.
    Ejemplo de protocolo simple:
    • El ESP32 envía algo como: LEN:<longitud><mensaje>\n.
    ¡• El Due primero lee la longitud (<longitud>) del mensaje, y entonces sabe cuántos bytes debe esperar para que el mensaje esté completo.
    Este enfoque permite a tu program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
2024-10-04 Modificación funciones de espera de mensajes
    Se han modificado waitResponseFromESP32() y waitResponseFromESP32WithEvents() para que en lugar de simplemente comprobar si hay algo en el buffer, generen un buffer auxiliar en el que vayan añadiendo caracter a caracter hasta encontrar un "\n" (si el mensaje solo contiene "\n" no se considera como recibido).
    Esto se ha hecho porque a veces parecía recibirse mensajes vacíos "" aunque el ESP32 hubiera enviado correctamente "BARCODE:<barcode>" o cualquier otro. Entonces, con la implementación anterior simplemente se miraba si SerialESP32.available() > 0, osea si había al menos 1 byte en el buffer, cosa que ocurría aunque solamente se hubiera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
    [ISR.h, SD_functions.h, Screen.h, Serial_functions.h, State_Machine.h]
2024-10-04 Encapsulado el procesamiento de mensaje
    Se ha creado una función auxiliar processCharacter() para el procesamiento caracter a caracter de los mensajes leídos en el buffer del serial con el Due o con el lector.
    Aunque las lecturas de esos mensajes no han generado problemas, he considerado seguir la misma estrategia que en la lectura de mensajes en el Due. Y para minimizar y simplificar el código, he creado la función auxiliar. Esperemos que no rompa lo que ya funcionaba.
    [Serial_functions.h, esp32cam-v1.ino, json_functions.h, wifi_functions.h]
2024-10-07 Guardar comidas no subidas en TXT auxiliar
    Probado el ejemplo para guardar en un TXT auxiliar las comidas que no se han podido subir a la base de datos.
    Antes se guardaban en un vector de comidas, pero si por un casual fallaran todas o si hubiera pasado mucho tiempo desde la última subida, ese vector podría ir creciendo demasiado y desbordar la memoria del Due. Por eso, se ha decidido usar un TXT auxiliar en el que se irán escribiendo y al final, si hay comidas "no subidas", actualizar el TXT original de comidas con la información guardada en el auxiliar.
2024-10-07 Resuelto fallo mensajes perdidos
    Con la comprobación inicial de SerialESP32.available() > 0, que provocaba la lectura del buffer, a veces se leía mensajes vacíos "" porque no daba tiempo a recibirlo todo. Vease el readme.txt del fallo.
    Para resolverlo se ha modificado la función de espera y lectura de mensajes del ESP32 de forma que procese el mensaje caracter a caracter hasta un "\n". Solo entonces lo considera terminado.
    Si lo primero que lee es el "\n", no lo considera mensaje.
    Si pasa el timeout antes de terminar de conformar el mensaje, se marca timeout. Lo ideal es poner un timeout de 2 o 5 segundos mayor que el timeout que tiene el ESP32 para hacer la acción (leer barcode, busc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
2024-10-09 Pruebas de pantallas
    - Producto cancelado
    - Opciones HTTP_ERROR, TIMEOUT y UNKNOWN_ERROR de la sincronización de SM
    - Guardando comida
    - Dashboard barcode (sin crudo/cocinado)
2024-10-09 Encapsulación de procesamiento mensajes Due-ESP32
    El procesamiento caracter a caracter de los mensajes recibidos en el Due se ha encapsulado en una función para mejorar la claridad, legibilidad y depuración del código.
2024-10-09 Integrado el guardar comidas no subidas en TXT aux
    Al actualizar el SM con la web enviando al ESP32 el TXT con comidas no subidas, las que no se puedan guardar se escriben temporalmente en un TXT auxiliar, en lugar de en un vector de String para no saturar la memoria RAM, y luego se actualizará el TXT original solo con las comidas que no se han podido guardar en la base de datos.
2024-10-09 Eliminadas versiones previas de funciones
    Se han eliminado versiones previas de funciones tras probar las nuevas:
    - Se han eliminado las funciones de limpieza de buffer
    - waitMsgFromDue
    - waitMsgFromESP32
    - waitMsgFromESP32WithEvents
    Eliminadas funciones comentadas e innecesarias.
2025-01-14 Ejemplo de guardar productos recurrentes en SD
    Como se subdividió el STATE_Barcode en STATE_Barcode_read, STATE_Barcode_search, STATE_Barcode_check y STATE_Barcode; ahora es mucho más sencillo comprobar si el producto detectado ya se leyó antes y se guardó su info en la SD.
    Este ejemplo sigue estos pasos:
    1) Due pide al ESP32 leer barcode: GET-BARCODE
    2) ESP32 da 30 segundos para colocar producto y responde: BARCODE:<barcode>
    3) Due comprueba si el <barcode> se encuentra en el fichero barcodes.csv
    3.A) Se encuentra el producto en el csv, es PRODUCTO RECURRENTE
    3.B) No se encuentra el producto, es PRODUCTO NUEVO
    4) Due pregunta al ESP32 si tiene conexión a internet para buscar el pr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
2025-01-22 Guardar productos recurrentes en SD + fix Serial
    Se ha añadido la funcionalidad de guardar productos recurrentes en la SD para evitar las consultas repetitivas a OpenFoodFacts.
    Si se confirma un producto, se guarda su EAN, nombre e información nutricional en un CSV en la SD. La próxima vez que se lea ese EAN, aparecerá en la SD y no hará falta la conexión a Internet y la espera de buscarlo en OpenFoodFacts.
    También he modificado las comprobaciones de los mensajes recibidos en ambos dispositivos porque a veces se perdían o se quedaban a medias. Ahora leo hasta un '\n' y luego compruebo si lo leido es un mensaje válido, alguno de los esperados del Due o del ESP32, según el caso. Si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
    [Buttons.h, Comida.h, Files.h, ISR.h, SD_functions.h, Screen.h, Serial_functions.h, State_Machine.h]
2025-01-23 Limpiar buffer Rx antes de envío
    Limpiar el buffer de recepción antes de enviar un mensaje que conllevará esperar otro, así limpiamos el buffer antes de que llegue esa respuesta y para evitar basura.
2025-04-22 Pantallas comprobar intención de retirado
    Si se retira el plato sin avisar, sin decir si se quería añadir otro plato, borrar el actual o guardar la comida, aparece una pantalla para preguntar la intención. Si no se indica la intención tras x segundos, aparece otra pantalla para avisar de que se ha borrado el plato no se ha se ha indicado qué hacer con él.
    En el ejemplo de wireframes solo están las pantallas, no la lógica del sistema principal.
2025-04-22 Programa ejemplo obtener MAC
    En realidad este ejemplo es innecesario, porque al cargar el programa del esp32 ya te muestra su MAC.
2025-04-22 Calibración báscula
    Programa para calibrar una báscula (celda de carga HX711):
    A partir del peso conocido de un objeto colocado sobre la báscula, se realizan múltiples lecturas y se calcula la nueva escala mediante la fórmula:
    nueva_escala = (escala_actual * media_lecturas) / peso_conocido
2025-04-23 Gestión de retirada de plato sin aviso
    Mejora del flujo de retirada de plato sin aviso previo:
    Se implementa un nuevo mecanismo para manejar la retirada de plato sin indicación previa, mejorando la experiencia de usuario y evitando pérdida de datos. Cambios incluidos:
    - Nuevo estado STATE_REMOVAL_CHECK que consulta al usuario sobre su intención al retirar el plato (añadir otro, eliminar o guardar comida)
    - Temporizador de 30 segundos para automatizar la eliminación del plato en caso de no obtener respuesta
    - Mejora en la coherencia de la interfaz evitando mensajes redundantes de "Recipiente retirado"
    - Implementación de flag plateWasRemovedBeforeAction para mantener el contexto a tr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
2025-04-24 Update pantalla recipiente retirado sin avisar
    Si se retira el plato sin avisar, se pide indicar la intención (añadir otro, eliminarlo o guardar). Pero si el plato estaba vacío, no se pide nada.
    Quité la pantalla "Recipiente retirado" para estos casos porque ya se indicaba con la pantalla de pedir intención, pero al haberla quitado, tampoco aparece para cuando se retira el plato pero estaba vacío, así que lo he añadido manualmente en STATE_REMOVAL_CHECK.
2025-06-16 Fix mini error peso + tiempo estabilización inicial
    [Buttons.h, ISR.h, Scale.h, State_Machine.h, calibrate_scale.ino, smartcloth_v2.ino, test_due.ino]
2025-06-18 Librerías necesarias
    - DS3231 para el RTC
    - HX711 para la celda de carga
    La librería del RA8876 se complementó con nueva funciones y va integrada en el código fuente smartcloth-v2/
    Para importarlas en Arduino IDE hay que comprimirlas e importarlas como ZIP.
